ska-sa/roach1_hardware/roach/zdok-connections.txt

("P5"
	( 1    "$1I4\$1I170"
		(B1    "GND")
		(B10    "GND")
		(B11    "GND")
		(B12    "GND")
		(B13    "GND")
		(B14    "GND")
		(B15    "GND")
		(B16    "GND")
		(B17    "GND")
		(B18    "GND")
		(B19    "GND")
		(B2    "GND")
		(B20    "GND")
		(B3    "GND")
		(B4    "GND")
		(B5    "GND")
		(B6    "GND")
		(B7    "GND")
		(B8    "GND")
		(B9    "GND")
		(E1    "GND")
		(E10    "GND")
		(E11    "GND")
		(E12    "GND")
		(E13    "GND")
		(E14    "GND")
		(E15    "GND")
		(E16    "GND")
		(E17    "GND")
		(E18    "GND")
		(E19    "GND")
		(E2    "GND")
		(E20    "GND")
		(E3    "GND")
		(E4    "GND")
		(E5    "GND")
		(E6    "GND")
		(E7    "GND")
		(E8    "GND")
		(E9    "GND")
		(W1    "GND")
		(W2    "5V")
		(W3    "3V3")
		(W4    "2V5")
		(W5    "1V8")
		(W6    "GND")
		(X1    "GND")
		(X2    "5V")
		(X3    "3V3")
		(X4    "2V5")
		(X5    "1V8")
		(X6    "GND")
		(Y1    "GND")
		(Y2    "5V")
		(Y3    "3V3")
		(Y4    "2V5")
		(Y5    "1V8")
		(Y6    "GND")
		(Z1    "GND")
		(Z2    "5V")
		(Z3    "3V3")
		(Z4    "2V5")
		(Z5    "1V8")
		(Z6    "GND")
	)
	( 2    "$1I4\$1I801"
		(A1    "$1I4\ZDOK0_DP_P0")
		(A10    "$1I4\ZDOK0_DP_N4")
		(A11    "$1I4\ZDOK0_DP_P5")
		(A12    "$1I4\ZDOK0_DP_N5")
		(A13    "$1I4\ZDOK0_DP_P6")
		(A14    "$1I4\ZDOK0_DP_N6")
		(A15    "$1I4\ZDOK0_DP_P7")
		(A16    "$1I4\ZDOK0_DP_N7")
		(A17    "$1I4\ZDOK0_DP_P8")
		(A18    "$1I4\ZDOK0_DP_N8")
		(A19    "$1I4\ZDOK0_DP_P9")
		(A2    "$1I4\ZDOK0_DP_N0")
		(A20    "$1I4\ZDOK0_DP_N9")
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
		(F2    "$1I5\ZDOK1_DP_N29")
		(F20    "$1I5\ZDOK1_CLK1_N")
		(F3    "$1I5\ZDOK1_DP_P30")
		(F4    "$1I5\ZDOK1_DP_N30")
		(F5    "$1I5\ZDOK1_DP_P31")
		(F6    "$1I5\ZDOK1_DP_N31")
		(F7    "$1I5\ZDOK1_DP_P32")
		(F8    "$1I5\ZDOK1_DP_N32")
		(F9    "$1I5\ZDOK1_DP_P33")
	)
)
