ska-sa/roach1_hardware/roach/layout/ROACH103_ManFile.rtf

Roach Manufacturing File for roach103.pcb on 19/10/2009 15:47:30

Name P/D_NUM Position X Position Y Layer Name Orientation Geometry.Height Value
C1 TPSD227K010R0050 11.845 3.636 Top 270 3.1MM 220UF
C2 1210YD226KAT2A 11.840 3.204 Top 90 2.79MM 22UF
C3 C0402X7R160-104KN 1.967 4.861 Top 0 0.55MM 0.1UF
C4 C0402X7R160-104KN 12.074 9.835 Bottom 0 0.55MM 0.1UF
C5 GRM155R71A104KAO1B 9.682 1.538 Top 90 0.55MM 100NF
C6 GRM155R71E103KAO1B 9.547 1.691 Top 270 0.55MM 10NF
C7 GRM21BR60J106KE19L 5.447 4.184 Top 90 1.35MM 10UF
C8 GRM21BR60J106KE19L 6.333 7.254 Top 90 1.35MM 10UF
C9 GRM21BR60J106KE19L 4.975 4.184 Top 90 1.35MM 10UF
C10 ECJ-0EB0J224K 5.900 5.561 Bottom 0 0.55MM 220NF
C11 ECJ-0EB0J224K 5.821 5.798 Bottom 0 0.55MM 220NF
C12 ECJ-0EB0J224K 5.742 5.719 Bottom 0 0.55MM 220NF
C13 GRM155R71A104KAO1B 8.752 3.832 Bottom 90 0.55MM 100NF
C14 GRM155R71E103KAO1B 9.880 1.801 Top 270 0.55MM 10NF
C15 GRM155R71A104KAO1B 10.152 1.538 Top 90 0.55MM 100NF
C16 GRM155R71E103KAO1B 10.006 1.690 Top 270 0.55MM 10NF
C17 GRM155R71E103KAO1B 10.352 1.804 Top 270 0.55MM 10NF
C18 ECJ-0EB0J224K 9.550 1.817 Top 270 0.55MM 220NF
C19 ECJ-0EB0J224K 10.006 1.801 Top 270 0.55MM 220NF
C20 GRM155R71A104KAO1B 10.352 1.538 Top 270 0.55MM 100NF
C21 GRM1555C1H220JZ01B 12.022 5.876 Top 0 0.55MM 22PF
C22 GRM1555C1H220JZ01B 2.211 5.121 Top 0 0.55MM 22PF
C23 GRM21BR60J106KE19L 3.754 5.424 Top 0 1.35MM 10UF
C24 GRM21BR60J106KE19L 3.754 4.656 Top 0 1.35MM 10UF
C25 GRM21BR60J106KE19L 4.876 7.254 Top 90 1.35MM 10UF
C26 GRM21BR60J106KE19L 7.199 7.254 Top 90 1.35MM 10UF
C27 GRM21BR60J106KE19L 6.097 7.254 Top 90 1.35MM 10UF
C28 GRM21BR60J106KE19L 3.754 4.144 Top 0 1.35MM 10UF
C29 GRM21BR60J106KE19L 6.549 4.184 Top 90 1.35MM 10UF
C30 GRM21BR60J106KE19L 5.683 4.184 Top 270 1.35MM 10UF
C31 GRM21BR60J106KE19L 5.920 4.184 Top 270 1.35MM 10UF
C32 GRM155R71A104KAO1B 9.882 1.538 Top 270 0.55MM 100NF
C33 GRM155R60J103KA01J 1.601 9.050 Top 270 0.55MM 10NF
C34 ECJ-0EB0J224K 4.522 9.050 Top 0 0.55MM 220NF
C35 ECJ-0EB0J224K 3.754 9.323 Top 90 0.55MM 220NF
C36 ECJ-0EB0J224K 3.435 9.468 Top 0 0.55MM 220NF
C37 ECJ-0EB0J224K 4.185 9.204 Top 270 0.55MM 220NF
C38 ECJ-0EB0J224K 4.188 9.322 Top 90 0.55MM 220NF
C39 ECJ-0EB0J224K 1.971 9.485 Top 0 0.55MM 220NF
C40 ECJ-0EB0J224K 2.347 9.108 Top 270 0.55MM 220NF
C41 ECJ-0EB0J224K 2.758 9.206 Top 270 0.55MM 220NF
C42 ECJ-0EB0J224K 2.383 9.381 Top 0 0.55MM 220NF
C43 ECJ-0EB0J224K 2.742 9.302 Top 0 0.55MM 220NF
C44 ECJ-0EB0J224K 2.348 9.201 Top 270 0.55MM 220NF
C45 ECJ-0EB0J224K 3.764 9.179 Top 270 0.55MM 220NF
C46 GRM155R71E103KAO1B 6.727 5.266 Bottom 180 0.55MM 10NF
C47 08053C225KAT2A 9.993 2.308 Top 0 1.4MM 2.2UF
C48 04023A180KAT2A 9.898 3.402 Top 270 0.55MM 18PF
C49 04023A180KAT2A 10.264 3.406 Top 270 0.55MM 18PF
C50 GRM155R71E103KAO1B 6.864 5.640 Bottom 180 0.55MM 10NF
C51 04023A180KAT2A 10.327 2.941 Top 270 0.55MM 18PF
C52 04023A180KAT2A 10.677 2.955 Top 270 0.55MM 18PF
C53 C0402X7R160-104KN 8.810 7.040 Bottom 180 0.55MM 0.1UF
C54 C0402X7R160-104KN 9.220 7.005 Bottom 270 0.55MM 0.1UF
C55 GRM155R71E103KAO1B 7.356 4.833 Bottom 0 0.55MM 10NF
C56 GRM155R71E103KAO1B 7.908 4.833 Bottom 180 0.55MM 10NF
C57 GRM155R71A104KAO1B 8.282 4.518 Top 270 0.55MM 100NF
C58 GRM21BR61E475KA12K 8.479 4.558 Top 90 1.35MM 4U7F
C59 GRM32DR61C106KA01K 8.006 4.065 Top 270 2.2MM 10UF
C60 GRM32DR61C106KA01K 8.321 5.128 Top 0 2.2MM 10UF
C61 GRM155R60J103KA01J 1.341 9.369 Top 0 0.55MM 10NF
C62 GRM155R71A104KAO1B 8.400 8.416 Top 90 0.55MM 100NF
C63 GRM155R71E103KAO1B 10.372 5.048 Top 180 0.55MM 10NF
C64 ECJ-0EB0J224K 4.463 6.310 Top 0 0.55MM 220NF
C65 ECJ-0EB0J224K 4.463 6.664 Top 0 0.55MM 220NF
C66 GRM155R60J103KA01J 4.463 6.266 Top 0 0.55MM 10NF
C67 GRM155R60J103KA01J 4.463 6.703 Top 0 0.55MM 10NF
C68 GRM155R71A104KAO1B 3.555 7.803 Top 0 0.55MM 100NF
C69 GRM155R71A104KAO1B 3.142 7.819 Top 0 0.55MM 100NF
C70 GRM155R60J104KA01J 4.738 6.624 Top 0 0.55MM 100NF
C71 GRM155R60J104KA01J 4.738 6.585 Top 0 0.55MM 100NF
C74 GRM155R60J104KA01J 4.738 6.467 Top 0 0.55MM 100NF
C75 GRM155R60J104KA01J 4.738 6.428 Top 0 0.55MM 100NF
C76 GRM155R60J103KA01J 4.463 7.254 Top 0 0.55MM 10NF
C77 GRM155R60J103KA01J 4.463 6.821 Top 0 0.55MM 10NF
C78 ECJ-0EB0J224K 4.463 7.215 Top 0 0.55MM 220NF
C79 ECJ-0EB0J224K 4.463 6.861 Top 0 0.55MM 220NF
C82 GRM155R60J104KA01J 4.738 7.018 Top 0 0.55MM 100NF
C83 GRM155R60J104KA01J 4.738 7.058 Top 0 0.55MM 100NF
C84 GRM32DR61C106KA01K 8.321 4.991 Top 0 2.2MM 10UF
C85 ECJ-0EB0J224K 6.864 5.010 Bottom 180 0.55MM 220NF
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
RP36 4D02WGJ0510T 7.612 6.250 Bottom 270 0.55MM 51R
RP37 4D02WGJ0510T 7.735 6.250 Bottom 270 0.55MM 51R
RP38 4D02WGJ0510T 7.376 6.250 Bottom 270 0.55MM 51R
RS1 4D02WGJ0330T 10.231 3.691 Top 90 0.4MM 33
RS2 4D02WGJ0330T 10.168 3.798 Top 90 0.4MM 33
RS3 4D02WGJ0330T 10.120 3.794 Top 90 0.4MM 33
RS7 4D02WGJ0330T 10.569 3.384 Top 90 0.4MM 33
RS9 4D02WGJ0330T 10.628 3.380 Top 90 0.4MM 33
RS10 4D02WGJ0330T 10.248 3.099 Top 90 0.4MM 33
SNP1 N/A 6.059 1.729 Top 0 0.00000"
SP2 PGB102ST23WR 10.098 9.874 Top 270 0.76MM PGB102ST
SW1 7914G 9.926 1.985 Top 90 4.19MM SPST
SW2 A6S-4101-H 9.203 2.735 Top 180 3.1MM 4POLE
SW3 A6S-4101-H 8.746 2.735 Top 180 3.1MM 4POLE
TP1 N/A 8.620 5.837 Top 0 0.00000" TEST POI
TP2 N/A 10.514 3.400 Top 0 0.00000"
TP3 N/A 8.522 4.191 Top 0 0.00000"
TP4 N/A 11.047 5.015 Top 0 0.00000"
TP5 N/A 11.064 4.350 Top 0 0.00000"
TP6 N/A 10.687 3.376 Top 0 0.00000"
TP7 N/A 10.238 3.817 Top 0 0.00000"
TP8 N/A 10.294 3.711 Top 0 0.00000"
TP9 N/A 8.805 4.353 Top 0 0.00000"
U1 PPC440EPX-NTA533T 9.561 5.739 Top 90 2.65MM 440EPX
U2 SN74AHC1G125DCKT 8.349 3.965 Top 270 1.1MM
U3 TL7700CPSR 1.353 9.168 Top 180 0.00200"
U4 ADCMP605BCPZ 9.702 1.708 Top 0 1.0MM
U5 ADCMP605BCPZ 10.172 1.708 Top 0 1.0MM
U6 CDCU877ARHAT 10.577 5.090 Top 0
U7 SN74LVC1G07DBVT 2.654 7.165 Top 90
U8 SY89832UMI 4.463 6.467 Top 180 0.9MM
U9 CY22381FXI_0211P2 10.093 3.593 Top 90 1.73MM CY22381F
U10 74AVCH4T245DGVRE4 2.214 9.274 Top 270 1.2MM
U11 74AVCH4T245DGVRE4 2.614 9.274 Top 270 1.2MM
U12 74AVCH4T245DGVRE4 4.390 9.056 Top 90 1.2MM
U13 74AVCH4T245DGVRE4 3.634 9.274 Top 270 1.2MM
U14 74AVCH4T245DGVRE4 4.054 9.274 Top 270 1.2MM
U15 XC5VSX95T 5.959 5.680 Top 270 3.4MM
U16 TPS51100DGQ 8.321 4.754 Top 270 1.1MM TPS51100
U17 K7S3218T4C-FC40 7.652 4.872 Top 0 1.4MM
U18 TPS2031D 5.391 9.584 Top 0 1.75MM
U19 TPS2031D 5.391 9.349 Top 0 1.75MM
U20 MAX9032AKA 4.851 9.349 Top 270 1.4MM
U21 MAX9032AKA 4.861 9.594 Top 270 1.4MM
U22 SN74AHC1G08DCKR 5.102 9.643 Top 0 1.45MM
U23 SN74AHC1G08DCKR 5.102 9.398 Top 0 1.45MM
U24 CY2292F 10.500 3.186 Top 90 1.73MM CY2292FZ
U25 ADR03ARZ 4.140 5.384 Top 0 1.75MM
U26 SY89832UMI 4.463 7.018 Top 180 0.9MM
U27 PTH08T220WAD 0.451 4.719 Top 90 8.5MM
U28 TPS2031D 5.391 9.834 Top 0 1.75MM
U29 TPS2031D 5.391 10.082 Top 0 1.75MM
U30 MAX9032AKA 4.866 10.084 Top 270 1.4MM
U31 MIC2774N-29YMS 9.841 2.337 Top 270 1.45MM MIC2774N
U32 TPS51100DGQ 11.899 5.951 Top 90 1.1MM TPS51100
U33 TPS51100DGQ 1.986 5.039 Top 180 1.1MM TPS51100
U34 MAX9032AKA 4.866 9.839 Top 270 1.4MM
U35 SN74LVC1G08DCKR 9.699 2.443 Top 270 1.1MM 74LVC1G0
U36 SN74AHC1G08DCKR 5.102 9.888 Top 0 1.45MM
U37 SN74AHC1G08DCKR 5.102 10.134 Top 0 1.45MM
U38 AT24HC04BN-SH 3.023 8.562 Top 0 1.75MM AT24HC04
U39 SN74LVC1G07DBVT 2.181 7.165 Top 90
U40 AT24HC04BN-SH 4.042 8.563 Top 0 1.75MM AT24HC04
U41 AD7414ARTZ-0 2.652 8.562 Top 0 1.45MM AD7414-0
U42 S29GL512P11FFI010 7.770 5.719 Top 0 1.4MM 32MX16 M
U43 ICL3225EIAZ 11.790 9.420 Top 270 2MM ICL3225E
U44 ICL3225EIAZ 11.431 9.420 Top 270 2MM ICL3225E
U45 PI5A3157ZAEX 11.785 9.097 Top 270 1.1MM PI5A3157
U46 PI5A3157ZAEX 11.654 9.097 Top 270 1.1MM PI5A3157
U47 SN74LVC1G07DBVT 1.709 7.165 Top 90
U48 PI5A3157ZAEX 11.519 9.097 Top 270 1.1MM PI5A3157
U49 SN74LVC1G07DBVT 1.709 7.047 Top 90
U50 PTH05T210WAD 0.431 1.999 Top 0 8.5MM PTH05T21
U51 PTH08T240WAD 1.111 2.779 Top 90 8.5MM PTH08T24
U52 SN74LVC1G07DBVT 2.181 7.047 Top 89
U53 PTH08T230WAD 0.431 2.779 Top 90 8.5MM
U54 XC2C256_7VQ144C 9.042 3.816 Top 270 1.6MM
U55 TPS74401RGWT 4.876 8.750 Top 180 1.0MM TPS74401
U56 TPS74401RGWT 5.900 8.750 Top 180 1.0MM TPS74401
U57 TPS74401RGWT 5.388 8.750 Top 180 1.0MM TPS74401
U58 DP83865DVH 9.549 8.825 Top 0 1.0MM
U59 TPS74401RGWT 0.631 6.119 Top 270 1.0MM TPS74401
U60 AFS600-FG256 1.845 8.042 Top 270 1.7MM
U61 ADM3101EACPZ-REEL 1.403 9.781 Top 90 1.0MM
U62 TPS51100DGQ 8.416 7.483 Top 90 1.1MM TPS51100
U63 K7S3218T4C-FC40 7.652 6.664 Top 0 1.4MM
U64 SN74LVC1G07DBVT 2.654 7.047 Top 90
U65 74AVCH4T245DGVRE4 3.150 7.697 Top 0 1.2MM
U66 74AVCH4T245DGVRE4 3.571 7.697 Top 0 1.2MM
U67 SN74LVC1G07DBVT 2.890 7.728 Top 90
U68 SN74LVC1G07DBVT 2.890 7.638 Top 90
V1 N/A 6.372 6.715 Top 180 0.00000"
V2 N/A 5.156 6.644 Top 0 0.00000"
V3 N/A 6.750 9.731 Top 0 0.00000"
V4 N/A 5.427 6.715 Top 180 0.00000"
V5 N/A 6.807 9.635 Top 180 0.00000"
V6 N/A 6.585 9.731 Top 0 0.00000"
V7 N/A 4.920 6.644 Top 0 0.00000"
V8 N/A 6.636 9.632 Top 180 0.00000"
V9 N/A 5.018 6.715 Top 180 0.00000"
V18 N/A 7.168 9.632 Top 180 0.00000"
V19 N/A 5.664 6.715 Top 180 0.00000"
V20 N/A 7.114 9.729 Top 0 0.00000"
V21 N/A 5.565 6.644 Top 0 0.00000"
V22 N/A 7.334 9.631 Top 180 0.00000"
V23 N/A 5.900 6.715 Top 180 0.00000"
V24 N/A 7.282 9.727 Top 0 0.00000"
V25 N/A 5.801 6.644 Top 0 0.00000"
V34 N/A 7.925 9.631 Top 180 0.00000"
V35 N/A 6.274 6.644 Top 0 0.00000"
V36 N/A 7.872 9.727 Top 0 0.00000"
V37 N/A 6.038 6.644 Top 0 0.00000"
V38 N/A 7.704 9.729 Top 0 0.00000"
V39 N/A 6.136 6.715 Top 180 0.00000"
V40 N/A 7.758 9.632 Top 180 0.00000"
V49 N/A 6.711 6.719 Top 180 0.00000"
V50 N/A 8.290 9.632 Top 180 0.00000"
V51 N/A 8.240 9.729 Top 0 0.00000"
V52 N/A 6.510 6.644 Top 0 0.00000"
V53 N/A 8.456 9.631 Top 180 0.00000"
V54 N/A 6.998 6.723 Top 180 0.00000"
V55 N/A 8.404 9.727 Top 0 0.00000"
V56 N/A 6.884 6.648 Top 0 0.00000"
VR4 V5.5MLA0603XXX 9.898 9.945 Top 270 0.9MM 5.5V 20A
X1 CCLD-023-25-156.250 4.148 6.506 Top 0 1.8MM 156.25MH
X2 CCLD-023-25-100.000 4.148 6.132 Top 0 1.8MM 100.00MH
X3 CCLD-024-25-200.000 4.148 5.719 Top 0 1.8MM 200.00MH
X4 CCLD-023-25-156.250 4.148 7.058 Top 0 1.8MM 156.25MH
X5 ECX-306 1.853 8.988 Top 180 2.5MM 32.768KH
Y1 CS10-22.1184MAGJ-UT 10.081 3.345 Top 0 1.0MM 22.1184M
Y2 CS10-12.000MAGJ-UT 10.502 2.916 Top 0 1.0MM 12.00 MH
