ska-sa/roach1_hardware/roach/layout/ROACH102_ManFile.rtf

Roach Manufacturing File for roach102.pcb on 26/11/2008 15:26:01

Name P/D_NUM Position X Position Y Layer Name Orientation Geometry.Height Value
C1 TPSD227K010R0050 275.456 -161.639 Top 270 3.1MM 220UF
C2 1210YD226KAT2A 275.349 -172.614 Top 90 2.79MM 22UF
C3 C0402X7R160-104KN 24.556 -130.522 Top 0 0.55MM 0.1UF
C4 C0402X7R160-104KN 281.290 -4.180 Bottom 0 0.55MM 0.1UF
C5 GRM155R71A104KAO1B 220.514 -214.929 Top 90 0.55MM 100NF
C6 GRM155R71E103KAO1B 217.085 -211.042 Top 270 0.55MM 10NF
C7 GRM21BR60J106KE19L 112.956 -147.739 Top 90 1.35MM 10UF
C8 GRM21BR60J106KE19L 135.456 -69.739 Top 90 1.35MM 10UF
C9 GRM21BR60J106KE19L 100.956 -147.739 Top 90 1.35MM 10UF
C10 ECJ-0EB0J224K 124.456 -112.739 Bottom 0 0.55MM 220NF
C11 ECJ-0EB0J224K 122.456 -106.739 Bottom 0 0.55MM 220NF
C12 ECJ-0EB0J224K 120.456 -108.739 Bottom 0 0.55MM 220NF
C13 GRM155R71A104KAO1B 196.896 -156.668 Bottom 90 0.55MM 100NF
C14 GRM155R71E103KAO1B 225.544 -208.248 Top 270 0.55MM 10NF
C15 GRM155R71A104KAO1B 232.452 -214.929 Top 90 0.55MM 100NF
C16 GRM155R71E103KAO1B 228.744 -211.068 Top 270 0.55MM 10NF
C17 GRM155R71E103KAO1B 237.532 -208.172 Top 270 0.55MM 10NF
C18 ECJ-0EB0J224K 217.162 -207.842 Top 270 0.55MM 220NF
C19 ECJ-0EB0J224K 228.744 -208.248 Top 270 0.55MM 220NF
C20 GRM155R71A104KAO1B 237.532 -214.929 Top 270 0.55MM 100NF
C21 GRM1555C1H220JZ01B 279.956 -104.739 Top 0 0.55MM 22PF
C22 GRM1555C1H220JZ01B 30.756 -123.922 Top 0 0.55MM 22PF
C23 GRM21BR60J106KE19L 69.956 -116.239 Top 0 1.35MM 10UF
C24 GRM21BR60J106KE19L 69.956 -135.739 Top 0 1.35MM 10UF
C25 GRM21BR60J106KE19L 98.456 -69.739 Top 90 1.35MM 10UF
C26 GRM21BR60J106KE19L 157.456 -69.739 Top 90 1.35MM 10UF
C27 GRM21BR60J106KE19L 129.456 -69.739 Top 90 1.35MM 10UF
C28 GRM21BR60J106KE19L 69.956 -148.739 Top 0 1.35MM 10UF
C29 GRM21BR60J106KE19L 140.956 -147.739 Top 90 1.35MM 10UF
C30 GRM21BR60J106KE19L 118.956 -147.739 Top 270 1.35MM 10UF
C31 GRM21BR60J106KE19L 124.956 -147.739 Top 270 1.35MM 10UF
C32 GRM155R71A104KAO1B 225.594 -214.929 Top 270 0.55MM 100NF
C33 GRM155R60J103KA01J 15.256 -24.139 Top 270 0.55MM 10NF
C34 ECJ-0EB0J224K 89.470 -24.133 Top 0 0.55MM 220NF
C35 ECJ-0EB0J224K 69.952 -17.198 Top 90 0.55MM 220NF
C36 ECJ-0EB0J224K 61.850 -13.515 Top 0 0.55MM 220NF
C37 ECJ-0EB0J224K 80.900 -20.221 Top 270 0.55MM 220NF
C38 ECJ-0EB0J224K 80.976 -17.224 Top 90 0.55MM 220NF
C39 ECJ-0EB0J224K 24.664 -13.084 Top 0 0.55MM 220NF
C40 ECJ-0EB0J224K 34.214 -22.659 Top 270 0.55MM 220NF
C41 ECJ-0EB0J224K 44.654 -20.170 Top 270 0.55MM 220NF
C42 ECJ-0EB0J224K 35.129 -15.725 Top 0 0.55MM 220NF
C43 ECJ-0EB0J224K 44.247 -17.732 Top 0 0.55MM 220NF
C44 ECJ-0EB0J224K 34.240 -20.297 Top 270 0.55MM 220NF
C45 ECJ-0EB0J224K 70.206 -20.856 Top 270 0.55MM 220NF
C46 GRM155R71E103KAO1B 145.456 -120.239 Bottom 180 0.55MM 10NF
C47 08053C225KAT2A 228.430 -195.365 Top 0 1.4MM 2.2UF
C48 04023A180KAT2A 226.000 -167.600 Top 270 0.55MM 18PF
C49 04023A180KAT2A 235.300 -167.500 Top 270 0.55MM 18PF
C50 GRM155R71E103KAO1B 148.956 -110.739 Bottom 180 0.55MM 10NF
C51 04023A180KAT2A 236.900 -179.300 Top 270 0.55MM 18PF
C52 04023A180KAT2A 245.456 -178.939 Top 270 0.55MM 18PF
C53 C0402X7R160-104KN 198.416 -76.499 Bottom 180 0.55MM 0.1UF
C54 C0402X7R160-104KN 208.780 -76.067 Bottom 270 0.55MM 0.1UF
C55 GRM155R71E103KAO1B 161.444 -131.239 Bottom 0 0.55MM 10NF
C56 GRM155R71E103KAO1B 175.456 -131.239 Bottom 180 0.55MM 10NF
C57 GRM155R71A104KAO1B 184.956 -139.239 Top 270 0.55MM 100NF
C58 GRM21BR61E475KA12K 189.956 -138.239 Top 90 1.35MM 4U7F
C59 GRM32DR61C106KA01K 177.956 -150.739 Top 270 2.2MM 10UF
C60 GRM32DR61C106KA01K 185.956 -123.739 Top 0 2.2MM 10UF
C61 GRM155R60J103KA01J 8.656 -16.039 Top 0 0.55MM 10NF
C62 GRM155R71A104KAO1B 187.956 -40.239 Top 90 0.55MM 100NF
C63 GRM155R71E103KAO1B 238.041 -125.784 Top 180 0.55MM 10NF
C64 ECJ-0EB0J224K 87.956 -93.739 Top 0 0.55MM 220NF
C65 ECJ-0EB0J224K 87.956 -84.739 Top 0 0.55MM 220NF
C66 GRM155R60J103KA01J 87.956 -94.839 Top 0 0.55MM 10NF
C67 GRM155R60J103KA01J 87.956 -83.739 Top 0 0.55MM 10NF
C68 GRM155R71A104KAO1B 64.900 -55.800 Top 0 0.55MM 100NF
C69 GRM155R71A104KAO1B 54.400 -55.400 Top 0 0.55MM 100NF
C70 GRM155R60J104KA01J 94.956 -85.739 Top 0 0.55MM 100NF
C71 GRM155R60J104KA01J 94.956 -86.739 Top 0 0.55MM 100NF
C74 GRM155R60J104KA01J 94.956 -89.739 Top 0 0.55MM 100NF
C75 GRM155R60J104KA01J 94.956 -90.739 Top 0 0.55MM 100NF
C76 GRM155R60J103KA01J 87.956 -69.739 Top 0 0.55MM 10NF
C77 GRM155R60J103KA01J 87.956 -80.739 Top 0 0.55MM 10NF
C78 ECJ-0EB0J224K 87.956 -70.739 Top 0 0.55MM 220NF
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
C514 GRM155R71A104KAO1B 222.213 -37.086 Bottom 270 0.55MM 100NF
C515 GRM155R71E103KAO1B 222.213 -32.086 Bottom 270 0.55MM 10NF
C516 GRM155R71A104KAO1B 222.213 -29.586 Bottom 270 0.55MM 100NF
C517 GRM155R71E103KAO1B 222.213 -27.086 Bottom 270 0.55MM 10NF
C518 GRM155R71A104KAO1B 222.213 -22.086 Bottom 270 0.55MM 100NF
C519 GRM155R71E103KAO1B 212.213 -22.086 Bottom 270 0.55MM 10NF
C520 GRM155R71A104KAO1B 212.213 -27.086 Bottom 270 0.55MM 100NF
C521 GRM155R71E103KAO1B 212.213 -29.586 Bottom 270 0.55MM 10NF
C522 GRM155R71A104KAO1B 212.213 -32.086 Bottom 270 0.55MM 100NF
C523 GRM155R71E103KAO1B 212.213 -37.086 Bottom 90 0.55MM 10NF
C524 GRM155R71A104KAO1B 217.213 -38.086 Bottom 180 0.55MM 100NF
C525 GRM155R71E103KAO1B 214.192 -22.741 Bottom 0 0.55MM 10NF
C526 GRM155R71E103KAO1B 220.467 -22.766 Bottom 0 0.55MM 10NF
C527 GRM155R71A104KAO1B 212.213 -24.586 Bottom 90 0.55MM 100NF
C528 GRM155R71A104KAO1B 212.213 -34.586 Bottom 90 0.55MM 100NF
C529 GRM155R71A104KAO1B 222.213 -24.586 Bottom 90 0.55MM 100NF
C530 GRM155R71E103KAO1B 222.213 -34.586 Bottom 90 0.55MM 10NF
C531 GRM155R71E103KAO1B 220.213 -38.086 Bottom 0 0.55MM 10NF
C532 GRM155R71A104KAO1B 214.213 -38.086 Bottom 0 0.55MM 100NF
C533 GRM155R71E103KAO1B 220.227 -24.532 Bottom 90 0.55MM 10NF
C534 GRM155R71E103KAO1B 214.131 -24.532 Bottom 90 0.55MM 10NF
C535 GRM32ER61C226KE20 235.407 -18.258 Top 0 2.7MM 22UF
C536 GRM32ER61C226KE20 235.407 -21.814 Top 0 2.7MM 22UF
C537 GRM32ER61C226KE20 228.371 -13.280 Top 0 2.7MM 22UF
C538 T530X337M010ATE006 -10.082 -89.801 Top 180 3.1MM 330UF
C539 04023C101KAT2A 10.456 -55.239 Bottom 0 0.55MM 100PF
C540 GRM155R71A104KAO1B 5.940 -6.532 Top 90 0.55MM 100NF
C541 GRM155R71A104KAO1B 6.000 -3.732 Top 90 0.55MM 100NF
C542 GRM155R71A104KAO1B 14.456 -6.412 Top 270 0.55MM 100NF
C543 GRM155R71A104KAO1B 14.516 -3.912 Top 90 0.55MM 100NF
C544 GRM155R71A104KAO1B 13.976 -1.828 Top 0 0.55MM 100NF
C545 T530X337M010ATE006 1.473 -91.544 Top 180 3.1MM 330UF
C546 GRM155R71A104KAO1B 128.356 -27.039 Top 0 0.55MM 100NF
C547 GRM21BR71E225KA73B 8.616 -32.568 Top 180 1.4MM 2U2
C548 GRM21BR71E225KA73B 5.456 -44.239 Top 180 1.4MM 2U2
C549 GRM32DR61C106KA01K 5.456 -60.639 Top 180 2.2MM 10UF
C550 C0805C153J5RAC -5.899 -103.738 Top 270 1.4MM 15NF
C551 GRM32DR61C106KA01K -12.236 -84.904 Top 180 2.2MM 10UF
C552 GRM32DR61C106KA01K -11.252 -104.016 Top 0 2.2MM 10UF
C553 GRM188R61E105KA12J -9.052 -93.340 Top 180 0.9MM 1UF
C554 GRM1555C1H220JZ01B 17.956 -27.939 Top 90 0.55MM 22PF
C555 GRM1555C1H220JZ01B 25.456 -28.039 Top 90 0.55MM 22PF
C556 GRM155R60J103KA01J 4.956 -41.739 Top 0 0.55MM 10NF
C557 GRM155R60J103KA01J 22.456 -60.739 Bottom 270 0.55MM 10NF
C558 GRM155R60J103KA01J 38.456 -45.739 Top 180 0.55MM 10NF
C559 GRM155R60J103KA01J 38.456 -56.739 Top 180 0.55MM 10NF
C560 GRM155R60J103KA01J 16.456 -60.739 Bottom 270 0.55MM 10NF
C561 GRM155R60J103KA01J 28.456 -60.739 Bottom 270 0.55MM 10NF
C562 GRM155R60J103KA01J 15.456 -32.739 Top 270 0.55MM 10NF
C563 GRM155R60J103KA01J 24.456 -32.739 Top 270 0.55MM 10NF
C564 GRM155R60J103KA01J 29.956 -32.739 Top 270 0.55MM 10NF
C565 GRM32DR61C106KA01K -0.668 -83.140 Top 180 2.2MM 10UF
C566 GRM32DR61C106KA01K -0.668 -86.696 Top 180 2.2MM 10UF
C567 GRM32DR61C106KA01K -0.668 -79.584 Top 180 2.2MM 10UF
C568 GRM155R60J103KA01J 38.456 -42.739 Top 0 0.55MM 10NF
C569 GRM32DR61C106KA01K 244.000 -25.000 Top 180 2.2MM 10UF
C570 GRM155R60J103KA01J 4.956 -38.739 Top 0 0.55MM 10NF
C571 GRM155R60J103KA01J 4.956 -48.739 Top 0 0.55MM 10NF
C572 GRM155R60J103KA01J 4.956 -51.739 Top 0 0.55MM 10NF
C573 GRM155R60J103KA01J 4.956 -54.739 Top 0 0.55MM 10NF
C574 GRM155R60J103KA01J 4.844 -57.739 Top 0 0.55MM 10NF
C575 GRM155R60J103KA01J 12.956 -32.739 Top 90 0.55MM 10NF
C576 GRM155R60J103KA01J 18.456 -32.739 Top 90 0.55MM 10NF
C577 GRM155R60J103KA01J 21.456 -32.739 Top 90 0.55MM 10NF
C578 GRM32DR61C106KA01K -12.236 -74.236 Top 180 2.2MM 10UF
C579 GRM32DR61C106KA01K -12.236 -77.817 Top 180 2.2MM 10UF
C580 GRM32DR61C106KA01K -12.236 -81.348 Top 180 2.2MM 10UF
C581 GRM155R60J103KA01J 27.456 -32.739 Top 90 0.55MM 10NF
C582 GRM155R60J103KA01J 38.456 -48.739 Top 0 0.55MM 10NF
C583 GRM155R60J103KA01J 38.456 -51.239 Top 0 0.55MM 10NF
C584 GRM155R60J103KA01J 38.456 -53.739 Top 0 0.55MM 10NF
C585 GRM155R60J103KA01J 38.456 -59.739 Top 0 0.55MM 10NF
C586 GRM155R60J103KA01J 13.456 -60.739 Bottom 90 0.55MM 10NF
C587 GRM155R60J103KA01J 19.456 -60.739 Bottom 90 0.55MM 10NF
C588 GRM155R60J103KA01J 25.456 -60.739 Bottom 90 0.55MM 10NF
C589 GRM155R60J103KA01J 31.456 -60.739 Bottom 90 0.55MM 10NF
C590 GRM155R71E103KAO1B 175.456 -85.739 Bottom 180 0.55MM 10NF
C591 GRM155R71E103KAO1B 144.456 -103.239 Bottom 180 0.55MM 10NF
C592 GRM155R71E103KAO1B 144.456 -102.239 Bottom 180 0.55MM 10NF
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
LOGO2 N/A 60.156 -189.239 Top 0 0.00000mm
LOGO3 N/A 59.854 -175.650 Top 0 0.00000mm
LOGO4 N/A 133.814 -174.758 Top 0 0.00000mm
P1 TSM-108-01-TM-DV-P 202.226 -80.509 Top 270 8.38MM .1IN M S
P2 182-009-112-171 285.190 0.620 Top 0 0.31750mm 9P DSUB
P3 FCN-268F036-G/3DB 136.754 2.134 Top 180 37.9MM
P4 TSM-105-01-TM-SV 264.156 -30.239 Top 90 8.38MM 0.1IN M
P5 6367550-5 143.891 -230.581 Top 0 9.5MM ZDOK40
P6 89485-8001 231.318 6.910 Top 180 14.45MM NONE
P7 6367550-5 54.356 -230.581 Top 0 9.5MM ZDOK40
P8 TSM-108-01-TM-DV-P 195.456 -47.239 Top 0 8.38MM .1IN M S
P9 QSH-040-01-L-D-DP-A-K 126.873 -199.568 Top 0 3.05MM
P11 TSM-105-01-TM-SV 64.516 -29.868 Top 180 8.38MM 0.1IN M
PTC1 1206L050 227.200 -5.400 Top 90 0.75MM 500MA
PTC2 MF-NSMF050-2 15.367 -76.200 Bottom 0 500MA/13
PTC3 MF-NSMF050-2 27.051 -76.200 Bottom 0 500MA/13
PTC4 MF-NSMF050-2 39.116 -76.835 Bottom 0 500MA/13
PTC5 MF-NSMF050-2 254.889 -31.496 Top 0 500MA/13
PTC6 MF-NSMF050-2 65.659 -37.846 Top 90 500MA/13
PTC7 MF-NSMF050-2 203.581 -42.799 Bottom 180 500MA/13
PTC8 MF-NSMF050-2 269.875 6.096 Bottom 90 500MA/13
PTC9 MF-NSMF050-2 286.385 -11.049 Bottom 270 500MA/13
Q4 BSS138 14.504 -199.164 Top 90 1.11MM BSS138
Q5 BSS138 14.504 -191.036 Top 90 1.11MM BSS138
Q6 BSS138 -13.944 -110.772 Top 270 1.11MM BSS138
Q7 BSS138 14.504 -195.100 Top 90 1.11MM BSS138
Q8 BSS138 276.790 -211.880 Top 0 1.11MM BSS138
Q9 NDS331N 277.190 -216.680 Top 0 1.11MM NDS331N
Q10 NDS331N 278.890 -196.180 Top 0 1.11MM NDS331N
Q11 FJD3076TM -1.684 -73.180 Top 0 2.4MM
Q12 FDS6675BZ 284.690 -141.980 Top 270 1.75MM
Q13 FDS6675BZ 284.890 -118.080 Top 270 1.75MM
Q14 FDS6675BZ 25.840 -187.322 Top 90 1.75MM
R1 0402WGF0103T1E 63.577 -16.970 Top 180 0.4MM 10K
R2 0402WGF0103T1E 27.255 -17.097 Top 0 0.4MM 10K
R3 0402WGF0102T1E 218.756 -85.139 Top 0 0.4MM 1K
R4 0402WG00T1E 191.456 -120.239 Top 180 0.4MM 0R
R5 0402WGF0332T1E 181.956 -102.739 Top 270 0.4MM 3K3
R6 0402WGJ0120T1E 279.956 -106.239 Top 180 0.4MM 120R
R7 0402WGF0103T1E 27.229 -19.764 Top 180 0.4MM 10K
R8 0402WGF0103T1E 37.262 -19.738 Top 180 0.4MM 10K
R9 0402WGF0103T1E 82.612 -22.025 Top 180 0.4MM 10K
R10 0402WGF0220T1E 127.856 -147.339 Top 270 0.4MM 22R
R11 0402WGF0220T1E 165.356 -150.439 Top 270 0.4MM 22R
R12 0402WGF0220T1E 163.956 -150.439 Top 270 0.4MM 22R
R13 0402WGF0220T1E 129.956 -147.239 Top 270 0.4MM 22R
R14 0402WGF0220T1E 20.611 -204.853 Top 180 0.4MM 22R
R15 0402WGF0220T1E 20.573 -207.164 Top 180 0.4MM 22R
R16 0402WGF0220T1E 18.856 -155.039 Top 0 0.4MM 22R
R17 0402WGF0220T1E 13.156 -160.639 Top 180 0.4MM 22R
R18 0402WGF0220T1E 6.756 -103.139 Top 90 0.4MM 22R
R19 0402WGF0220T1E 2.290 -100.280 Top 90 0.4MM 22R
R20 0402WGF0220T1E -15.096 -165.101 Top 0 0.4MM 22R
R21 0402WGF0220T1E -5.800 -158.300 Top 0 0.4MM 22R
R22 0402WGF499JT1E 155.956 -103.239 Top 0 0.4MM 49.9R
R23 0402WGF0332T1E 214.056 -85.239 Top 180 0.4MM 3K3
R24 0402WGF0102T1E 191.456 -118.239 Top 0 0.4MM 1K
R25 0402WGF0102T1E 191.456 -105.739 Top 180 0.4MM 1K
R26 4D02WGJ0330T 198.416 -73.959 Bottom 180 0.4MM 33
R27 0402WGF0332T1E 206.036 -66.339 Bottom 180 0.4MM 3K3
R28 0402WGF0332T1E 225.890 -197.651 Top 180 0.4MM 3K3
R29 0402WGF0332T1E 193.256 -102.839 Top 270 0.4MM 3K3
R30 0402WGF0332T1E 227.456 -160.139 Top 270 0.4MM 3K3
R31 0402WGF0332T1E 197.556 -83.339 Top 270 0.4MM 3K3
R32 0402WGF0332T1E 187.600 -83.300 Top 270 0.4MM 3K3
R33 0402WGF0332T1E 189.156 -93.539 Top 270 0.4MM 3K3
R34 0402WGF0332T1E 237.290 -168.480 Top 180 0.4MM 3K3
R35 0402WGF0332T1E 186.000 -83.200 Top 270 0.4MM 3K3
R36 0402WGF0103T1E 210.354 -69.641 Top 90 0.4MM 10K
R37 0402WGF0103T1E 206.036 -76.499 Bottom 180 0.4MM 10K
R38 0402WGF0103T1E 208.356 -73.139 Top 90 0.4MM 10K
R39 0402WGF0103T1E 208.356 -69.639 Top 270 0.4MM 10K
R40 0402WGF499JT1E 155.956 -101.239 Top 0 0.4MM 49.9R
R41 0402WGF0153T1E 225.890 -199.175 Top 0 0.4MM 15K
R42 0402WGF0181T1E 229.192 -199.175 Top 180 0.4MM 180R
R43 0402WGJ0101T1E 85.355 -13.313 Top 90 0.4MM 100R
R44 0402WGJ0101T1E 83.069 -13.313 Top 90 0.4MM 100R
R45 0402WGJ0101T1E 87.641 -13.313 Top 90 0.4MM 100R
R46 0402WGJ0101T1E 89.927 -13.313 Top 90 0.4MM 100R
R47 0402WGF0103T1E 63.551 -20.094 Top 180 0.4MM 10K
R48 0402WGF0103T1E 74.016 -19.942 Top 180 0.4MM 10K
R49 0402WGF499JT1E 44.578 -13.846 Top 0 0.4MM 49R9
R50 0402WGF499JT1E 44.527 -11.991 Bottom 180 0.4MM 49R9
R51 0402WGF499JT1E 148.956 -114.739 Bottom 180 0.4MM 49.9R
R52 0402WGF499JT1E 148.956 -112.739 Bottom 180 0.4MM 49.9R
R53 0402WGF0103T1E 186.456 -139.239 Top 90 0.4MM 10K
R54 0402WGF0103T1E 187.956 -139.239 Top 270 0.4MM 10K
R55 0402WGF249JTIE 175.456 -130.239 Bottom 0 0.4MM 249R
R56 0402WGF499JT1E 125.456 -91.239 Bottom 90 0.4MM 49.9R
R57 0402WGF0392T1E 95.403 -10.696 Top 180 0.4MM 3K9
R58 0402WGF0392T1E 95.403 -12.220 Top 180 0.4MM 3K9
R59 0402WGF0682T1E 95.403 -9.299 Top 0 0.4MM 6K8
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
R256 0402WGF499JT1E 214.440 -2.500 Bottom 90 0.4MM 49.9R
R257 0402WGF499JT1E 218.250 -5.091 Bottom 90 0.4MM 49.9R
R258 0402WGF499JT1E 216.980 -2.500 Bottom 90 0.4MM 49.9R
R259 0402WGF499JT1E 215.710 -5.091 Bottom 90 0.4MM 49.9R
R260 0402WGF499JT1E 213.169 -5.088 Bottom 90 0.4MM 49.9R
R261 0402WGF499JT1E 211.900 -2.500 Bottom 90 0.4MM 49.9R
R262 0402WGF0100T1E 230.327 -19.782 Top 0 0.4MM 10
R263 0402WGF0180T1E 230.319 -22.574 Top 0 0.4MM 18
R264 0402WGF0222T1E 230.319 -27.959 Top 180 0.4MM NO POP
R265 0402WGF0222T1E 230.319 -26.588 Top 180 0.4MM NO POP
R266 0402WGF0222T1E 230.319 -24.581 Top 180 0.4MM NO POP
R267 0402WGF0102T1E 244.956 -98.739 Top 180 0.4MM 1K
R268 0402WGF0222T1E 202.904 -34.252 Top 0 0.4MM 2K2
R269 0402WGF0222T1E 202.853 -36.080 Top 0 0.4MM 2K2
R270 0402WGF0222T1E 202.853 -37.858 Top 0 0.4MM 2K2
R271 0402WGF0222T1E 202.853 -39.382 Top 0 0.4MM 2K2
R272 0402WGF0220T1E 218.856 -45.139 Top 90 0.4MM 22R
R273 0402WGF0220T1E 217.656 -45.139 Top 90 0.4MM 22R
R274 0402WGF0220T1E 216.456 -45.139 Top 90 0.4MM 22R
R275 0402WGF0220T1E 212.883 -45.139 Top 90 0.4MM 22R
R276 0402WGF0220T1E 214.383 -45.139 Top 90 0.4MM 22R
R277 0402WGF0220T1E 230.293 -29.077 Top 180 0.4MM 22R
R278 0402WGF0103T1E 280.490 -164.080 Top 90 0.4MM 100K
R279 0402WGF0103T1E 283.490 -164.080 Top 270 0.4MM 100K
R280 0402WGF0103T1E 29.384 -190.506 Top 90 0.4MM 100K
R281 0402WGF1151T1E -3.932 -98.637 Top 180 0.4MM 1K15
R282 0402WGF3571T1E -3.932 -99.882 Top 0 0.4MM 3K57
R283 0402WGF0103T1E -14.173 -100.409 Top 270 0.4MM 100K
R284 0402WGF0181T1E -1.744 4.361 Top 0 0.4MM 180R
R285 0402WGF0103T1E -1.744 5.561 Top 0 0.4MM 100K
R286 0402WGF0181T1E -2.344 -7.339 Top 0 0.4MM 180R
R287 WSL2512R0100FEA 284.890 -132.280 Top 270 0.89MM 0R01
R288 0402WGF0103T1E 281.690 -169.680 Top 270 0.4MM 10K
R289 0402WGF0103T1E 281.890 -164.080 Top 90 0.4MM 10K
R290 0402WGF0103T1E 278.490 -169.680 Top 270 0.4MM 10K
R291 0402WGF0103T1E 280.090 -169.680 Top 90 0.4MM 10K
R292 WSL25124L000FEA 285.190 -104.680 Top 270 0.89MM 0R004
R293 WSL2512R0100FEA 26.200 -196.400 Top 90 0.89MM 0R01
R294 WSL2512R0100FEA -10.700 -158.300 Top 180 0.89MM 0R01
R295 WSL25122L000FEA 4.573 -106.835 Top 0 0.89MM 0R0022
R296 WSL25124L000FEA 16.000 -157.800 Top 90 0.89MM 0R004
R298 WSL25121L000FEA 26.036 -207.648 Top 90 0.89MM 0R001
R299 0402WGF0103T1E -2.344 -5.939 Top 180 0.4MM 10K
R300 0402WGF499JT1E 128.456 -91.239 Bottom 90 0.4MM 49.9R
R301 0402WGF499JT1E 129.456 -91.239 Bottom 90 0.4MM 49.9R
R302 0402WGF0103T1E 186.956 -58.239 Top 90 0.4MM 10K
R303 0402WGF0103T1E 188.456 -58.239 Top 270 0.4MM 10K
R304 0402WGF249JTIE 175.456 -84.739 Bottom 0 0.4MM 249R
R305 0402WGF3300T1E 188.108 -151.975 Bottom 270 0.4MM 330R
R306 0402WGF2400T1E 189.193 -151.975 Bottom 90 0.4MM 240R
RO1 0402WGF0102T1E 190.056 -83.339 Top 90 0.4MM NO POP
RO2 0402WGF0102T1E 191.556 -83.339 Top 90 0.4MM NO POP
RO3 0402WGF0102T1E 193.056 -83.339 Top 90 0.4MM NO POP
RO4 0402WGF0102T1E 194.556 -83.339 Top 90 0.4MM NO POP
RO5 0402WGF0102T1E 196.056 -83.339 Top 90 0.4MM NO POP
RO10 0402WGJ0104T1E 223.820 -155.144 Top 180 0.4MM NO POP
RO11 0402WGJ0104T1E 223.820 -156.668 Top 0 0.4MM NO POP
RO14 0402WGJ0104T1E 223.820 -158.446 Top 180 0.4MM NO POP
RP1 4D02WGJ0510T 166.656 -120.439 Bottom 90 0.55MM 51R
RP2 4D02WGJ0510T 170.056 -120.439 Bottom 90 0.55MM 51R
RP3 4D02WGJ0510T 173.556 -120.439 Bottom 90 0.55MM 51R
RP4 4D02WGJ0510T 177.956 -126.739 Bottom 180 0.55MM 51R
RP5 4D02WGJ0510T 177.956 -129.239 Bottom 180 0.55MM 51R
RP6 4D02WGJ0510T 177.956 -131.739 Bottom 180 0.55MM 51R
RP7 4D02WGJ0510T 177.956 -134.239 Bottom 180 0.55MM 51R
RP8 4D02WGJ0510T 163.656 -140.239 Bottom 270 0.55MM 51R
RP9 4D02WGJ0510T 171.956 -140.239 Bottom 270 0.55MM 51R
RP10 4D02WGJ0510T 169.156 -140.239 Bottom 270 0.55MM 51R
RP11 4D02WGJ0510T 166.356 -140.239 Bottom 270 0.55MM 51R
RP12 4D02WGJ0510T 177.956 -136.539 Bottom 180 0.55MM 51R
RP13 4D02WGJ0510B1E 40.656 -142.922 Top 180 0.55MM 49.9R
RP14 4D02WGJ0510B1E 40.656 -139.722 Top 180 0.55MM 49.9R
RP15 4D02WGJ0510B1E 40.656 -136.422 Top 180 0.55MM 49.9R
RP16 4D02WGJ0510B1E 40.656 -128.122 Top 180 0.55MM 49.9R
RP17 4D02WGJ0510B1E 40.656 -123.222 Top 180 0.55MM 49.9R
RP18 4D02WGJ0510B1E 40.656 -118.322 Top 180 0.55MM 49.9R
RP19 4D02WGJ0510B1E 273.806 -147.963 Top 0 0.55MM 49.9R
RP20 4D02WGJ0510B1E 40.656 -145.622 Top 180 0.55MM 49.9R
RP21 4D02WGJ0510B1E 273.806 -133.842 Top 0 0.55MM 49.9R
RP22 4D02WGJ0510B1E 273.806 -130.903 Top 0 0.55MM 49.9R
RP23 4D02WGJ0510B1E 273.806 -128.108 Top 0 0.55MM 49.9R
RP24 4D02WGJ0510B1E 273.806 -123.735 Top 0 0.55MM 49.9R
RP25 4D02WGJ0510B1E 273.806 -142.766 Top 0 0.55MM 49.9R
RP26 4D02WGJ0510B1E 273.806 -145.432 Top 0 0.55MM 49.9R
RP27 4D02WGJ0510T 166.856 -74.839 Bottom 90 0.55MM 51R
RP28 4D02WGJ0510T 170.156 -74.839 Bottom 90 0.55MM 51R
RP29 4D02WGJ0510T 174.056 -74.839 Bottom 90 0.55MM 51R
RP30 4D02WGJ0510T 178.156 -80.939 Bottom 180 0.55MM 51R
RP31 4D02WGJ0510T 178.156 -83.839 Bottom 180 0.55MM 51R
RP32 4D02WGJ0510T 178.156 -86.339 Bottom 180 0.55MM 51R
RP33 4D02WGJ0510T 178.156 -88.639 Bottom 180 0.55MM 51R
RP34 4D02WGJ0510T 178.156 -91.039 Bottom 180 0.55MM 51R
RP35 4D02WGJ0510T 164.856 -95.239 Bottom 270 0.55MM 51R
RP36 4D02WGJ0510T 167.956 -95.239 Bottom 270 0.55MM 51R
RP37 4D02WGJ0510T 171.056 -95.239 Bottom 270 0.55MM 51R
RP38 4D02WGJ0510T 161.956 -95.239 Bottom 270 0.55MM 51R
RS1 4D02WGJ0330T 234.456 -160.239 Top 90 0.4MM 33
RS2 4D02WGJ0330T 232.856 -157.539 Top 90 0.4MM 33
RS3 4D02WGJ0330T 231.656 -157.639 Top 90 0.4MM 33
RS7 4D02WGJ0330T 243.056 -168.039 Top 90 0.4MM 33
RS9 4D02WGJ0330T 244.556 -168.139 Top 90 0.4MM 33
RS10 4D02WGJ0330T 234.890 -175.280 Top 90 0.4MM 33
SNP1 N/A 128.490 -210.080 Top 0 0.00000mm
SP2 PGB102ST23WR 231.100 -3.200 Top 270 0.76MM PGB102ST
SW1 7914G 226.729 -203.569 Top 90 4.19MM SPST
SW2 A6S-4101-H 208.356 -184.539 Top 180 3.1MM 4POLE
SW3 A6S-4101-H 196.756 -184.539 Top 180 3.1MM 4POLE
TP1 N/A 193.556 -105.739 Top 0 0.00000mm TEST POI
TP2 N/A 241.656 -167.639 Top 0 0.00000mm
TP3 N/A 191.056 -147.539 Top 0 0.00000mm
TP4 N/A 255.181 -126.624 Top 0 0.00000mm
TP5 N/A 255.627 -143.516 Top 0 0.00000mm
TP6 N/A 246.056 -168.239 Top 0 0.00000mm
TP7 N/A 234.656 -157.039 Top 0 0.00000mm
TP8 N/A 236.056 -159.739 Top 0 0.00000mm
TP9 N/A 198.256 -143.439 Top 0 0.00000mm
U1 PPC440EPX-NTA533T 217.456 -108.239 Top 90 2.65MM 440EPX
U2 SN74AHC1G125DCKT 186.676 -153.289 Top 270 1.1MM
U3 TL7700CPSR 8.956 -21.139 Top 180 0.05080mm
U4 ADCMP605BCPZ 221.022 -210.611 Top 0 1.0MM
U5 ADCMP605BCPZ 232.960 -210.611 Top 0 1.0MM
U6 CDCU877ARHAT 243.252 -124.710 Top 0
U7 SN74LVC1G07DBVT 42.000 -72.000 Top 90
U8 SY89832UMI 87.956 -89.739 Top 180 0.9MM
U9 CY22381FXI_0211P2 230.956 -162.739 Top 90 1.73MM CY22381F
U10 74AVCH4T245DGVRE4 30.836 -18.443 Top 270 1.2MM
U11 74AVCH4T245DGVRE4 40.996 -18.443 Top 270 1.2MM
U12 74AVCH4T245DGVRE4 86.117 -23.981 Top 90 1.2MM
U13 74AVCH4T245DGVRE4 66.904 -18.443 Top 270 1.2MM
U14 74AVCH4T245DGVRE4 77.572 -18.443 Top 270 1.2MM
U15 XC5VSX95T 125.956 -109.739 Top 270 3.4MM
U16 TPS51100DGQ 185.956 -133.239 Top 270 1.1MM TPS51100
U17 K7S3218T4C-FC40 168.956 -130.239 Top 0 1.4MM
U18 TPS2031D 111.532 -10.569 Top 0 1.75MM
U19 TPS2031D 111.532 -16.538 Top 0 1.75MM
U20 MAX9032AKA 97.816 -16.538 Top 270 1.4MM
U21 MAX9032AKA 98.070 -10.315 Top 270 1.4MM
U22 SN74AHC1G08DCKR 104.200 -9.060 Top 0 1.45MM
U23 SN74AHC1G08DCKR 104.200 -15.283 Top 0 1.45MM
U24 CY2292F 241.290 -173.080 Top 90 1.73MM CY2292FZ
U25 ADR03ARZ 79.756 -117.239 Top 0 1.75MM
U26 SY89832UMI 87.956 -75.739 Top 180 0.9MM
U27 PTH08T220WAD -13.944 -134.140 Top 90 8.5MM
U28 TPS2031D 111.532 -4.219 Top 0 1.75MM
U29 TPS2031D 111.532 2.080 Top 0 1.75MM
U30 MAX9032AKA 98.197 2.131 Top 270 1.4MM
U31 MIC2774N-29YMS 224.567 -194.646 Top 270 1.45MM MIC2774N
U32 TPS51100DGQ 276.844 -102.837 Top 90 1.1MM TPS51100
U33 TPS51100DGQ 25.056 -126.022 Top 180 1.1MM TPS51100
U34 MAX9032AKA 98.197 -4.092 Top 270 1.4MM
U35 SN74LVC1G08DCKR 220.956 -191.939 Top 270 1.1MM 74LVC1G0
U36 SN74AHC1G08DCKR 104.200 -2.837 Top 0 1.45MM
U37 SN74AHC1G08DCKR 104.200 3.400 Top 0 1.45MM
U38 AT24HC04BN-SH 51.389 -36.533 Top 0 1.75MM AT24HC04
U39 SN74LVC1G07DBVT 30.000 -72.000 Top 90
U40 AT24HC04BN-SH 77.259 -36.507 Top 0 1.75MM AT24HC04
U41 AD7414ARTZ-0 41.967 -36.532 Top 0 1.45MM AD7414-0
U42 S29GL512P11FFI010 171.956 -108.739 Top 0 1.4MM 32MX16 M
U43 ICL3225EIAZ 274.066 -14.739 Top 270 2MM ICL3225E
U44 ICL3225EIAZ 264.956 -14.739 Top 270 2MM ICL3225E
U45 PI5A3157ZAEX 273.932 -22.937 Top 270 1.1MM PI5A3157
U46 PI5A3157ZAEX 270.620 -22.937 Top 270 1.1MM PI5A3157
U47 SN74LVC1G07DBVT 18.000 -72.000 Top 90
U48 PI5A3157ZAEX 267.171 -22.937 Top 270 1.1MM PI5A3157
U49 SN74LVC1G07DBVT 18.000 -75.000 Top 90
U50 PTH05T210WAD -14.452 -203.228 Top 0 8.5MM PTH05T21
U51 PTH08T240WAD 2.820 -183.416 Top 90 8.5MM PTH08T24
U52 SN74LVC1G07DBVT 30.000 -75.000 Top 89
U53 PTH08T230WAD -14.452 -183.416 Top 90 8.5MM
U54 XC2C256_7VQ144C 204.256 -157.085 Top 270 1.6MM
U55 TPS74401RGWT 98.456 -31.739 Top 180 1.0MM TPS74401
U56 TPS74401RGWT 124.456 -31.739 Top 180 1.0MM TPS74401
U57 TPS74401RGWT 111.456 -31.739 Top 180 1.0MM TPS74401
U58 DP83865DVH 217.133 -29.836 Top 0 1.0MM
U59 TPS74401RGWT -9.372 -98.580 Top 270 1.0MM TPS74401
U60 AFS600-FG256 21.456 -49.739 Top 270 1.7MM
U61 ADM3101EACPZ-REEL 10.224 -5.568 Top 90 1.0MM
U62 TPS51100DGQ 188.356 -63.939 Top 90 1.1MM TPS51100
U63 K7S3218T4C-FC40 168.956 -84.739 Top 0 1.4MM
U64 SN74LVC1G07DBVT 42.000 -75.000 Top 90
U65 74AVCH4T245DGVRE4 54.600 -58.500 Top 0 1.2MM
U66 74AVCH4T245DGVRE4 65.300 -58.500 Top 0 1.2MM
U67 SN74LVC1G07DBVT 48.000 -57.700 Top 90
U68 SN74LVC1G07DBVT 48.000 -60.000 Top 90
V1 N/A 136.456 -83.439 Top 180 0.00000mm
V2 N/A 105.556 -85.239 Top 0 0.00000mm
V3 N/A 146.056 -6.839 Top 0 0.00000mm
V4 N/A 112.456 -83.439 Top 180 0.00000mm
V5 N/A 147.490 -9.280 Top 180 0.00000mm
V6 N/A 141.856 -6.839 Top 0 0.00000mm
V7 N/A 99.556 -85.239 Top 0 0.00000mm
V8 N/A 143.156 -9.339 Top 180 0.00000mm
V9 N/A 102.056 -83.439 Top 180 0.00000mm
V18 N/A 156.656 -9.339 Top 180 0.00000mm
V19 N/A 118.456 -83.439 Top 180 0.00000mm
V20 N/A 155.290 -6.880 Top 0 0.00000mm
V21 N/A 115.956 -85.239 Top 0 0.00000mm
V22 N/A 160.890 -9.380 Top 180 0.00000mm
V23 N/A 124.456 -83.439 Top 180 0.00000mm
V24 N/A 159.556 -6.939 Top 0 0.00000mm
V25 N/A 121.956 -85.239 Top 0 0.00000mm
V34 N/A 175.890 -9.380 Top 180 0.00000mm
V35 N/A 133.956 -85.239 Top 0 0.00000mm
V36 N/A 174.556 -6.939 Top 0 0.00000mm
V37 N/A 127.956 -85.239 Top 0 0.00000mm
V38 N/A 170.290 -6.880 Top 0 0.00000mm
V39 N/A 130.456 -83.439 Top 180 0.00000mm
V40 N/A 171.656 -9.339 Top 180 0.00000mm
V49 N/A 145.056 -83.339 Top 180 0.00000mm
V50 N/A 185.156 -9.339 Top 180 0.00000mm
V51 N/A 183.890 -6.880 Top 0 0.00000mm
V52 N/A 139.956 -85.239 Top 0 0.00000mm
V53 N/A 189.390 -9.380 Top 180 0.00000mm
V54 N/A 152.356 -83.239 Top 180 0.00000mm
V55 N/A 188.056 -6.939 Top 0 0.00000mm
V56 N/A 149.456 -85.139 Top 0 0.00000mm
VR4 V5.5MLA0603XXX 226.000 -1.400 Top 270 0.9MM 5.5V 20A
X1 CCLD-023-25-156.250 79.956 -88.739 Top 0 1.8MM 156.25MH
X2 CCLD-023-25-100.000 79.956 -98.239 Top 0 1.8MM 100.00MH
X3 CCLD-024-25-200.000 79.956 -108.739 Top 0 1.8MM 200.00MH
X4 CCLD-023-25-156.250 79.956 -74.739 Top 0 1.8MM 156.25MH
X5 ECX-306 21.662 -25.702 Top 180 2.5MM 32.768KH
Y1 CS10-22.1184MAGJ-UT 230.656 -169.039 Top 0 1.0MM 22.1184M
Y2 CS10-12.000MAGJ-UT 241.356 -179.939 Top 0 1.0MM 12.00 MH
