ska-sa/roach1_hardware/SimLib/Virtex5/virtex5_spice/rnr_spice/INPUTS_ONLY/DIFF_HSTL_I_18_DCI/readme

Date: 9/22/2006   Virtex5 Receiver model --  Xilinx Confidential
Encrypted Netlist/Model for DIFF_HSTL_I_DCI_18 1.8v Receiver
rev1.0

Models   - directory for process models
subcircuits_rec  - directory contains all subcircuit calls
diffhstl.sp is the stimulus file
netlist.main  is the main netlist shell.

Ports of interest : 

1). in1 & in2 - Input pins 
2). in1_int & in2_int - inputs after the pkg model
3). lvds_out : Output of the lvds input buffer ( goes into the Virtex5 core)
4). in_to_ff : Input to the flipflop in the Virtex5 core.

Note : In order for simulations to run correctly, the user will
have to modify the following lines in the ".sp"  appropriately :

.options search='../subcircuits_rec'
.lib '../models/rx0.20_enc.lib' TT
.lib '../models/rx0.20_enc.lib' T_res 

TT corner : vdd=1v, vcco=1.8v, vccaux=2.5v, temp=25c
SS corner : vdd=0.95v, vcco=1.7v, vccaux=2.375v, temp=85c
FF corner : vdd=1.05v, vcco=1.9v, vccaux=2.625v, temp=0c

revhistory

9/22/06 : 1.0 - Original models.
