ska-sa/roach1_hardware/SimLib/Virtex5/virtex5_spice/rnr_spice/OUTPUTS_ONLY/DIFFERENTIAL/DIFF_HSTL_II_DCI/readme

Date: 9/27/2006   --  Xilinx Confidential
Virtex5 : Encrypted Netlist/Model for DCI DIFFHSTL ClassII 1.5v
rev1.0

Models  directory for process models
subcircuits_diff directory has all subcircuit calls
diffhstl2.sp is the stimulus file
netlist.main  is the main netlist shell.

Note : In order for simulations to run correctly, the user will
have to modify the following lines in the ".sp"  appropriately :

.options search='../subcircuits_diff'
.lib  'models/rx0.20_enc.lib' TT

TT corner : vdd=1v, vcco=1.5v, vccaux=2.5v, temp=25c
SS corner : vdd=0.95v, vcco=1.4v, vccaux=2.375v, temp=85c
FF corner : vdd=1.05v, vcco=1.6v, vccaux=2.625v, temp=0c

revhistory

9/27/06 : 1.0 - Original models.
