ska-sa/roach1_hardware/SimLib/Virtex5/virtex5_spice/rnr_spice/OUTPUTS_ONLY/SINGLE-ENDED/GTL_DCI/readme

Date: 8/20/2006   --  Xilinx Confidential
Virtex5 : Encrypted Netlist/Model for GTL_DCI
rev1.0

Models  directory for process models
subcircuits_drv directory has all subcircuit calls
gtl.sp is the stimulus file
netlist.main  is the main netlist shell.

Note : In order for simulations to run correctly, the user will
have to modify the following lines in the ".sp"  appropriately :

.options search='../subcircuits_drv'
.lib  'models/rx0.20_enc.lib' TT

Simulation conditions :

TT corner : vdd=1v, vcco=1.2v, vccaux=2.5v, temp=25c
SS corner : vdd=0.95v, vcco=1.14v, vccaux=2.375v, temp=85c
FF corner : vdd=1.05v, vcco=1.26v, vccaux=2.625v, temp=0c

revhistory

8/10/06 : 1.0 - Original models.
