ska-sa/roach1_hardware/IO/bank_arrangement.gif

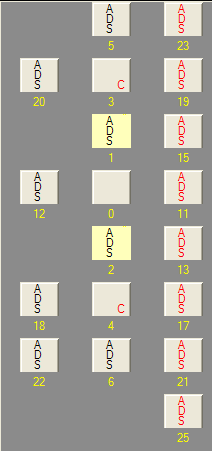
IO/bank_arrangement.gif
