ska-sa/roach1_hardware/IO/sx95t_banks_over_pins.bmp

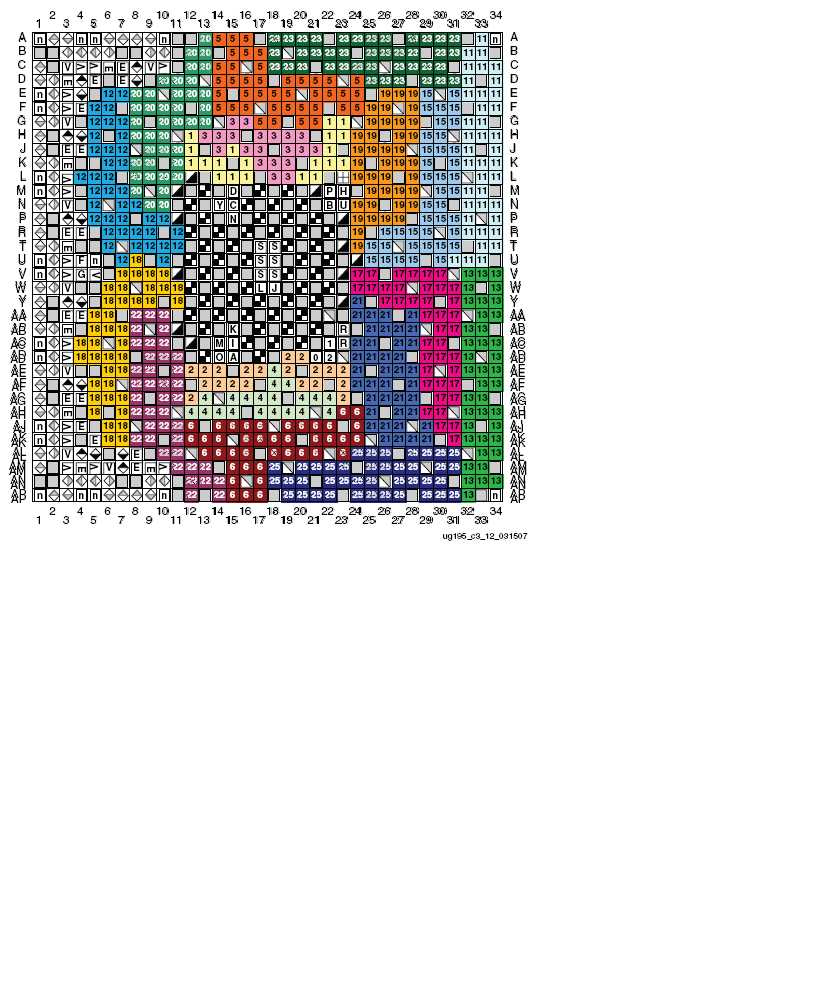
IO/sx95t_banks_over_pins.bmp
