ska-sa/roach1_hardware/SISim/PCS_0 - PPC Driving.TIF

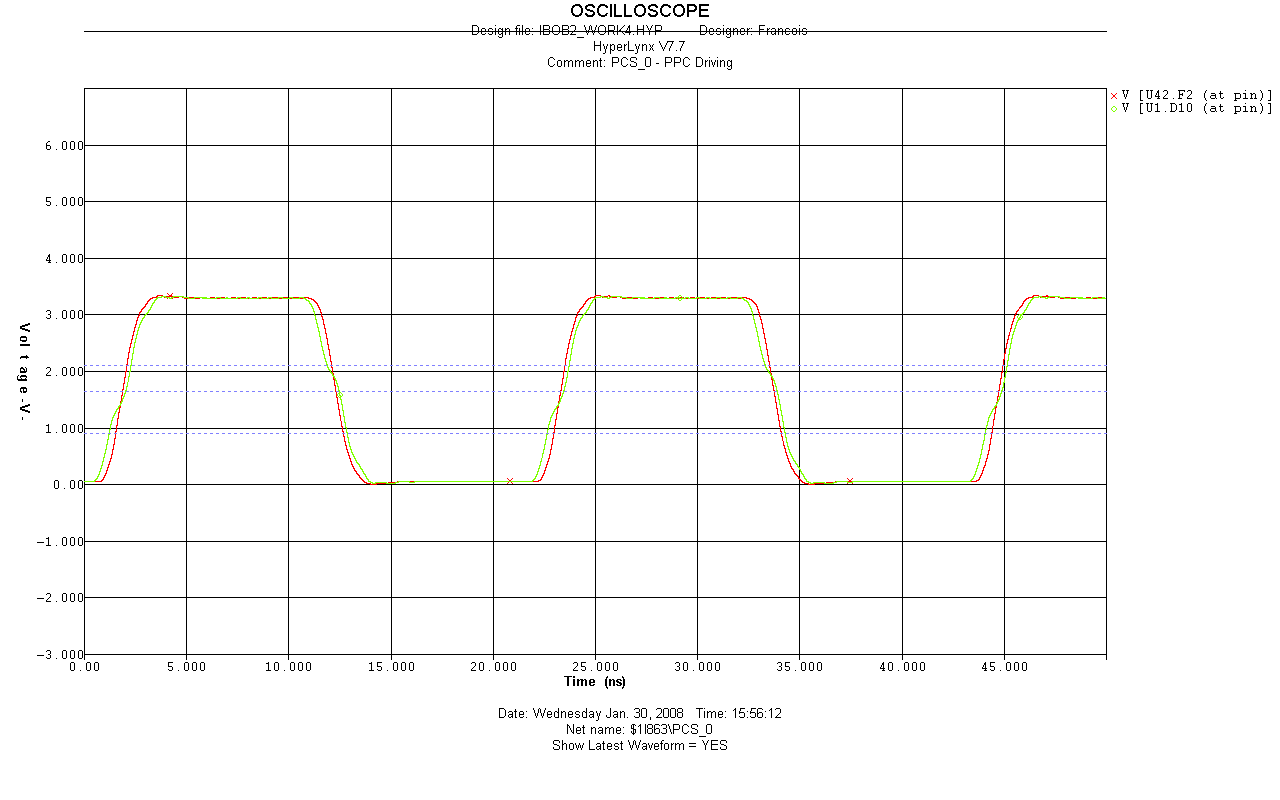
SISim/PCS_0 - PPC Driving.TIF
