ska-sa/roach1_hardware/SISim/PER_CLK_PAR_TERM.TIF

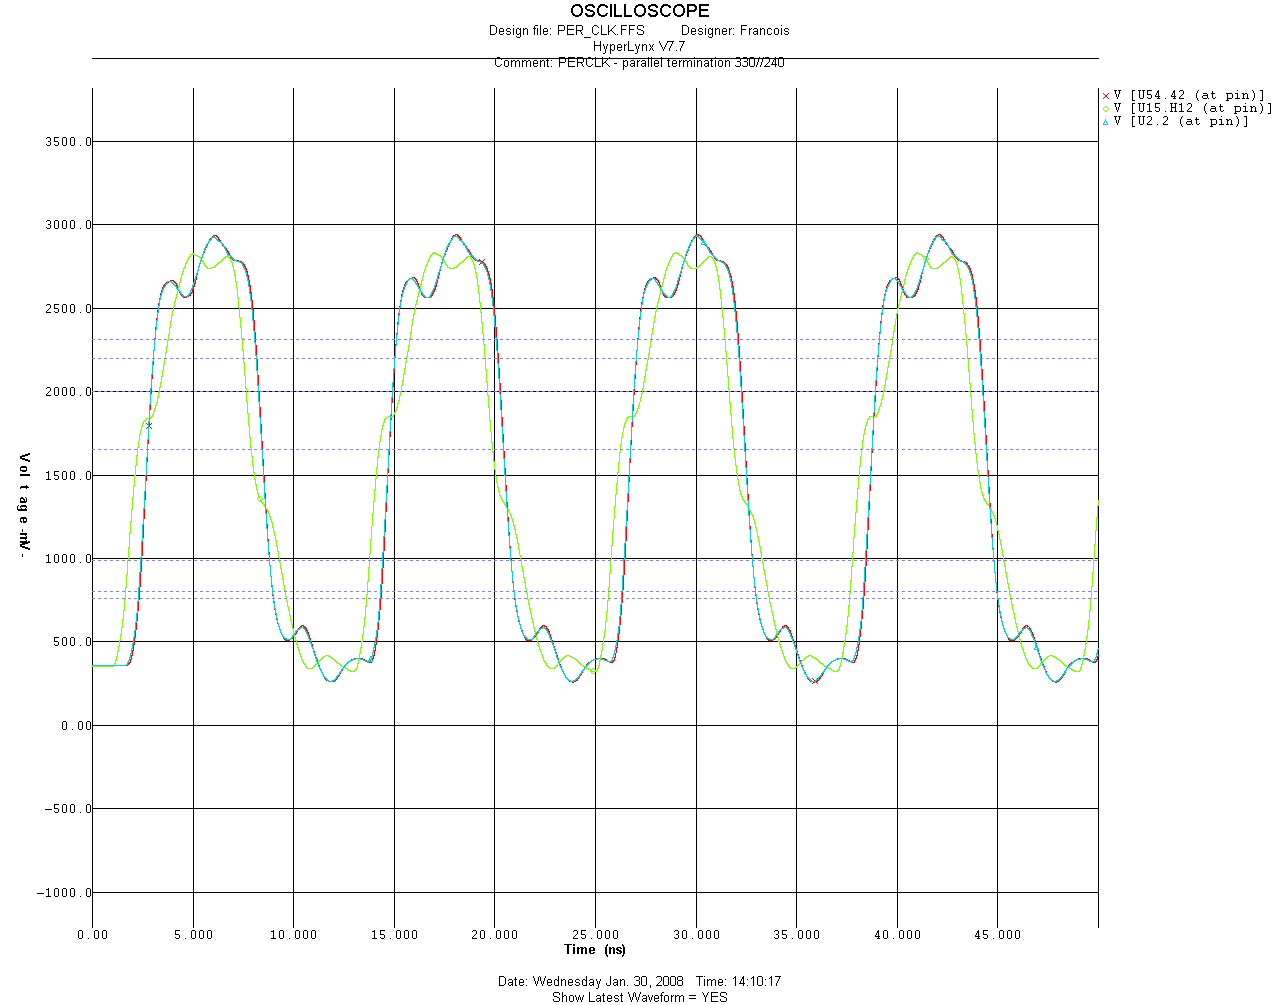
SISim/PER_CLK_PAR_TERM.TIF
