ska-sa/roach1_hardware/SISim/PER_CLK_SER_TERM.TIF

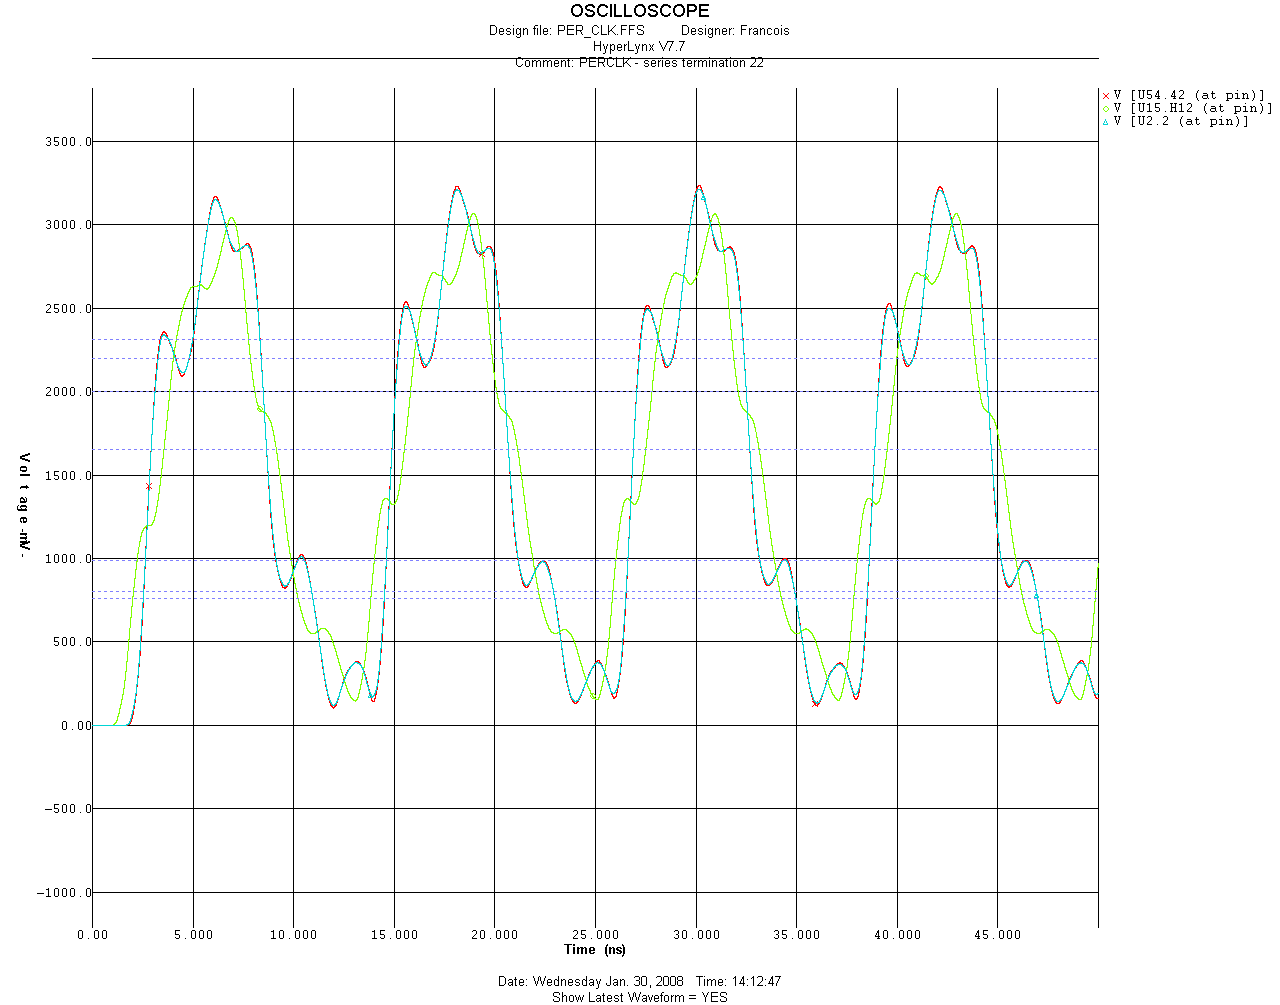
SISim/PER_CLK_SER_TERM.TIF
