ska-sa/roach1_hardware/SISim/PERDATA10 - Flash Driving.TIF

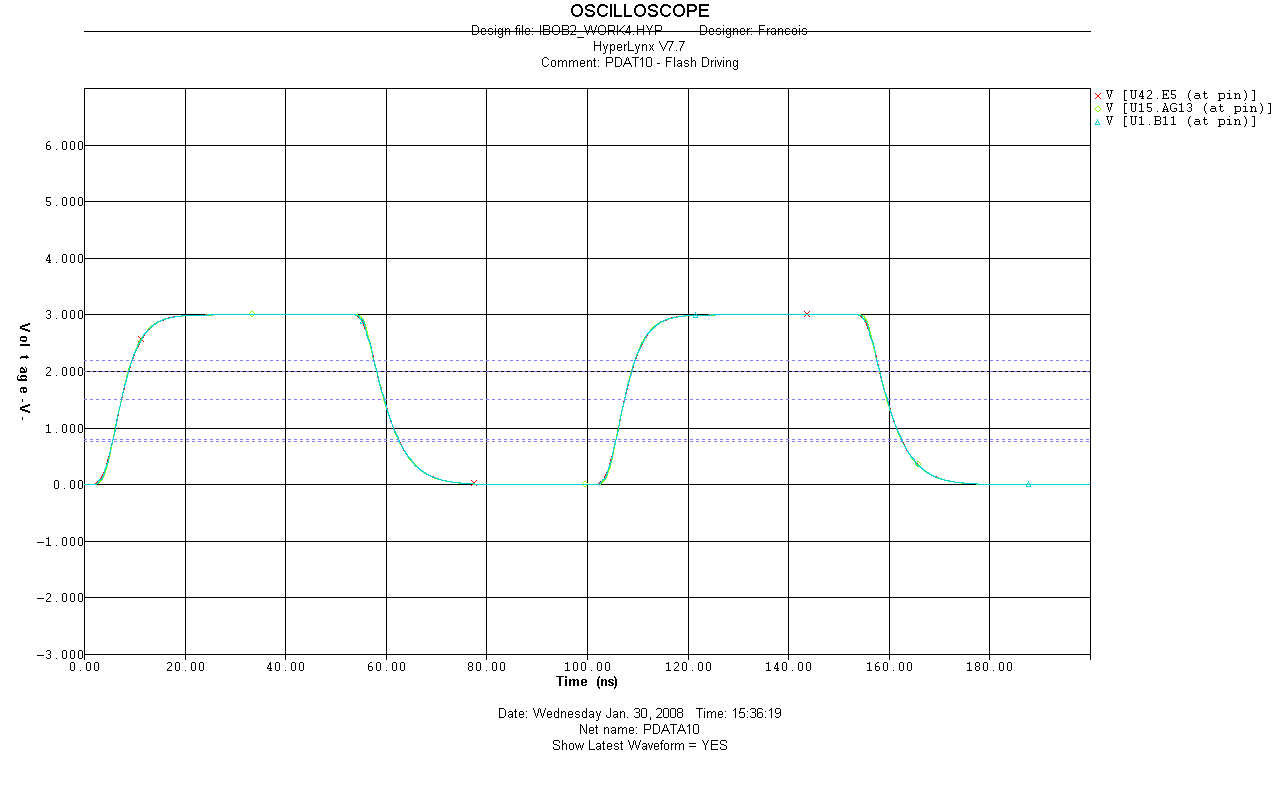
SISim/PERDATA10 - Flash Driving.TIF
