ska-sa/roach1_hardware/SISim/PERDATA10 - PPC Driving.TIF

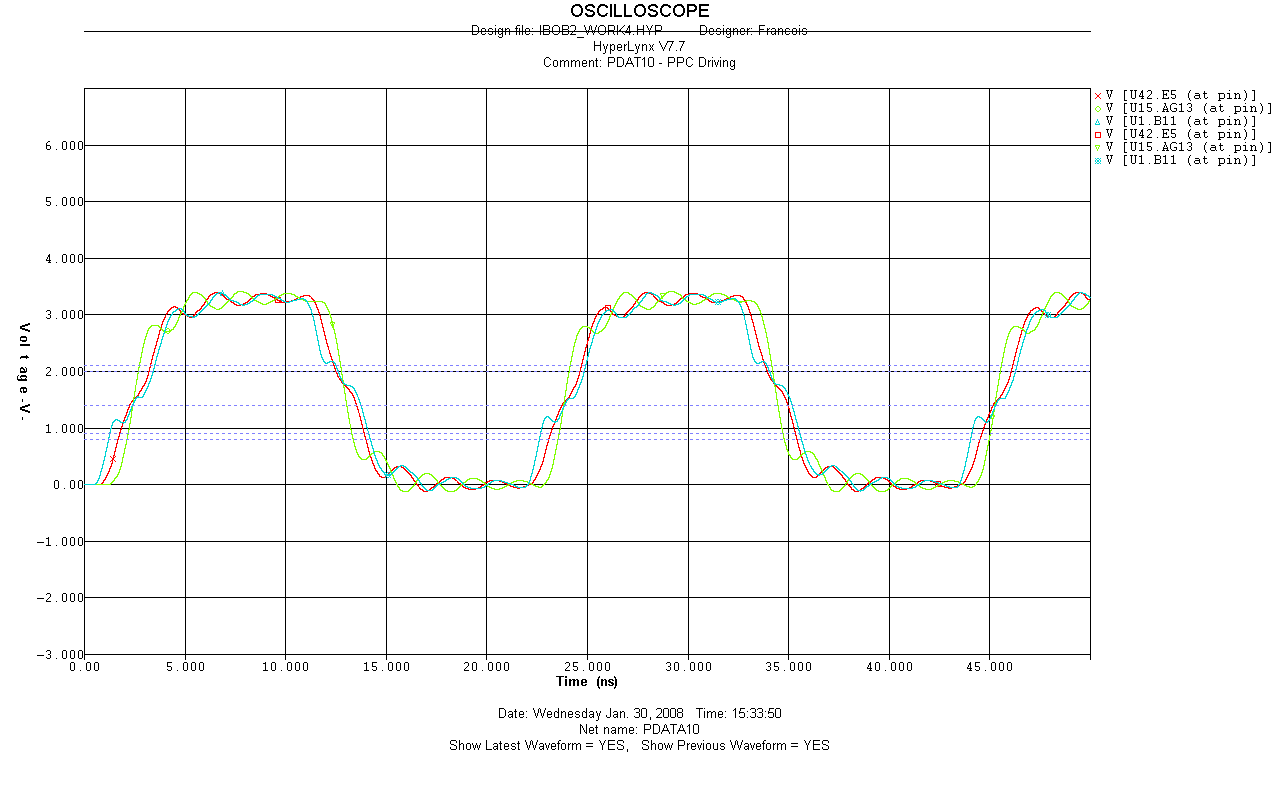
SISim/PERDATA10 - PPC Driving.TIF
