ska-sa/roach1_hardware/SISim/PPC_DDR2/PPC-DDR2 (DDR_PCAS#).GIF

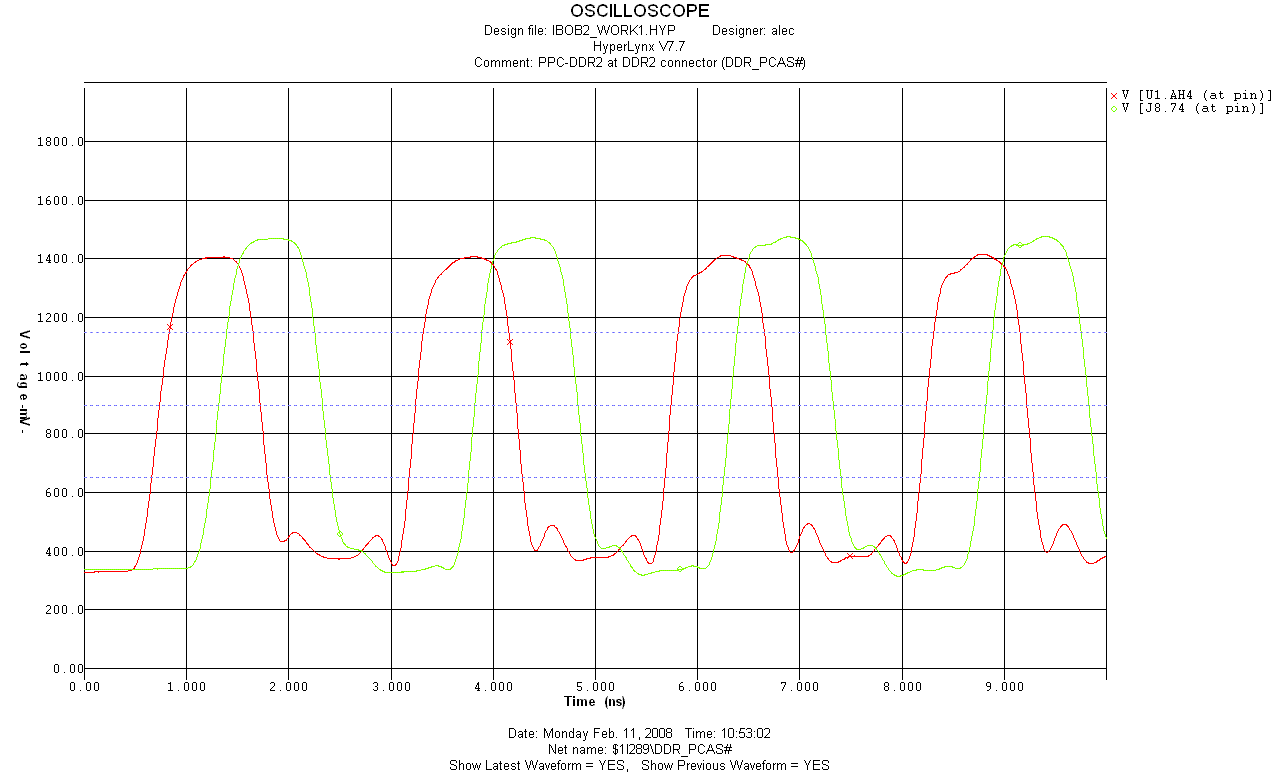
SISim/PPC_DDR2/PPC-DDR2 (DDR_PCAS#).GIF
