ska-sa/roach1_hardware/SISim/PPC_DDR2/PPC-DDR2 at DDR2 connector (DDR_CLKOUT & DDR_CLKOUT#).GIF

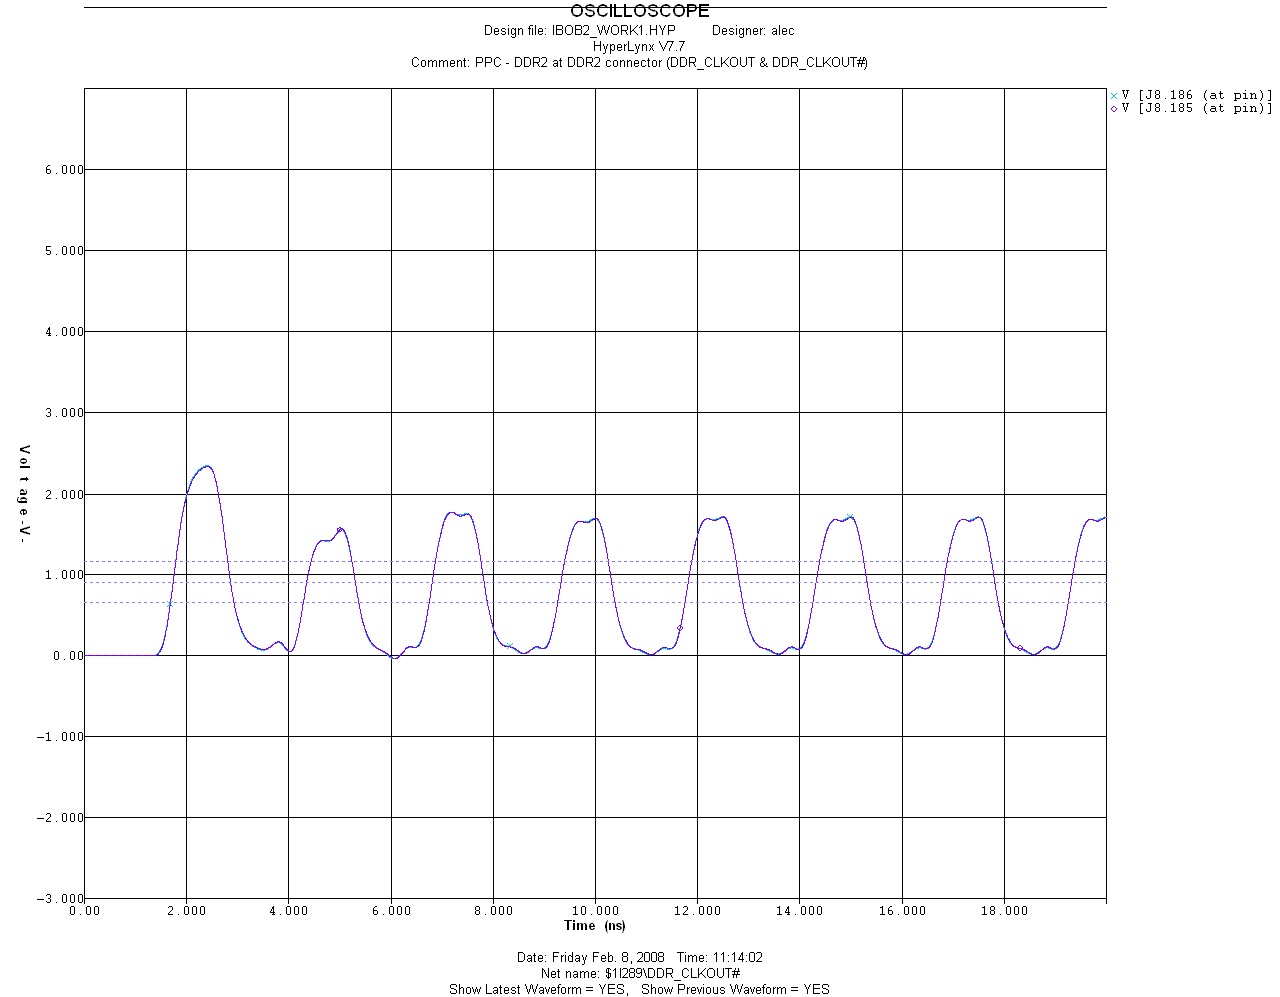
SISim/PPC_DDR2/PPC-DDR2 at DDR2 connector (DDR_CLKOUT & DDR_CLKOUT#).GIF
