ska-sa/roach1_hardware/SISim/QDRII/U17_QDR2_CQ_nCQ_400MHz.GIF

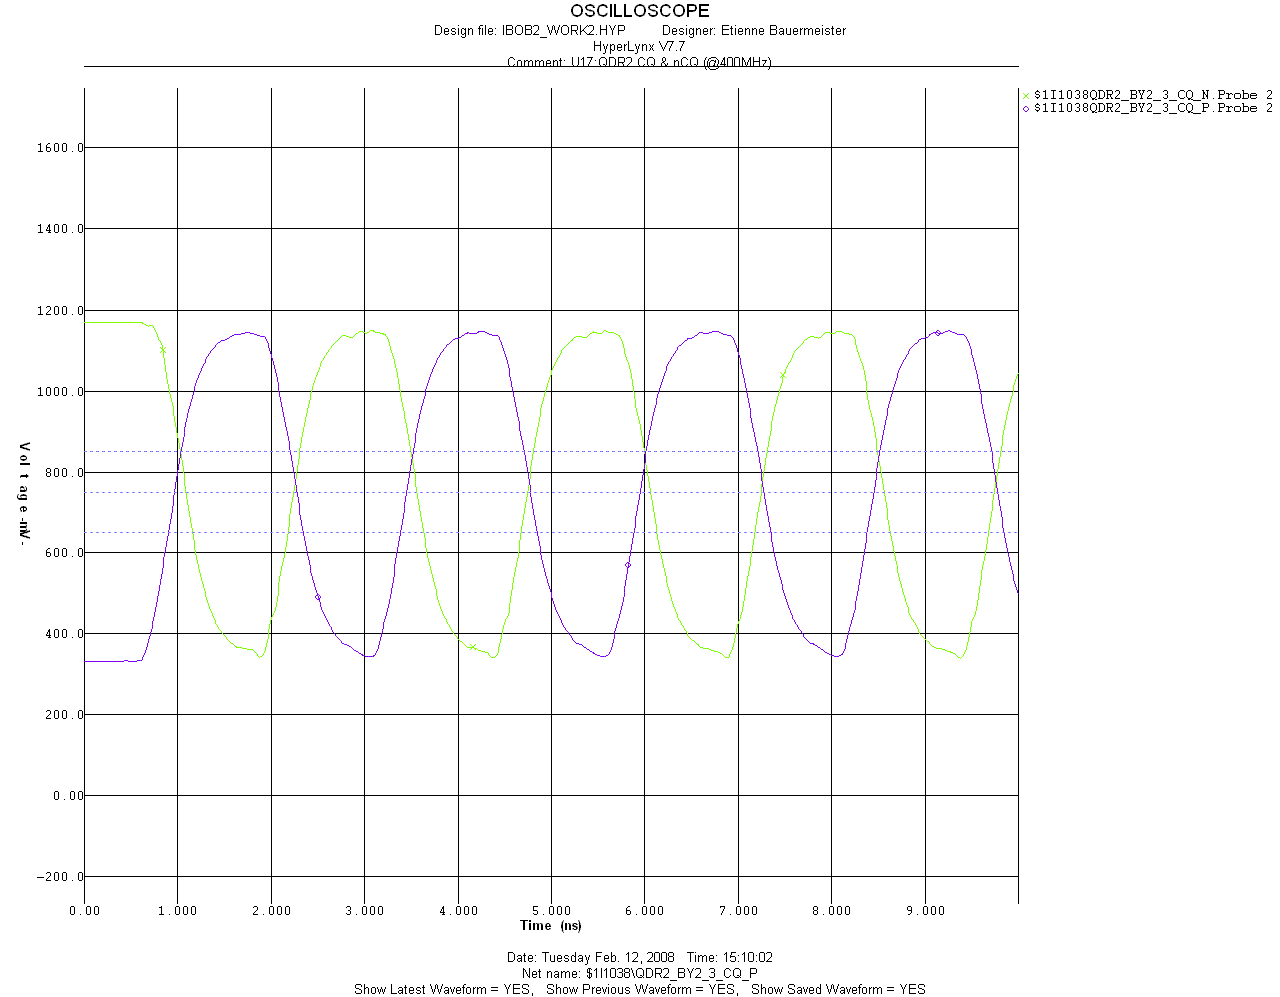
SISim/QDRII/U17_QDR2_CQ_nCQ_400MHz.GIF
