ska-sa/roach1_hardware/SISim/QDRII/U17_QDR2_D0_D17_400MHz.GIF

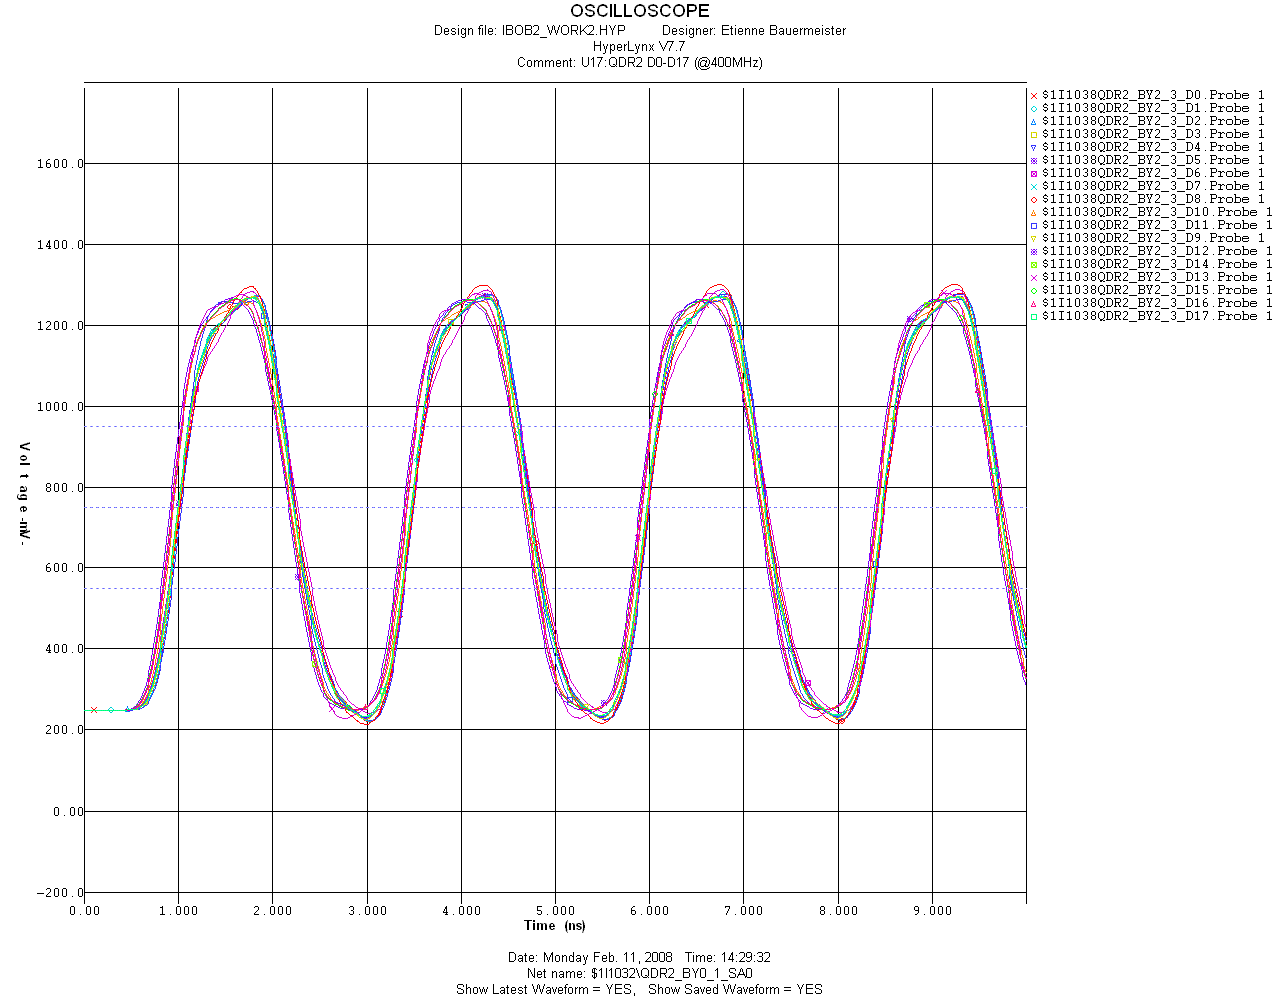
SISim/QDRII/U17_QDR2_D0_D17_400MHz.GIF
