ska-sa/roach1_hardware/SISim/QDRII/U17_QDR2_Q0_Q17_400MHz.GIF

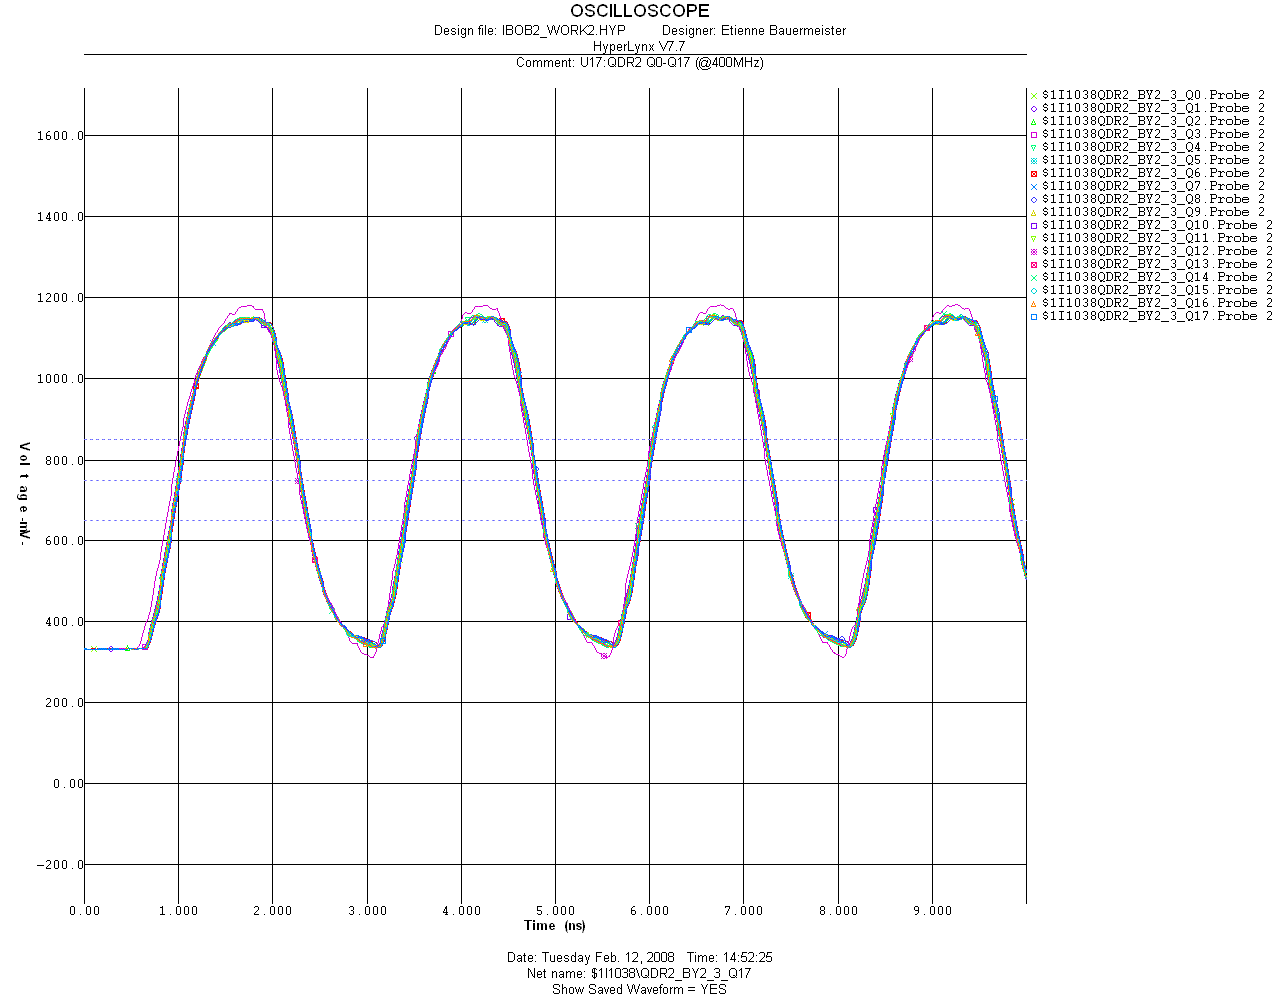
SISim/QDRII/U17_QDR2_Q0_Q17_400MHz.GIF
