ska-sa/roach1_hardware/SISim/QDRII/U17_QDR2_SA0_SA21_400MHz.GIF

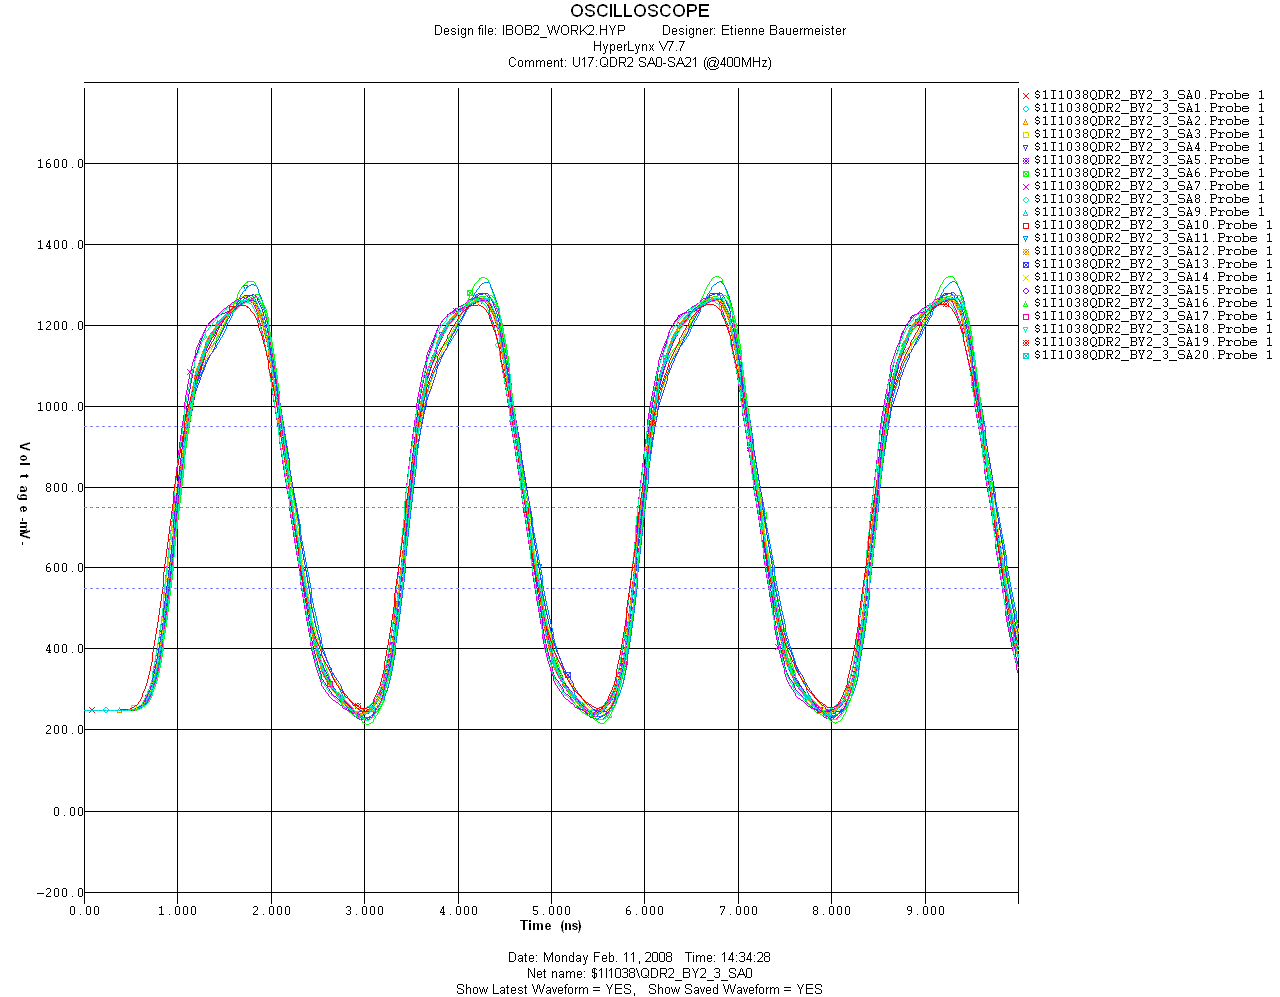
SISim/QDRII/U17_QDR2_SA0_SA21_400MHz.GIF
