ska-sa/roach1_hardware/SISim/SMA/U11_GPIO_FPGA_1B1_SMA1_50MHz.GIF

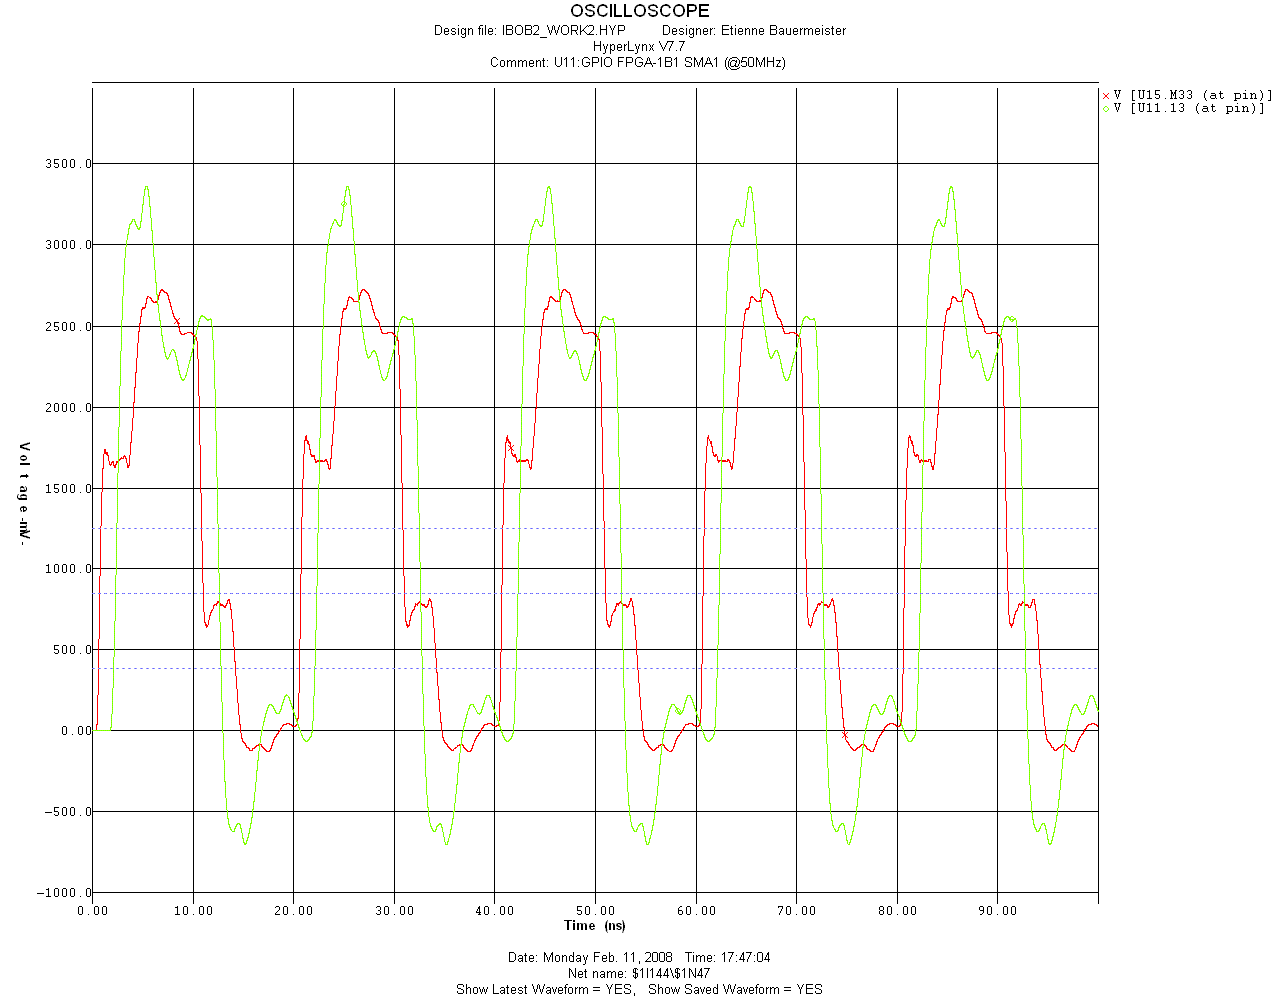
SISim/SMA/U11_GPIO_FPGA_1B1_SMA1_50MHz.GIF
