ska-sa/roach1_hardware/SISim/SMA/U11_GPIO_FPGA_1B2_SMA2_50MHz.GIF

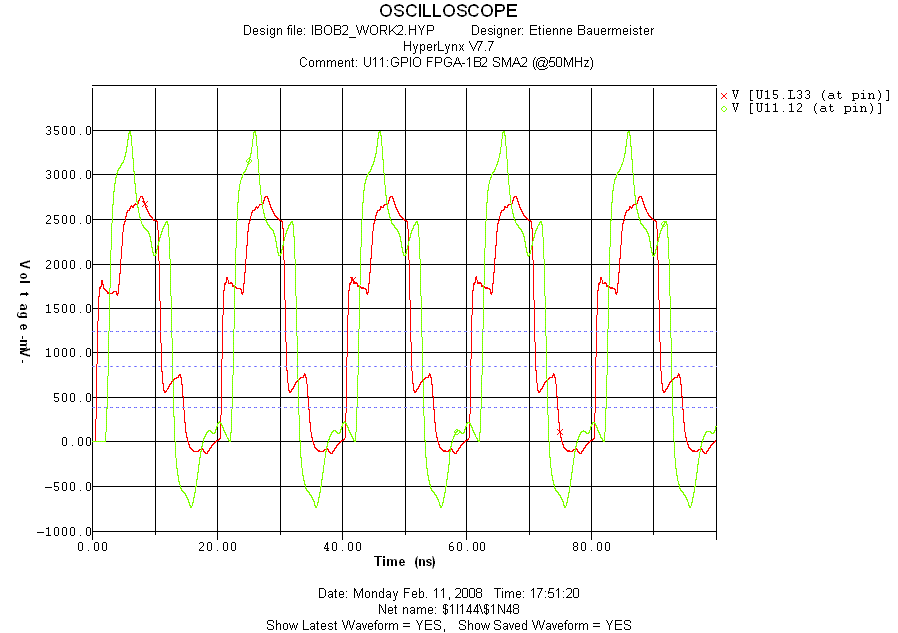
SISim/SMA/U11_GPIO_FPGA_1B2_SMA2_50MHz.GIF
