ska-sa/roach1_hardware/SISim/SMA/U11_GPIO_SMA2_100MHz.GIF

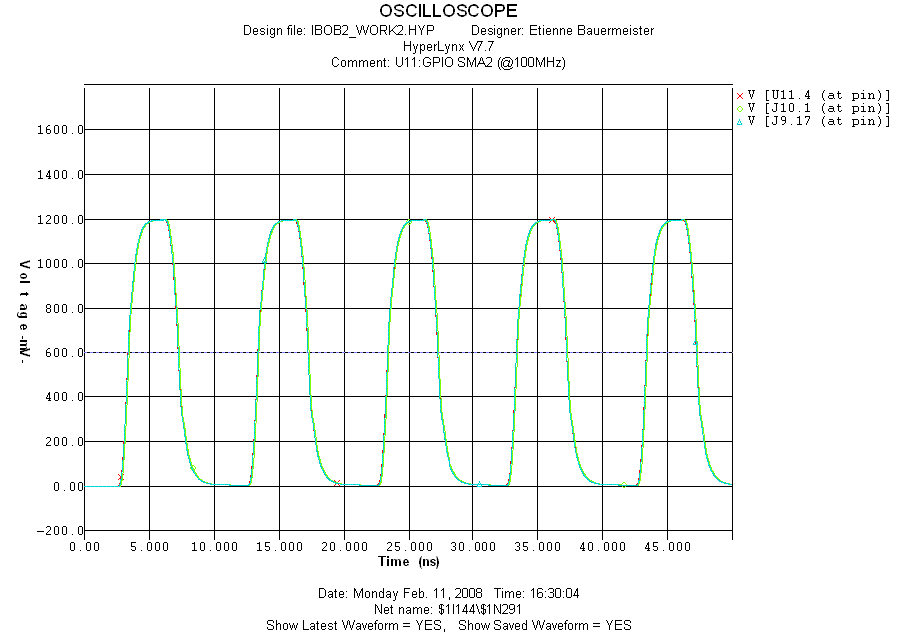
SISim/SMA/U11_GPIO_SMA2_100MHz.GIF
