ska-sa/roach1_hardware/SISim/Stackup/route2_W100_G100_S100_80R_D.TIF

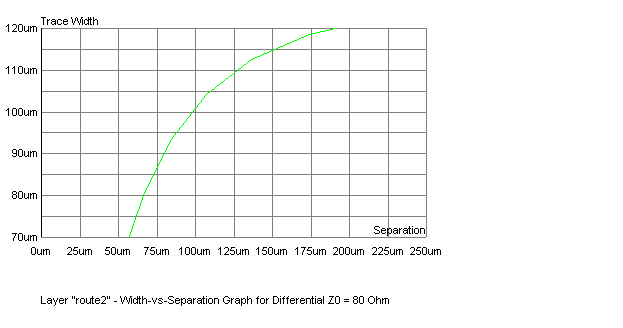
SISim/Stackup/route2_W100_G100_S100_80R_D.TIF
