ska-sa/roach1_hardware/SISim/Stackup/stackup93mil.TIF

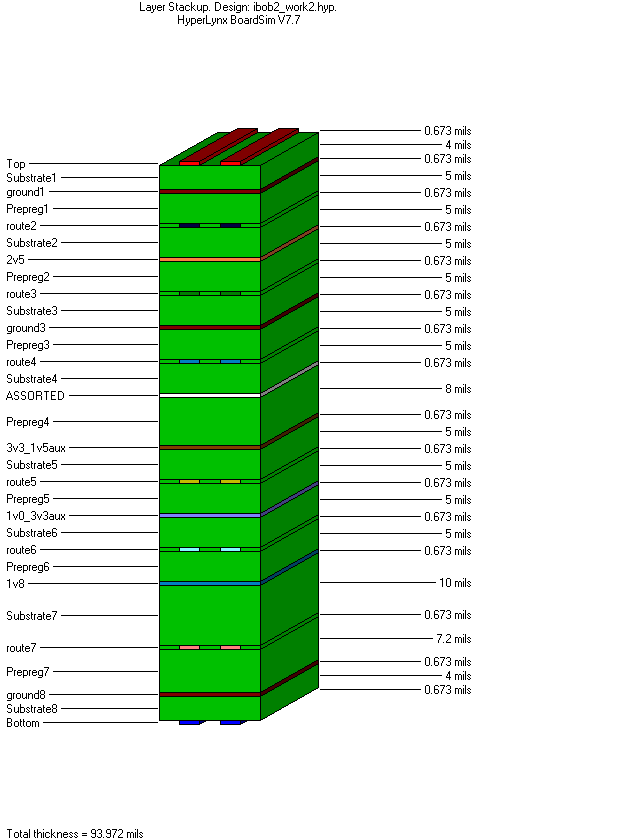
SISim/Stackup/stackup93mil.TIF
