ska-sa/roach1_hardware/SISim/Stackup/top_W100_G100_S100_100R_D.TIF

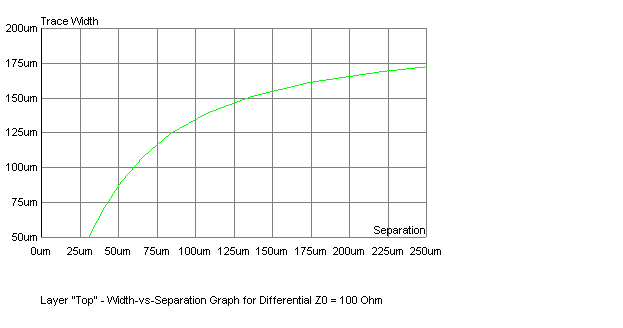
SISim/Stackup/top_W100_G100_S100_100R_D.TIF
