ska-sa/roach1_hardware/SISim/Z-DOK/P5_ZDOK_CLK0_500MHz.GIF

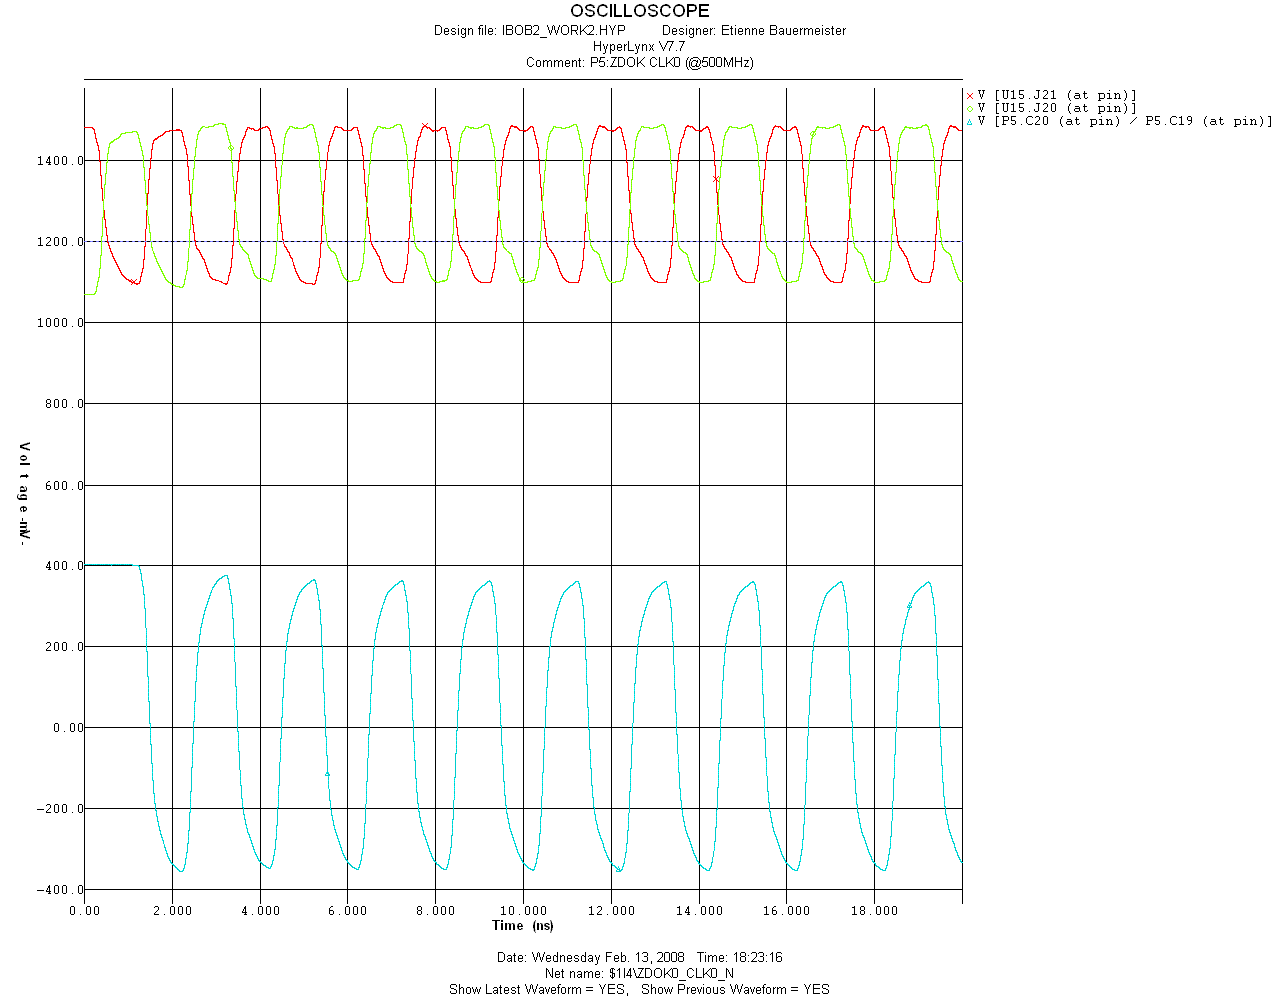
SISim/Z-DOK/P5_ZDOK_CLK0_500MHz.GIF
