ska-sa/roach1_hardware/SISim/Z-DOK/P5_ZDOK_DOUT0-DOUT15_500MHz.GIF

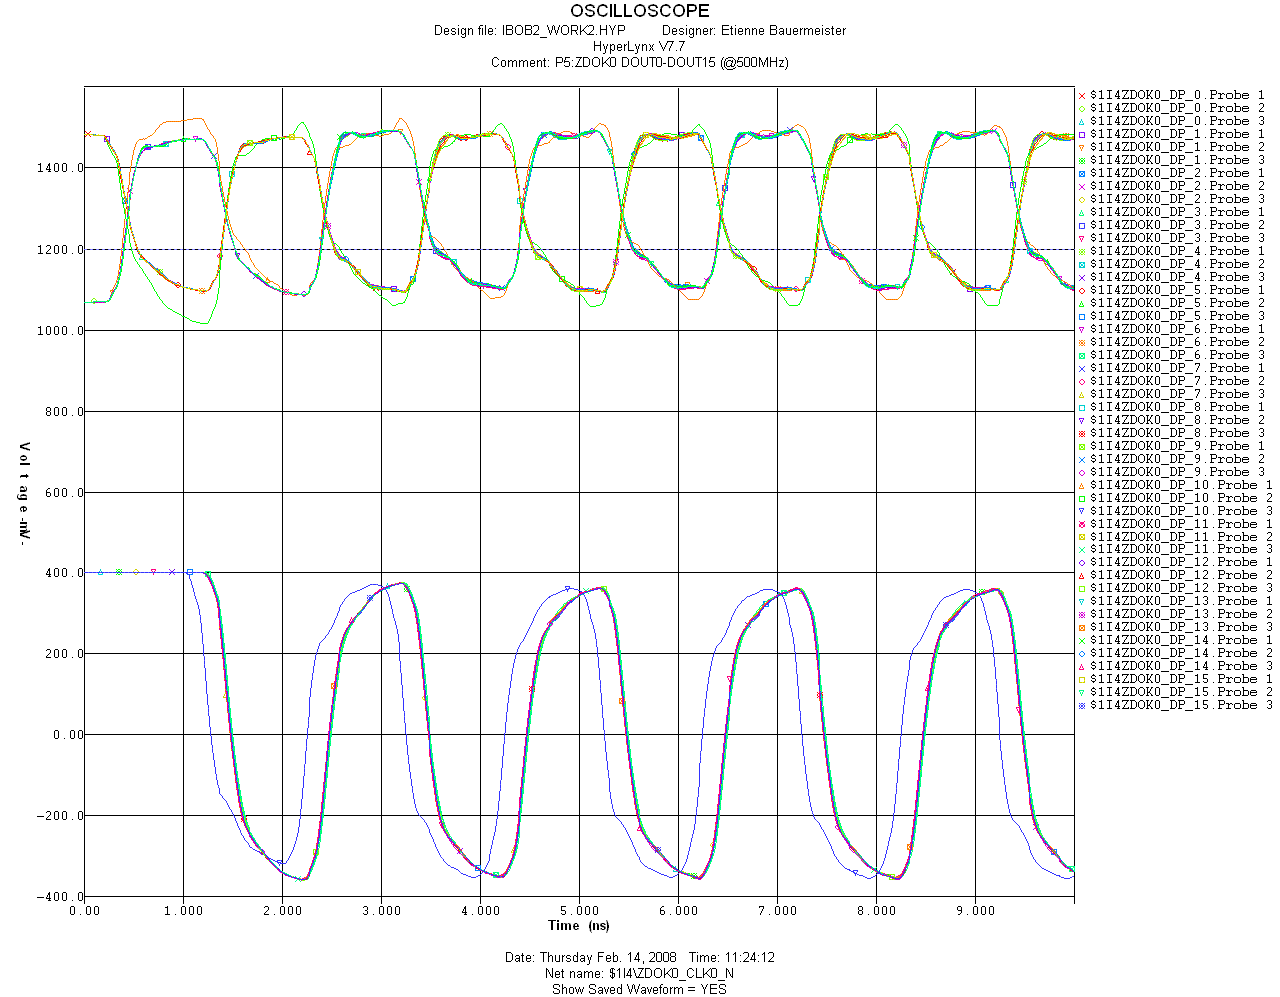
SISim/Z-DOK/P5_ZDOK_DOUT0-DOUT15_500MHz.GIF
