ska-sa/roach1_hardware/SISim/Z-DOK/P5_ZDOK_DOUT16-DOUT31_500MHz.GIF

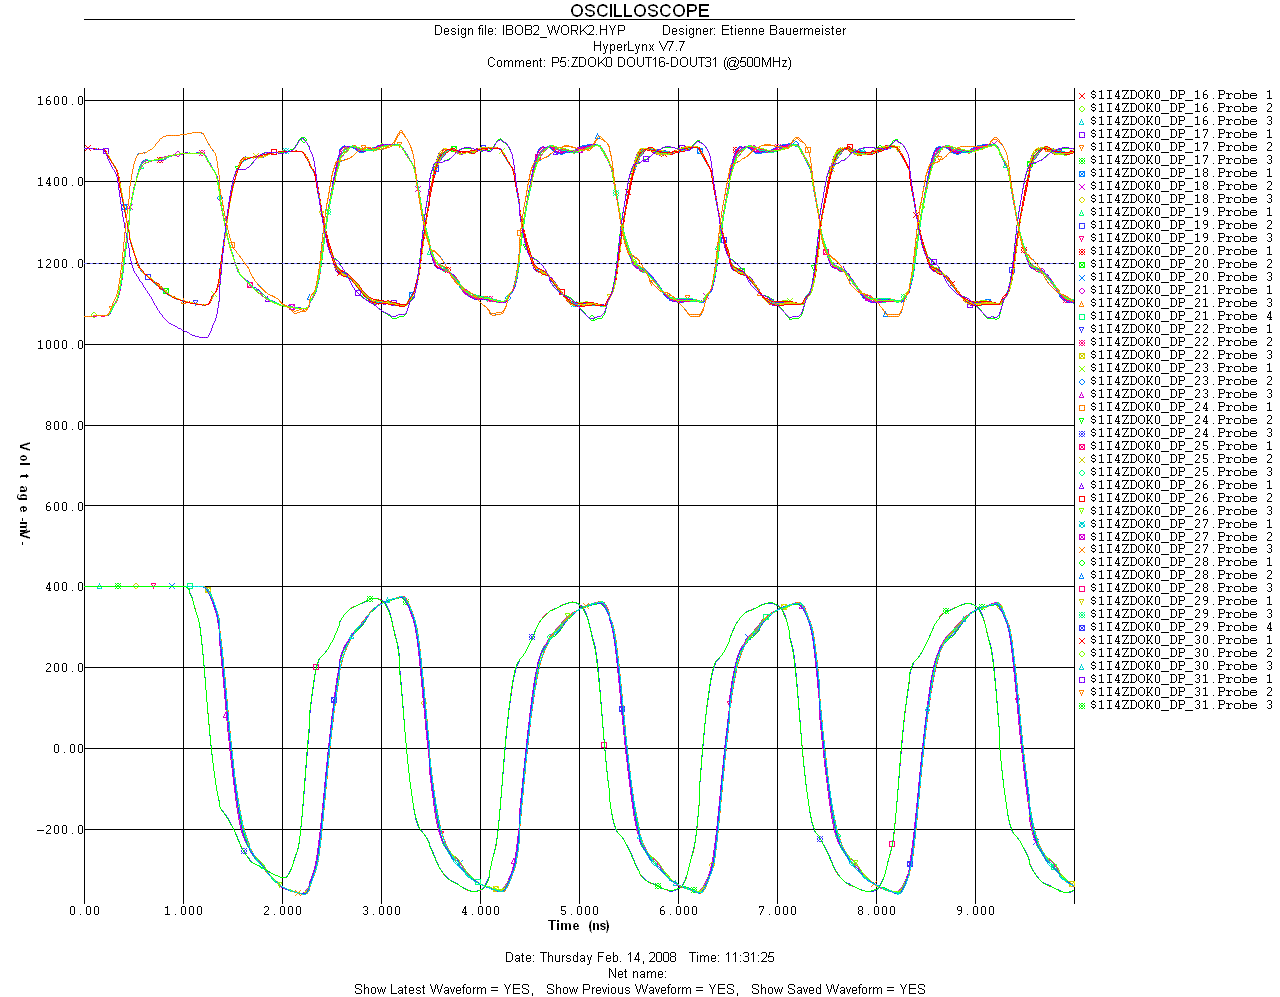
SISim/Z-DOK/P5_ZDOK_DOUT16-DOUT31_500MHz.GIF
