ska-sa/roach1_hardware/SISim/Z-DOK/P5_ZDOK_DOUT32-DOUT37_500MHz.GIF

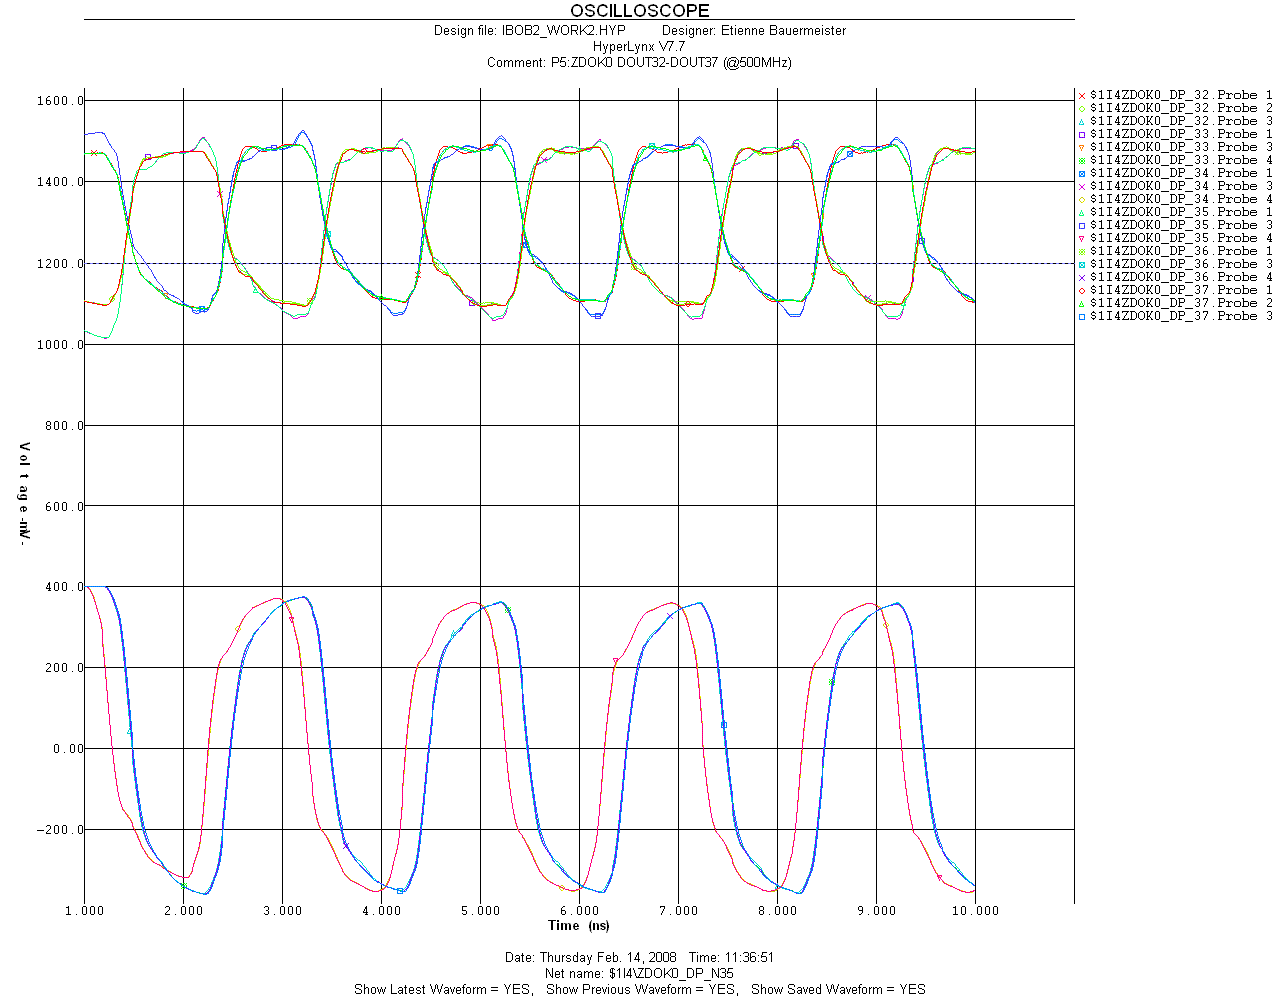
SISim/Z-DOK/P5_ZDOK_DOUT32-DOUT37_500MHz.GIF
