ska-sa/roach1_hardware/PartsForLibrary.ods

 | Primary Source |  |  |  |  |  | Second Source |  | Type
No | Manufacturer | Part # | Height | Footprint | Symbol | Datasheet | Manufacturer | Part #
1 | Pletronics | LV7745DW-156.25M | 1.7 | OSCSC254P500X700X170-6N |  | pletronics/lv77d 2.5v.pdf | Epson | EG-2121CA 156.2500M-PHPAL3
2 | Epson | EG-2121CA 156.2500M-PHPAL3 | 1.4 | OSCSC254P500X700X140-6N |  | epson/EG2121_2102.pdf | Pletronics | LV7745DW-156.25M
3 | Tyco | 6367550-5 | 9.5 |  |  | Tyco/C_6367550_A2.pdf | N/A |  | Connector
4 | Tyco | 6367555-1 | 9.5 |  |  | Tyco/C_6367555_A.pdf | N/A |  | Connector
5 | Tyco | 1888669-1 | 21 |  |  | Tyco/C_1888669_A.pdf |  |  | Connector
6 | Tyco | 1775802-1 | 23 |  |  | Tyco/ENG_CD_1775802_F.tif |  |  | Connector
7 | Samtec | QSH-040-01-F-D-DP-A-K |  |  |  |  |  |  | Connector
8 | Samsung | K7S3218T4C | 1.4 |  |  | Samsung/ds_k7s32xxt4c_rev11.pdf | ISSI |  | Digital
9 | Sun Power | SPX-6200A1 |  |  |  | ../equipment/Sun Power/2 1u-2u-ac-spx-6200a1&p1.pdf
10
11
12
13
14
15
16
17
18
19
20
21
22
23
24
25
26
27
28
29
30
31
