ska-sa/roach1_hardware/roach/roach_top-preliminary partslist-2007-09-25.xls

# | QTY | REFDES | DESCRIPTION | MANUFACTURER | PARTNO | VALUE
1 | 9 | C1-3,C24-27,C187-188 |  | KEMET | KEM: C0402C103K3RAC | .01UF
2 | 13 | C4-9,C30-32,C189-192 |  | AVX | AVX: 1210YD226KAT2A | 22UF
3 | 160 | C10-23,C34-146,C195-197,C308,C341-346,C378-381,C387-405 |  | VENKEL | VEN: C0402X7R160-104KN | 0.1UF
4 | 2 | C28-29 |  | AVX | AVX: 04023C101KAT2A | 100PF
5 | 3 | C33,C193-194 |  | AVX | AVX: TPSD227K010R0050 | 220UF
6 | 20 | C147-158,C198-205 |  | AVX | AVX: TPSB107K006R | 100UF
7 | 8 | C159-164,C207-208 |  | AVX | AVX: TPSD337K004R0035 | 330UF
8 | 5 | C165-169 |  | AVX | AVX: 08056D106KAT2A | 10UF
9 | 4 | C170-173 |  | AVX | AVX: 04023C471KAT2A | 470PF
10 | 5 | C174-178 |  | AVX | AVX: 04023C221KAT2A | 220PF
11 | 5 | C179-180,C209-210,C351 |  | AVX | AVX: 08053C225KAT2A | 2.2UF
12 | 2 | C181-182 |  | KEMET | KEM: C0805C105K4RAC | 1UF
13 | 4 | C183-186 |  | AVX | AVX: 0805ZD475KAT2A | 4.7UF
14 | 1 | C206 |  | AVX | AVX: TPSC106M025R0500 | 10UF
15 | 128 | C211-212,C220-222,C231-242,C253-265,C276,C486-489,C502-505,C518-526,C528-545,C568,C570-573,C581-583,C591-638,C648-653 | CERAMIC CHIP CAPACITOR - 0402 | PANASONIC | ECJ-0EB0J224K | 220NF
16 | 2 | C213,C309 |  | KEMET | C0805C153J5RAC | 2U2
17 | 65 | C214-217,C310-316,C318,C320,C322,C324,C326,C328-329,C333-334,C336-337,C356-357,C366-375,C455,C457-458,C461-463,C465,C467-468,C471-476,C480-482,C527,C552-559,C574-577 | CERAMIC CHIP CAPACITOR - 0402 | MURATA | GRM155R71E103KAO1B | 10NF
18 | 55 | C218,C297-307,C317,C319,C321,C323,C325,C327,C330-332,C335,C353-355,C358-365,C376-377,C456,C459-460,C464,C466,C469-470,C477-479,C492,C494,C497-498,C506,C508,C511-512,C560,C578 | CERAMIC CHIP CAPACITOR - 0402 | MURATA | GRM155R71A104KAO1B | 100NF
19 | 26 | C219,C223-224,C490-491,C500-501,C514-517,C546-551,C569,C579-580,C584,C589-590,C654-656 |  | KEMET | T520B476M006ATE070 | 47UF
20 | 4 | C225,C383,C564,C585 |  | MURATA | GRM21BR61E475KA12K | 4U7F
21 | 12 | C226-228,C384-386,C565-567,C586-588 |  | MURATA | GRM32DR61C106KA01K | 10UF
22 | 4 | C229-230,C406-407 |  | MURATA | GRM32ER61C226KE20 | 22UF
23 | 10 | C243-252 | CERAMIC CHIP CAPACITOR - 0402 | MURATA | GRM155R71E103KAO1B | 10NF
24 | 8 | C266,C268-274 |  | MURATA | GRM155R60J103KA01J | 10NF
25 | 2 | C267,C275 |  | MURATA | GRM155R60J104KA01J | 100NF
26 | 2 | C277-278 |  | MURATA | GRM21BR61C475KA88 | 4.7UF
27 | 3 | C279-281 |  | MURATA | GRM188R61E105KA12J | 1UF
28 | 6 | C282-287 |  | MURATA | GRM32DR61C106KA01K | 10UF
29 | 3 | C288-290 |  | KEMET | C0805C153J5RAC | 15NF
30 | 3 | C291-293 |  | KEMET | T530X337M010ATE006 | 330UF
31 | 3 | C294-296 |  | KEMET | T530X108M2R5ASE005 | 1000UF
32 | 6 | C338-340,C483-485 |  | MURATA | GRM32ER61C226KE20 | 22UF
33 | 4 | C347-350 |  | AVX | AVX: 04023A180KAT2A | 18PF
34 | 1 | C352 |  |  | KEM: C0402C103K3RAC | .01UF
35 | 4 | C382,C561-563 | CERAMIC CHIP CAPACITOR - 0402 | MURATA | GRM1555C1H5R0CZ01B | 5PF
36 | 2 | C408-409 |  | MURATA | GRM21BR61C475KA88 | 4.7UF
37 | 25 | C410-421,C432-443,C454 | CERAMIC CHIP CAPACITOR - 0402 | PANASONIC | ECJ-0EB0J224K | 220NF
38 | 10 | C422-431 | CERAMIC CHIP CAPACITOR - 0402 | MURATA | GRM155R71E103KAO1B | 10NF
39 | 2 | C444,C453 |  | MURATA | GRM155R60J104KA01J | 100NF
40 | 8 | C445-452 |  | MURATA | GRM155R60J103KA01J | 10NF
41 | 3 | C493,C495-496 | CERAMIC CHIP CAPACITOR - 0402 | MURATA | GRM31BR71C105KA01B | 1UF
42 | 1 | C499 | CERAMIC CHIP CAPACITOR - 0402 |  | GRM31BR71C105KA01B | 1UF
43 | 3 | C507,C509-510 | CERAMIC CHIP CAPACITOR - 0402 | MURATA | GRM31BR71C105KA01B | 1UF
44 | 1 | C513 | CERAMIC CHIP CAPACITOR - 0402 |  | GRM31BR71C105KA01B | 1UF
45 | 6 | C639-644 |  | KEMET | T520V337M2R5ATE025 | 330UF
46 | 3 | C645-647 |  | KEMET | T520B336M006ATE040 | 33UF
47 | 52 | CP1-52 | CAPACITOR,CHIP ARRAY,0.5MM PITCH,8 PIN,1.25MM L X 2.00MM W X 1.00MM H | MURATA | GNM214B11C104MA01B | 100NF
48 | 4 | CR1-4 |  | FAIRCHILD | FAI: QTLP630C-4 | GRN
49 | 2 | CR5-6 |  | FAIRCHILD | FAI: QTLP630C-2 | RED
50 | 4 | D1-2,D7-8 |  | AGILENT TECHNOLOGIES | HSMS-C150 | OPTICAL MODULE FAULT - RED LED
51 | 2 | D3,D10 |  | AGILENT TECHNOLOGIES | HSMS-C150 | DUPLEX LED
52 | 2 | D4,D11 |  | AGILENT TECHNOLOGIES | HSMS-C150 | L10 LED
53 | 2 | D5,D9 |  | AGILENT TECHNOLOGIES | HSMS-C150 | L100 LED
54 | 1 | D6 |  | VISHAY | VIS: BAV70-V | BAV70
55 | 1 | F1 |  | TYCO ELECTRONICS | RAY: MICROSMD010F | 100MA
56 | 51 | FB1-51 |  | TDK | MPZ1608S221A | 220@100M
57 | 1 | FH1 |  |  | NA | 8A HOLDER
58 | 2 | FH2,FH5 |  | LITTELFUSE | 154005 | 5A HOLDER
59 | 9 | H1-9 |  |  | NA
60 | 2 | J1-2 |  | MOLEX | 87832-1420
61 | 1 | J3 |  | AMPHENOL | GMMC001LEU
62 | 2 | J4,J8 | RJ45, INTEGRATED MAGNETICS, 2 LEDS | HALO | HFJ11-1G02E-L12
63 | 1 | J5 |  | TYCO ELECTRONICS | AMP: 5767054-1 | .25IN F SMT
64 | 2 | J6,J9 |  | MOLEX | 879160001
65 | 1 | J7 |  | SAMTEC | HLE-105-02-G-DV
66 | 30 | JP1,JP5-18,JP24-37,JP40 | 3 WAY JUMPER | N/A | JP3
67 | 8 | JP2-4,JP21-23,JP38-39 | STANDARD JUMPER | N/A | JP2
68 | 2 | JP19-20 | STANDARD JUMPER
69 | 6 | L1-6 |  | MURATA | MUR: BLM18PG181SN1X | 180OHM 1.5A
70 | 2 | L7-8 |  | VISHAY | IHLP-2525CZ-01-1R5-M-01 | 1.5UH
71 | 4 | L9-12 |  | MURATA | MUR: BLM21B601SPT | 600OHM 200MA
72 | 1 | P1 |  | TYCO ELECTRONICS | 5145154-4 | 32-BIT
73 | 5 | P2-4,P9-10 |  | SAMTEC | SAM: TSM-102-01-TM-SV | 0.1IN M SMT
74 | 1 | P5 |  | SAMTEC | SAM: TSM-102-01-TM-DV | .1IN M SMT
75 | 1 | P6 | FUJITSU 2X2 CX4 CONNECTOR MODULE | FUJITSU | FCN-268F036-G/3DB
76 | 1 | P7 |  | SAMTEC | SAM: TSM-108-01-TM-DV-P | .1IN M SMT
77 | 1 | P8 |  | NORCOMP | NOR: 182-009-112-171 | 9P DSUB MALE
78 | 2 | P11-12 |  | SAMTEC | SAM: TSM-105-01-TM-SV | 0.1IN M SMT
79 | 2 | P13,P15 |  | TYCO ELECTRONICS | 6367550-5 | ZDOK40
80 | 1 | P14 |  | TYCO ELECTRONICS | AMP: 292304-1 | F TH
81 | 1 | P16 |  | SAMTEC | QSH-040-01-L-D-DP-A-K
82 | 1 | PTC1 |  | LITTELFUSE | 1206L050-C | 500MA
83 | 2 | Q1-2 |  | VISHAY | VIS: SI7540DP-E3 | SI7540DP
84 | 30 | R1-27,R193-195 |  | YAGEO-PHYCOMP | YAE: 9C04021A4991FKPF3 | 4.99K, 1%
85 | 1 | R28 |  | YAGEO-PHYCOMP | YAE: 9C04021A75R0JEPF3 | 75
86 | 7 | R29-30,R141,R191-192,R285-286 |  | YAGEO-PHYCOMP | YAE: 9C04021A1502JEPF3 | 15K
87 | 1 | R31 |  | YAGEO-PHYCOMP | YAE: 9C08052A10R0JEPF3 | 10
88 | 3 | R32-33,R41 |  | YAGEO-PHYCOMP | YAE: 9C04021A3322FKPF3 | 33.2K, 1%
89 | 5 | R34-36,R44-45 |  | YAGEO-PHYCOMP | YAE: 9C04021A2212FKPF3 | 22.1K, 1%
90 | 1 | R37 |  | YAGEO-PHYCOMP | YAE: 9C04021A4422FKPF3 | 44.2K, 1%
91 | 1 | R38 |  | YAGEO-PHYCOMP | YAE: 9C04021A1200JEPF3 | 120, 1%
92 | 1 | R39 |  | YAGEO-PHYCOMP | YAE: RC0402FR-071K96L | 1.96K, 1%
93 | 1 | R40 |  | YAGEO-PHYCOMP | YAE: RC0402FR-073K16L | 3.16K, 1%
94 | 1 | R42 |  | YAGEO-PHYCOMP | YAE: RC0402FR-071K33L | 1.33K, 1%
95 | 1 | R43 |  | YAGEO-PHYCOMP | YAE: 9C04021A1103FKPF3 | 110K, 1%
96 | 4 | R46-47,R82-83 |  | PHILIPS | 2322 705 70102 | 1K
97 | 14 | R48-51,R99,R185-188,R259,R294-297 |  | ROYAL OHM | 0402WGF0472T1E | 4K7
98 | 22 | R52-53,R117-124,R248-255,R292-293,R304-305 |  | ROYAL OHM | 0402WGF499JT1E | 49.9R
99 | 8 | R54-55,R189-190,R298-299,R306-307 |  | ROYAL OHM | 0402WGJ0104T1E | 10K
100 | 2 | R56,R308 |  | ROYAL OHM | 0402WGF0271TIE | 270R
101 | 1 | R57 |  | ROYAL OHM | 0402WGF499JT1E | 49.9R
102 | 4 | R58-59,R65,R67 |  | BOURNS | CR0402-FX-3901GLF | 3K9
103 | 2 | R60,R66 |  | BOURNS | CR0402-FX-3901GLF | 6K8
104 | 2 | R61,R64 |  | ROYAL OHM | 0402WGF0151T1E | 150R
105 | 3 | R62-63,R68 |  | ROYAL OHM | 0402WGF0103T1E | 10K
106 | 2 | R69-70 |  | BOURNS | CR0402-FX-5101GLF | 5K1
107 | 2 | R71-72 |  | BOURNS | CR0402-FX-1002GLF | 10K
108 | 3 | R73,R78-79 |  | BOURNS | CR0402-FX-1003GLF | 100K
109 | 3 | R74,R77,R80 |  | BOURNS | CR0402-FX-3601GLF | 3K6
110 | 3 | R75-76,R81 |  | BOURNS | CR0402-FX-1801GLF | 1K8
111 | 14 | R84-90,R167-171,R196-197 |  | YAGEO-PHYCOMP | YAE: 9C04021A1002JEPF3 | 10K
112 | 7 | R91-96,R184 |  | YAGEO-PHYCOMP | YAE: 9C04021A180RJEPF3 | 180
113 | 25 | R97-98,R100,R102-105,R135-140,R239-240,R270-279 |  | ROYAL OHM | 0402WGF0220T1E | 22R
114 | 2 | R101,R280 |  | ROYAL OHM | 0402WGF0472T1E | 4.7K
115 | 24 | R106,R108,R110,R112,R115,R127-129,R131-134,R242,R246,R258,R260-266,R268-269 |  | ROYAL OHM | 0402WGF0222T1E | 2K2
116 | 10 | R107,R109,R111,R113-114,R241,R243-245,R267 |  | ROYAL OHM | 0402WGF0331T1E | 330R
117 | 2 | R116,R247 |  | ROYAL OHM | 0402WGF9761T1E | 9K76
118 | 2 | R125,R257 |  | ROYAL OHM | 0402WGF0100T1E | 10
119 | 2 | R126,R256 |  | ROYAL OHM | 0402WGF0180T1E | 18
120 | 1 | R130 |  | ROYAL OHM | 0402WGF0102T1E | 1K
121 | 13 | R142-154 |  | YAGEO-PHYCOMP | YAE: 9C04021A0R00JEPF3 | 0
122 | 12 | R155-166 |  | YAGEO-PHYCOMP | YAE: 9C04021A33R0JEPF3 | 33
123 | 6 | R172-174,R198-200 |  | YAGEO-PHYCOMP | YAE: 9C04021A1001JEPF3 | 1K
124 | 32 | R175-183,R201-223 |  | YAGEO-PHYCOMP | YAE: 9C04021A3301JEPF3 | 3.3K
125 | 2 | R224,R237 |  | BOURNS | CR0402-FX-1002GLF | 10K
126 | 4 | R225,R227,R234,R236 |  | BOURNS | CR0402-FX-3901GLF | 3K9
127 | 2 | R226,R235 |  | BOURNS | CR0402-FX-3901GLF | 6K8
128 | 2 | R228,R233 |  | BOURNS | CR0402-FX-5101GLF | 5K1
129 | 2 | R229,R232 |  | ROYAL OHM | 0402WGF0151T1E | 150R
130 | 3 | R230-231,R238 |  | ROYAL OHM | 0402WGF0103T1E | 10K
131 | 12 | R281-284,R288-291,R300-303 |  | ROYAL OHM | 0402WGF0101T1E | 100R
132 | 1 | R287 |  | PANASONIC | PAN: ERJ-2RKF3401X | 3.40K, 1%
133 | 3 | RO1-3 |  | YAGEO-PHYCOMP | YAE: 9C06031A0R00JEPF3 | 0
134 | 4 | RO4,RO15-17 |  | YAGEO-PHYCOMP | YAE: 9C04021A0R00JEPF3 | 0
135 | 2 | RO5-6 |  | YAGEO-PHYCOMP | YAE: RC1206JR-070RL | 0
136 | 3 | RO7-9 |  | YAGEO-PHYCOMP | YAE: 9C04021A1002JEPF3 | 10K
137 | 5 | RO10-14 |  | YAGEO-PHYCOMP | YAE: 9C04021A1001JEPF3 | 1K
138 | 1 | RO18 |  | YAGEO-PHYCOMP | YAE: 9C04021A0R00JEPF3 | 0
139 | 24 | RP1-12,RP27-38 |  | ROYAL OHM | 4D02WGJ0510T | 51R
140 | 14 | RP13-26 |  | ROYAL OHM | 4D02WGJ0510B1E | 49.9R
141 | 1 | SP1 |  | LITTELFUSE | LIT: PGB102ST23WR | PGB102ST23WR
142 | 1 | SW1 |  | OMRON | OMR: A6S-4101 | SW4P
143 | 2 | SW2-3 |  | OMRON | A6S-4101-H | 4POLE
144 | 1 | SW4 |  | ITT CANNON | KT11B2SAM3-LFS | SPST
145 | 1 | TP1 |  |  | NA | TEST POINT
146 | 3 | TP2-4 | TEST POINT |  | N/A
147 | 1 | U1 |  | AMCC | PPC440EPX-NTA533T | 440EPX
148 | 1 | U2 |  | LINEAR TECHNOLOGY | LIN: LTC3736EUF#PBF | LTC3736EUF
149 | 1 | U3 |  | TEXAS INSTRUMENTS | TI: TPS51100DGQG4 | TPS51100
150 | 1 | U4 |  | TEXAS INSTRUMENTS | TI: PTN04050AAZ | PTN04050AAZ
151 | 2 | U5-6 |  | MICROCHIP | MIP: MCP1726-ADJ2E/MF | MCP1726
152 | 1 | U7 |  | TEXAS INSTRUMENTS | TI: PTN04050CAZ | PTN04050CAZ
153 | 1 | U8 |  | TYCO ELECTRONICS | TYC: AXH016A0X3 | AXH016A0X3
154 | 1 | U9 |  | XILINX | XC5VSX95T
155 | 4 | U10,U27,U48-49 |  | TEXAS INSTRUMENTS | TPS51100DGQ | TPS51100DGQ
156 | 2 | U11,U50 | QDRII+ X18 CONFIGURATION | SAMSUNG | K7S3218T4C-FC40
157 | 4 | U12-13,U41-42 |  | TEXAS INSTRUMENTS | TPS2031D
158 | 2 | U14,U43 |  | MAXIM | MAX9032AKA
159 | 2 | U15,U44 |  | MAXIM | MAX9032AKA
160 | 4 | U16-17,U45-46 |  | TEXAS INSTRUMENTS | SN74AHC1G08DCKR
161 | 3 | U18-20 |  | TEXAS INSTRUMENTS | TPS74401RGWT | TPS74401RGWT
162 | 1 | U21 |  | TEXAS INSTRUMENTS | TI: SN74LVC1G08DCKR | 74LVC1G08
163 | 1 | U22 |  | XILINX | XC2C256_7VQ100C
164 | 2 | U23,U47 |  | NATIONAL | DP83865DVH
165 | 1 | U24 |  | CYPRESS | CYP: CY22381FXI_0211P2 | CY22381FX_0211
166 | 1 | U25 |  |  | MIC2774N-29YMS | MIC2774N-29
167 | 1 | U26 |  |  | NA | CY2292FZX_0211
168 | 3 | U28-30 |  | ATMEL | ATM: AT24C04U3-10UU-1.8 | AT24C04
169 | 1 | U31 |  |  | ANA: AD7414ARTZ-0 | AD7414-0
170 | 1 | U32 |  | SPANSION | SPA: S29GL512N11FFI010 | 32MX16 MIRROR BIT
171 | 2 | U33-34 |  | INTERSIL | INS: ICL3225EIAZ | ICL3225ECA
172 | 6 | U35-40 |  | PERICOM | PER: PI5A3157ZAEX | PI5A3157
173 | 2 | VR1-2 |  | LITTELFUSE | LIF: V5.5MLA0603XXX | 5.5V 20A
174 | 2 | X1-2 |  | CRYSTEK | CCLD-023-25-156.250 | 156.25MHZ
175 | 1 | Y1 |  | CITIZEN | CIT: CS10-12.000MAGJ-UT | 12.00 MHZ
176 | 1 | Y2 |  | CITIZEN | CIT: CS10-22.1184MAGJ-UT | 22.1184MHZ
