ska-sa/roach1_hardware/roach/roach1.01review/ROACH+V1.0.ods

Id | Project | Reporter | Assigned To | Priority | Severity | Reproducibility | Product Version | Projection | Category | Date Submitted | ETA | OS | OS Version | Platform | View Status | Updated | Summary | Status | Resolution | Fixed in Version | Duplicate ID
106 | ROACH V1.0 | francois | francois | normal | feature | always |  | none |  | 08/05/28 | none |  |  |  | public | 08/06/03 | Request for POR on Actel | resolved | fixed |  | 0
15 | ROACH V1.0 | alec | francois | normal | major | have not tried |  | none |  | 08/05/07 | none |  |  |  | public | 08/06/03 | Add extra chip select from PPC to FPGA | resolved | fixed |  | 0
107 | ROACH V1.0 | francois | francois | normal | tweak | always |  | none |  | 08/05/30 | none |  |  |  | public | 08/06/03 | Request for PERCLK to move to global clock net pin | resolved | fixed |  | 0
109 | ROACH V1.0 | francois | francois | high | minor | always |  | none |  | 08/06/03 | none |  |  |  | public | 08/06/03 | DDR DIMM SDA and SCLK not connected to I2C bus | resolved | fixed |  | 0
105 | ROACH V1.0 | francois | francois | normal | minor | always |  | none |  | 08/05/28 | none |  |  |  | public | 08/05/30 | Connectors populated with revere polarity SMA's | resolved | fixed |  | 0
14 | ROACH V1.0 | alec | francois | normal | minor | have not tried |  | none |  | 08/05/07 | none |  |  |  | public | 08/05/30 | Add fiducials at all BGA packages (including U17, U63) and for PCB | resolved | fixed |  | 0
25 | ROACH V1.0 | francois | francois | high | minor | sometimes |  | none |  | 08/05/20 | none |  |  |  | public | 08/05/30 | U6 and U7 misbehaving | resolved | fixed |  | 0
108 | ROACH V1.0 | francois | francois | normal | tweak | always |  | none |  | 08/05/30 | none |  |  |  | public | 08/05/30 | Config Mode pins have possibility to cause clash on CPLD output pins | resolved | fixed |  | 0
13 | ROACH V1.0 | alec | francois | normal | major | have not tried |  | none |  | 08/05/07 | none |  |  |  | public | 08/05/28 | Tracks too close to mounting holes | resolved | fixed |  | 0
1 | ROACH V1.0 | alec | francois | normal | minor | have not tried |  | none |  | 08/05/06 | none |  |  |  | public | 08/05/28 | LED's CR1 - CR10: Incorrect package fitted to board | resolved | fixed |  | 0
2 | ROACH V1.0 | alec | francois | normal | minor | have not tried |  | none |  | 08/05/06 | none |  |  |  | public | 08/05/28 | LED's CR1-10 are fitted the wrong way round. | resolved | fixed |  | 0
23 | ROACH V1.0 | alec | francois | normal | minor | have not tried |  | none |  | 08/05/08 | none |  |  |  | public | 08/05/28 | DDR2 socket clips (J15) fouls on ZDOK connector (P7), J15 must be moved. | resolved | fixed |  | 0
24 | ROACH V1.0 | francois | francois | immediate | block | have not tried |  | none |  | 08/05/12 | none |  |  |  | public | 08/05/28 | 10GbE Rx lines shorted | resolved | fixed |  | 0
16 | ROACH V1.0 | alec | francois | normal | major | have not tried |  | none |  | 08/05/07 | none |  |  |  | public | 08/05/09 | Clean up IIC - can remove U38, U39, U47 | resolved | fixed |  | 0
12 | ROACH V1.0 | alec | francois | normal | major | have not tried |  | none |  | 08/05/07 | none |  |  |  | public | 08/05/09 | J24 and J22 mirrored | resolved | fixed |  | 0
11 | ROACH V1.0 | alec | francois | normal | minor | have not tried |  | none |  | 08/05/07 | none |  |  |  | public | 08/05/08 | BGA vias are not covered | acknowledged | open |  | 0
10 | ROACH V1.0 | alec | francois | normal | minor | have not tried |  | none |  | 08/05/07 | none |  |  |  | public | 08/05/08 | Pullup resistor needed on Virtex-5 done pin | resolved | fixed |  | 0
7 | ROACH V1.0 | alec | francois | normal | major | have not tried |  | none |  | 08/05/07 | none |  |  |  | public | 08/05/08 | Following 0402 caps are fitted to 0805 pads | resolved | fixed |  | 0
6 | ROACH V1.0 | alec | francois | normal | major | have not tried |  | none |  | 08/05/07 | none |  |  |  | public | 08/05/08 | R292 & R296 footprint is too small | resolved | no change required |  | 0
9 | ROACH V1.0 | alec | francois | normal | minor | have not tried |  | none |  | 08/05/07 | none |  |  |  | public | 08/05/08 | R88 & R89 missing | resolved | no change required |  | 0
5 | ROACH V1.0 | alec | francois | normal | minor | have not tried |  | none |  | 08/05/07 | none |  |  |  | public | 08/05/08 | R41 missing | resolved | no change required |  | 0
4 | ROACH V1.0 | alec | francois | normal | major | have not tried |  | none |  | 08/05/06 | none |  |  |  | public | 08/05/08 | U45-48 incorrect footprints | resolved | fixed |  | 0
3 | ROACH V1.0 | alec | francois | normal | major | have not tried |  | none |  | 08/05/06 | none |  |  |  | public | 08/05/08 | U31 - Incorrect footprint | resolved | fixed |  | 0
17 | ROACH V1.0 | alec | francois | normal | minor | have not tried |  | none |  | 08/05/07 | none |  |  |  | public | 08/05/08 | Add orientation marks for U55-U59 - enable top-outlines in gerber generation | resolved | fixed |  | 0
18 | ROACH V1.0 | alec | francois | normal | major | have not tried |  | none |  | 08/05/07 | none |  |  |  | public | 08/05/08 | Correct ZDOK footprint | resolved | fixed |  | 0
19 | ROACH V1.0 | alec | francois | normal | major | have not tried |  | none |  | 08/05/07 | none |  |  |  | public | 08/05/08 | Correct U50 footprint (hole size) | resolved | fixed |  | 0
20 | ROACH V1.0 | alec | francois | normal | minor | have not tried |  | none |  | 08/05/07 | none |  |  |  | public | 08/05/08 | Correct J32 pin 1 indicator off board | resolved | fixed |  | 0
21 | ROACH V1.0 | alec | francois | normal | minor | have not tried |  | none |  | 08/05/07 | none |  |  |  | public | 08/05/08 | Correct U25 part number - should be ADR03ARZ | resolved | fixed |  | 0
22 | ROACH V1.0 | alec | francois | normal | minor | have not tried |  | none |  | 08/05/07 | none |  |  |  | public | 08/05/08 | Check SMAs - J10 and J11 for mounting - 90 degree possible depending on mated connector height | resolved | no change required |  | 0
