ska-sa/roach1_hardware/BaseProjects/Sequoia/Des0211_11_BOM_R_14.pdf

Embedded Planet, LLC.

# 4760 Richmond Road, Suite 400 Warrensville Heights, OH 44128

216-245-4180

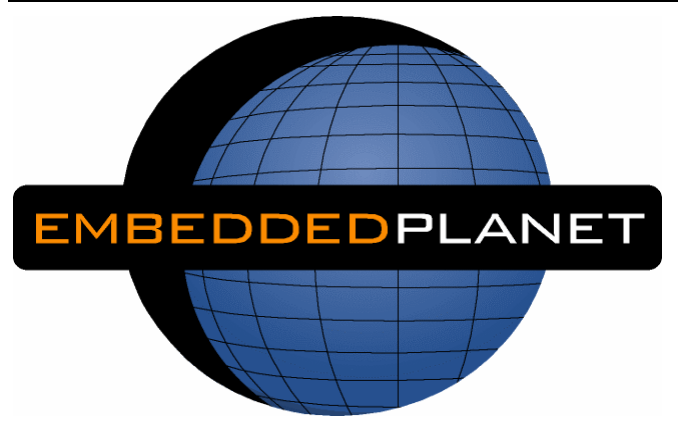
[picture p27: figure]

# Document Revision History

Date | Description | Author | Version
21-Nov-2006 | Initial Release to Production | D. Thorndike | 10
10-Jan-2007 | Added an additional jumper for J2 | D. Thorndike | 11
22-Mar-2007 | Added BOM Option items for 667MHz processors | D. Thorndike | 12
25-Apr-2007 | Chgd prog. clock U9, providing 33.333MHz rather than 33.0MHz | D. Thorndike | 13
18-May-2007 | Chgd p/n for CPLD, U25, to Pre-Prog'd part | D. Thorndike | 14

# Sign-Off

Signature | Date
Marketing | o
Operations | ˝
Purchasing | ˝
Engineering | ˝
Customer | o

# Distribution

CEO | o
Admin | o
Engineering | o
Marketing | o
Operations | o
Purchasing | o

# Form 700D0105R01

Embedded Planet | DES0211_11 | Bill of Materials (BOM)
18-May-2007 Date: | Document Version: 14 | D. Thorndike Prepared by:

# BASE BOARD - RoHS

Embedded Planet Confidential – Do not copy or reproduce without expressed written consent of Embedded Planet, LLC.

Option | Designator | Function
Option 1 (Processor) | 440EPx533 | PPC440EPx @ 533MHz Core w/ Security Feature
| 440EPx667 | PPC440EPx @ 667MHz Core w/ Security Feature
| 440GRx533 | PPC440EPx @ 533MHz Core w/ Security Feature
| 440GRx667 | PPC440GRx @ 667MHz Core w/ Security Feature
D | 256MBytes
Option 3 (FLASH) | 32 | 32MBytes
| 64 | 64MBytes
A | 32MBytes
Option 5 (EBC Connector) | N | No Pop EBC Bus Expansion Connector
| E | Populate EBC Bus Expansion Connector
P | Populate +12V & -12V Power Modules and related parts for PCI Option 6 (+/-12V Power)

# Option 4 (NAND FLASH)

# Option List

# Option 2 (DDR2 SDRAM)

Item | EP# | EPI# | GRN | Qty | Reference Designators | MAS90 Reference Designators | Part Value | Description | PCB Footprint | MFG #1 | MFG #2 | MFGI #1 | MFGI #2 | Notes
1 | P10100000000015 | P10100000000015 | LHR | 4 | C48,C49,C51,C52 | C48:49,51:52; | 18pF | CAP_18PF_0402_25V_10%_COG | C_0402_IPC | AVX: 04023A180KAT2A | KEM: C0402C180K3GAC | AVX: 04023A180KAT2A | KEM: C0402C180K3GAC
2 | P10100000000028 | P10100000000028 | LHR | 23 | CC1,CC2,CC3,CC4,CC5,CC6, | CC1:23; | 24pF | CAP_24PF_0402_25V_10%_COG | C_0402_IPC | AVX: 04023A240KAT2A | KEM: C0402C240K3GAC | AVX: 04023A240KAT2A | KEM: C0402C240K3GAC
| | | | | CC7,CC8,CC9,CC10,CC11,
| | | | | CC12,CC13,CC14,CC15,CC16,
| | | | | CC17,CC18,CC19,CC20,CC21,
| | | | | CC22,CC23
3 | P10100000000004 | P10100000000004 | LHR | 3 | CE-1,CE-2,CE-5 | CE-1:2,5; | 100pF | CAP_100PF_0402_25V_10%_X7R | C_0402_IPC | AVX: 04023C101KAT2A | KEM: C0402C101K3RAC | AVX: 04023C101KAT2A | KEM: C0402C101K3RAC
4 | P10100000000025 | P10100000000025 | LHR | 5 | C14,C18,C19,C20,C31 | C14,18:20,31; | 220pF | CAP_220PF_0402_25V_10%_X7R | C_0402_IPC | AVX: 04023C221KAT2A | KEM: C0402C221K3RAC | AVX: 04023C221KAT2A | KEM: C0402C221K3RAC
5 | P10100000000034 | P10100000000034 | LHR | 4 | C1P-3,C1P-6,C1P-10,C1P-14 | C1P-3,6,10,14; | 470pF | CAP_470PF_0402_25V_10%_X7R | C_0402_IPC | AVX: 04023C471KAT2A | KEM: C0402C471K3RAC | AVX: 04023C471KAT2A | KEM: C0402C471K3RAC
6 | P10100000000017 | P10100000000017 | LHR | 7 | C33-1,C33-9,C34-1,C34-9, | C33-1,9,17;C34-1,9,17;C58; | 1000pF | CAP_1NF_0402_25V_10%_X7R | C_0402_IPC | AVX: 04023C102KAT2A | KEM: C0402C102K3RAC | AVX: 04023C102KAT2A | KEM: C0402C102K3RAC
| | | | | C33-17,C34-17,C58
7 | P10100000000020 | P10100000000020 | LHR | 2 | C178,C183 | C178,183; | 1000pF,2KV | CAP_1NF_1808_2KV_10%_X7R | C_1808_AVX | AVX: 1808GC102KAT2A | NOV: 1808B102K202NT | AVX: 1808GC102KAT2A | NOV: 1808B102K202NT
8 | P10100000000030 | P10100000000030 | LHR | 1 | C32-9 | C32-9; | 2200pF | CAP_2r2NF_0402_25V_10%_X7R | C_0402_IPC | AVX: 04023C222KAT2A | KEM: C0402C222K3RAC | AVX: 04023C222KAT2A | KEM: C0402C222K3RAC
9 | P10100000000008 | P10100000000008 | LHR | 35 | C1P-2,C1P-5,C1P-9,C61,C62,C63, | C1P-2,5,9,13;C61:63,84:86,170:173,184:187;C1-87;C11-11;C12-11;C13-11;C14-11;C33-2:3,10:11,18:19;C34-2:3,10:11,18:19; .01uF | | CAP_10NF_0402_25V_10%_X7R | C_0402_IPC | KEM: C0402C103K3RAC | VIS: VJ0402Y103KXX | KEM: C0402C103K3RAC | VIS: VJ0402Y103KXX
| | | | | C84,C85,C86,C1P-13,C173,C1-87,
| | | | | C11-11,C12-11,C13-11,C14-11,
| | | | | C33-10,C170,C171,C172,C184,
| | | | | C185,C186,C187,C33-2,C33-3,
| | | | | C34-2,C34-3,C33-11,C33-18,
| | | | | C33-19,C34-10,C34-11,C34-18,
| | | | | C34-19
10 | P10100000000001 | P10100000000001 | LHR | 280 | CVT-3,C3,CVT-4,C4,CVT-5, | CVT-3:14;C3:5,8:9,11,13,16,21:22,29:30,53:54,66:75,78:81,90:93,98:105,108:109,174:177,179:182,192:199,204:205;C1P-1,4,7:8,11:12;C1-1:86;C9-1;C10-1:2;C11-1:9;C12-1:9;C13-1:9;C14-1:9;C15-1:3;C16-1;C19-1;C20-1;C21-1;C22-1:2;C23-1;C24-1,3:9; 0.1uF | | CAP_100NF_0402_16V_10%_X7R | C_0402_IPC | VEN: C0402X7R160-104KN | NA | VEN: C0402X7R160-104KN | NA
| | | | | C5,CVT-6,CVT-7,CVT-8,C8, | C25-1:10;C26-1;C27-1;C28-1;C31-1;C32-1:7;C33-4:8,12:16,20:22;C34-4:8,12:16,20:22;C11-10;C12-10;C13-10;C14-10;C24-10:11;C35-1;C36-1;C37-1;C57,210,238;
| | | | | CVT-9,C9,CVT-10,CVT-11,
| | | | | C1P-1,C11,C1-1,CVT-12,
| | | | | C1-2,CVT-13,C13,C1-3,
| | | | | CVT-14,C1P-4,C1-4,C1-5,
| | | | | C16,C1-6,C1P-7,C1-7,
| | | | | C1P-8,C1-8,C1-9,C21,C22,
| | | | | C29,C30,C53,C54,C66,C67,
| | | | | C68,C69,C70,C71,C72,C73,
| | | | | C74,C75,C78,C79,C80,C81,
| | | | | C90,C91,C9-1,C92,C93,C98,
| | | | | C99,C100,C101,C10-1,C102,
| | | | | C10-2,C103,C104,C105,
| | | | | C108,C109,C1-10,C1P-11,
| | | | | C11-1,C1-11,C1P-12,C11-2,
| | | | | C1-12,C11-3,C1-13,C11-4,
| | | | | C1-14,C11-5,C1-15,C11-6,
| | | | | C1-16,C11-7,C1-17,C11-8,
| | | | | C1-18,C11-9,C1-19,C1-20,
| | | | | C12-1,C1-21,C12-2,C1-22,
| | | | | C12-3,C1-23,C12-4,C1-24,
| | | | | C12-5,C1-25,C12-6,C1-26,
| | | | | C12-7,C1-27,C12-8,C1-28,
| | | | | C12-9,C1-29,C1-30,C13-1,
| | | | | C1-31,C13-2,C1-32,C13-3,
| | | | | C1-33,C13-4,C1-34,C13-5,
| | | | | C1-35,C13-6,C1-36,C13-7,
| | | | | C1-37,C13-8,C1-38,C13-9,
| | | | | C1-39,C1-40,C14-1,C1-41,
| | | | | C14-2,C1-42,C14-3,C1-43,
| | | | | C14-4,C1-44,C14-5,C1-45,
| | | | | C14-6,C1-46,C14-7,C1-47,
| | | | | C14-8,C1-48,C14-9,C1-49,
| | | | | C1-50,C15-1,C1-51,C15-2,
| | | | | C1-52,C15-3,C1-53,C1-54,
| | | | | C1-55,C1-56,C1-57,C1-58,
| | | | | C1-59,C1-60,C16-1,C1-61,
| | | | | C1-62,C1-63,C1-64,C1-65,
| | | | | C1-66,C1-67,C1-68,C1-69,
| | | | | C1-70,C1-71,C1-72,C1-73,
| | | | | C174,C1-74,C175,C1-75,
| | | | | C176,C1-76,C177,C1-77,
| | | | | C1-78,C179,C1-79,C180,
| | | | | C1-80,C181,C1-81,C182,
| | | | | C1-82,C1-83,C1-84,C1-85,
| | | | | C1-86,C19-1,C192,C193,
| | | | | C194,C195,C196,C197,C198,
| | | | | C199,C20-1,C204,C205,
| | | | | C21-1,C22-1,C22-2,C23-1,
| | | | | C24-1,C24-3,C24-4,C24-5,
| | | | | C24-6,C24-7,C24-8,C24-9,
| | | | | C25-1,C25-2,C25-3,C25-4,
| | | | | C25-5,C25-6,C25-7,C25-8,
| | | | | C25-9,C26-1,C27-1,C28-1,
| | | | | C31-1,C32-1,C32-2,C32-3,
| | | | | C32-4,C32-5,C32-6,C32-7,
| | | | | C33-4,C33-5,C33-6,C33-7,
| | | | | C33-8,C34-4,C34-5,C34-6,
| | | | | C34-7,C34-8,C11-10,
| | | | | C12-10,C13-10,C14-10,
| | | | | C24-10,C24-11,C25-10,
| | | | | C33-12,C33-13,C33-14,
| | | | | C33-15,C33-16,C33-20,
| | | | | C33-21,C33-22,C34-12,
| | | | | C34-13,C34-14,C34-15,
| | | | | C34-16,C34-20,C34-21,
| | | | | C34-22,C35-1,C57,C210,C238,
| | | | | C36-1,C37-1
11 | P10100000000022 | P10100000000022 | LHR | 2 | C206,C211 | C206,211; | 1uF | CAP_1UF_0805_16V_10%_X7R | C_0805_IPC | KEM: C0805C105K4RAC | VEN: C0805X7R160-105KN | KEM: C0805C105K4RAC | VEN: C0805X7R160-105KN
12 | P10100000000031 | P10100000000031 | LHR | 5 | C7,C23,C47,C233,C236 | C7,23,47,233,236; | 2.2uF | CAP_2r2UF_0805_25V_10%_X7R | C_0805_IPC | AVX: 08053C225KAT2A | KEM: C0805C225K3RAC | AVX: 08053C225KAT2A | KEM: C0805C225K3RAC
13 | P10100000000039 | P10100000000039 | LHR | 4 | C228,C232,C235,C32-8 | C228,232,235;C32-8; | 4.7uF | CAP_4r7UF_0805_10V_10%_X5R | C_0805_IPC | AVX: 0805ZD475KAT2A | KEM: C0805C475K8PAC | AVX: 0805ZD475KAT2A | KEM: C0805C475K8PAC
14 | P10100000000011 | P10100000000011 | LHR | 5 | C24,C25,C26,C27,C28 | C24:28; | 10uF | CAP_10UF_0805_6r3V_10%_X5R | C_0805_IPC | AVX: 08056D106KAT2A | KEM: C0805C106K9PAC | AVX: 08056D106KAT2A | KEM: C0805C106K9PAC
15 | P10100000000045 | P10100000000045 | LHR | 1 | C207 | C207; | 10uF | CAPT_10UF_C6032_25V_20%_L0500 | CT_6032_IPC | AVX: TPSC106M025R0500 | KEM: T494C106M025AT | AVX: TPSC106M025R0500 | KEM: T494C106M025AT
16 | P10100000000027 | P10100000000027 | LHR | 20 | C2,C6,C32,C64,C65,C76,C77,C82, | C2,6,32,64:65,76:77,82:83,94:97,106:107,202:203,216;C24-2,12; 22uF | | CAP_22UF_1210_16V_10%_X5R | C_1210_IPC | AVX: 1210YD226KAT2A | KEM: C1210C226K4PAC | AVX: 1210YD226KAT2A | KEM: C1210C226K4PAC
| | | | | C83,C94,C95,C96,C97,C106,
| | | | | C107,C202,C203,C216,
| | | | | C24-2,C24-12
17 | P10100000000041 | P10100000000041 | LHR | 16 | CB-1,CB-2,CB-3,CB-4,CB-5, | CB-1:16; | 100uF | CAPT_100UF_3528_6r3V_10%_LXXXX | CT_3528_IPC | AVX: TPSB107K006R | KEM: T494B107K006ATH | AVX: TPSB107K006R | KEM: T494B107K006ATH
| | | | | CB-6,CB-7,CB-8,CB-9,
| | | | | CB-10,CB-11,CB-12,CB-13,
| | | | | CB-14,CB-15,CB-16
18 | P10100000000048 | P10100000000048 | LHR | 3 | C1,C200,C201 | C1,200:201; | 220uF | CAPT_220UF_D7343_10V_10%_L0050 | CT_7343_IPC | AVX: TPSD227K010R0050 | KEM: T494D227K010ATH | AVX: TPSD227K010R0050 | KEM: T494D227K010ATH
19 | P10100000000054 | P10100000000054 | LHR | 8 | CVT-1,CVT-2,C10,C12,C15, | CVT-1:2;C10,12,15,17,208:209; | 330uF | CAPT_330UF_D7343_4V_10%_L0035 | CT_7343_IPC | AVX: TPSD337K004R0035 | NEM: LSR330/4DK35 | AVX: TPSD337K004R0035 | NEM: LSR330/4DK35
| | | | | C17,C208,C209

Capacitors Base Board

20 | P11400000000000 | P11400000000000 | LHR | 13 | R10,R11,R12,R13,R14,R15, | R10:22; | 0 | RES_0_0402_5% | R_0402_IPC | YAE: 9C04021A0R00JEPF3 | BRN: CR0402J/000GLF | YAE: 9C04021A0R00JEPF3 | BRN: CR0402J/000GLF
| | | | | R16,R17,R18,R19,R20,R21,
| | | | | R22
20 | P11400000000000 | P11400000000000 | LHR | 3 | RO10,RO11,RO45 | RO10:11,45; | 0 | RES_0_0402_5%_OPT | R_0402_IPC | YAE: 9C04021A0R00JEPF3 | BRN: CR0402J/000GLF | YAE: 9C04021A0R00JEPF3 | BRN: CR0402J/000GLF
20 | P11400000000000 | P11400000000000 | LHR | 2 | RO39,RO40 | RO39:40 (1/2)+G200; | 0 | RES_0_0402_5%_OPT3P | R_0402_3P_IPC | YAE: 9C04021A0R00JEPF3 | BRN: CR0402J/0R1GLF | YAE: 9C04021A0R00JEPF3 | BRN: CR0402J/0R1GLF
21 | P11400000000176 | P11400000000176 | LHR | 23 | RDS1,RDS2,RDS3,RDS4,RDS5, | RDS1:23; | 3.3 | RES_3r3_0402_5% | R_0402_IPC | YAE: RC0402JR-073R3L | BRN: CR0402JW3R3GLF | YAE: RC0402JR-073R3L | BRN: CR0402JW3R3GLF
| | | | | RDS6,RDS7,RDS8,RDS9,
| | | | | RDS10,RDS11,RDS12,RDS13,
| | | | | RDS14,RDS15,RDS16,RDS17,
| | | | | RDS18,RDS19,RDS20,RDS21,
| | | | | RDS22,RDS23
22 | P11400000000009 | P11400000000009 | LHR | 1 | R1 | R1; | 10 | RES_10_0805_5% | R_0805_IPC | YAE: 9C08052A10R0JEPF3 | BRN: CR0805JE100GLF | YAE: 9C08052A10R0JEPF3 | BRN: CR0805JE100GLF
23 | P11400000000174 | P11400000000174 | LHR | 80 | RDS24,RDS25,RDS26,RDS27, | RDS24:103; | 22 | RES_22_0402_5% | R_0402_IPC | YAE: RC0402JR-0722RL | BRN: CR0402JW220GLF | YAE: RC0402JR-0722RL | BRN: CR0402JW220GLF
| | | | | RDS28,RDS29,RDS30,RDS31,
| | | | | RDS32,RDS33,RDS34,RDS35,
| | | | | RDS36,RDS37,RDS38,RDS39,
| | | | | RDS40,RDS41,RDS42,RDS43,
| | | | | RDS44,RDS45,RDS46,RDS47,
| | | | | RDS48,RDS49,RDS50,RDS51,
| | | | | RDS52,RDS53,RDS54,RDS55,
| | | | | RDS56,RDS57,RDS58,RDS59,
| | | | | RDS60,RDS61,RDS62,RDS63,
| | | | | RDS64,RDS65,RDS66,RDS67,
| | | | | RDS68,RDS69,RDS70,RDS71,
| | | | | RDS72,RDS73,RDS74,RDS75,
| | | | | RDS76,RDS77,RDS78,RDS79,
| | | | | RDS80,RDS81,RDS82,RDS83,
| | | | | RDS84,RDS85,RDS86,RDS87,
| | | | | RDS88,RDS89,RDS90,RDS91,
| | | | | RDS92,RDS93,RDS94,RDS95,
| | | | | RDS96,RDS97,RDS98,RDS99,
| | | | | RDS100,RDS101,RDS102,
| | | | | RDS103
24 | P11400000000076 | P11400000000076 | LHR | 25 | R90,R91,R92,R93,R94,R95, | R90:102,123:134; | 22.1, 1% | RES_22r1_0402_1% | R_0402_IPC | YAE: 9C04021A22R1FKPF3 | BRN: CR0402FK22R1GLF | YAE: 9C04021A22R1FKPF3 | BRN: CR0402FK22R1GLF
| | | | | R96,R97,R98,R99,R100,
| | | | | R101,R102,R123,R124,R125,
| | | | | R126,R127,R128,R129,R130,
| | | | | R131,R132,R133,R134
25 | P11400000000097 | P11400000000097 | LHR | 14 | RS-1,RS-2,RS-3,RS-4,RS-5, | RS-1:13;R26; | 33 | RES_33_0402_5% | R_0402_IPC | YAE: 9C04021A33R0JEPF3 | BRN: CR0402JE330GLF | YAE: 9C04021A33R0JEPF3 | BRN: CR0402JE330GLF
| | | | | RS-6,RS-7,RS-8,RS-9,R26
| | | | | RS-10,RS-11,RS-12,RS-13
26 | P11400000000111 | P11400000000111 | LHR | 23 | RDT1,RDT2,RDT3,RDT4,RDT5, | RDT1:23; | 47 | RES_47_0402_5% | R_0402_IPC | YAE: 9C04021A47R0JEPF3 | BRN: CR0402JE470GLF | YAE: 9C04021A47R0JEPF3 | BRN: CR0402JE470GLF
| | | | | RDT6,RDT7,RDT8,RDT9,
| | | | | RDT10,RDT11,RDT12,RDT13,
| | | | | RDT14,RDT15,RDT16,RDT17,
| | | | | RDT18,RDT19,RDT20,RDT21,
| | | | | RDT22,RDT23
27 | P11400000000119 | P11400000000119 | LHR | 16 | R103,R104,R105,R106,R107, | R103:110,135:142; | 49.9, 1% | RES_49r9_0402_1% | R_0402_IPC | YAE: 9C04021A49R9FKPF3 | BRN: CR0402FK49R9GLF | YAE: 9C04021A49R9FKPF3 | BRN: CR0402FK49R9GLF
| | | | | R108,R109,R110,R135,R136,
| | | | | R137,R138,R139,R140,R141,
| | | | | R142
28 | P11400000000151 | P11400000000151 | LHR | 10 | R111,R112,R113,R114,R143, | R111:114,143:146,178:179; | 75 | RES_75_0402_5% | R_0402_IPC | YAE: 9C04021A75R0JEPF3 | BRN: CR0402JE750GLF | YAE: 9C04021A75R0JEPF3 | BRN: CR0402JE750GLF
| | | | | R144,R145,R146,R178,R179
29 | P11400000000028 | P11400000000028 | LHR | 7 | R6,R43,R44,R45,R46,R47,R48 | R6,43:48; | 120, 1% | RES_120_0402_1% | R_0402_IPC | YAE: 9C04021A1200FxPF3 | BRN: CR0402FX1200GLF | YAE: 9C04021A1200FxPF3 | BRN: CR0402FX1200GLF
30 | P11400000000043 | P11400000000043 | LHR | 7 | R42,R197,R199,R200, | R42,197,199:203; | 180 | RES_180_0402_5% | R_0402_IPC | YAE: 9C04021A180RJEPF3 | BRN: CR0402JE181GLF | YAE: 9C04021A180RJEPF3 | BRN: CR0402JE181GLF
| | | | | R201,R202,R203
31 | P11400000000093 | P11400000000093 | LHR | 4 | R115,R116,R147,R148 | R115:116,147:148; | 300 | RES_300_0402_5% | R_0402_IPC | YAE: 9C04021A300RJEPF3 | BRN: CR0402JE301GLF | YAE: 9C04021A300RJEPF3 | BRN: CR0402JE301GLF
32 | P11400000000048 | P11400000000048 | LHR | 5 | R23,R24,R25,R83,R84 | R23:25,83:84; | 1K | RES_1K_0402_5% | R_0402_IPC | YAE: 9C04021A1001JEPF3 | BRN: CR0402JE102GLF | YAE: 9C04021A1001JEPF3 | BRN: CR0402JE102GLF
33 | P11400000000171 | P11400000000171 | LHR | 1 | RSET6 | RSET6; | 1.33K, 1% | RES_1r33K_0402_1% | R_0402_IPC | YAE: RC0402FR-071K33L | BRN: CR0402FX1331GLF | YAE: RC0402FR-071K33L | BRN: CR0402FX1331GLF
34 | P11400000000172 | P11400000000172 | LHR | 1 | RSET7 | RSET7; | 1.96K, 1% | RES_1r96K_0402_1% | R_0402_IPC | YAE: RC0402FR-071K96L | BRN: CR0402FX1961GLF | YAE: RC0402FR-071K96L | BRN: CR0402FX1961GLF
35 | P11400000000089 | P11400000000089 | LHR | 10 | R49,R50,R51,R52,R53,R54, | R49:58; | 2.7K | RES_2r7K_0402_5% | R_0402_IPC | YAE: 9C04021A2701JEPF3 | BRN: CR0402JE272GLF | YAE: 9C04021A2701JEPF3 | BRN: CR0402JE272GLF
| | | | | R55,R56,R57,R58
36 | P11400000000175 | P11400000000175 | LHR | 1 | RSET5 | RSET5; | 3.16K, 1% | RES_3r16K_0402_1% | R_0402_IPC | YAE: RC0402FR-073K16L | BRN: CR0402FX3161GLF | YAE: RC0402FR-073K16L | BRN: CR0402FX3161GLF
37 | P11400000000106 | P11400000000106 | LHR | 40 | R27,R28,R29,R30,R31,R32, | R7,27:35,60:82,117:118,180:181,204:206; 3.3K | | RES_3r3K_0402_5% | R_0402_IPC | YAE: 9C04021A3301JEPF3 | BRN: CR0402JE332GLF | YAE: 9C04021A3301JEPF3 | BRN: CR0402JE332GLF
| | | | | R33,R34,R35,R60,R61,R62,
| | | | | R63,R64,R65,R66,R67,R68,
| | | | | R69,R70,R71,R72,R73,R74,
| | | | | R75,R76,R77,R78,R79,R80,
| | | | | R81,R82,R117,R118,R180,
| | | | | R181,R204,R205,R206,R7
38 | P11400000000229 | P11400000000229 | LHR | 1 | R182 | R182; | 3.40K, 1% | RES_3r40K_0402_1% | R_0402_IPC | PAN: ERJ-2RKF3401X | YAE: RC0402FR-073K4L | PAN: ERJ-2RKF3401X | YAE: RC0402FR-073K4L
39 | P11400000000122 | P11400000000122 | LHR | 3 | R119,R120,R149 | R119:120,149; | 4.7K | RES_4r7K_0402_5% | R_0402_IPC | YAE: 9C04021A4701JEPF3 | BRN: CR0402JE472GLF | YAE: 9C04021A4701JEPF3 | BRN: CR0402JE472GLF
40 | P11400000000126 | P11400000000126 | LHR | 33 | RO6,RO7,RO8,R150,R151, | RO6:8;R121:122,150:177; | 4.99K, 1% | RES_4r99K_0402_1% | R_0402_IPC | YAE: 9C04021A4991FKPF3 | BRN: CR0402FK4991GLF | YAE: 9C04021A4991FKPF3 | BRN: CR0402FK4991GLF
| | | | | R152,R153,R154,R155,R156,
| | | | | R157,R158,R159,R160,R161,
| | | | | R162,R163,R164,R165,R166,
| | | | | R167,R168,R169,R170,R171,
| | | | | R172,R173,R174,R175,R176,
| | | | | R177,R121,R122
41 | P11400000000020 | P11400000000020 | LHR | 15 | R36,R37,R38,R39,R40,R59, | R36:40,59,86:87,190:196; | 10K | RES_10K_0402_5% | R_0402_IPC | YAE: 9C04021A1002JEPF3 | BRN: CR0402JE103GLF | YAE: 9C04021A1002JEPF3 | BRN: CR0402JE103GLF
| | | | | R86,R87,R190,R191,R192,
| | | | | R193,R194,R195,R196
41 | P11400000000020 | P11400000000020 | LHR | 3 | RO36,RO37,RO38 | RO36:38 (1/2); | 10K | RES_10K_0402_5%_OPT3P | R_0402_3P_IPC | YAE: 9C04021A1002JEPF3 | BRN: CR0402JE103GLF | YAE: 9C04021A1002JEPF3 | BRN: CR0402JE103GLF
42 | P11400000000030 | P11400000000030 | LHR | 1 | R187 | R187; | 12K, 1% | RES_12K_0402_1% | R_0402_IPC | YAE: 9C04021A1202FKPF3 | BRN: CR0402FK1202GLF | YAE: 9C04021A1202FKPF3 | BRN: CR0402FK1202GLF
43 | P11400000000038 | P11400000000038 | LHR | 9 | R3,R5,R88,R89,R41,R183,R184,R185,R186 R3,5,41,88:89,183:186; | | 15K | RES_15K_0402_5% | R_0402_IPC | YAE: 9C04021A1502JEPF3 | BRN: CR0402JE153GLF | YAE: 9C04021A1502JEPF3 | BRN: CR0402JE153GLF
44 | P11400000000077 | P11400000000077 | LHR | 5 | RSET2,R2,RSET4,RSET9, | RSET2,4,9,11;R2; | 22.1K, 1% | RES_22r1K_0402_1% | R_0402_IPC | YAE: 9C04021A2212FKPF3 | BRN: CR0402FK2212GLF | YAE: 9C04021A2212FKPF3 | BRN: CR0402FK2212GLF
| | | | | RSET11
45 | P11400000000103 | P11400000000103 | LHR | 3 | RSET3,R4,RSET8 | RSET3,8;R4; | 33.2K, 1% | RES_33r2K_0402_1% | R_0402_IPC | YAE: 9C04021A3322FKPF3 | BRN: CR0402FK3322GLF | YAE: 9C04021A3322FKPF3 | BRN: CR0402FK3322GLF
46 | P11400000000110 | P11400000000110 | LHR | 1 | RSET1 | RSET1; | 44.2K, 1% | RES_44r2K_0402_1% | R_0402_IPC | YAE: 9C04021A4422FKPF3 | BRN: CR0402FK4422GLF | YAE: 9C04021A4422FKPF3 | BRN: CR0402FK4422GLF
47 | P11400000000025 | P11400000000025 | LHR | 1 | RSET10 | RSET10; | 110K, 1% | RES_110K_0402_1% | R_0402_IPC | YAE: 9C04021A1103FKPF3 | BRN: CR0402FK1103GLF | YAE: 9C04021A1103FKPF3 | BRN: CR0402FK1103GLF
Item | EP# | EPI# | GRN | Qty | Reference Designators | MAS90 Reference Designators | Part Value | Description | PCB Footprint | MFG #1 | MFG #2 | MFGI #1 | MFGI #2 | Notes
48 | P10200000000027 | P10200000000027 | LHR | 1 | J1 | J1; | .25in F SMT | CON_MICTOR_2X19_F_VT_0r25_SMT | 767054-1 | AMP: 5767054-1 | NA | AMP: 5767054-1 | NA
49 | P10200000000017 | P10200000000017 | LHR | 1 | J3 | J3; | 0.1in M SMT | CON_HDR_2X2_M_VT_0r1_SMT | TSM_2X2_DV | SAM: TSM-102-01-TM-DV | NA | SAM: TSM-102-01-TM-DV | NA
50 | P10200000000010 | P10200000000010 | LHR | 7 | J2,J4,J5,J6,J7,J10,J11 | J2,4:7,10:11; | 0.1in M SMT | CON_HDR_1X2_M_VT_0r1_SMT | TSM_2X1_SV | SAM: TSM-102-01-TM-SV | MET: M650-H102-02-01G | SAM: TSM-102-01-TM-SV | MET: M650-H102-02-01G
51 | P12100000000002 | P12100000000002 | LHR | 6 | Jumpers for J2(pin 1 only),J3(x2),J4,J5 & J6 For J2(pin 1 only),3(x2),4:6 | | | HRDW_JUMPER_2r54MM_BLACK | | SAM: SNT-100-BK-G | NA | SAM: SNT-100-BK-G | NA
52 | P10200000000036 | P10200000000036 | LHR | 2 | J8,J9 | J8:9; | F TH | CON_RJ45_1X8_F_RA_TH_2BILEDYG | RJ45_8POS | AMP: 2-406549-8 | NA | AMP: 2-406549-8 (80C) | NA
53 | P10200000000033 | P10200000000034 | LHR | 1 | PWR-1 | PWR-1; | PJ-002AH-SMT | CON_PWR_4PIN_M_RA_SMT | PJ-002AH-SMT | CUI: PJ002AH-SMT | NA | KYC: KLDX-SMT2-0202-A (Rated for -25 to +85 C) NA
54 | P10200000000043 | NA | LHR | 1 | PWR-2 | PWR-2; | Term Block | CON_TERM_1X2_F_R_14AWG_15A_TH | 1935161_T | PHC: 1935161 (DIG: 277-1667-N) | WEI: 1696060000 (DIG: 281-1876-ND) NA | | NA
55 | P10200000000025 | P10200000000025 | LHR | 1 | P1 | P1; | .1in M SMT | CON_HDR_2X8_M_VT_0r1_SMT | TSM_8X2_DV | SAM: TSM-108-01-TM-DV-P | MET: M650-H208-02-01G | SAM: TSM-108-01-TM-DV-P | MET: M650-H208-02-01G
56 | P10200000000009 | P10200000000009 | LHR | 2 | P2,P3 | P2:3; | 9P DSUB MALE | CON_DSUB_9_M_RA_TH | 87203-6043 | NOR: 182-009-112-171 | MOL: 48202-6043 | NOR: 182-009-112-171 | MOL: 48202-6043
57 | P10200000000014 | P10200000000014 | LHR | 2 | P4,P11 | P4,11; | 0.1in M SMT | CON_HDR_1X5_M_VT_0r1_SMT | TSM_5X1_SV | SAM: TSM-105-01-TM-SV | MET: M650-H105-02-01G | SAM: TSM-105-01-TM-SV | MET: M650-H105-02-01G
58 | P10200000000028 | P10200000000028 | LHR | 2 | P8,P9 | P8:9; | 32-Bit | CON_PCI_F_VT_3r3V_KEY_32BIT | 145154-4 | AMP: 5145154-4 | MOL: 89177-6030 | AMP: 5145154-4 | MOL: 89177-6030
59 | P10200000000023 | P10200000000023 | LHR | 1 | P10 | P10; | 0.1in M SMT | CON_HDR_2X5_M_VT_0r1_SMT | TSM_5X2_DV | SAM: TSM-105-01-TM-DV-P | MET: M650-H205-02-01G | SAM: TSM-105-01-TM-DV-P | MET: M650-H205-02-01G

Resistors Base Board

Connectors Base Board

60 | P10300000000004 | P10300000000004 | LHR | 4 | CR1,CR2,CR3,CR4 | CR1:4; | GRN | DIODE_LED_0805_GRN | LED_0805 | FAI: QTLP630C-4 | AGI: HSMG-C150 | FAI: QTLP630C-4 | FAI: QTLP610C-4
61 | P10300000000005 | P10300000000005 | LHR | 2 | CR5,CR6 | CR5:6; | RED | DIODE_LED_0805_RED | LED_0805 | FAI: QTLP630C-2 | AGI: HSMH-C150 | FAI: QTLP630C-2 | FAI: QTLP610C-2
62 | P10300000000015 | P10300000000015 | LHR | 1 | D1 | D1; | BAV70 | DIODE_SIG_SOT23_150MA_BAV70 | SOT_23_3 | VIS: BAV70-V | FAI: BAV70NL | VIS: BAV70-V | FAI: BAV70NL
63 | P10400000000006 | P10400000000006 | LHR | 2 | FH1,FH2 | FH1:2; | 10A Holder | FUSE_10A_SMT_HOLDER | 154_SERIES | LIF: 154010 | NA | LIF: 154010 | NA
64 | P10400000000004 | NA | LHR | 3 | FH3,FH4,FH5 | FH3:5; | 5A Holder | FUSE_5A_SMT_HOLDER | 154_SERIES | LIF: 154005 | NA | NA | NA
65 | P10400000000005 | NA | LHR | 2 | FH6,FH7 | FH6:7; | 8A Holder | FUSE_8A_SMT_HOLDER | 154_SERIES | LIF: 154008 | NA | NA | NA
66 | P11000000000010 | P11000000000010 | LHR | 7 | L1,L2,L3,L4,L5,L6,L7 | L1:7; | 600Ohm 200mA | IND_BEAD_0805_600OHM_200MA | L_0805_IPC | MUR: BLM21B601SPT | TDK: MMZ2012Y601B | MUR: BLM21B601SPT | TDK: MMZ2012Y601B
67 | P11000000000009 | P11000000000009 | LHR | 12 | L8,L9,L10,L11,L12,L13, | L8:19; | 180Ohm 1.5A | IND_BEAD_0603_180OHM_1r5A_25% | L_0603 | MUR: BLM18PG181SN1x | NA | MUR: BLM18PG181SN1x | NA
| | | | | L14,L15,L16,L17,L18,L19
68 | P11000000000003 | P11000000000003 | LHR | 2 | L20,L21 | L20:21; | 1.5uH | IND_1r5UH_7MMX7MM_9A_SMT | FDV0630_IHLP | VIS: IHLP-2525CZ-RZ-1R5-M-01 | TOK: FDV0630-1R8M=P3 | VIS: IHLP-2525CZ-RZ-1R5-M-01 | TOK: FDV0630-1R8M=P3
69 | P11900000000009 | P11900000000009 | LHR | 2 | Q1,Q2 | Q1:2; | Si7540DP | XSTR_PWR_PNFET_PPKSO8_SI7540DP | PPAK_SO-8 | VIS: Si7540DP-E3 | NA | VIS: Si7540DP-E3 | NA
70 | P11600000000002 | P11600000000002 | LHR | 1 | SW1 | SW1; | SPST | SWITCH_PUSH_SPST_RA_SMT4 | ITT_KT11B2SAM_T | CAN: KT11B2SAM3-LFS | NA | CAN: KT11B2SAM3-LFS | NA
71 | P11600000000001 | P11600000000001 | LHR | 2 | SW2,SW3 | SW2:3; | 4POLE | SWITCH_DIP_4POLE_0r1_SMT8 | 90HB_SERIES | OMR: A6S-4101 | GRA: 90HBW04PT | OMR: A6S-4101 | GRA: 90HBW04PT
72 | P11800000000002 | P11800000000003 | LHR | 2 | T1,T2 | T1:2; | EPG4011 | XFMR_1:1_SOIC24_GENET_QUAD | T_EPG4011 | PCA: EPG4011J-LF | NA | PCA: EPG4011JE-LF | NA
73 | P12000000000015 | P12000000000016 | LHR | 1 | Y1 | Y1; | 22.1184MHz | XTAL_22r1184MHZ_SMT6x3_18PF_50P | FX532A | CIT: CS10-22.1184MABJ-UT (Digi-Key: 300-8102-1-ND) FOX: 419-22.1184-6 | | CIT: CS10-22.1184MAGJ-UT | FOX: 419-22.1184-7
74 | P12000000000013 | P12000000000014 | LHR | 1 | Y2 | Y2; | 12.00 MHz | XTAL_12r00MHZ_SMT6x3_18PF_50PPM | FX532A | CIT: CS10-12.000MABJ-UT (Digi-Key: 300-8089-1-ND) FOX: 419-12-56 (FX532 Series) | | CIT: CS10-12.000MAGJ-UT | FOX: 419-12-57
Item | EP# | EPI# | GRN | Qty | Reference Designators | MAS90 Reference Designators | Part Value | Description | PCB Footprint | MFG #1 | MFG #2 | MFGI #1 | MFGI #2 | Notes
75 | P11300000000006 | P11300000000006 | LHR | 1 | U2 | U2; | LTC3736EUF | REG_SW_QFN24_LTC3736 | QFN_24_UF | LIN: LTC3736EUF#PBF | NA | LIN: LTC3736EUF#PBF | NA
76 | P11300000000016 | P11300000000016 | LHRG | 1 | U3 | U3; | TPS51100 | REG_LIN_MSOP10_TPS51100_DDRTERM | SOPT50X490-10L | TI: TPS51100DGQG4 | NA | TI: TPS51100DGQG4 | NA
77 | P11300000000019 | P11300000000019 | LHR | 1 | U4 | U4; | AXH016A0X3 | REG_MOD_10PIN_SIP_0r75V+_16A | AXH016A0X3 | TYC: AXH016A0X3Z | ERC: PMB451845TWP | TYC: AXH016A0X3Z | ERC: PMB451845TWP
78 | P11300000000015 | P11300000000015 | LHR | 2 | U7,U8 | U7:8; | MCP1726 | REG_LIN_DFN8_MCP1726_ADJ | DFN_PACK_8 | MIP: MCP1726-ADJ2E/MF | NA | MIP: MCP1726-ADJ2E/MF | NA
79 | P10500000000180 | P10500000000181 | LHR | 1 | U9 | U9; | CY22381FX_0211 | IC_CLKGEN_SOIC8_0211P22 | SOIC127P600-8L | CYP: CY22381FXC_0211P22 | NA | CYP: CY22381FXI_0211P22 | NA
80 | P10500000000086 | NA | LHR | 1 | U10 | U10; | CY2292FZX_0211 | IC_CLKGEN_TSSOP16_0211P10 | SOP63X600-16 | CYP: CY2292FZX_0211P1 | NA | NA | NA
81 | P10500000000067 | P10500000000068 | LHR | 2 | U16,U20 | U16,20; | ICL3225ECA | IC_RS232_SSOP20_3225_E3-5V | SOP65X780-20 | INS: ICL3225ECAZ | MAX: MAX3225ECAI+ | INS: ICL3225EIAZ | MAX: MAX3225EEAI+
82 | P11100000000005 | P11100000000005 | HR | 3 | U17,U18,U29 | U17:18,29; | AT24C04 | MEMEE_512MbX8_DBGA8_100KHZ_I2C | BGA100-50P2X4-8A | ATM: AT24C04U3-10UU-1.8 | NA | ATM: AT24C04U3-10UU-1.8 | NA
83 | P10500000000081 | P10500000000081 | LHR | 1 | U19 | U19; | AD7414-0 | IC_TEMP_SOT23-6_I2C_AD7414-0 | SOT_23_6 | ANA: AD7414ARTZ-0 | NA | ANA: AD7414ARTZ-0 | NA
84 | P10500000000021 | P10500000000021 | LHR | 2 | U21,U23 | U21,23; | 74CBTLV16800 | IC_BUSSWPCHG_TVSOP48_7416800 | SOP40P600-48 | TI: SN74CBTLV16800VR | IDT: IDT74CBTLV16800PF | TI: SN74CBTLV16800VR | IDT: IDT74CBTLV16800PF
85 | P10600000000043 | P10600000000007 | LHR | 1 | U25 | U25; | EPM240T | IC_CPLD_TQFP100_EPM240-DES0211 | TQFP100_A | ALT: EPM240T100C5N_211P2 | NA | ALT: EPM240T100I5N | NA
86 | P10500000000008 | P10500000000008 | LHRG | 6 | U26,U27,U28,U30,U36,U37 | U26:28,30,36:37; | PI5A3157 | IC_ANSW_ZDFN6_SPDT_XXX3157 | TDFN_ZA-6 | PER: PI5A3157ZAEX | FAI: NC7SB3157L6X_NL | PER: PI5A3157ZAEX | FAI: NC7SB3157L6X_NL
87 | P10500000000075 | P10500000000075 | LHR | 1 | U31 | U31; | MIC2774N-29 | IC_RSTVM_SOT235_2774_THR2r93V | SOT_23_5 | MIC: MIC2774N-29YM5 | MAM: MAX6306UK29D3+T | MIC: MIC2774N-29YM5 | MAM: MAX6306UK29D3+T
88 | P10500000000023 | NA | HR | 1 | U32 | U32; | 9x877 | IC_CLKBUF_QFN40_DIFF_10OUT | QFN50P600X600-40W2N ICS: ICS97U877XKLF-T | | MOT: MPC96877EP | NA | NA
89 | P10800000000004 | P10800000000005 | HR | 2 | U33,U34 | U33:34; | 88E1111 | IC_ENETG_96BCC_88E1111 | BCC_PACK_96 | MAR: 88E1111-B2-CAA1C000 | NA | MAR: 88E1111-B2-CAA1I000 | NA
90 | P10500000000002 | P10500000000002 | LHRG | 1 | U35 | U35; | 74LVC1G08 | IC_AND_SC70_SINGLE_74LVC1G08 | SC70_5 | TI: SN74LVC1G08DCKR | FAI: NC7SZ08P5X | TI: SN74LVC1G08DCKR | FAI: NC7SZ08P5X
Item | EP# | EPI# | GRN | Qty | Reference Designators | MAS90 Reference Designators | Part Value | Description | PCB Footprint | MFG #1 | MFG #2 | MFGI #1 | MFGI #2 | Notes
91 | P10700000000016 | P10700000000016 | HR | 1 | U1 | U1; | 440EPx/GRx | IC_CPU_TE-PBGA680_440EPxS533 | BGA100P34X34-680T | AMC: PPC440EPx-SUA533T | NA | AMC: PPC440EPx-SUA533T | NA
20 | P11400000000000 | P11400000000000 | LHR | 1 | RO30 (1/2) | RO30 (1/2) | 0 | RES_0_0402_5%_OPT3P | R_0402_3P_IPC | YAE: 9C04021A0R00JEPF3 | BRN: CR0402J/0R1GLF | YAE: 9C04021A0R00JEPF3 | BRN: CR0402J/0R1GLF
18 | P10100000000048 | P10100000000048 | LHR | 1 | C56 | C56; | 220uF | CAPT_220UF_D7343_10V_10%_L0050 | CT_7343_IPC | AVX: TPSD227K010R0050 | KEM: T494D227K010ATH | AVX: TPSD227K010R0050 | KEM: T494D227K010ATH
92 | P10400000000003 | P10400000000003 | LHR* | 1 | F12 | F12; | 500mA | FUSE_500MA_1206_SMT_PTC | FU_1206L | LIF: 1206L050 | NA | LIF: 1206L050 | NA | Reflow: 245degC, 20 sec max
93 | P10500000000128 | P10500000000128 | LHR | 1 | U24 | U24; | GT3250-ABZJ | IC_USB2r0-PHY_TQFP56_GT3250-ABZ | QFN50P800X800-56W6N SMS: GT3250-ABZJ | | NA | SMS: GT3250-ABZJ | NA
94 | P10200000000047 | P10200000000047 | LHR | 2 | P5,P6 | P5:6; | F TH | CON_USBB_1X4_F_RA_TH | 787780_TH | AMP: 292304-1 | ADA: USB-B-S-RA-RC | AMP: 292304-1 | NA
95 | P10200000000045 | P10200000000045 | LHR | 1 | P7 | P7; | F TH | CON_USBA_1X4_F_RA_TH | 787616_TH | AMP: 292303-1 | ADA: USB-A-S-RA-RC | AMP: 292303-1 | NA
96 | P11500000000000 | P11500000000000 | LHR | 3 | SP1,SP2,SP3 | SP1:3; | PGB102ST23WR | SUP_ESD_SOT23_1KV | SOT23_3T | LIT: PGB102ST23WR | NA | LIT: PGB102ST23WR | NA
97 | P11700000000000 | P11700000000000 | LHR | 6 | VR1,VR2,VR3,VR4,VR5,VR6 | VR1:6; | 5.5V 20A | VAR_5r5V_0603_30A | VR_0603 | LIF: V5.5MLA0603xxx | NA | LIF: V5.5MLA0603xxx | NA
Option 1 - 440EPx667 for PPC440EPx w/ Security Feature and 667MHz Core Clock (USB Supported)
Item | EP# | EPI# | GRN | Qty | Reference Designators | MAS90 Reference Designators | Part Value | Description | PCB Footprint | MFG #1 | MFG #2 | MFGI #1 | MFGI #2 | Notes
91 | P10700000000189 | P10700000000189 | HR | 1 | U1 | U1; | 440EPx/GRx | IC_CPU_TE-PBGA680_440EPxS667 | BGA100P34X34-680T | AMC: PPC440EPx-SUA667T | NA | AMC: PPC440EPx-SUA667T | NA
20 | P11400000000000 | P11400000000000 | LHR | 1 | RO30 (1/2) | RO30 (1/2) | 0 | RES_0_0402_5%_OPT3P | R_0402_3P_IPC | YAE: 9C04021A0R00JEPF3 | BRN: CR0402J/0R1GLF | YAE: 9C04021A0R00JEPF3 | BRN: CR0402J/0R1GLF
18 | P10100000000048 | P10100000000048 | LHR | 1 | C56 | C56; | 220uF | CAPT_220UF_D7343_10V_10%_L0050 | CT_7343_IPC | AVX: TPSD227K010R0050 | KEM: T494D227K010ATH | AVX: TPSD227K010R0050 | KEM: T494D227K010ATH
92 | P10400000000003 | P10400000000003 | LHR* | 1 | F12 | F12; | 500mA | FUSE_500MA_1206_SMT_PTC | FU_1206L | LIF: 1206L050 | NA | LIF: 1206L050 | NA | Reflow: 245degC, 20 sec max
93 | P10500000000128 | P10500000000128 | LHR | 1 | U24 | U24; | GT3250-ABZJ | IC_USB2r0-PHY_TQFP56_GT3250-ABZ | QFN50P800X800-56W6N SMS: GT3250-ABZJ | | NA | SMS: GT3250-ABZJ | NA
94 | P10200000000047 | P10200000000047 | LHR | 2 | P5,P6 | P5:6; | F TH | CON_USBB_1X4_F_RA_TH | 787780_TH | AMP: 292304-1 | ADA: USB-B-S-RA-RC | AMP: 292304-1 | NA
95 | P10200000000045 | P10200000000045 | LHR | 1 | P7 | P7; | F TH | CON_USBA_1X4_F_RA_TH | 787616_TH | AMP: 292303-1 | ADA: USB-A-S-RA-RC | AMP: 292303-1 | NA
96 | P11500000000000 | P11500000000000 | LHR | 3 | SP1,SP2,SP3 | SP1:3; | PGB102ST23WR | SUP_ESD_SOT23_1KV | SOT23_3T | LIT: PGB102ST23WR | NA | LIT: PGB102ST23WR | NA
97 | P11700000000000 | P11700000000000 | LHR | 6 | VR1,VR2,VR3,VR4,VR5,VR6 | VR1:6; | 5.5V 20A | VAR_5r5V_0603_30A | VR_0603 | LIF: V5.5MLA0603xxx | NA | LIF: V5.5MLA0603xxx | NA
Option 1 - 440GRx533 for PPC440GRx w/ Security Feature and 533MHz Core Clock (USB Not Supported)
Item | EP# | EPI# | GRN | Qty | Reference Designators | MAS90 Reference Designators | Part Value | Description | PCB Footprint | MFG #1 | MFG #2 | MFGI #1 | MFGI #2 | Notes
91 | P10700000000017 | P10700000000017 | HR | 1 | U1 | U1; | 440EPx/GRx | IC_CPU_TE-PBGA680_440GRxS533 | BGA100P34X34-680T | AMC: PPC440GRx-SUA533T | NA | AMC: PPC440GRx-SUA533T | NA
20 | P11400000000000 | P11400000000000 | LHR | 1 | RO30 (2/3) | RO30 (2/3) | 0 | RES_0_0402_5%_OPT3P | R_0402_3P_IPC | YAE: 9C04021A0R00JEPF3 | BRN: CR0402J/0R1GLF | YAE: 9C04021A0R00JEPF3 | BRN: CR0402J/0R1GLF
20 | P11400000000000 | P11400000000000 | LHR | 1 | RO13 | RO13; | 0 | RES_0_0402_5%_OPT | R_0402_IPC | YAE: 9C04021A0R00JEPF3 | BRN: CR0402J/000GLF | YAE: 9C04021A0R00JEPF3 | BRN: CR0402J/000GLF
32 | P11400000000048 | P11400000000048 | LHR | 2 | RO31,RO32 | RO31:32; | 1K | RES_1K_0402_5%_OPT | R_0402_IPC | YAE: 9C04021A1001JEPF3 | BRN: CR0402JE102GLF | YAE: 9C04021A1001JEPF3 | BRN: CR0402JE102GLF
38 | P11400000000106 | P11400000000106 | LHR | 2 | RO33,RO35 | RO33,35; | 3.3K | RES_3r3K_0402_5% | R_0402_IPC | YAE: 9C04021A3301JEPF3 | BRN: CR0402JE332GLF | YAE: 9C04021A3301JEPF3 | BRN: CR0402JE332GLF
Option 1 - 440GRx667 for PPC440GRx w/ Security Feature and 667MHz Core Clock (USB Not Supported)
Item | EP# | EPI# | GRN | Qty | Reference Designators | MAS90 Reference Designators | Part Value | Description | PCB Footprint | MFG #1 | MFG #2 | MFGI #1 | MFGI #2 | Notes
91 | P10700000000190 | P10700000000190 | HR | 1 | U1 | U1; | 440EPx/GRx | IC_CPU_TE-PBGA680_440GRxS667 | BGA100P34X34-680T | AMC: PPC440GRx-SUA667T | NA | AMC: PPC440GRx-SUA667T | NA
20 | P11400000000000 | P11400000000000 | LHR | 1 | RO30 (2/3) | RO30 (2/3) | 0 | RES_0_0402_5%_OPT3P | R_0402_3P_IPC | YAE: 9C04021A0R00JEPF3 | BRN: CR0402J/0R1GLF | YAE: 9C04021A0R00JEPF3 | BRN: CR0402J/0R1GLF
20 | P11400000000000 | P11400000000000 | LHR | 1 | RO13 | RO13; | 0 | RES_0_0402_5%_OPT | R_0402_IPC | YAE: 9C04021A0R00JEPF3 | BRN: CR0402J/000GLF | YAE: 9C04021A0R00JEPF3 | BRN: CR0402J/000GLF
32 | P11400000000048 | P11400000000048 | LHR | 2 | RO31,RO32 | RO31:32; | 1K | RES_1K_0402_5%_OPT | R_0402_IPC | YAE: 9C04021A1001JEPF3 | BRN: CR0402JE102GLF | YAE: 9C04021A1001JEPF3 | BRN: CR0402JE102GLF
38 | P11400000000106 | P11400000000106 | LHR | 2 | RO33,RO35 | RO33,35; | 3.3K | RES_3r3K_0402_5% | R_0402_IPC | YAE: 9C04021A3301JEPF3 | BRN: CR0402JE332GLF | YAE: 9C04021A3301JEPF3 | BRN: CR0402JE332GLF
Item | EP# | EPI# | GRN | Qty | Reference Designators | MAS90 Reference Designators | Part Value | Description | PCB Footprint | MFG #1 | MFG #2 | MFGI #1 | MFGI #2 | Notes
98 | P11100000000038 | NA | HR | 4 | U11,U12,U13,U14 | U11:14; | 32Mbx16 DDR2 | MEMDDR2_512MbX16_FBGA92_333MHZ | FBGA80P6X17-92_12MM MIR: MT47H32M16CC-3 | | NA | Will require a slower speed | NA
Item | EP# | EPI# | GRN | Qty | Reference Designators | MAS90 Reference Designators | Part Value | Description | PCB Footprint | MFG #1 | MFG #2 | MFGI #1 | MFGI #2 | Notes
99 | P11100000000031 | P11100000000031 | HR | 1 | U15 | U15; | 16Mbx16 Mirror Bit | MEMF_256MbX16_BGA64_MBIT_110NS | BGA100P8X8-64C | SPA: S29GL256N11FFIR20 | NA | SPA: S29GL256N11FFIR20 | NA
Option 3 - 064 for NOR FLASH 64MBytes
Item | EP# | EPI# | GRN | Qty | Reference Designators | MAS90 Reference Designators | Part Value | Description | PCB Footprint | MFG #1 | MFG #2 | MFGI #1 | MFGI #2 | Notes
99 | P11100000000010 | P11100000000010 | HR | 1 | U15 | U15; | 32Mbx16 Mirror Bit | MEMF_512MbX16_BGA64_M-BIT_110N | BGA100P8X8-64C | SPA: S29GL512N11FFIR20 | NA | SPA: S29GL512N11FFIR20 | NA
Item | EP# | EPI# | GRN | Qty | Reference Designators | MAS90 Reference Designators | Part Value | Description | PCB Footprint | MFG #1 | MFG #2 | MFGI #1 | MFGI #2 | Notes
100 | P11100000000068 | P11100000000069 | LHR | 1 | U22 | U22; | 32Mbx8 | MEMF_256MbX8_TSOP48_50NS_NAND | SOPT50X2000-48L | SAG: K9F5608U0B-PCB0000 | NA | SAG: K9F5608U0B-PIB0000 | NA
Item | EP# | EPI# | GRN | Qty | Reference Designators | MAS90 Reference Designators | Part Value | Description | PCB Footprint | MFG #1 | MFG #2 | MFGI #1 | MFGI #2 | Notes

Option 5 - E for EBC Bus Expansion Connector
Item | EP# | EPI# | GRN | Qty | Reference Designators | MAS90 Reference Designators | Part Value | Description | PCB Footprint | MFG #1 | MFG #2 | MFGI #1 | MFGI #2 | Notes
101 | P10200000000041 | P10200000000041 | LHR | 1 | P12 | P12; | .5mm F SMT | CON_SKT_60x2_F_VT_r5MM_SMT | QSH_60X2 | SAM: QSH-060-01-F-D-A-K | NA | SAM: QSH-060-01-F-D-A-K | NA
Item | EP# | EPI# | GRN | Qty | Reference Designators | MAS90 Reference Designators | Part Value | Description | PCB Footprint | MFG #1 | MFG #2 | MFGI #1 | MFGI #2 | Notes
17 | P10100000000041 | P10100000000041 | LHR | 2 | C217,C229 | C217,229; | 100uF | CAPT_100UF_3528_6r3V_10%_LXXXX | CT_3528_IPC | AVX: TPSB107K006R | KEM: T494B107K006ATH | AVX: TPSB107K006R | KEM: T494B107K006ATH
102 | P10400000000000 | P10400000000001 | LHR | 2 | F8,F9 | F8:9; | 100ma | FUSE_100MA_1210_SMT | FU_1210 | RAY: microSMD010F | BRN: MF-USMF010 | RAY: microSMD010F | BRN: MF-USMF010
103 | P10400000000003 | P10400000000003 | LHR* | 2 | F10,F11 | F10:11; | 500mA | FUSE_500MA_1206_SMT_PTC | FU_1206L | LIF: 1206L050 | NA | LIF: 1206L050 | NA | Reflow: 245degC, 20 sec max
104 | P11300000000017 | P11300000000017 | LHR | 1 | U5 | U5; | PTN04050CAZ | REG_MOD_4PIN_POLA_5V+_12W | PTN04050C | TI: PTN04050CAZ | NA | TI: PTN04050CAZ | NA
105 | P11300000000018 | P11300000000018 | LHR | 1 | U6 | U6; | PTN04050AAZ | REG_MOD_5PIN_POLA_-3r3V+_6W | PTN04050A | TI: PTN04050AAZ | NA | TI: PTN04050AAZ | NA
106 | P10100000000091 | P10100000000091 | LHR | 4 | C218,C219,C230,C231 | C218:219,230:231; | 47uF, 16V | CAPT_47UF_C6032_16V_10% | CT_6032_IPC | NEM: PCT47/16CK | AVX: TAJC476K016R | NEM: PCT47/16CK | AVX: TAJC476K016R

Option 6 - P for +/- 12V Power to PCI Slots

Option 4 - A for NAND FLASH 32MBytes

Option 3 - 032 for NOR FLASH 32MBytes

Option 5 - N No Pop EBC Bus Expansion Connector

Option 2 - D for DDR2 SDRAM 256MBytes / 333MHz

ICs Base Board

Option 1 - 440EPx533 for PPC440EPx w/ Security Feature and 533MHz Core Clock (USB Supported)

Misc Base Board
