ska-sa/roach1_hardware/roach/Assembly/ROACH101_ManFile.rtf

Roach Manufacturing File for roach101.pcb on 17/07/2008 17:11:56

Name P/D_NUM Position X Position Y Layer Name Orientation Geometry.Height Value
C1 TPSD227K010R0050 292.000 72.100 Top 270 3.1MM 220UF
C2 1210YD226KAT2A 291.892 61.125 Top 90 2.79MM 22UF
C3 C0402X7R160-104KN 41.100 103.217 Top 0 0.55MM 0.1UF
C4 C0402X7R160-104KN 297.834 229.559 Bottom 0 0.55MM 0.1UF
C5 GRM155R71A104KAO1B 237.058 18.810 Top 90 0.55MM 100NF
C6 GRM155R71E103KAO1B 233.629 22.696 Top 270 0.55MM 10NF
C7 GRM21BR60J106KE19L 129.500 86.000 Top 90 1.35MM 10UF
C8 GRM21BR60J106KE19L 152.000 164.000 Top 90 1.35MM 10UF
C9 GRM21BR60J106KE19L 117.500 86.000 Top 90 1.35MM 10UF
C10 ECJ-0EB0J224K 141.000 121.000 Bottom 0 0.55MM 220NF
C11 ECJ-0EB0J224K 139.000 127.000 Bottom 0 0.55MM 220NF
C12 ECJ-0EB0J224K 137.000 125.000 Bottom 0 0.55MM 220NF
C13 GRM155R71A104KAO1B 213.440 77.071 Bottom 90 0.55MM 100NF
C14 GRM155R71E103KAO1B 242.087 25.490 Top 270 0.55MM 10NF
C15 GRM155R71A104KAO1B 248.996 18.810 Top 90 0.55MM 100NF
C16 GRM155R71E103KAO1B 245.288 22.671 Top 270 0.55MM 10NF
C17 GRM155R71E103KAO1B 254.076 25.566 Top 270 0.55MM 10NF
C18 ECJ-0EB0J224K 233.705 25.897 Top 270 0.55MM 220NF
C19 ECJ-0EB0J224K 245.288 25.490 Top 270 0.55MM 220NF
C20 GRM155R71A104KAO1B 254.076 18.810 Top 270 0.55MM 100NF
C21 GRM1555C1H220JZ01B 296.500 129.000 Top 0 0.55MM 22PF
C22 GRM1555C1H220JZ01B 47.300 109.817 Top 0 0.55MM 22PF
C23 GRM21BR60J106KE19L 86.500 117.500 Top 0 1.35MM 10UF
C24 GRM21BR60J106KE19L 86.500 98.000 Top 0 1.35MM 10UF
C25 GRM21BR60J106KE19L 115.000 164.000 Top 90 1.35MM 10UF
C26 GRM21BR60J106KE19L 174.000 164.000 Top 90 1.35MM 10UF
C27 GRM21BR60J106KE19L 146.000 164.000 Top 90 1.35MM 10UF
C28 GRM21BR60J106KE19L 86.500 85.000 Top 0 1.35MM 10UF
C29 GRM21BR60J106KE19L 157.500 86.000 Top 90 1.35MM 10UF
C30 GRM21BR60J106KE19L 135.500 86.000 Top 270 1.35MM 10UF
C31 GRM21BR60J106KE19L 141.500 86.000 Top 270 1.35MM 10UF
C32 GRM155R71A104KAO1B 242.138 18.810 Top 270 0.55MM 100NF
C33 GRM155R60J103KA01J 31.800 209.600 Top 270 0.55MM 10NF
C34 ECJ-0EB0J224K 106.013 209.605 Top 0 0.55MM 220NF
C35 ECJ-0EB0J224K 86.496 216.540 Top 90 0.55MM 220NF
C36 ECJ-0EB0J224K 78.393 220.223 Top 0 0.55MM 220NF
C37 ECJ-0EB0J224K 97.443 213.518 Top 270 0.55MM 220NF
C38 ECJ-0EB0J224K 97.519 216.515 Top 90 0.55MM 220NF
C39 ECJ-0EB0J224K 41.208 220.655 Top 0 0.55MM 220NF
C40 ECJ-0EB0J224K 50.758 211.079 Top 270 0.55MM 220NF
C41 ECJ-0EB0J224K 61.197 213.568 Top 270 0.55MM 220NF
C42 ECJ-0EB0J224K 51.672 218.013 Top 0 0.55MM 220NF
C43 ECJ-0EB0J224K 60.791 216.007 Top 0 0.55MM 220NF
C44 ECJ-0EB0J224K 50.783 213.441 Top 270 0.55MM 220NF
C45 ECJ-0EB0J224K 86.750 212.883 Top 270 0.55MM 220NF
C46 GRM155R71E103KAO1B 162.000 113.500 Bottom 180 0.55MM 10NF
C47 08053C225KAT2A 244.974 38.374 Top 0 1.4MM 2.2UF
C48 04023A180KAT2A 243.200 66.200 Top 270 0.55MM 18PF
C49 04023A180KAT2A 251.100 66.200 Top 270 0.55MM 18PF
C50 GRM155R71E103KAO1B 165.500 123.000 Bottom 180 0.55MM 10NF
C51 04023A180KAT2A 254.000 54.800 Top 270 0.55MM 18PF
C52 04023A180KAT2A 262.000 54.800 Top 270 0.55MM 18PF
C53 C0402X7R160-104KN 214.960 157.240 Bottom 180 0.55MM 0.1UF
C54 C0402X7R160-104KN 225.323 157.672 Bottom 270 0.55MM 0.1UF
C55 GRM155R71E103KAO1B 177.988 102.500 Bottom 0 0.55MM 10NF
C56 GRM155R71E103KAO1B 192.000 102.500 Bottom 180 0.55MM 10NF
C57 GRM155R71A104KAO1B 201.500 94.500 Top 270 0.55MM 100NF
C58 GRM21BR61E475KA12K 206.500 95.500 Top 90 1.35MM 4U7F
C59 GRM32DR61C106KA01K 194.500 83.000 Top 270 2.2MM 10UF
C60 GRM32DR61C106KA01K 202.500 110.000 Top 0 2.2MM 10UF
C61 GRM155R60J103KA01J 25.200 217.700 Top 0 0.55MM 10NF
C62 GRM155R71A104KAO1B 204.500 193.500 Top 90 0.55MM 100NF
C63 GRM155R71E103KAO1B 254.585 107.955 Top 180 0.55MM 10NF
C64 ECJ-0EB0J224K 104.500 140.000 Top 0 0.55MM 220NF
C65 ECJ-0EB0J224K 104.500 149.000 Top 0 0.55MM 220NF
C66 GRM155R60J103KA01J 104.500 138.900 Top 0 0.55MM 10NF
C67 GRM155R60J103KA01J 104.500 150.000 Top 0 0.55MM 10NF
C68 GRM155R60J104KA01J 111.500 141.000 Top 0 0.55MM 100NF
C69 GRM155R60J104KA01J 111.500 142.000 Top 0 0.55MM 100NF
C70 GRM155R60J104KA01J 111.500 148.000 Top 0 0.55MM 100NF
C71 GRM155R60J104KA01J 111.500 147.000 Top 0 0.55MM 100NF
C72 GRM155R60J104KA01J 111.500 146.000 Top 0 0.55MM 100NF
C73 GRM155R60J104KA01J 111.500 145.000 Top 0 0.55MM 100NF
C74 GRM155R60J104KA01J 111.500 144.000 Top 0 0.55MM 100NF
C75 GRM155R60J104KA01J 111.500 143.000 Top 0 0.55MM 100NF
C76 GRM155R60J103KA01J 104.500 164.000 Top 0 0.55MM 10NF
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
RP22 4D02WGJ0510B1E 290.350 102.836 Top 0 0.55MM 49.9R
RP23 4D02WGJ0510B1E 290.350 105.631 Top 0 0.55MM 49.9R
RP24 4D02WGJ0510B1E 290.350 110.003 Top 0 0.55MM 49.9R
RP25 4D02WGJ0510B1E 290.350 90.973 Top 0 0.55MM 49.9R
RP26 4D02WGJ0510B1E 290.350 88.307 Top 0 0.55MM 49.9R
RP27 4D02WGJ0510T 183.400 158.900 Bottom 90 0.55MM 51R
RP28 4D02WGJ0510T 186.700 158.900 Bottom 90 0.55MM 51R
RP29 4D02WGJ0510T 190.600 158.900 Bottom 90 0.55MM 51R
RP30 4D02WGJ0510T 194.700 152.800 Bottom 180 0.55MM 51R
RP31 4D02WGJ0510T 194.700 149.900 Bottom 180 0.55MM 51R
RP32 4D02WGJ0510T 194.700 147.400 Bottom 180 0.55MM 51R
RP33 4D02WGJ0510T 194.700 145.100 Bottom 180 0.55MM 51R
RP34 4D02WGJ0510T 194.600 142.700 Bottom 180 0.55MM 51R
RP35 4D02WGJ0510T 181.400 138.500 Bottom 270 0.55MM 51R
RP36 4D02WGJ0510T 184.500 138.500 Bottom 270 0.55MM 51R
RP37 4D02WGJ0510T 187.600 138.500 Bottom 270 0.55MM 51R
RP38 4D02WGJ0510T 178.500 138.600 Bottom 270 0.55MM 51R
RS1 4D02WGJ0330T 251.000 73.500 Top 90 0.4MM 33
RS2 4D02WGJ0330T 249.400 76.200 Top 90 0.4MM 33
RS3 4D02WGJ0330T 248.200 76.100 Top 90 0.4MM 33
RS7 4D02WGJ0330T 259.600 65.700 Top 90 0.4MM 33
RS9 4D02WGJ0330T 261.100 65.600 Top 90 0.4MM 33
RS10 4D02WGJ0330T 251.434 58.459 Top 90 0.4MM 33
SNP1 N/A 145.034 23.659 Top 0 0.00000mm
SP2 PGB102ST23WR 248.034 227.559 Top 270 0.76MM PGB102ST
SW1 7914G 243.272 30.170 Top 90 4.19MM SPST
SW2 A6S-4101-H 224.900 49.200 Top 180 3.1MM 4POLE
SW3 A6S-4101-H 213.300 49.200 Top 180 3.1MM 4POLE
TP1 N/A 210.100 128.000 Top 0 0.00000mm TEST POI
TP2 N/A 258.200 66.100 Top 0 0.00000mm
TP3 N/A 207.600 86.200 Top 0 0.00000mm
TP4 N/A 271.725 107.115 Top 0 0.00000mm
TP5 N/A 272.171 90.223 Top 0 0.00000mm
TP6 N/A 262.600 65.500 Top 0 0.00000mm
TP7 N/A 251.200 76.700 Top 0 0.00000mm
TP8 N/A 252.600 74.000 Top 0 0.00000mm
TP9 N/A 214.800 90.300 Top 0 0.00000mm
U1 PPC440EPX-NTA533T 234.000 125.500 Top 90 2.65MM 440EPX
U2 SN74AHC1G125DCKT 203.220 80.450 Top 270 1.1MM
U3 TL7700CPSR 25.500 212.600 Top 180 0.05080mm
U4 ADCMP605BCPZ 237.566 23.128 Top 0 1.0MM
U5 ADCMP605BCPZ 249.504 23.128 Top 0 1.0MM
U6 CDCU877ARHAT 259.796 109.029 Top 0
U8 SY89832UMI 104.500 144.000 Top 180 0.9MM
U9 CY22381FXI_0211P2 247.500 71.000 Top 90 1.73MM CY22381F
U10 74AVCH4T245DGVRE4 47.380 215.296 Top 270 1.2MM
U11 74AVCH4T245DGVRE4 57.540 215.296 Top 270 1.2MM
U12 74AVCH4T245DGVRE4 102.660 209.758 Top 90 1.2MM
U13 74AVCH4T245DGVRE4 83.448 215.296 Top 270 1.2MM
U14 74AVCH4T245DGVRE4 94.116 215.296 Top 270 1.2MM
U15 XC5VSX95T 142.500 124.000 Top 270 3.4MM
U16 TPS51100DGQ 202.500 100.500 Top 270 1.1MM TPS51100
U17 K7S3218T4C-FC40 185.500 103.500 Top 0 1.4MM
U18 TPS2031D 128.076 223.170 Top 0 1.75MM
U19 TPS2031D 127.695 217.201 Top 0 1.75MM
U20 MAX9032AKA 114.360 217.201 Top 270 1.4MM
U21 MAX9032AKA 114.614 223.424 Top 270 1.4MM
U22 SN74AHC1G08DCKR 119.313 225.329 Top 270 1.45MM
U23 SN74AHC1G08DCKR 119.059 219.106 Top 270 1.45MM
U24 CY2292F 257.834 60.659 Top 90 1.73MM CY2292FZ
U25 ADR03ARZ 96.300 116.500 Top 0 1.75MM
U26 SY89832UMI 104.500 158.000 Top 180 0.9MM
U27 PTH08T220WAD 2.600 99.599 Top 90 8.5MM
U28 TPS2031D 128.076 229.520 Top 0 1.75MM
U29 TPS2031D 128.126 235.819 Top 0 1.75MM
U30 MAX9032AKA 114.741 235.870 Top 270 1.4MM
U31 MIC2774N-29YMS 241.111 39.092 Top 270 1.45MM MIC2774N
U32 TPS51100DGQ 293.387 130.902 Top 90 1.1MM TPS51100
U33 TPS51100DGQ 41.600 107.717 Top 180 1.1MM TPS51100
U34 MAX9032AKA 114.741 229.647 Top 270 1.4MM
U35 SN74LVC1G08DCKR 237.500 41.800 Top 270 1.1MM 74LVC1G0
U36 SN74AHC1G08DCKR 119.440 231.552 Top 270 1.45MM
U37 SN74AHC1G08DCKR 119.440 237.775 Top 270 1.45MM
U38 AT24C04N-10SU-1.8 67.933 197.206 Top 0 1.75MM AT24C04
U40 AT24C04N-10SU-1.8 93.803 197.231 Top 0 1.75MM AT24C04
U41 AD7414ARTZ-0 58.511 197.207 Top 0 1.45MM AD7414-0
U42 S29GL512N11FFI010 188.500 125.000 Top 0 1.4MM 32MX16 M
U43 ICL3225EIAZ 290.610 219.000 Top 270 2MM ICL3225E
U44 ICL3225EIAZ 281.500 219.000 Top 270 2MM ICL3225E
U45 PI5A3157ZAEX 290.475 210.802 Top 270 1.1MM PI5A3157
U46 PI5A3157ZAEX 287.164 210.802 Top 270 1.1MM PI5A3157
U48 PI5A3157ZAEX 283.715 210.802 Top 270 1.1MM PI5A3157
U50 PTH05T210WAD 2.092 30.511 Top 0 8.5MM PTH05T21
U51 PTH08T240WAD 19.364 50.323 Top 90 8.5MM PTH08T24
U53 PTH08T230WAD 2.092 50.323 Top 90 8.5MM
U54 XC2C256_7VQ144C 220.799 76.653 Top 270 1.6MM
U55 TPS74401RGWT 115.000 202.000 Top 180 1.0MM TPS74401
U56 TPS74401RGWT 141.000 202.000 Top 180 1.0MM TPS74401
U57 TPS74401RGWT 128.000 202.000 Top 180 1.0MM TPS74401
U58 DP83865DVH 225.027 215.552 Top 270 1.0MM
U59 TPS74401RGWT 7.172 135.159 Top 270 1.0MM TPS74401
U60 AFS600-FG256 38.000 184.000 Top 270 1.7MM
U61 ADM3101EACPZ-REEL 26.768 228.171 Top 90 1.0MM
U62 TPS51100DGQ 204.900 169.800 Top 90 1.1MM TPS51100
U63 K7S3218T4C-FC40 185.500 149.000 Top 0 1.4MM
V1 N/A 153.000 150.300 Top 180 0.00000mm
V2 N/A 122.100 148.500 Top 0 0.00000mm
V3 N/A 162.600 226.900 Top 0 0.00000mm
V4 N/A 129.000 150.300 Top 180 0.00000mm
V5 N/A 164.034 224.459 Top 180 0.00000mm
V6 N/A 158.400 226.900 Top 0 0.00000mm
V7 N/A 116.100 148.500 Top 0 0.00000mm
V8 N/A 159.700 224.400 Top 180 0.00000mm
V9 N/A 118.600 150.300 Top 180 0.00000mm
V18 N/A 173.200 224.400 Top 180 0.00000mm
V19 N/A 135.000 150.300 Top 180 0.00000mm
V20 N/A 171.834 226.859 Top 0 0.00000mm
V21 N/A 132.500 148.500 Top 0 0.00000mm
V22 N/A 177.434 224.359 Top 180 0.00000mm
V23 N/A 141.000 150.300 Top 180 0.00000mm
V24 N/A 176.100 226.800 Top 0 0.00000mm
V25 N/A 138.500 148.500 Top 0 0.00000mm
V34 N/A 192.434 224.359 Top 180 0.00000mm
V35 N/A 150.500 148.500 Top 0 0.00000mm
V36 N/A 191.100 226.800 Top 0 0.00000mm
V37 N/A 144.500 148.500 Top 0 0.00000mm
V38 N/A 186.834 226.859 Top 0 0.00000mm
V39 N/A 147.000 150.300 Top 180 0.00000mm
V40 N/A 188.200 224.400 Top 180 0.00000mm
V49 N/A 161.600 150.400 Top 180 0.00000mm
V50 N/A 201.700 224.400 Top 180 0.00000mm
V51 N/A 200.434 226.859 Top 0 0.00000mm
V52 N/A 156.500 148.500 Top 0 0.00000mm
V53 N/A 205.934 224.359 Top 180 0.00000mm
V54 N/A 168.900 150.500 Top 180 0.00000mm
V55 N/A 204.600 226.800 Top 0 0.00000mm
V56 N/A 166.000 148.600 Top 0 0.00000mm
VR4 V5.5MLA0603XXX 251.434 228.559 Top 0 0.9MM 5.5V 20A
X1 CCLD-023-25-156.250 96.500 145.000 Top 0 1.8MM 156.25MH
X2 CCLD-023-25-100.000 96.500 135.500 Top 0 1.8MM 100.00MH
X3 CCLD-024-25-200.000 96.500 125.000 Top 0 1.8MM 200.00MH
X4 CCLD-023-25-156.250 96.500 159.000 Top 0 1.8MM 156.25MH
X5 ECX-306 38.206 208.037 Top 180 2.5MM 32.768KH
Y1 CS10-22.1184MAGJ-UT 247.200 64.700 Top 0 1.0MM 22.1184M
Y2 CS10-12.000MAGJ-UT 257.900 53.800 Top 0 1.0MM 12.00 MH
