ska-sa/roach1_hardware/roach/pdfschem/roach_top102.pdf

POWER SUPPLY AND MONITORING | ZDOK/ADC INTERFACE

# VIRTEX5 CLOCKS

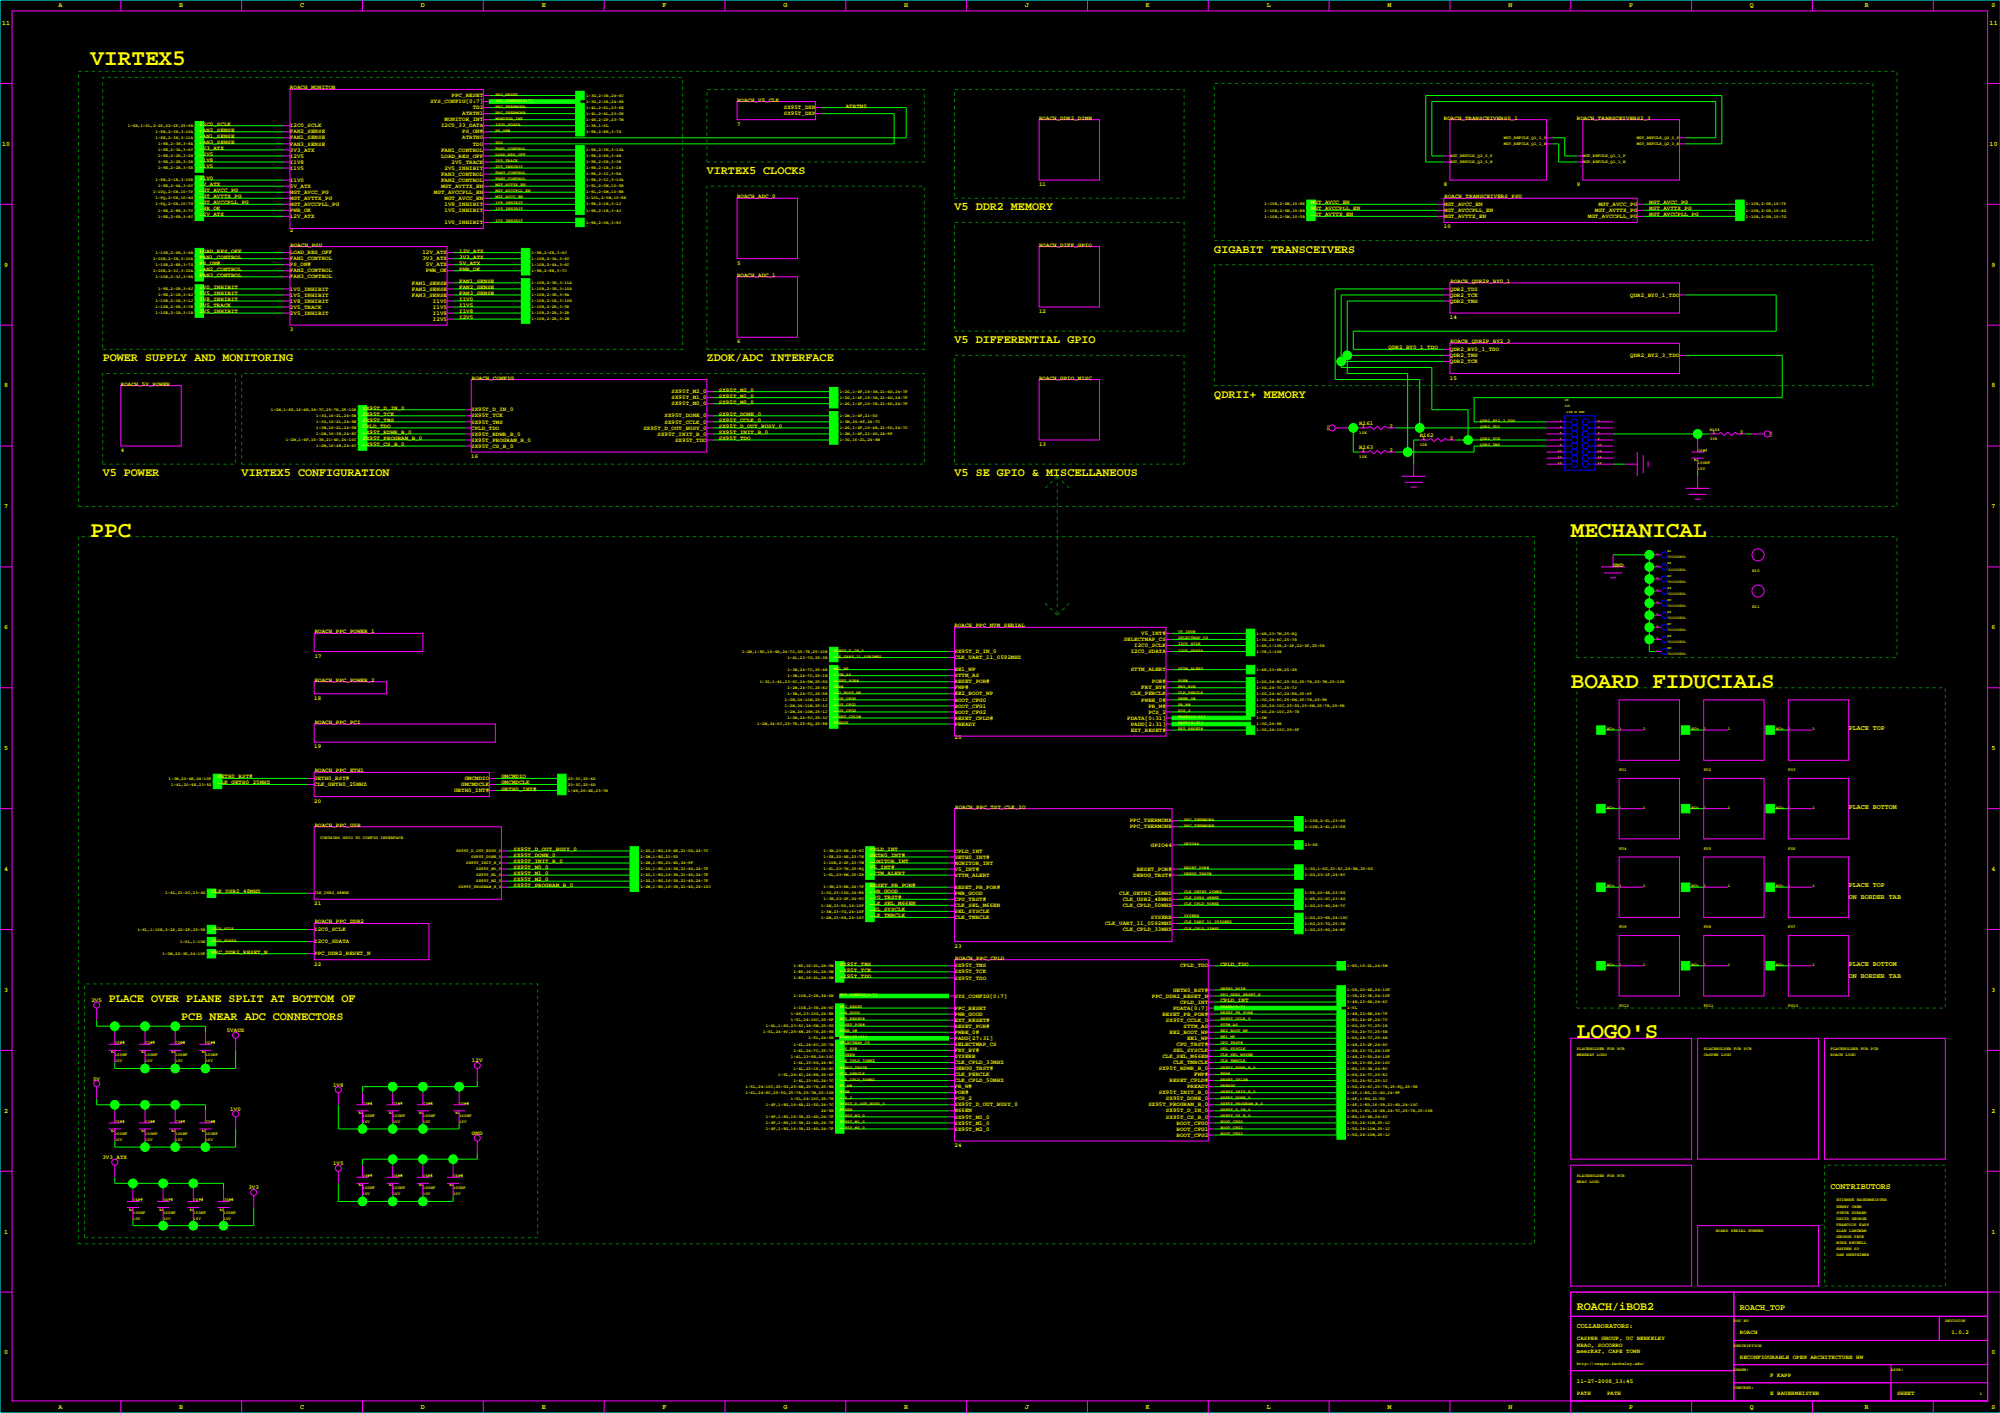
[picture p53: page 1]

CONTAINS GPIO TO CONFIG INTERFACE

PLACE OVER PLANE SPLIT AT BOTTOM OF

PCB NEAR ADC CONNECTORS

CASPER GROUP, UC BERKELEY
NRAO, SOCORRO
meerKAT, CAPE TOWN

DESCRIPTION
RECONFIGURABLE OPEN ARCHITECTURE HW

http://casper.berkeley.edu/

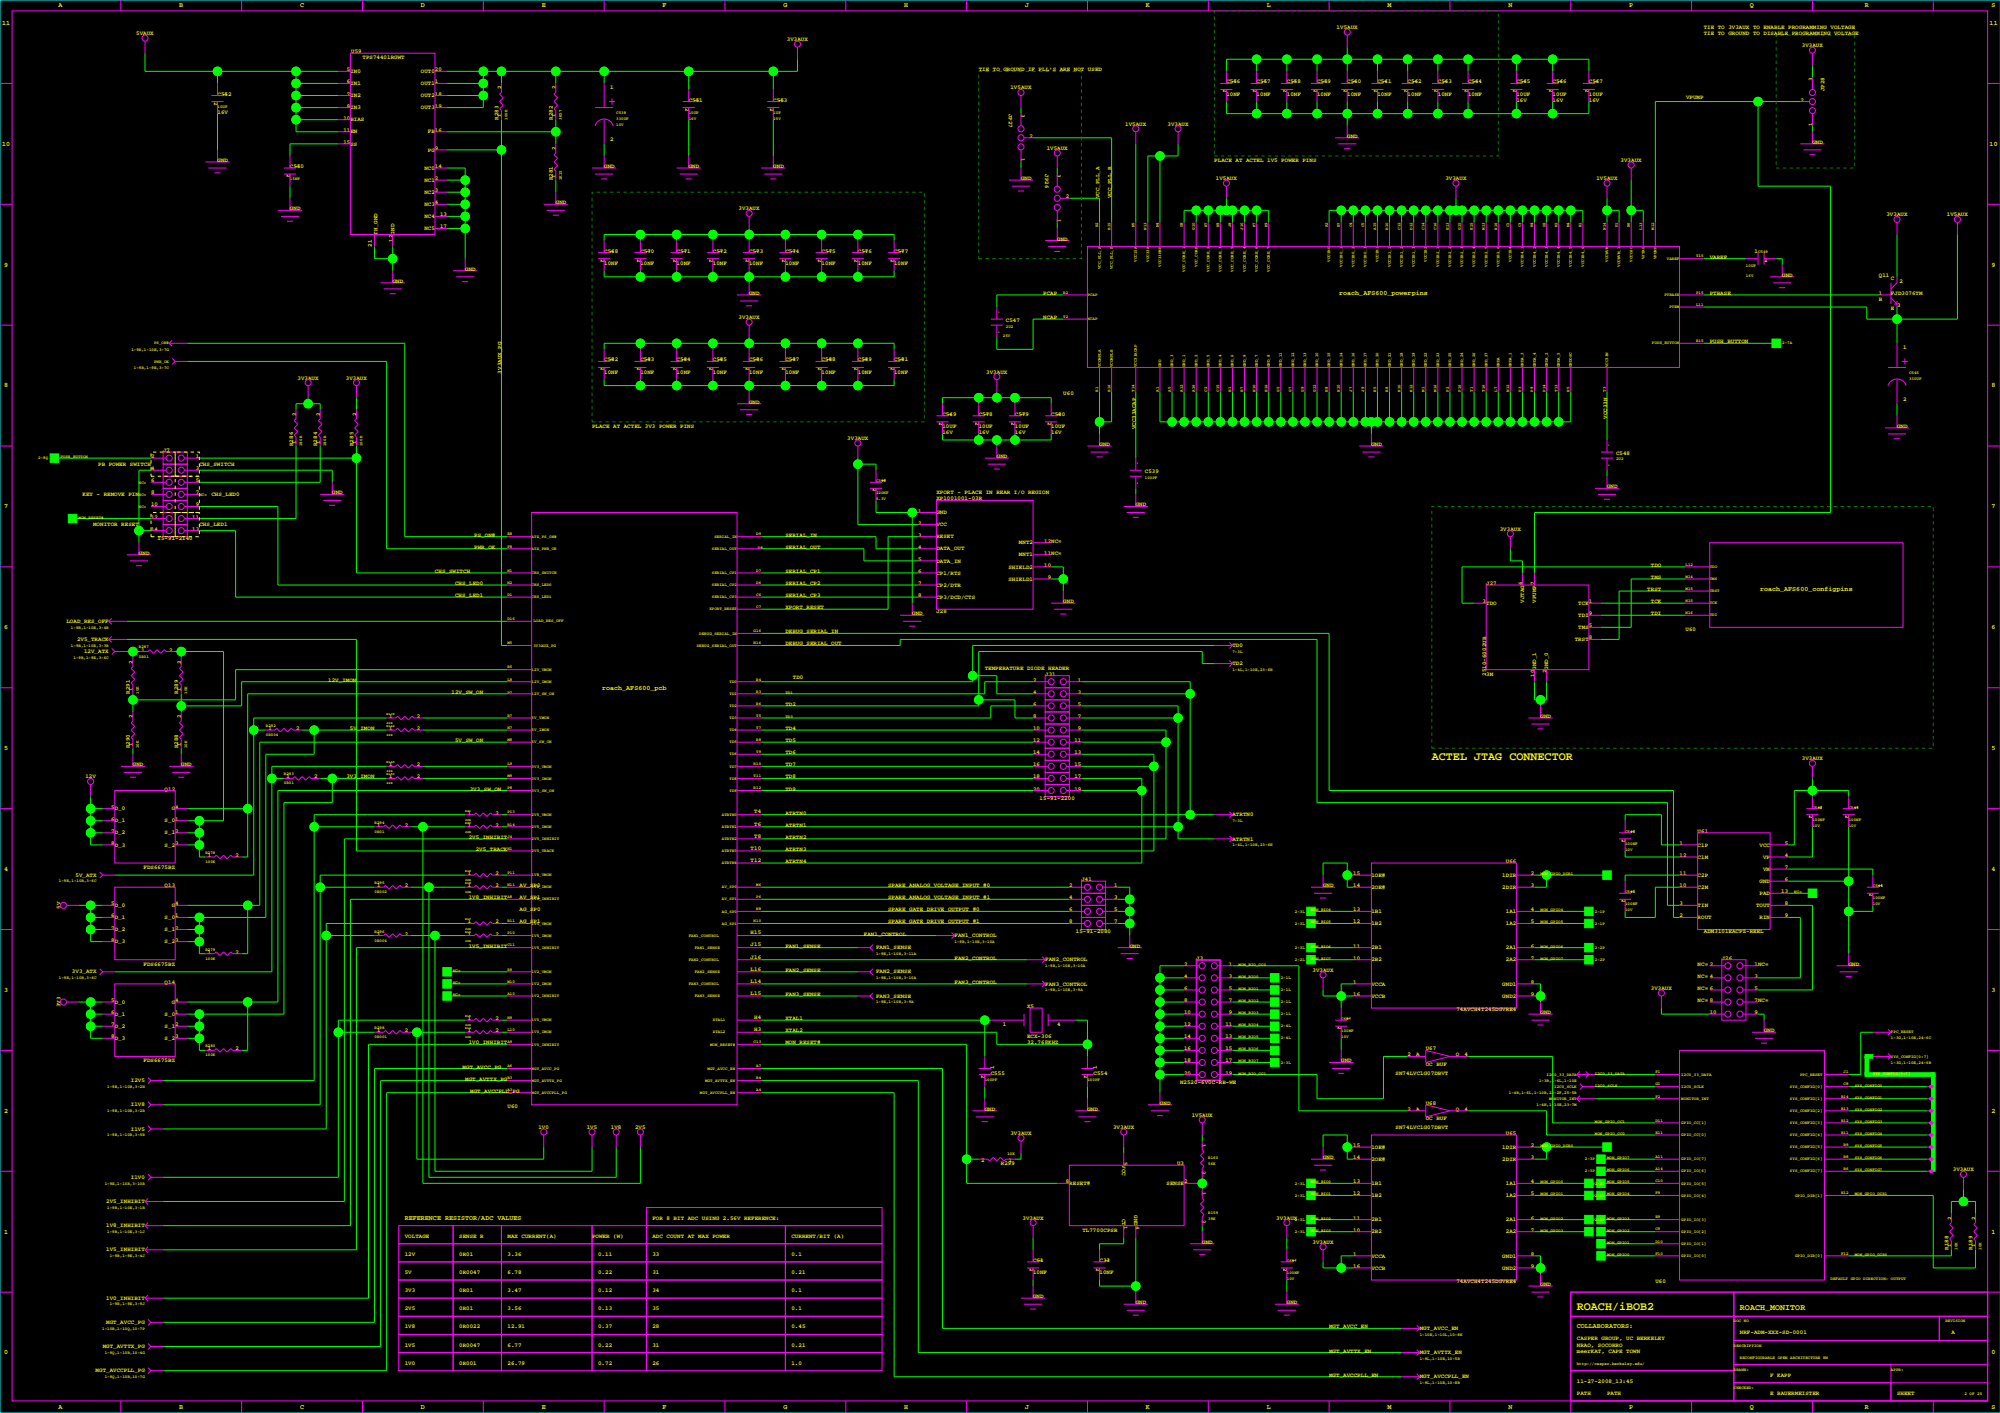
[picture p54: page 2]

TIE TO 3V3AUX TO ENABLE PROGRAMMING VOLTAGE
TIE TO GROUND TO DISABLE PROGRAMMING VOLTAGE

TIE TO GROUND IF PLL'S ARE NOT USED

PLACE AT ACTEL 1V5 POWER PINS

PLACE AT ACTEL 3V3 POWER PINS

XPORT - PLACE IN REAR I/O REGION

SPARE ANALOG VOLTAGE INPUT #0

SPARE ANALOG VOLTAGE INPUT #1

SPARE GATE DRIVE OUTPUT #0

SPARE GATE DRIVE OUTPUT #1

ADC COUNT AT MAX POWER

DEFAULT GPIO DIRECTION: OUTPUT

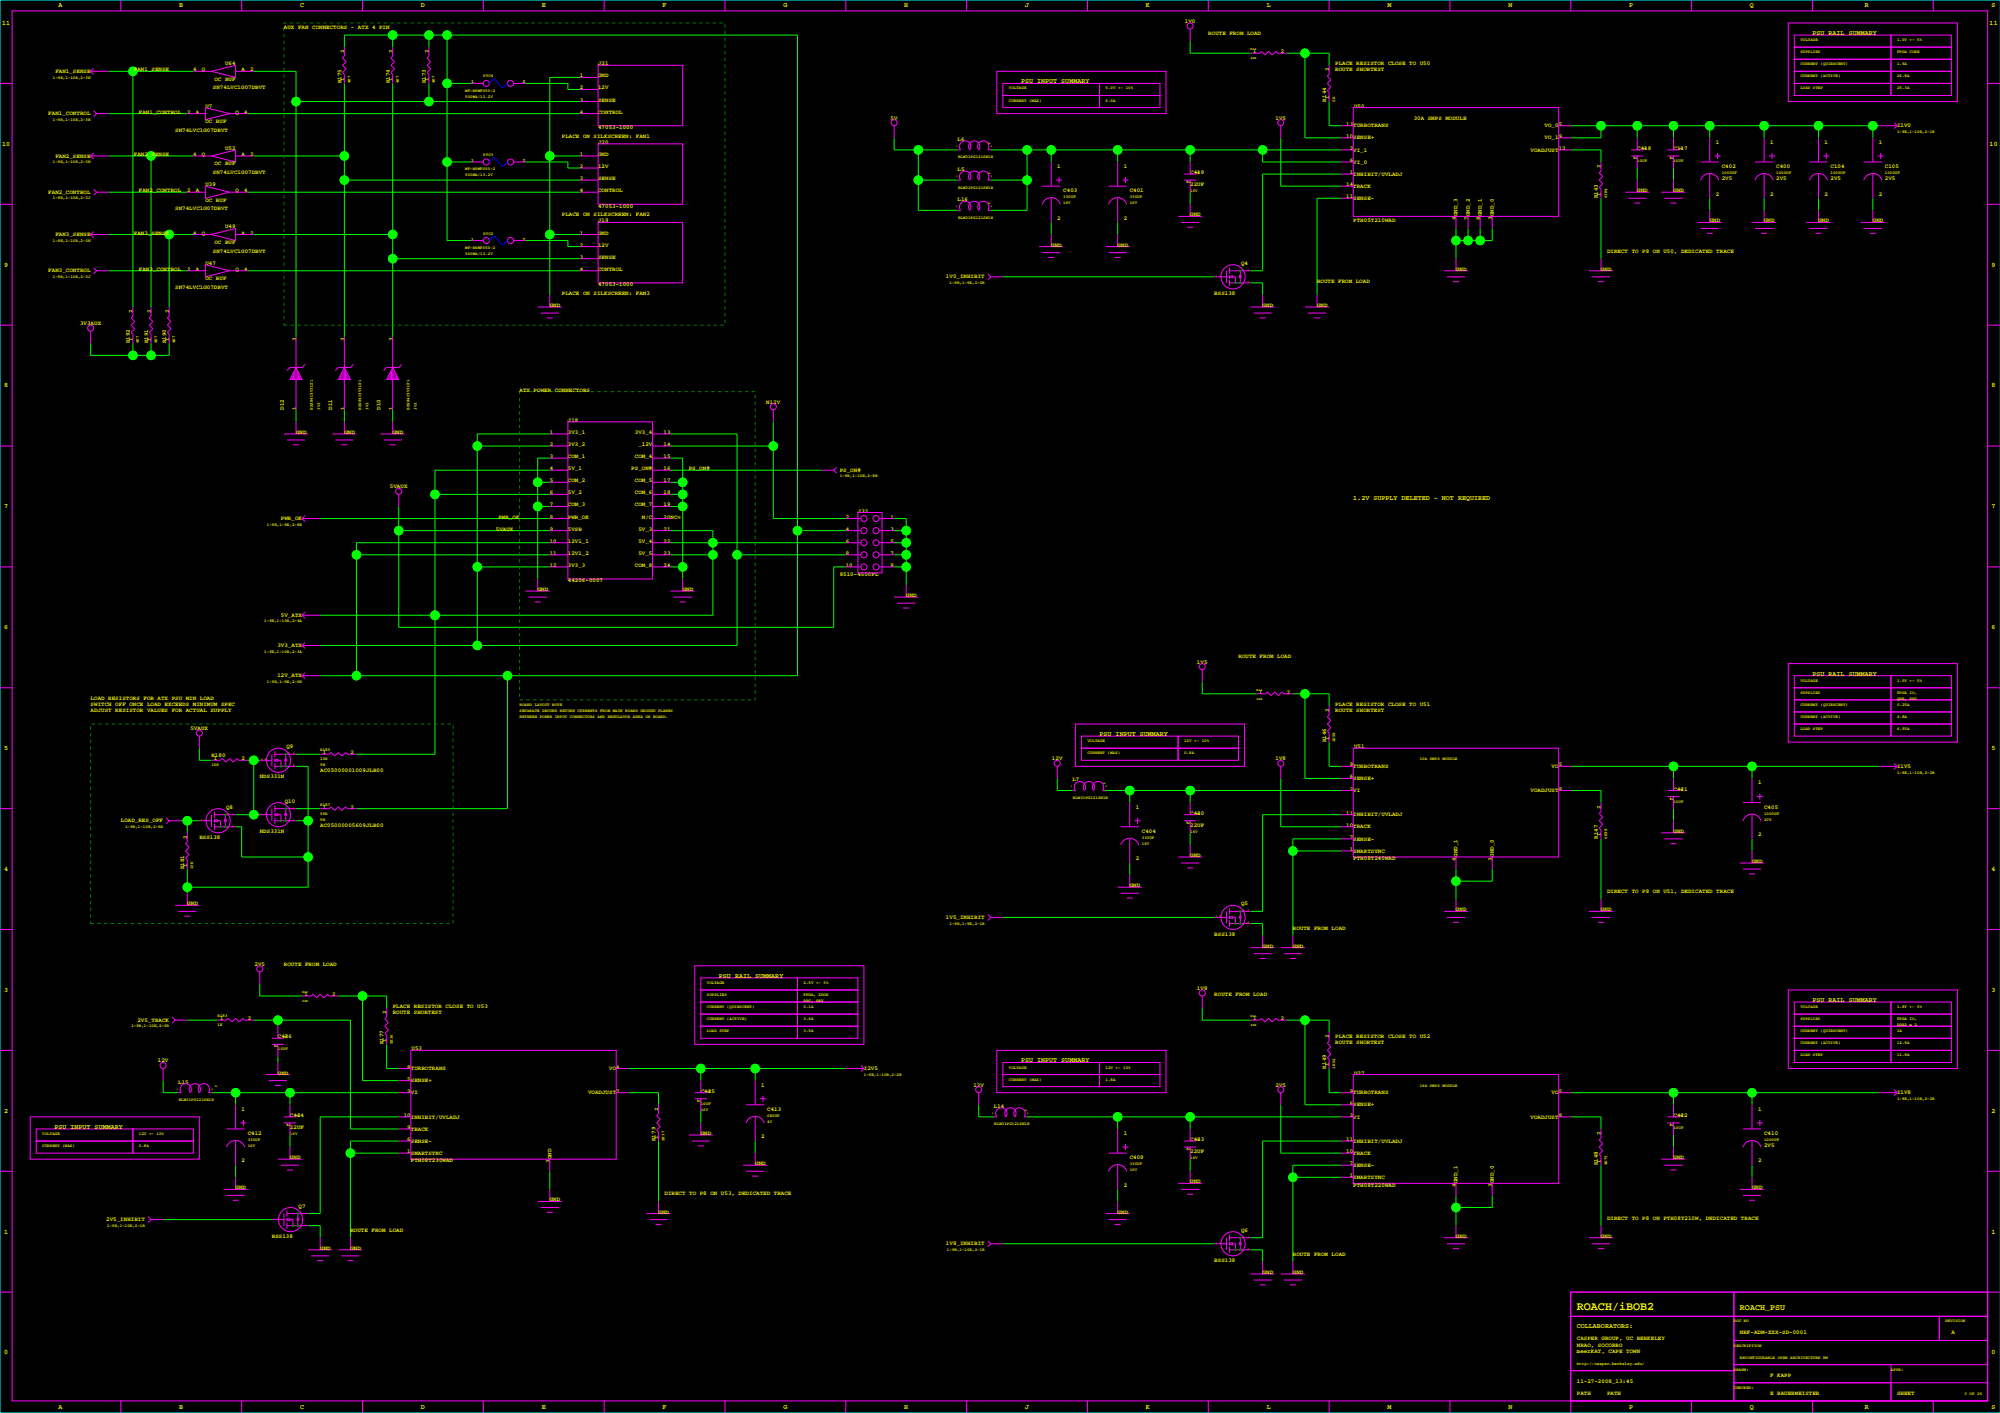
[picture p55: page 3]

AUX FAN CONNECTORS - ATX 4 PIN

PLACE RESISTOR CLOSE TO U50
ROUTE SHORTEST

SN74LVC1G07DBVT | SN74LVC1G07DBVT U7

SN74LVC1G07DBVT | SN74LVC1G07DBVT U39

DIRECT TO P8 ON U50, DEDICATED TRACE

1.2V SUPPLY DELETED - NOT REQUIRED

LOAD RESISTORS FOR ATX PSU MIN LOAD
SWITCH OFF ONCE LOAD EXCEEDS MINIMUM SPEC
ADJUST RESISTOR VALUES FOR ACTUAL SUPPLY

PLACE RESISTOR CLOSE TO U51

BOARD LAYOUT NOTE
SEPARATE GROUND RETURN CURRENTS FROM MAIN BOARD GROUND PLANES
BETWEEN POWER INPUT CONNECTORS AND REGULATOR AREA ON BOARD.

DIRECT TO P8 ON U51, DEDICATED TRACE

PLACE RESISTOR CLOSE TO U53

PLACE RESISTOR CLOSE TO U52

DIRECT TO P8 ON U53, DEDICATED TRACE

DIRECT TO P8 ON PTH08T210W, DEDICATED TRACE

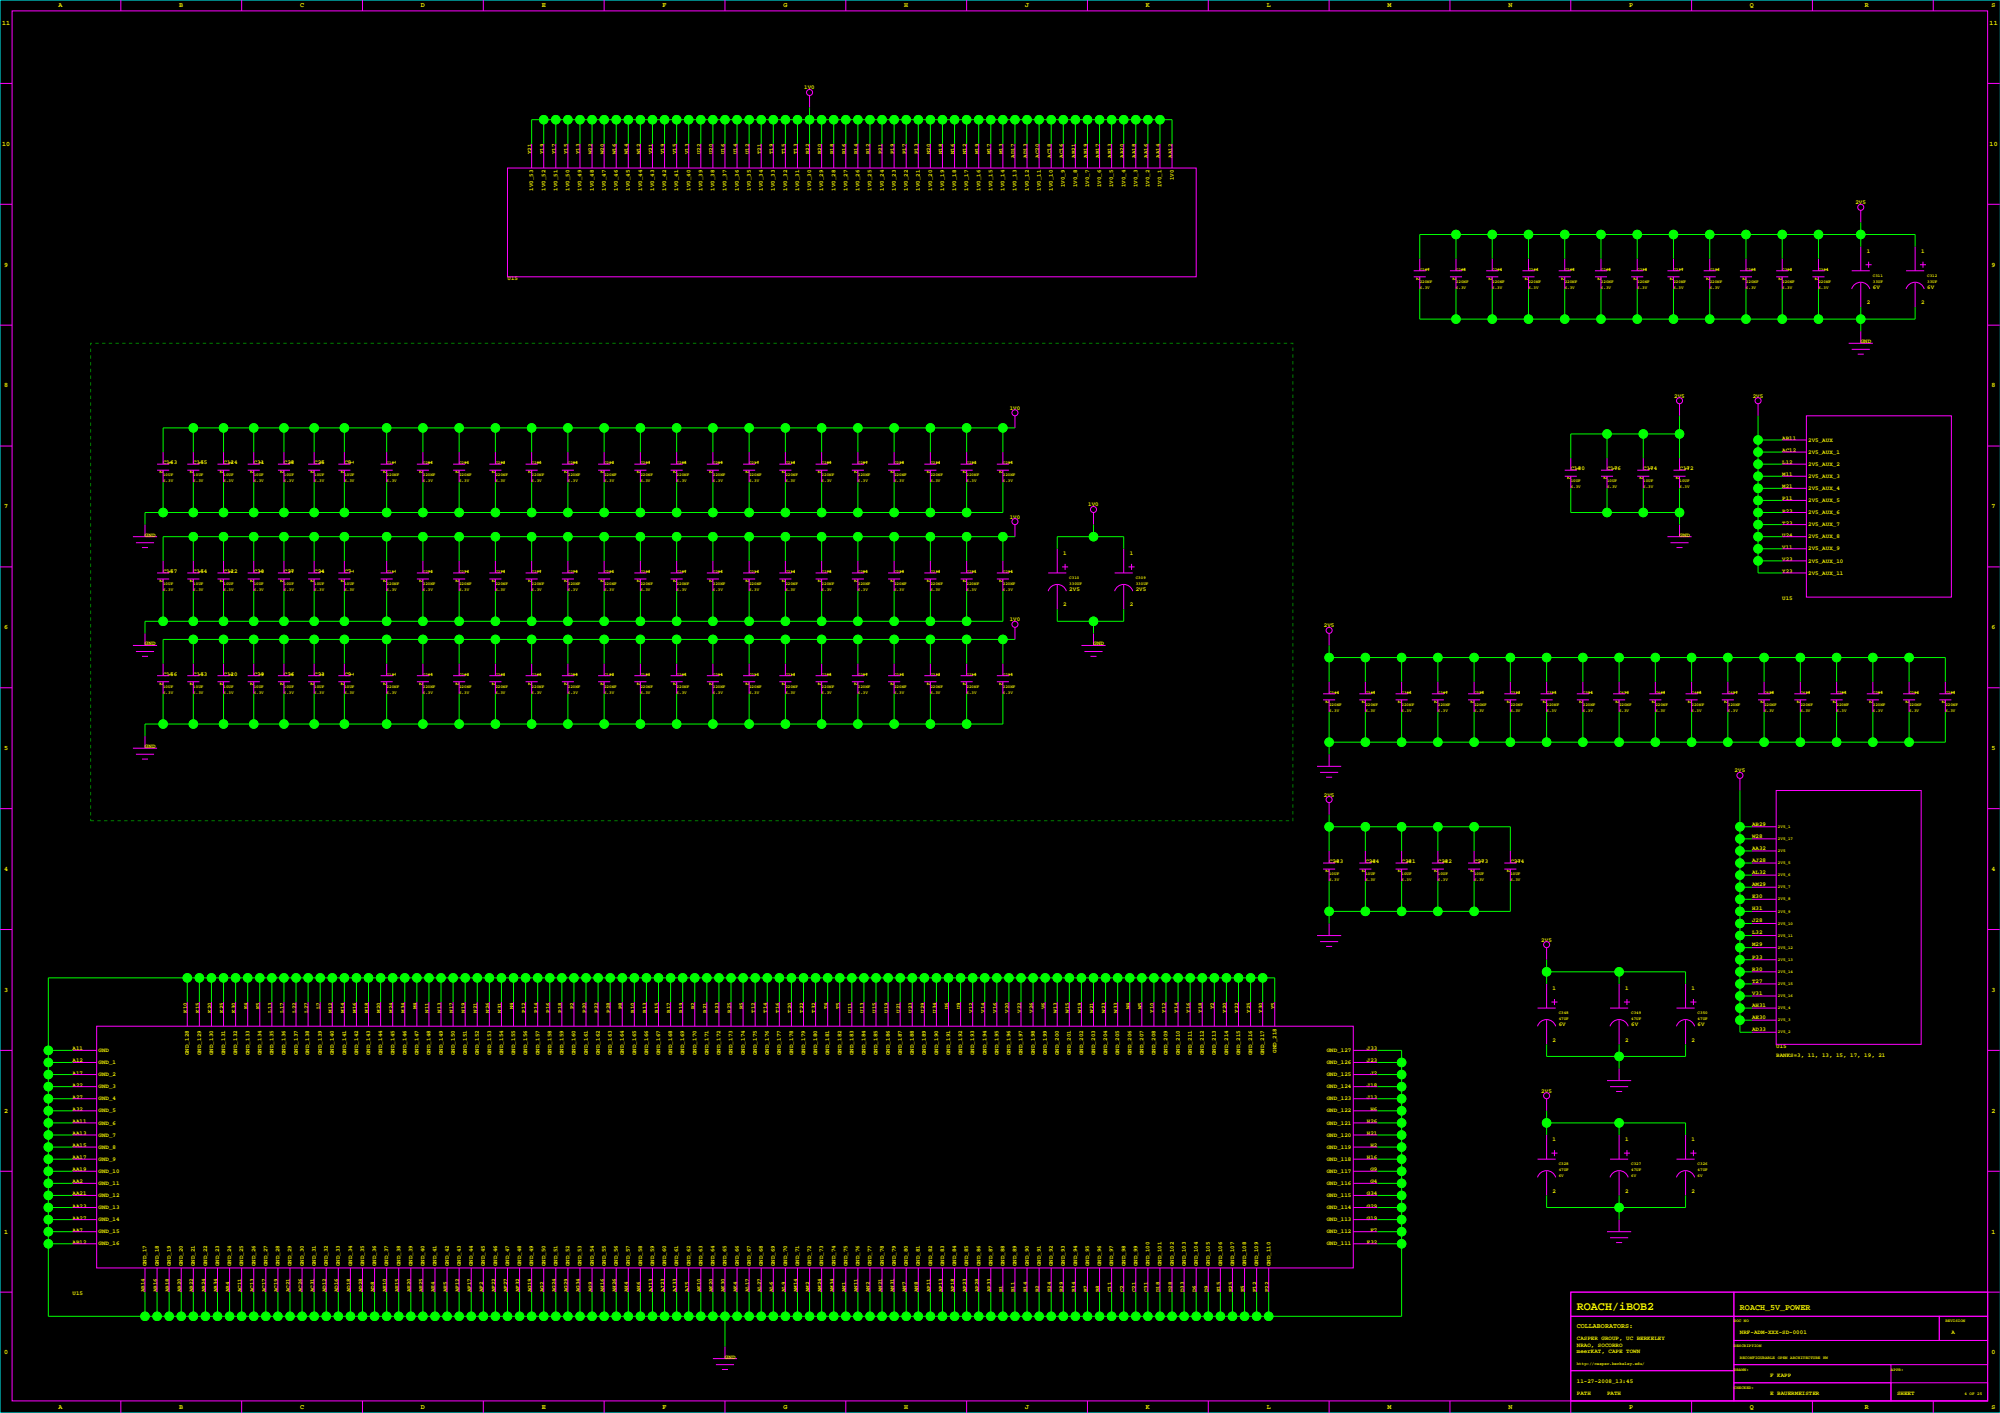
[picture p56: page 4]

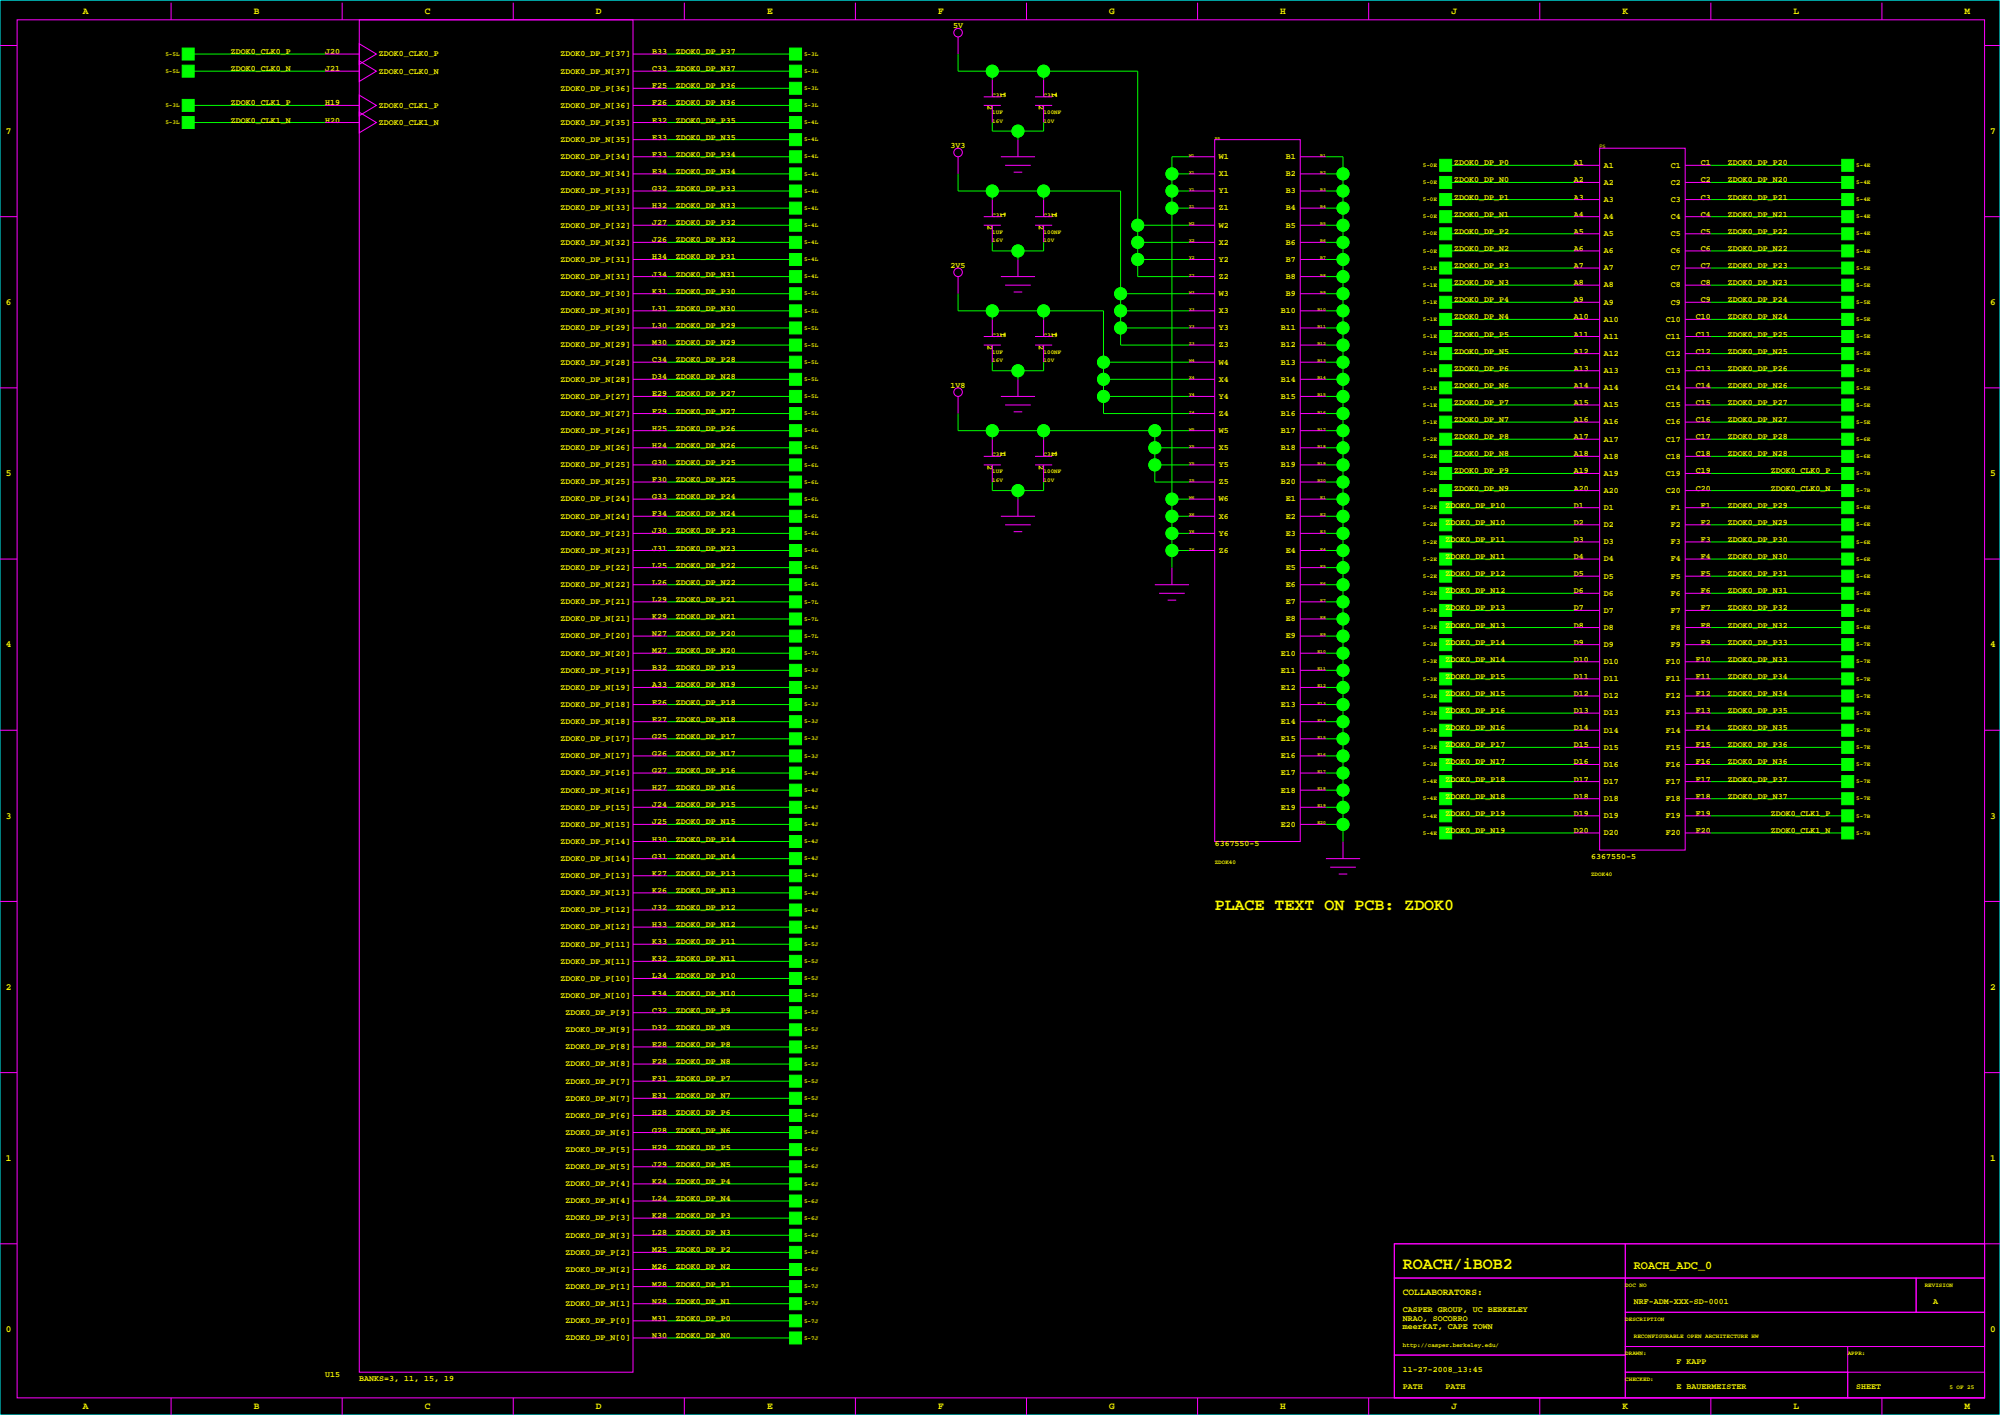
[picture p57: page 5]

PLACE TEXT ON PCB: ZDOK0

DOC NO
NRF-ADM-XXX-SD-0001

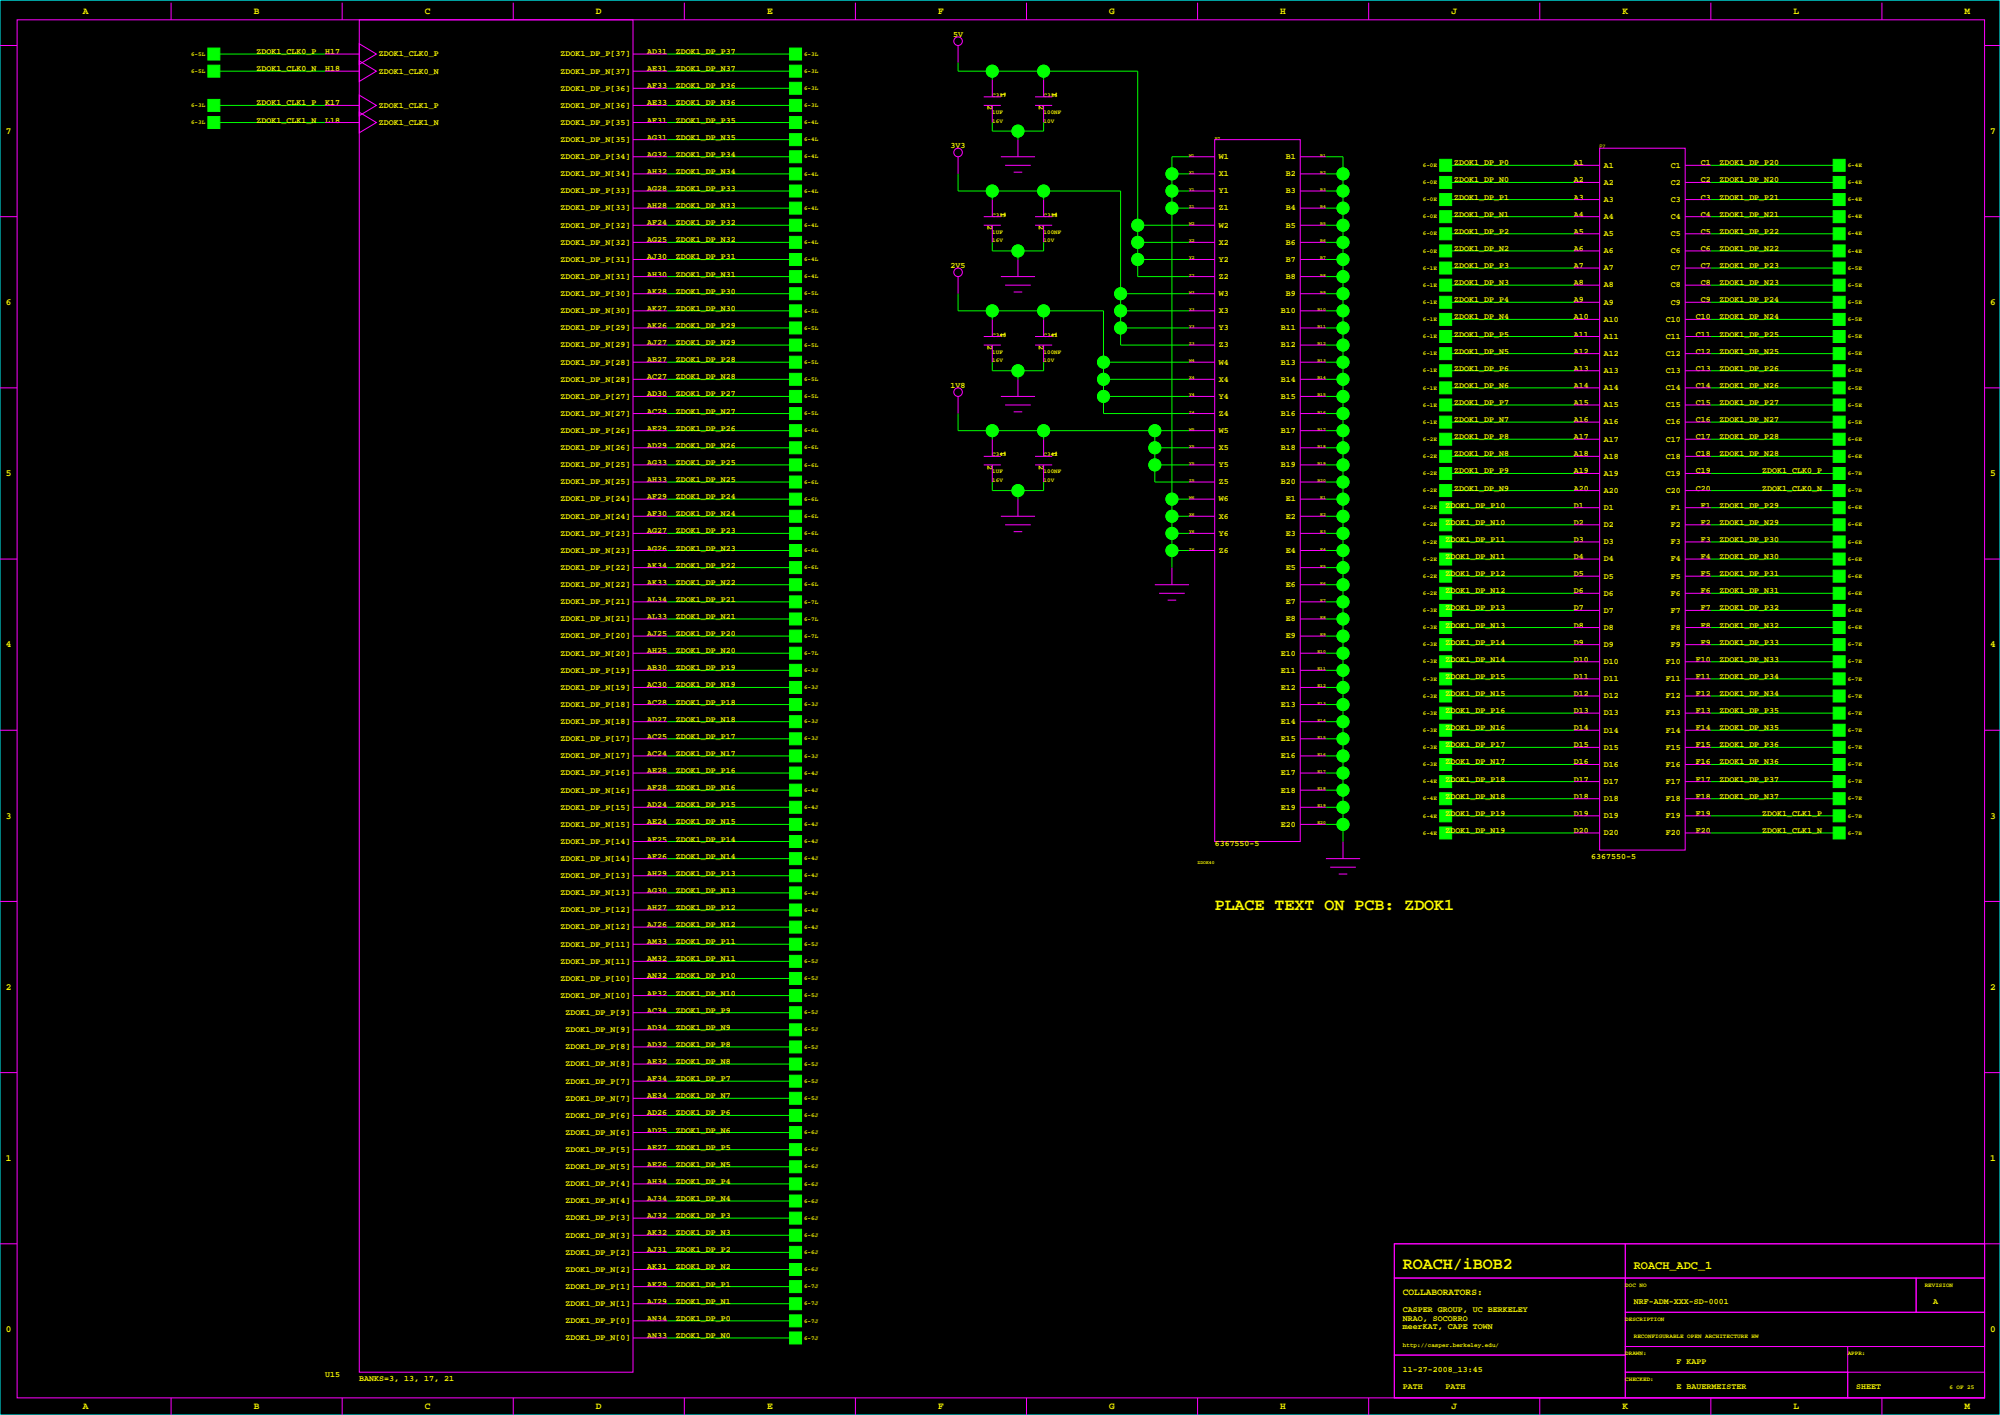
[picture p58: page 6]

PLACE TEXT ON PCB: ZDOK1

DOC NO
NRF-ADM-XXX-SD-0001

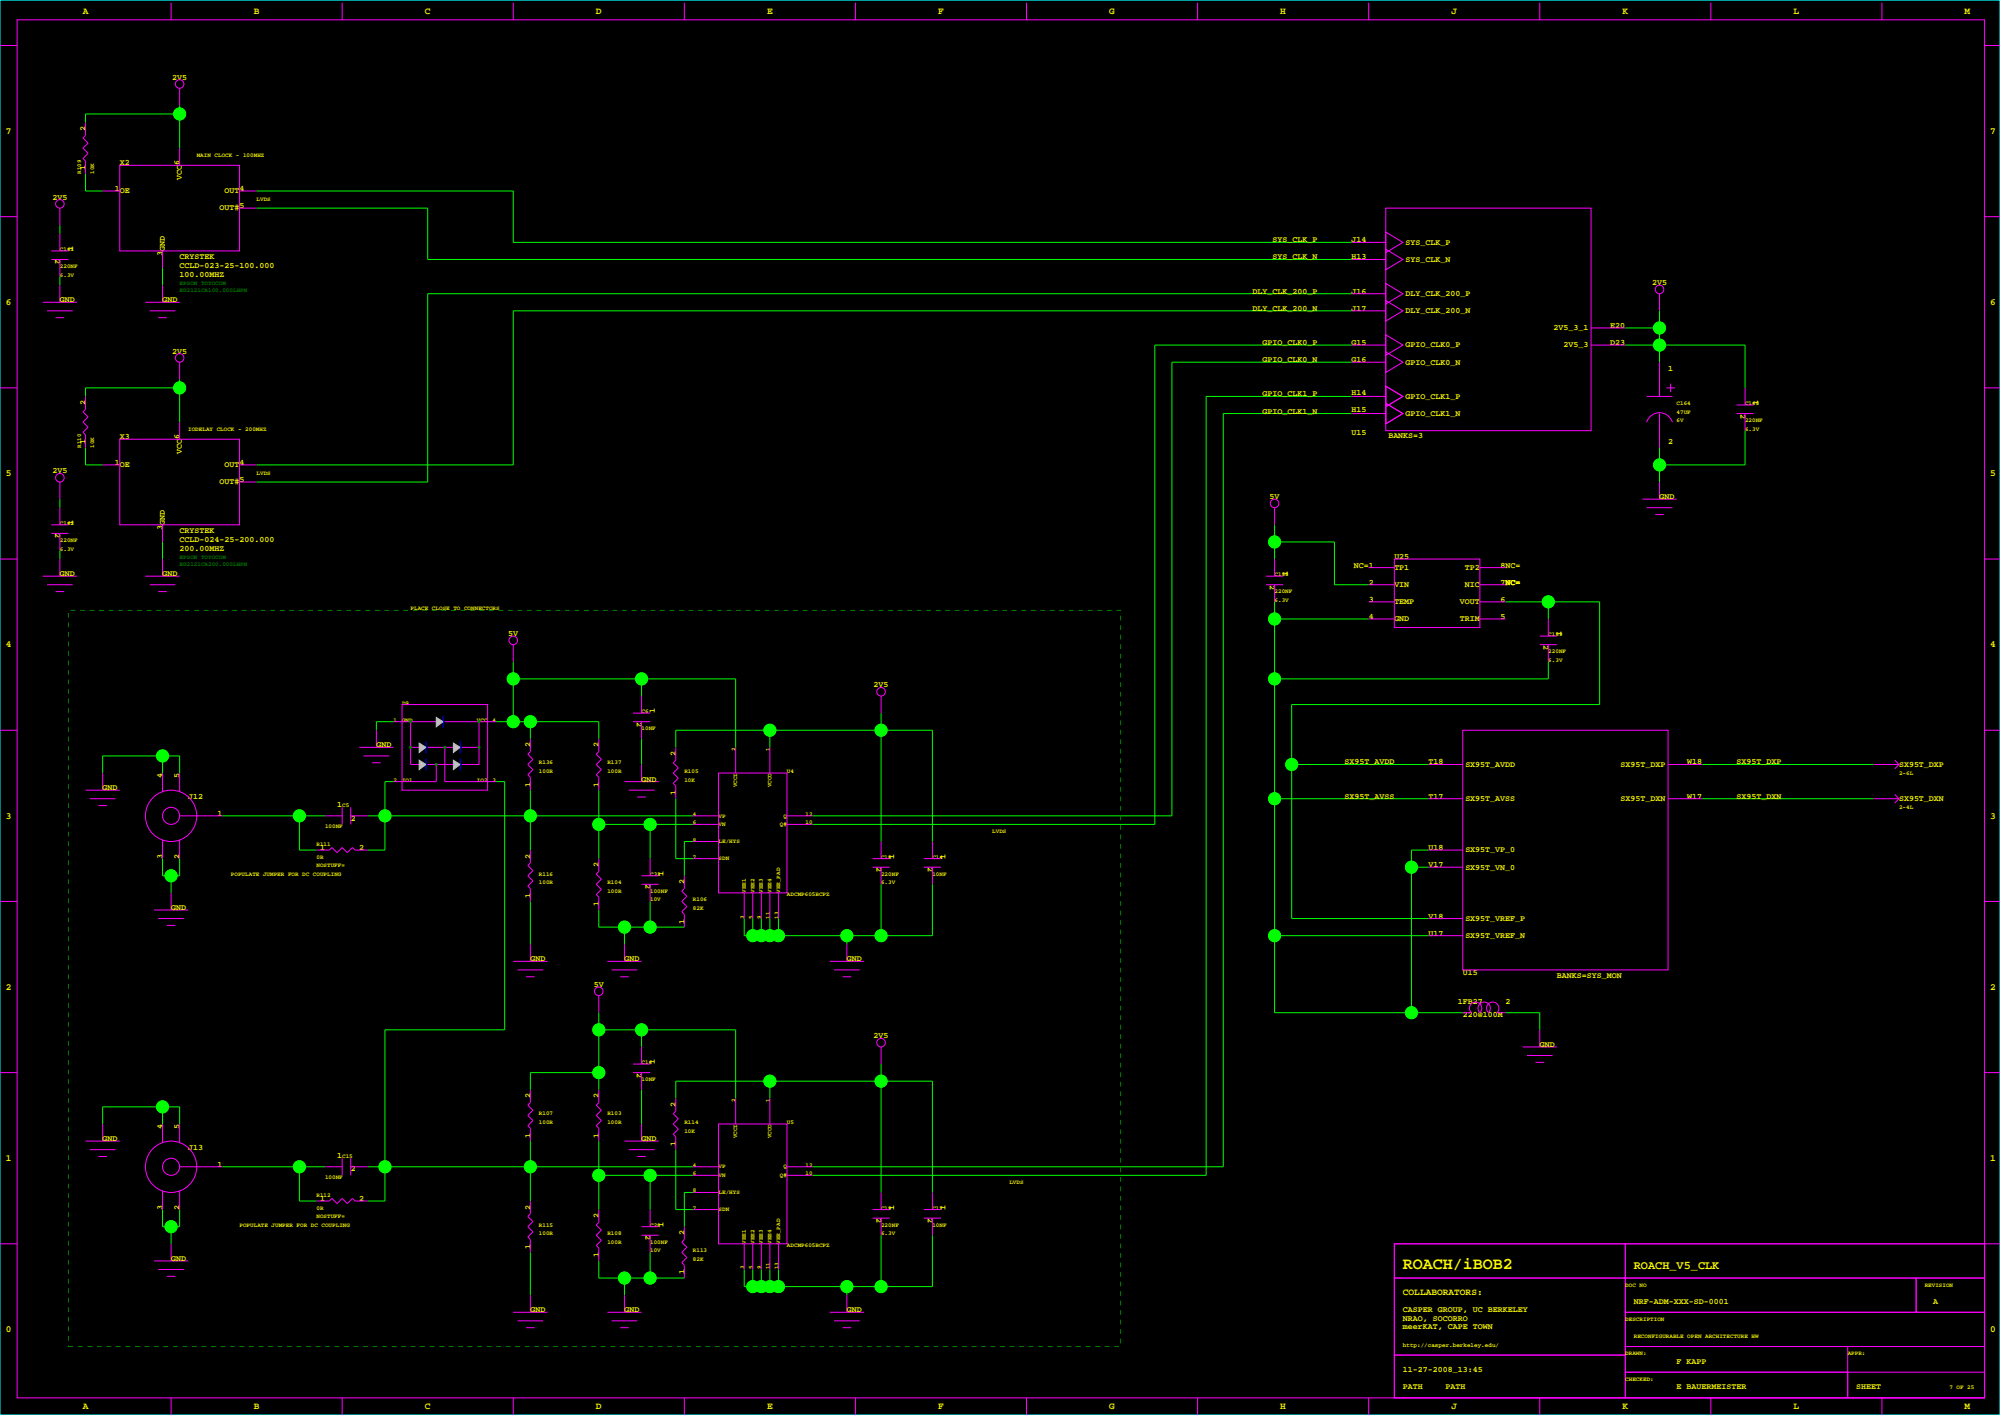
[picture p59: page 7]

PLACE CLOSE TO CONNECTORS

POPULATE JUMPER FOR DC COUPLING

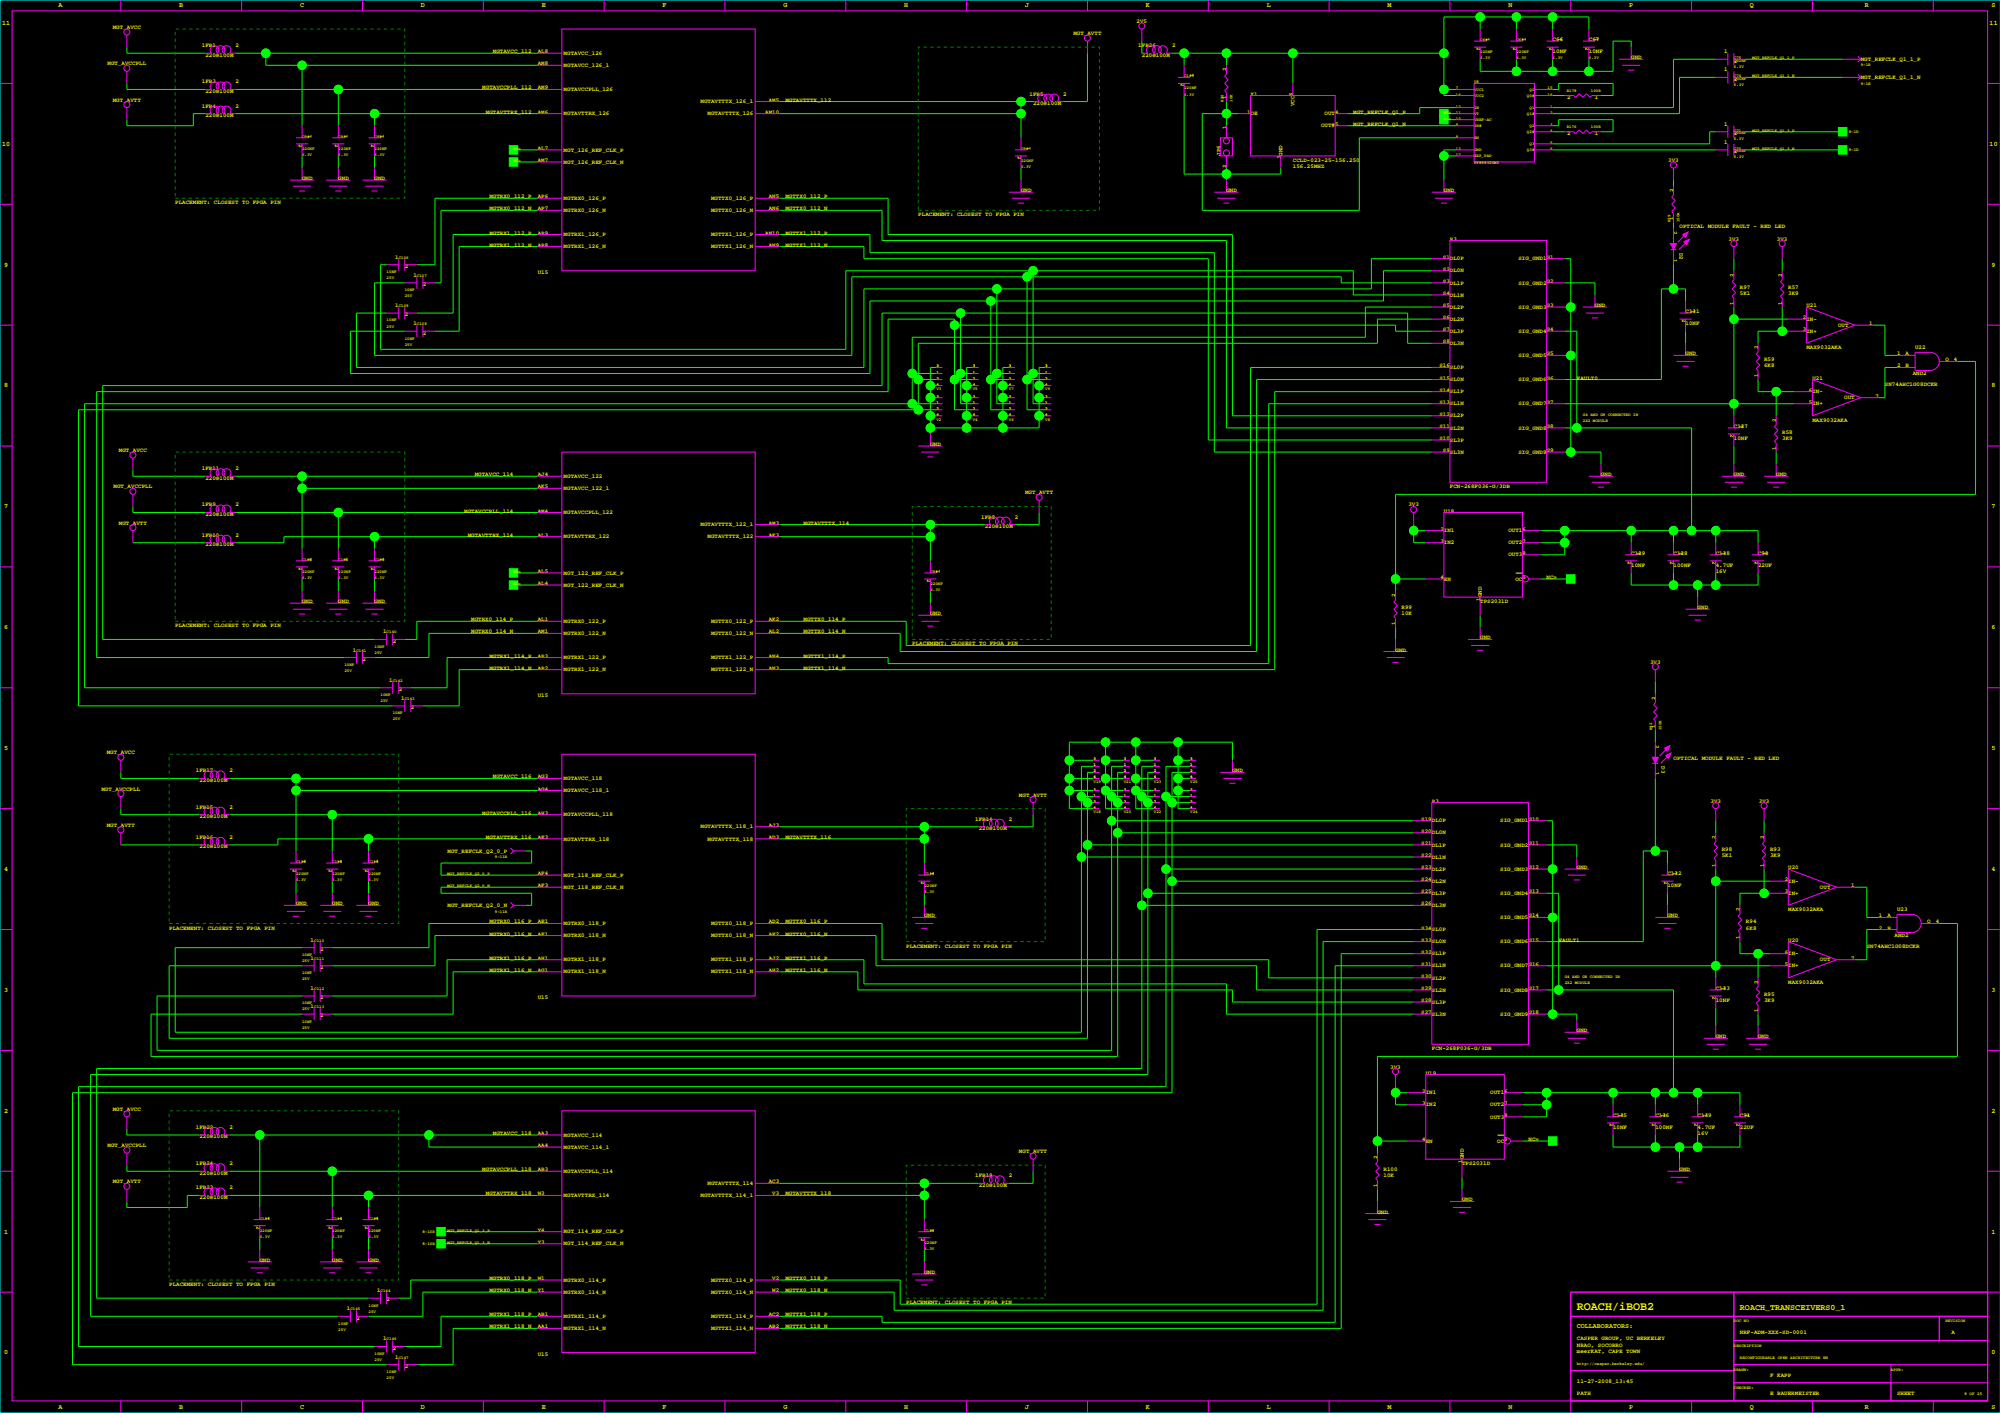
[picture p60: page 8]

PLACEMENT: CLOSEST TO FPGA PIN

OPTICAL MODULE FAULT - RED LED D2

2 1 OPTICAL MODULE FAULT - RED LED

S12 G8 | G4 AND G8 CONNECTED IN 2X2 MODULE

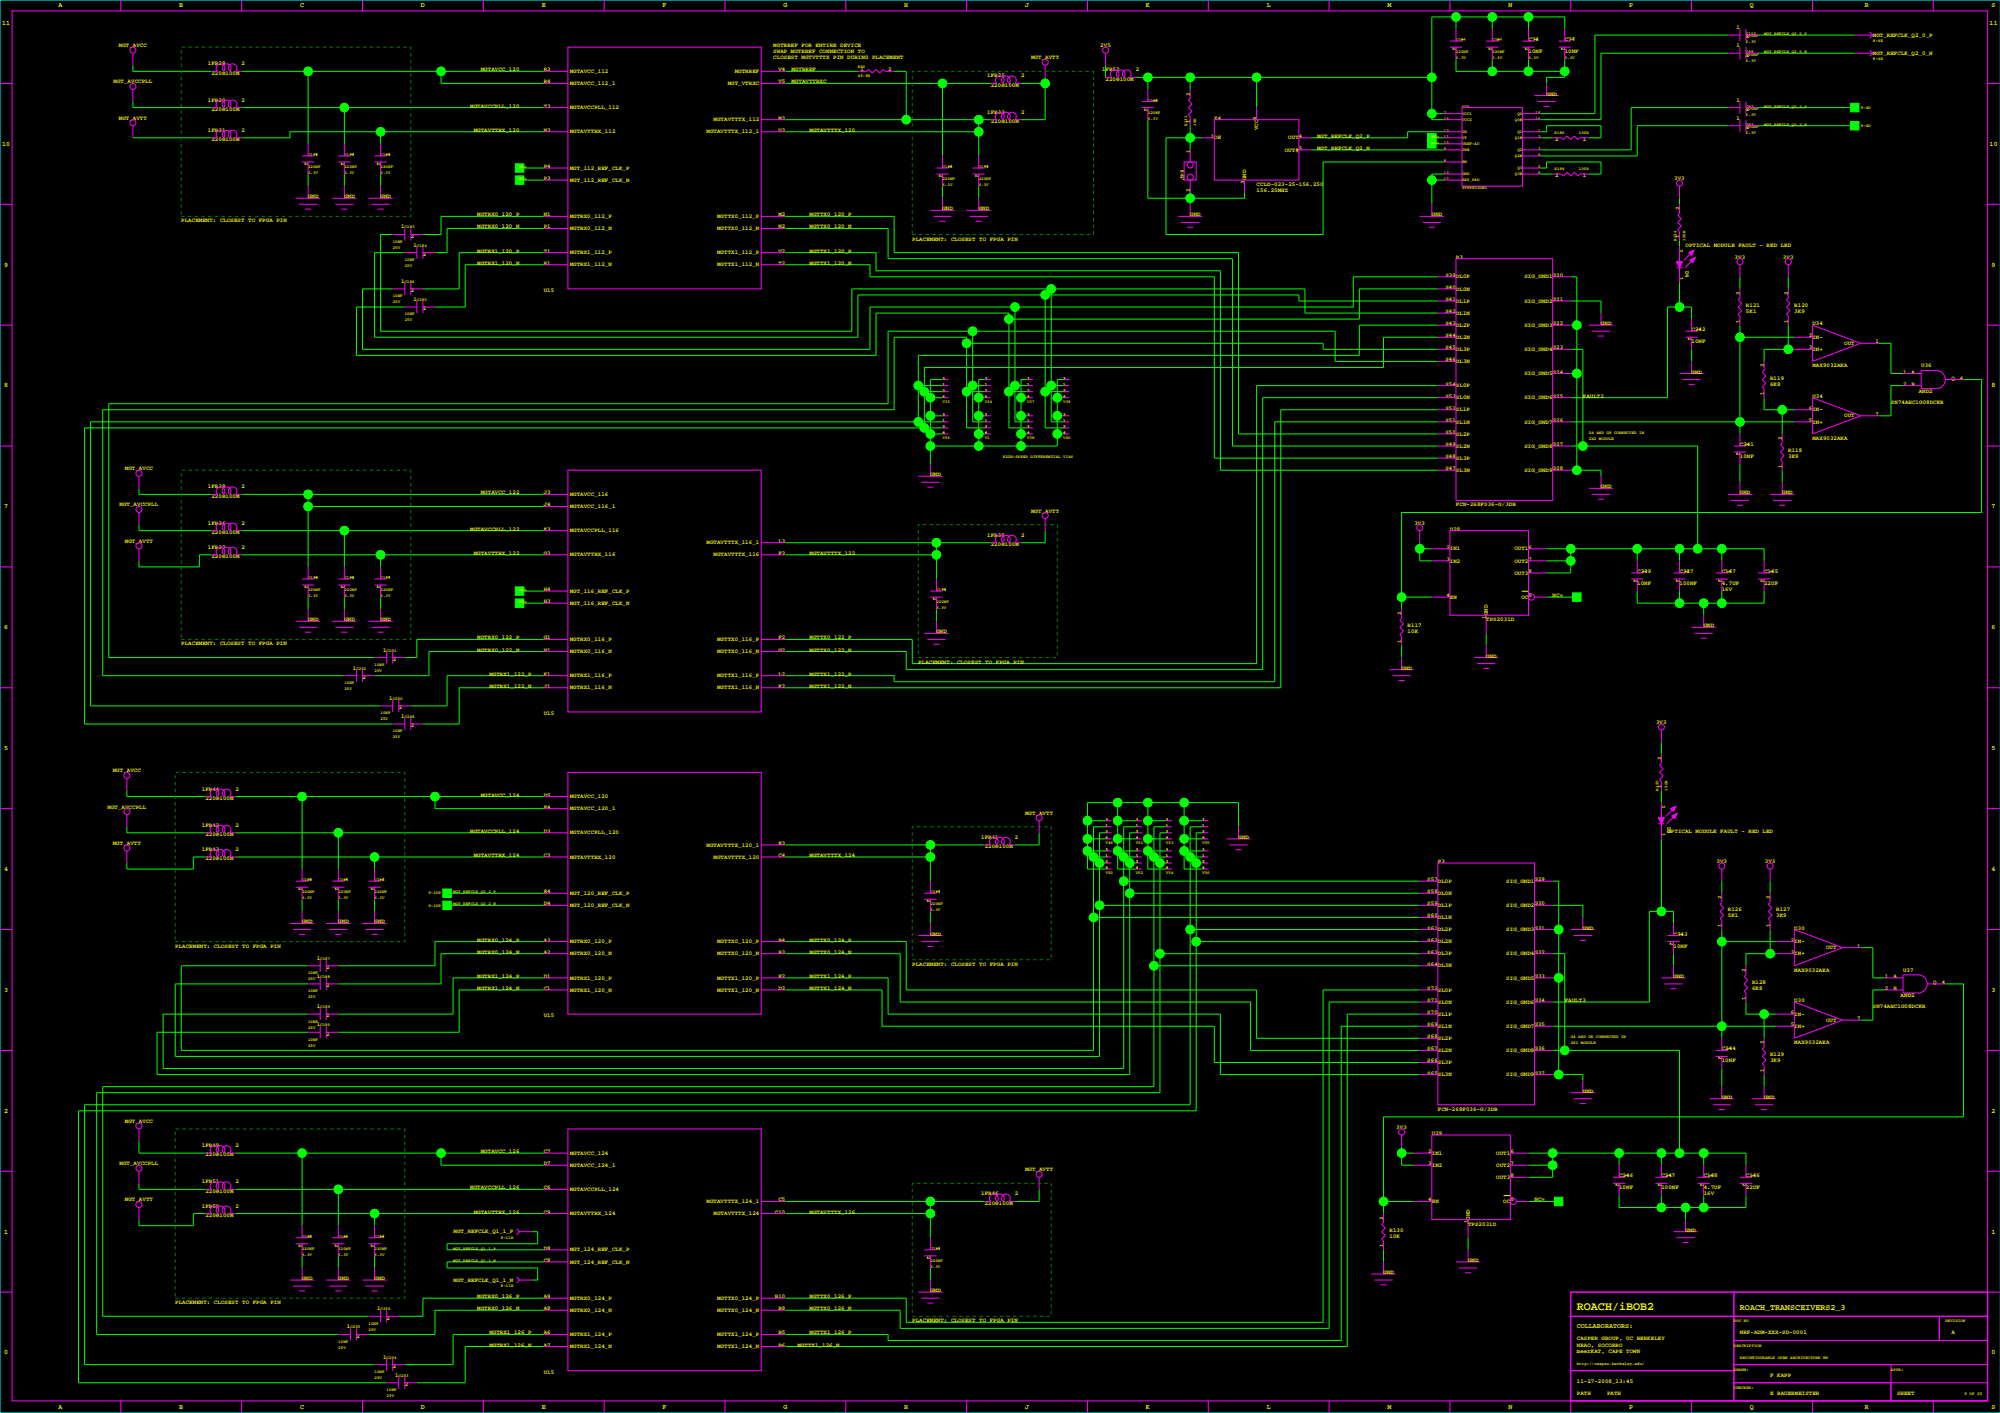
[picture p61: page 9]

MGTRREF FOR ENTIRE DEVICE
SWAP MGTRREF CONNECTION TO
CLOSEST MGTVTTTX PIN DURING PLACEMENT

PLACEMENT: CLOSEST TO FPGA PIN

D4 OPTICAL MODULE FAULT - RED LED 2 1

S50 G27 | G4 AND G8 CONNECTED IN 2X2 MODULE

HIGH-SPEED DIFFERENTIAL VIAS

OPTICAL MODULE FAULT - RED LED D5

U55 | TPS74401RGWT 21 | 12
U57 | TPS74401RGWT 21 | 12

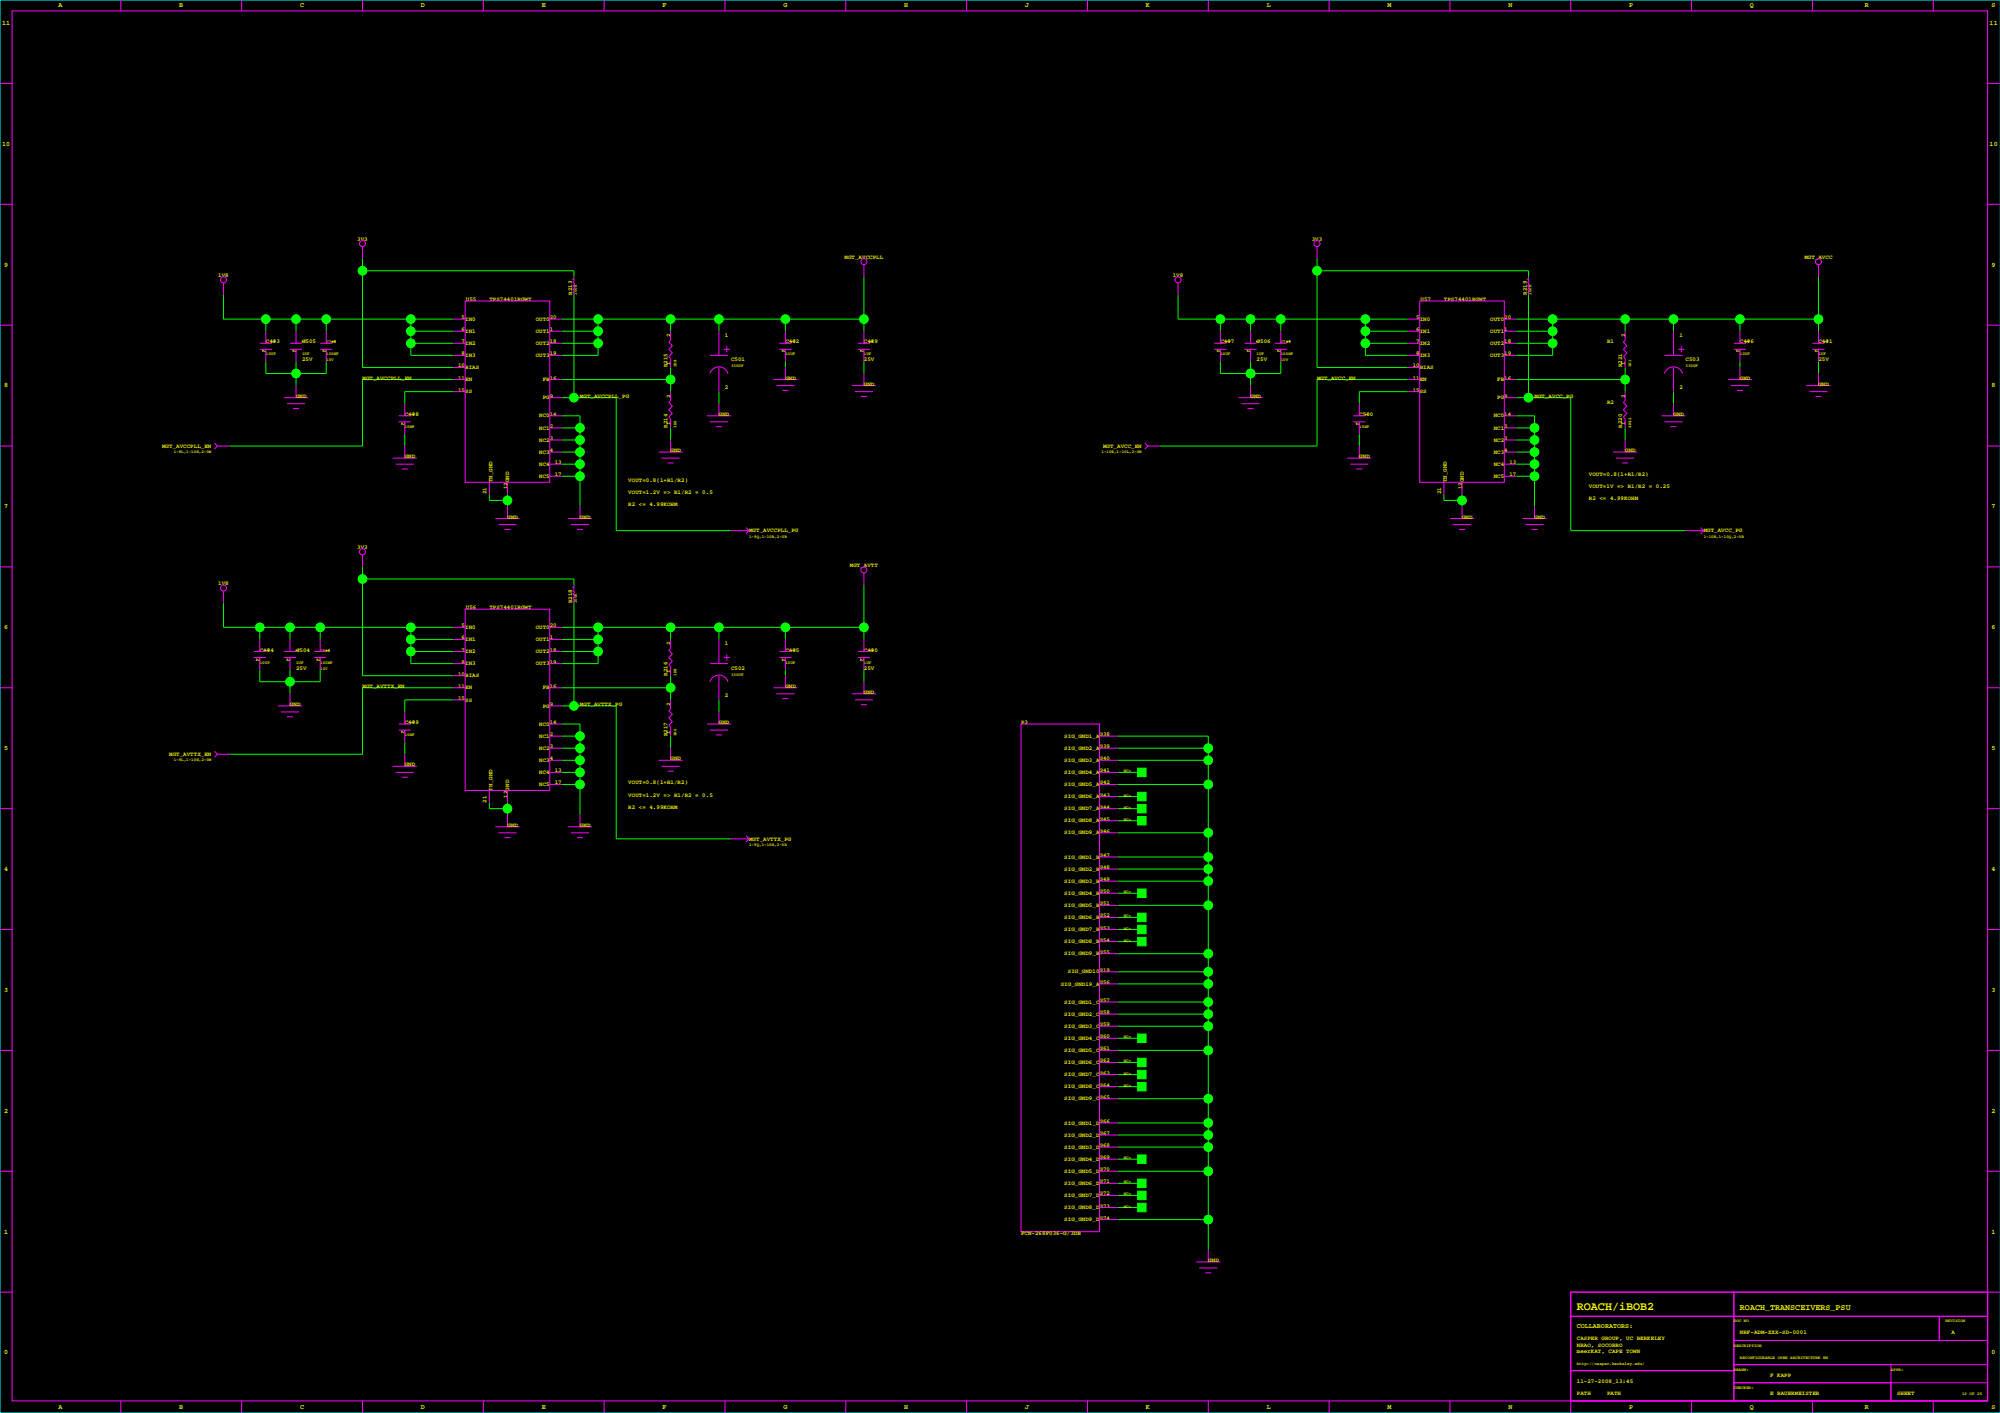
[picture p62: page 10]

C388

C389

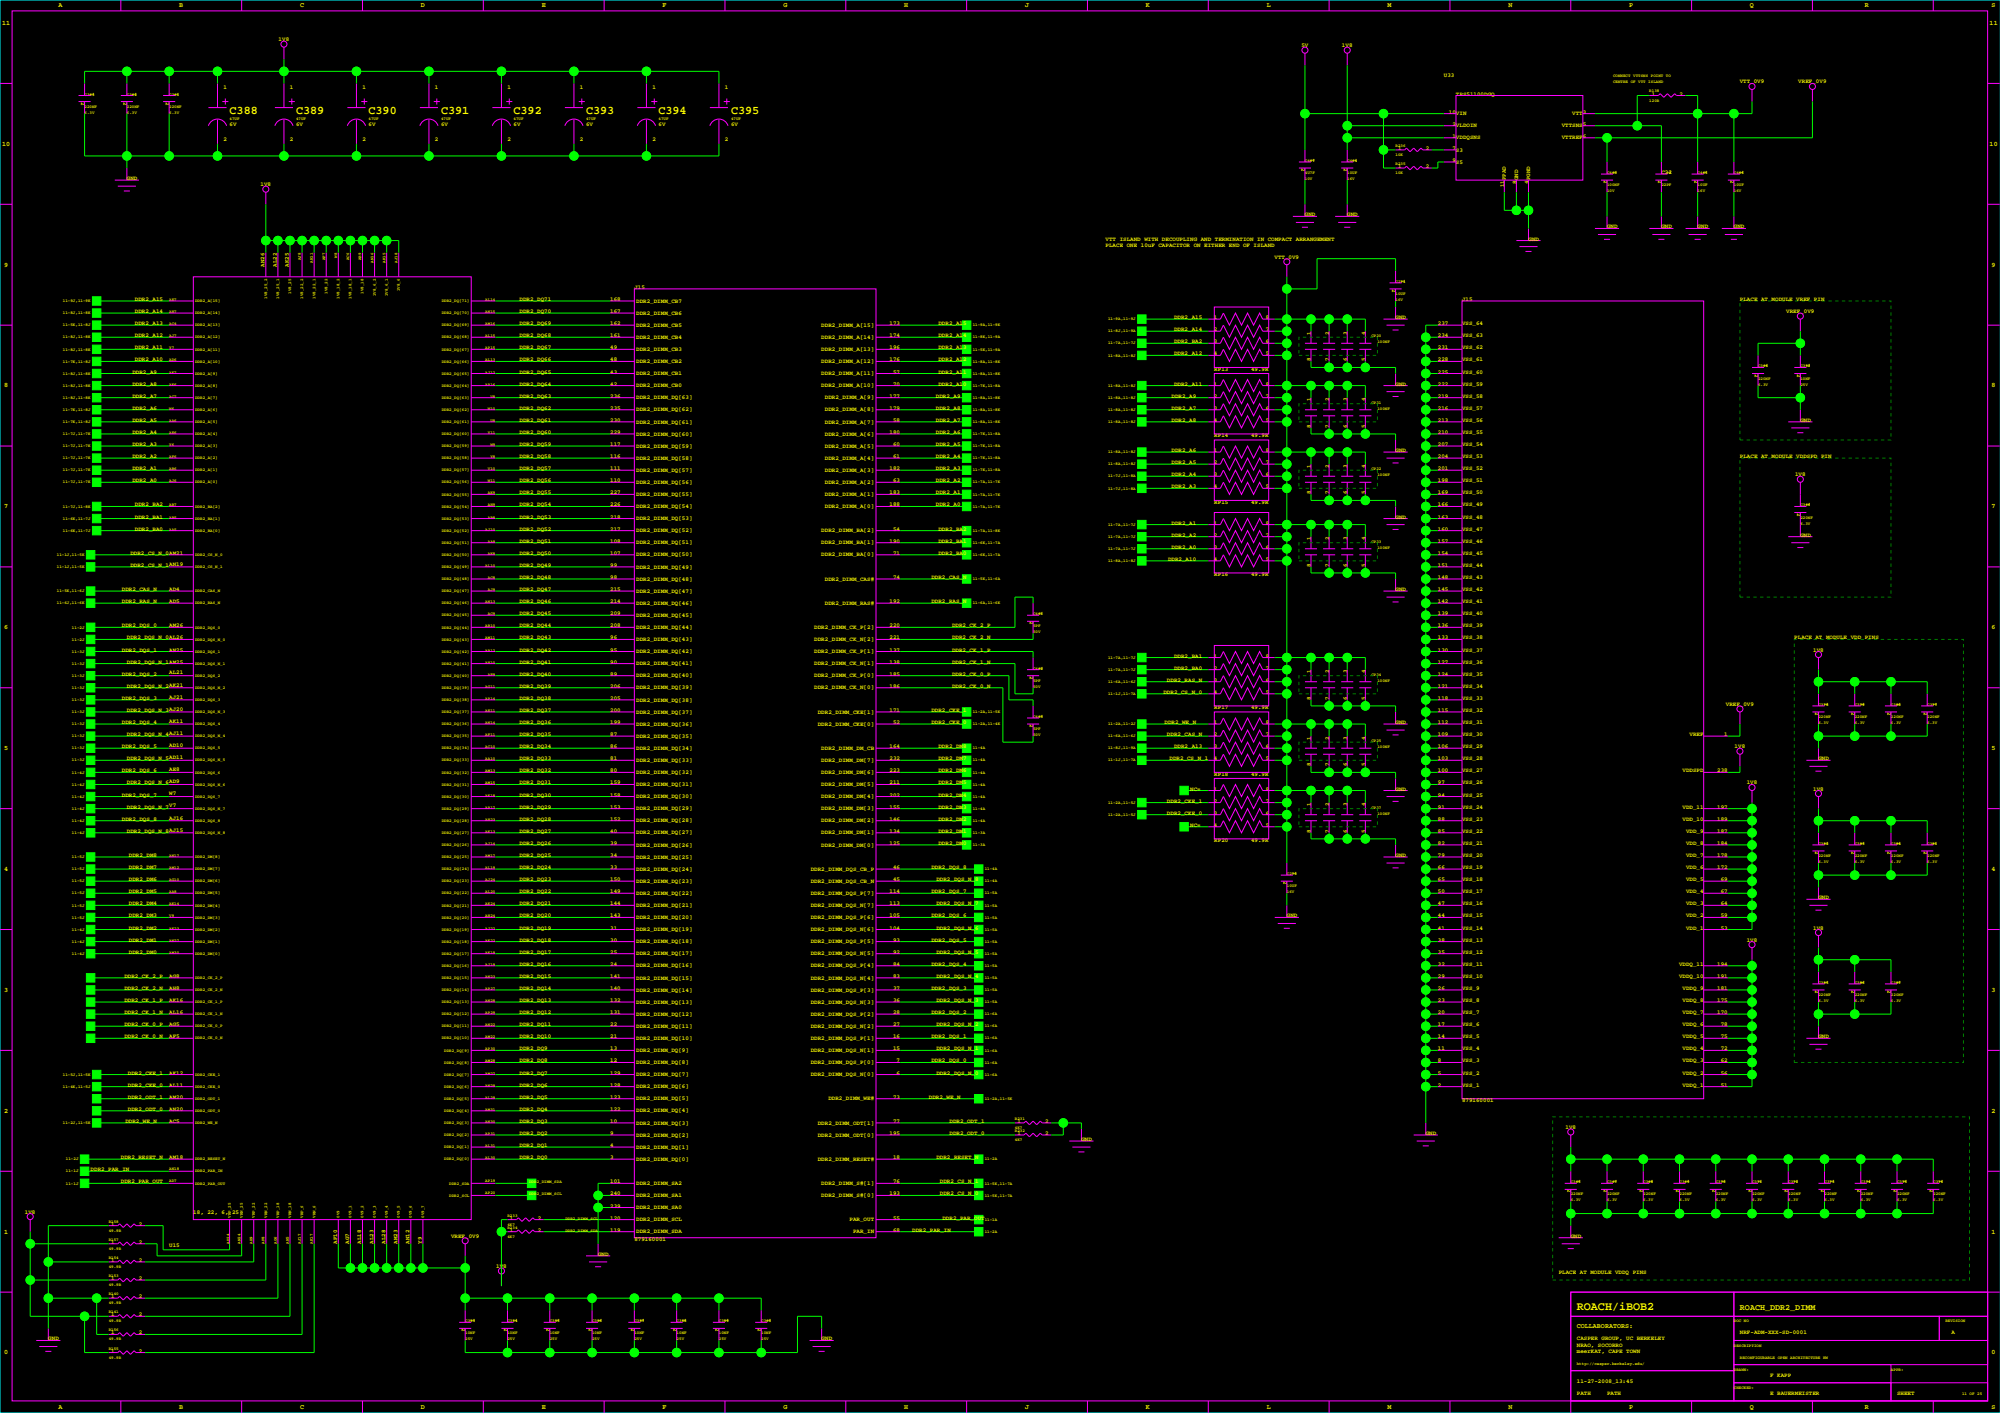
[picture p63: page 11]

CONNECT VTTSNS POINT TO
CENTRE OF VTT ISLAND

VTT ISLAND WITH DECOUPLING AND TERMINATION IN COMPACT ARRANGEMENT
PLACE ONE 10uF CAPACITOR ON EITHER END OF ISLAND

PLACE AT MODULE VREF PIN

PLACE AT MODULE VDDSPD PIN

PLACE AT MODULE VDD PINS

PLACE AT MODULE VDDQ PINS

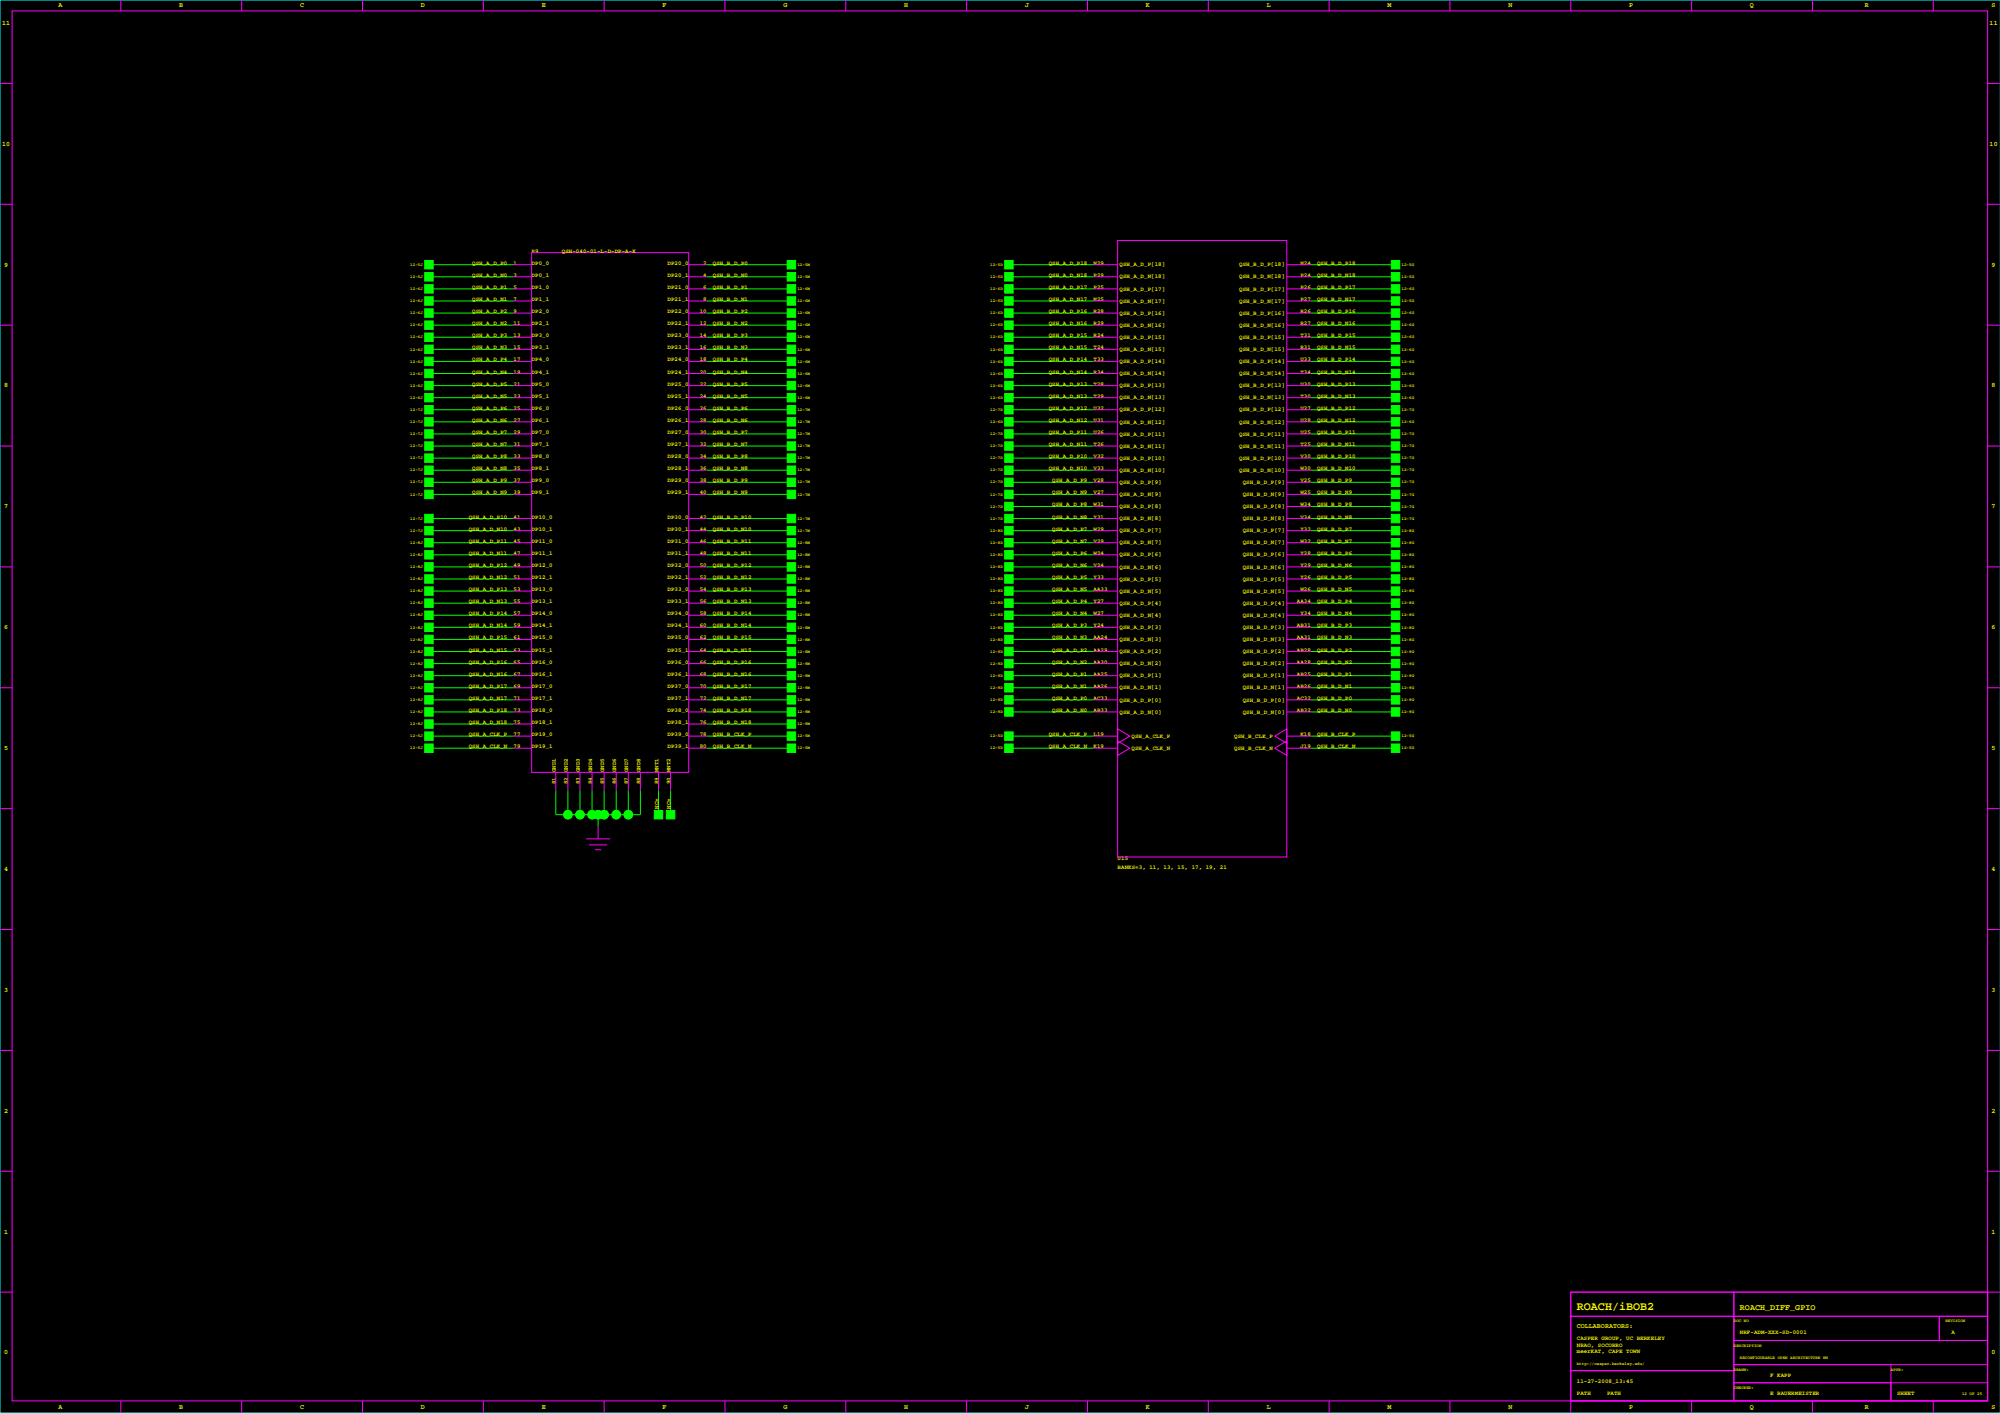
[picture p64: page 12]

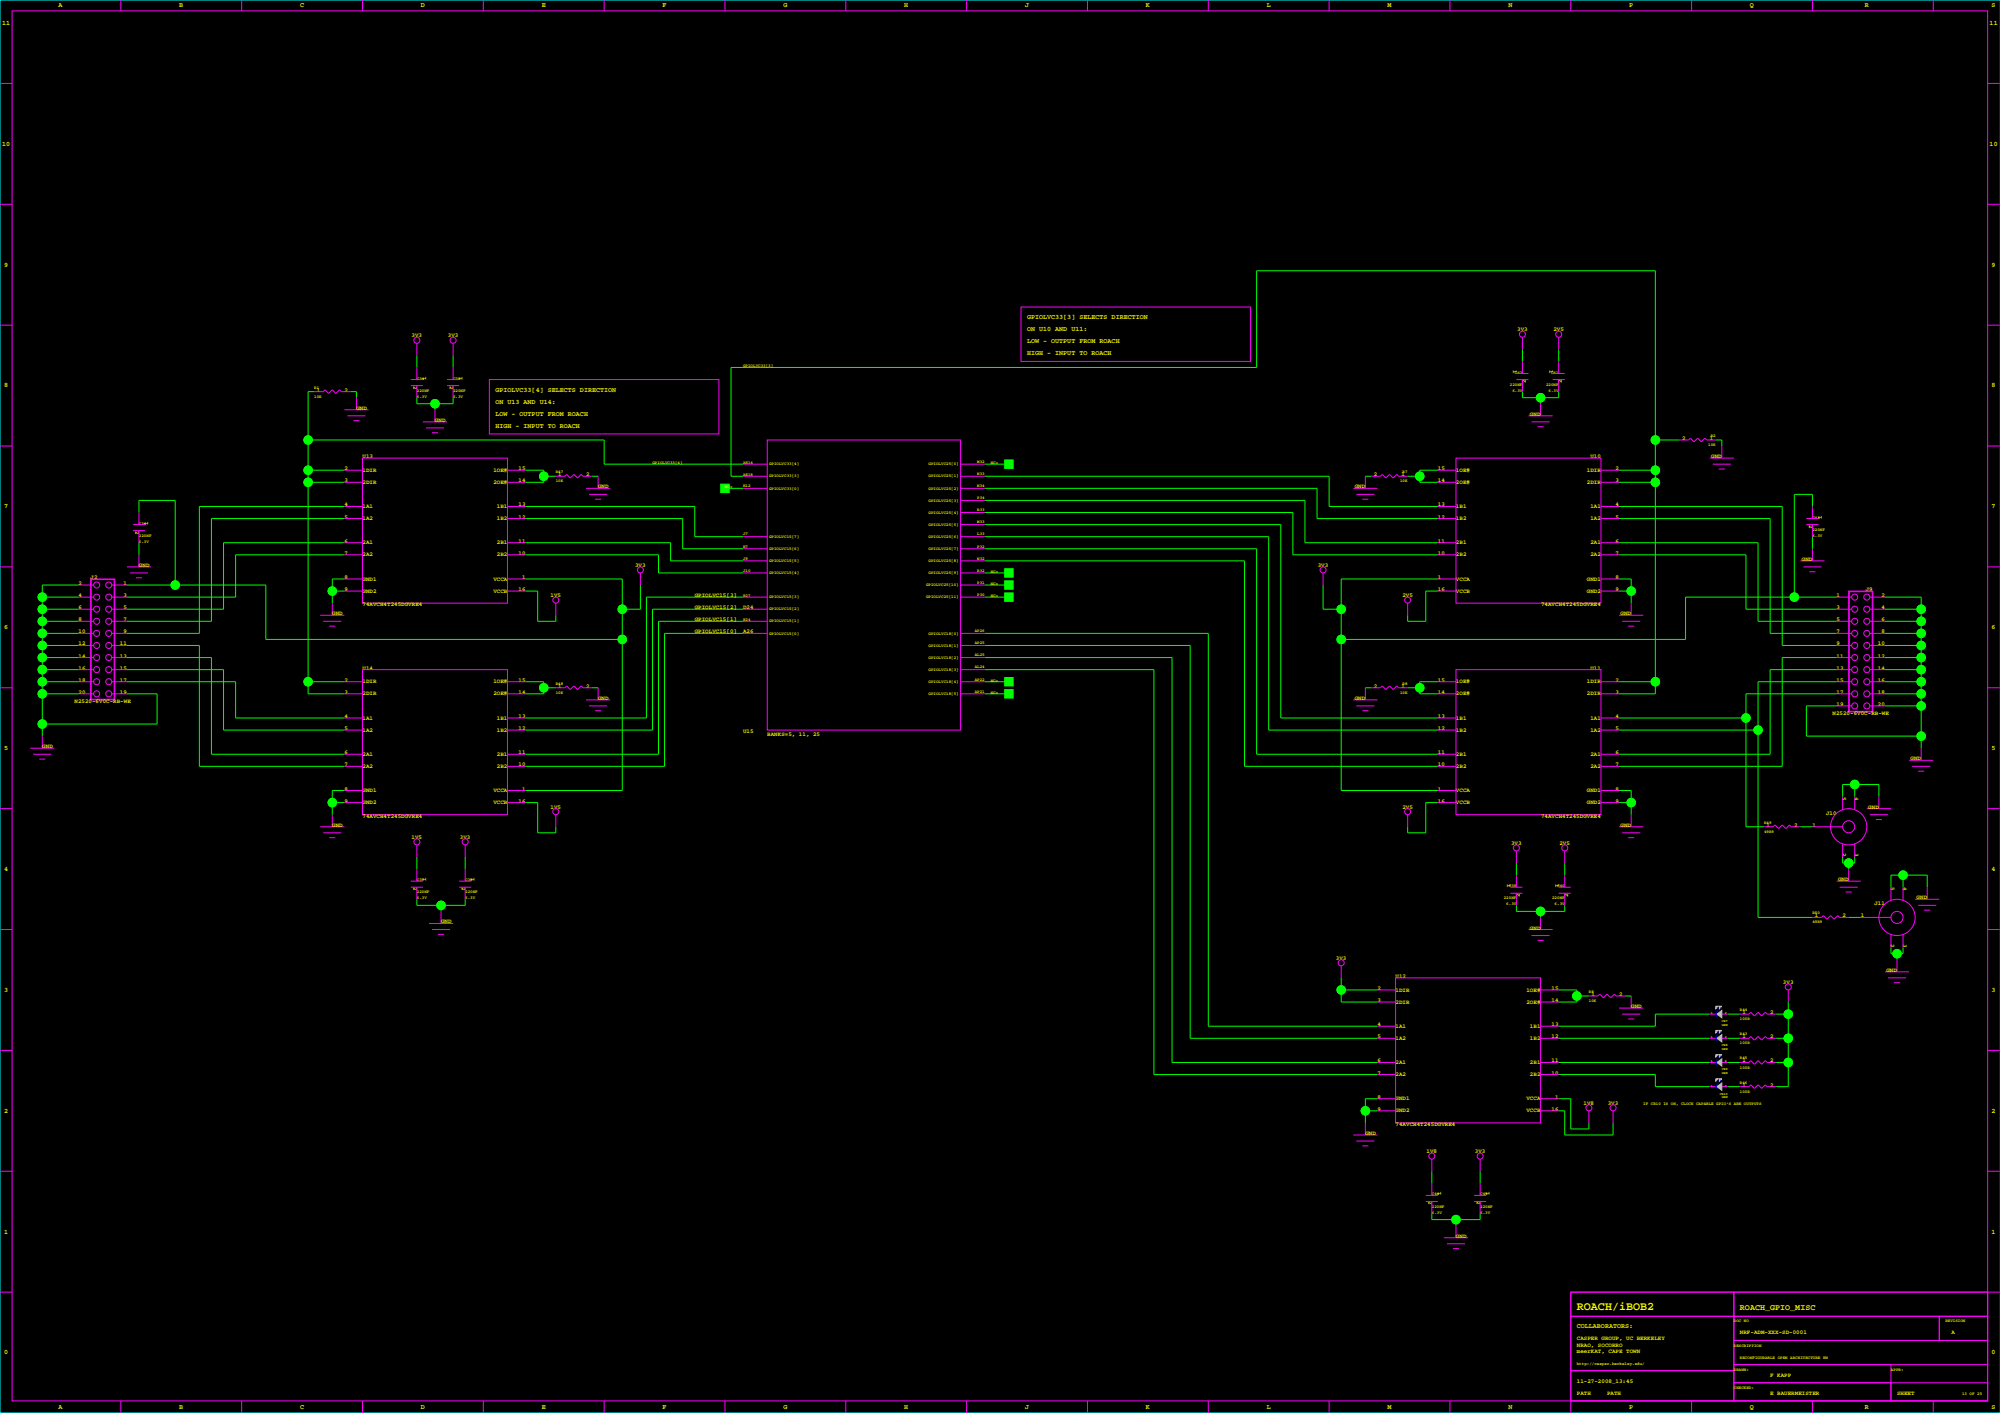
[picture p65: page 13]

GPIOLVC33[3] SELECTS DIRECTION
ON U10 AND U11:
LOW - OUTPUT FROM ROACH
HIGH - INPUT TO ROACH

GPIOLVC33[4] SELECTS DIRECTION
ON U13 AND U14:

IF CR10 IS ON, CLOCK CAPABLE GPIO'S ARE OUTPUTS

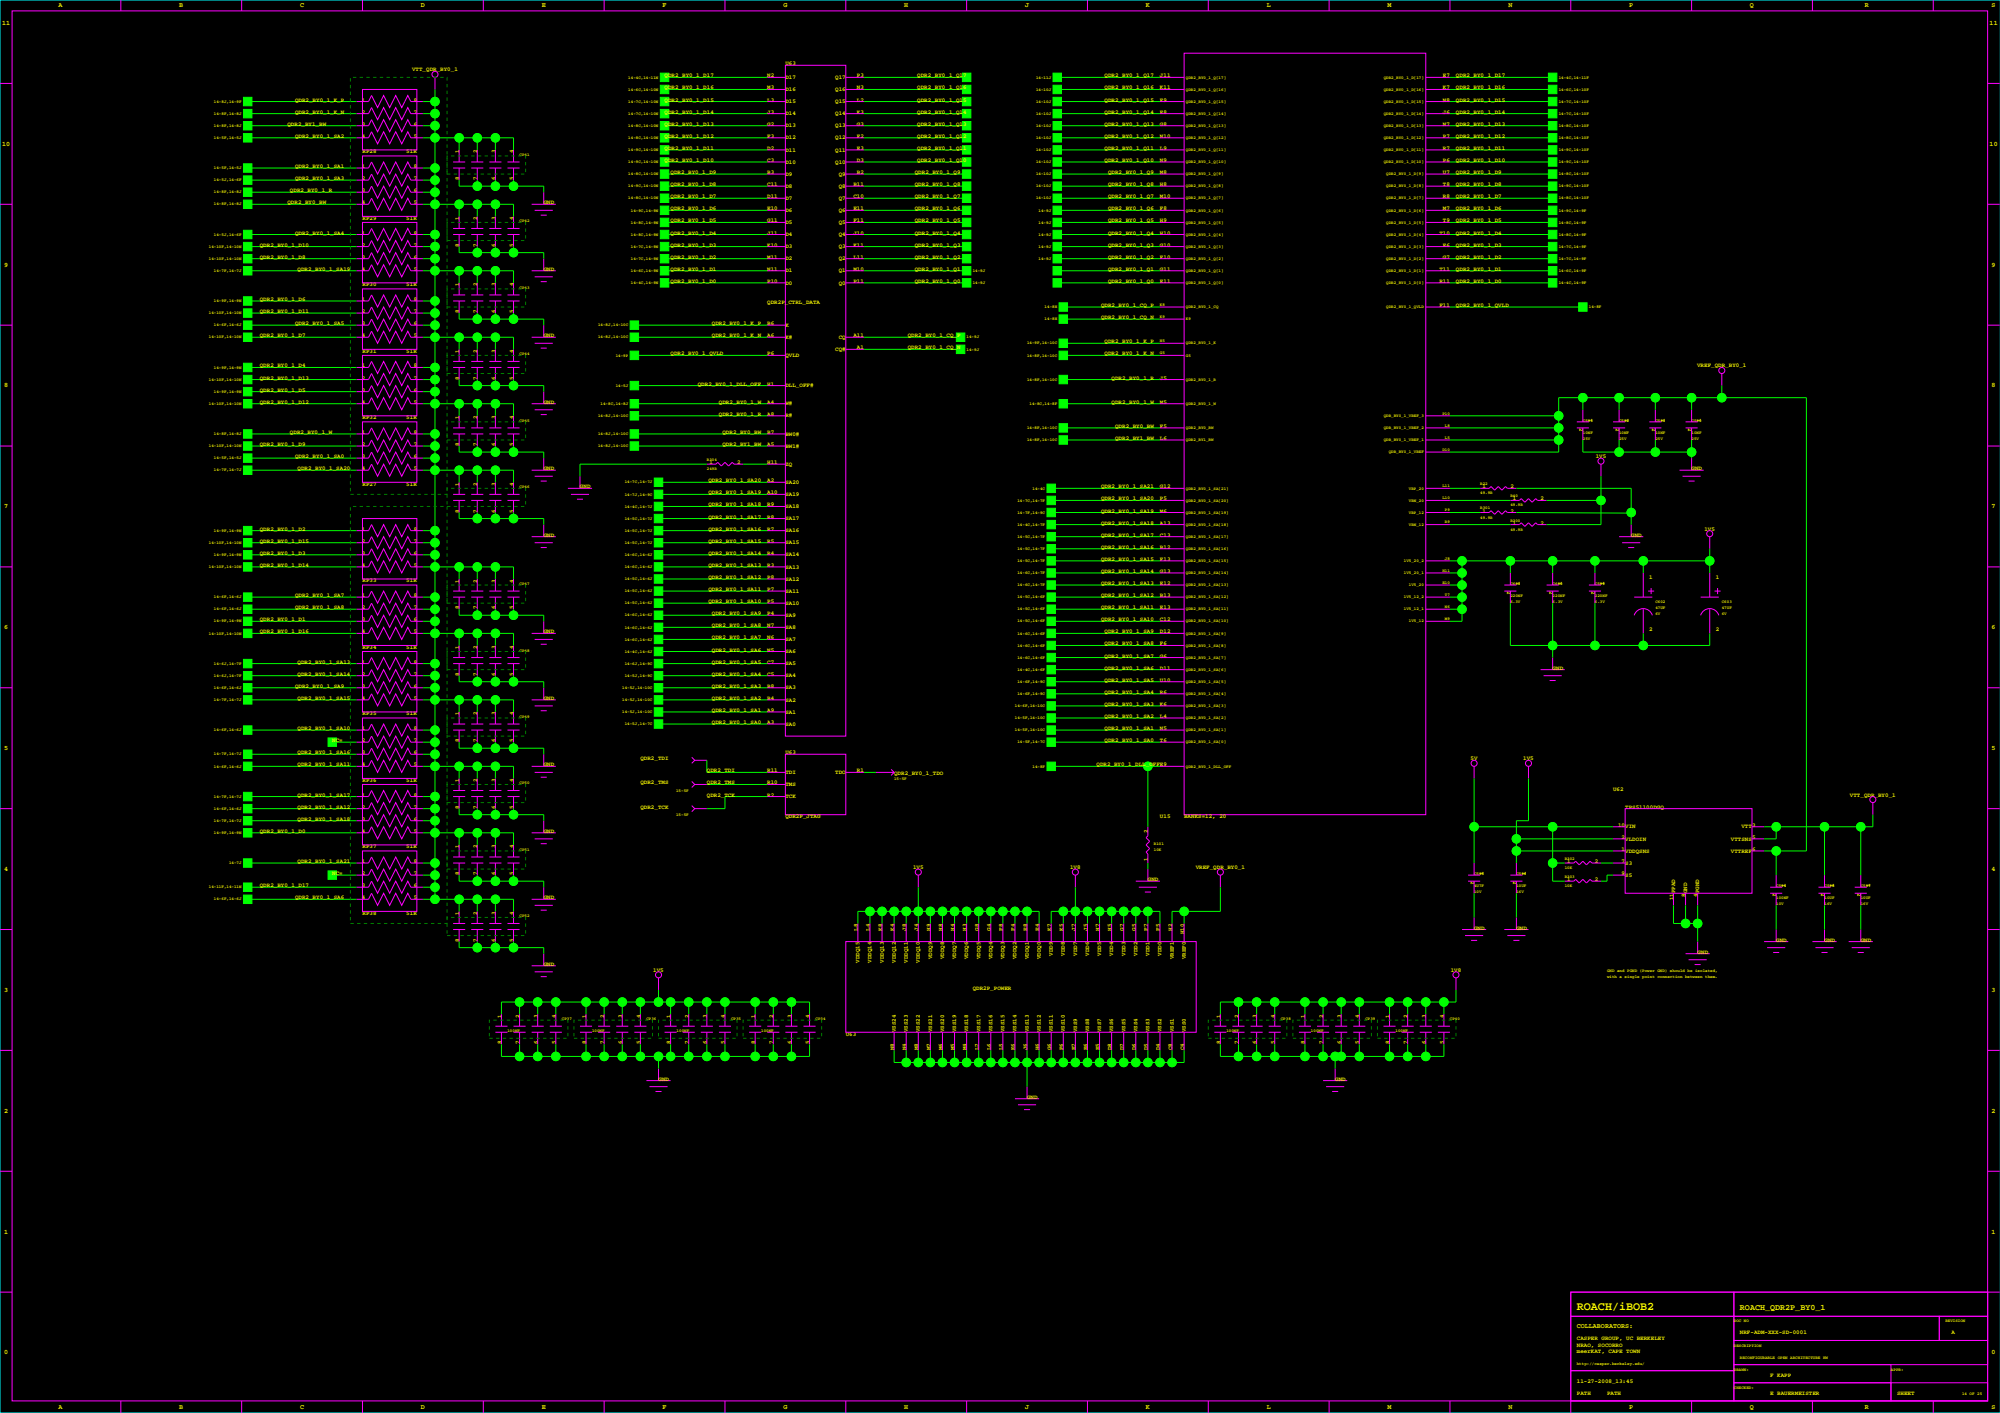
[picture p66: page 14]

GND and PGND (Power GND) should be isolated,
with a single point connection between them.

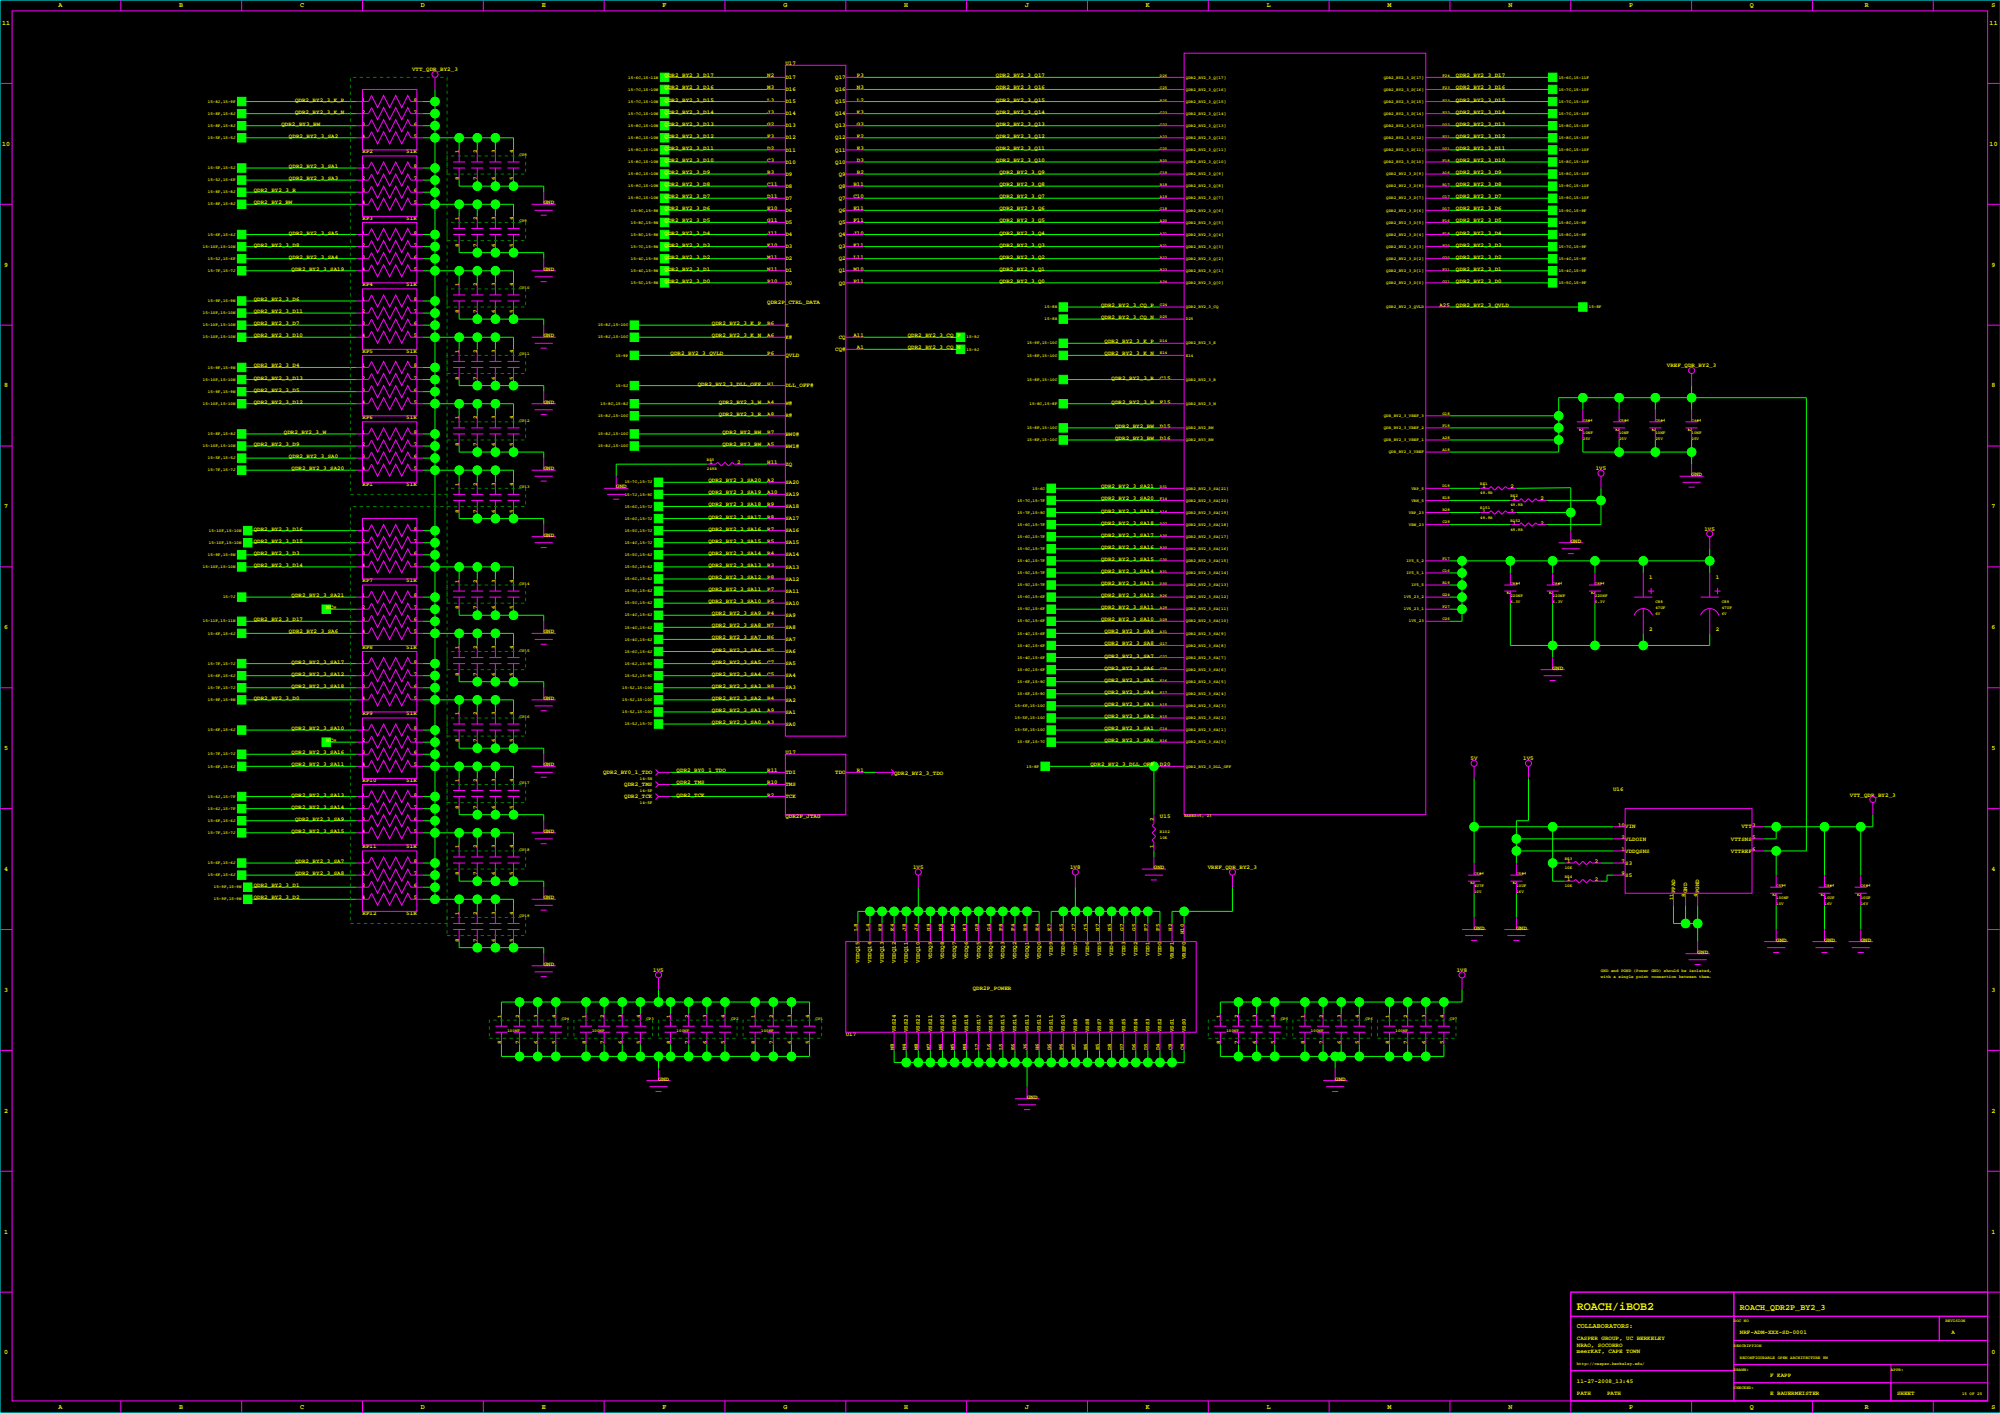
[picture p67: page 15]

GND and PGND (Power GND) should be isolated,
with a single point connection between them.

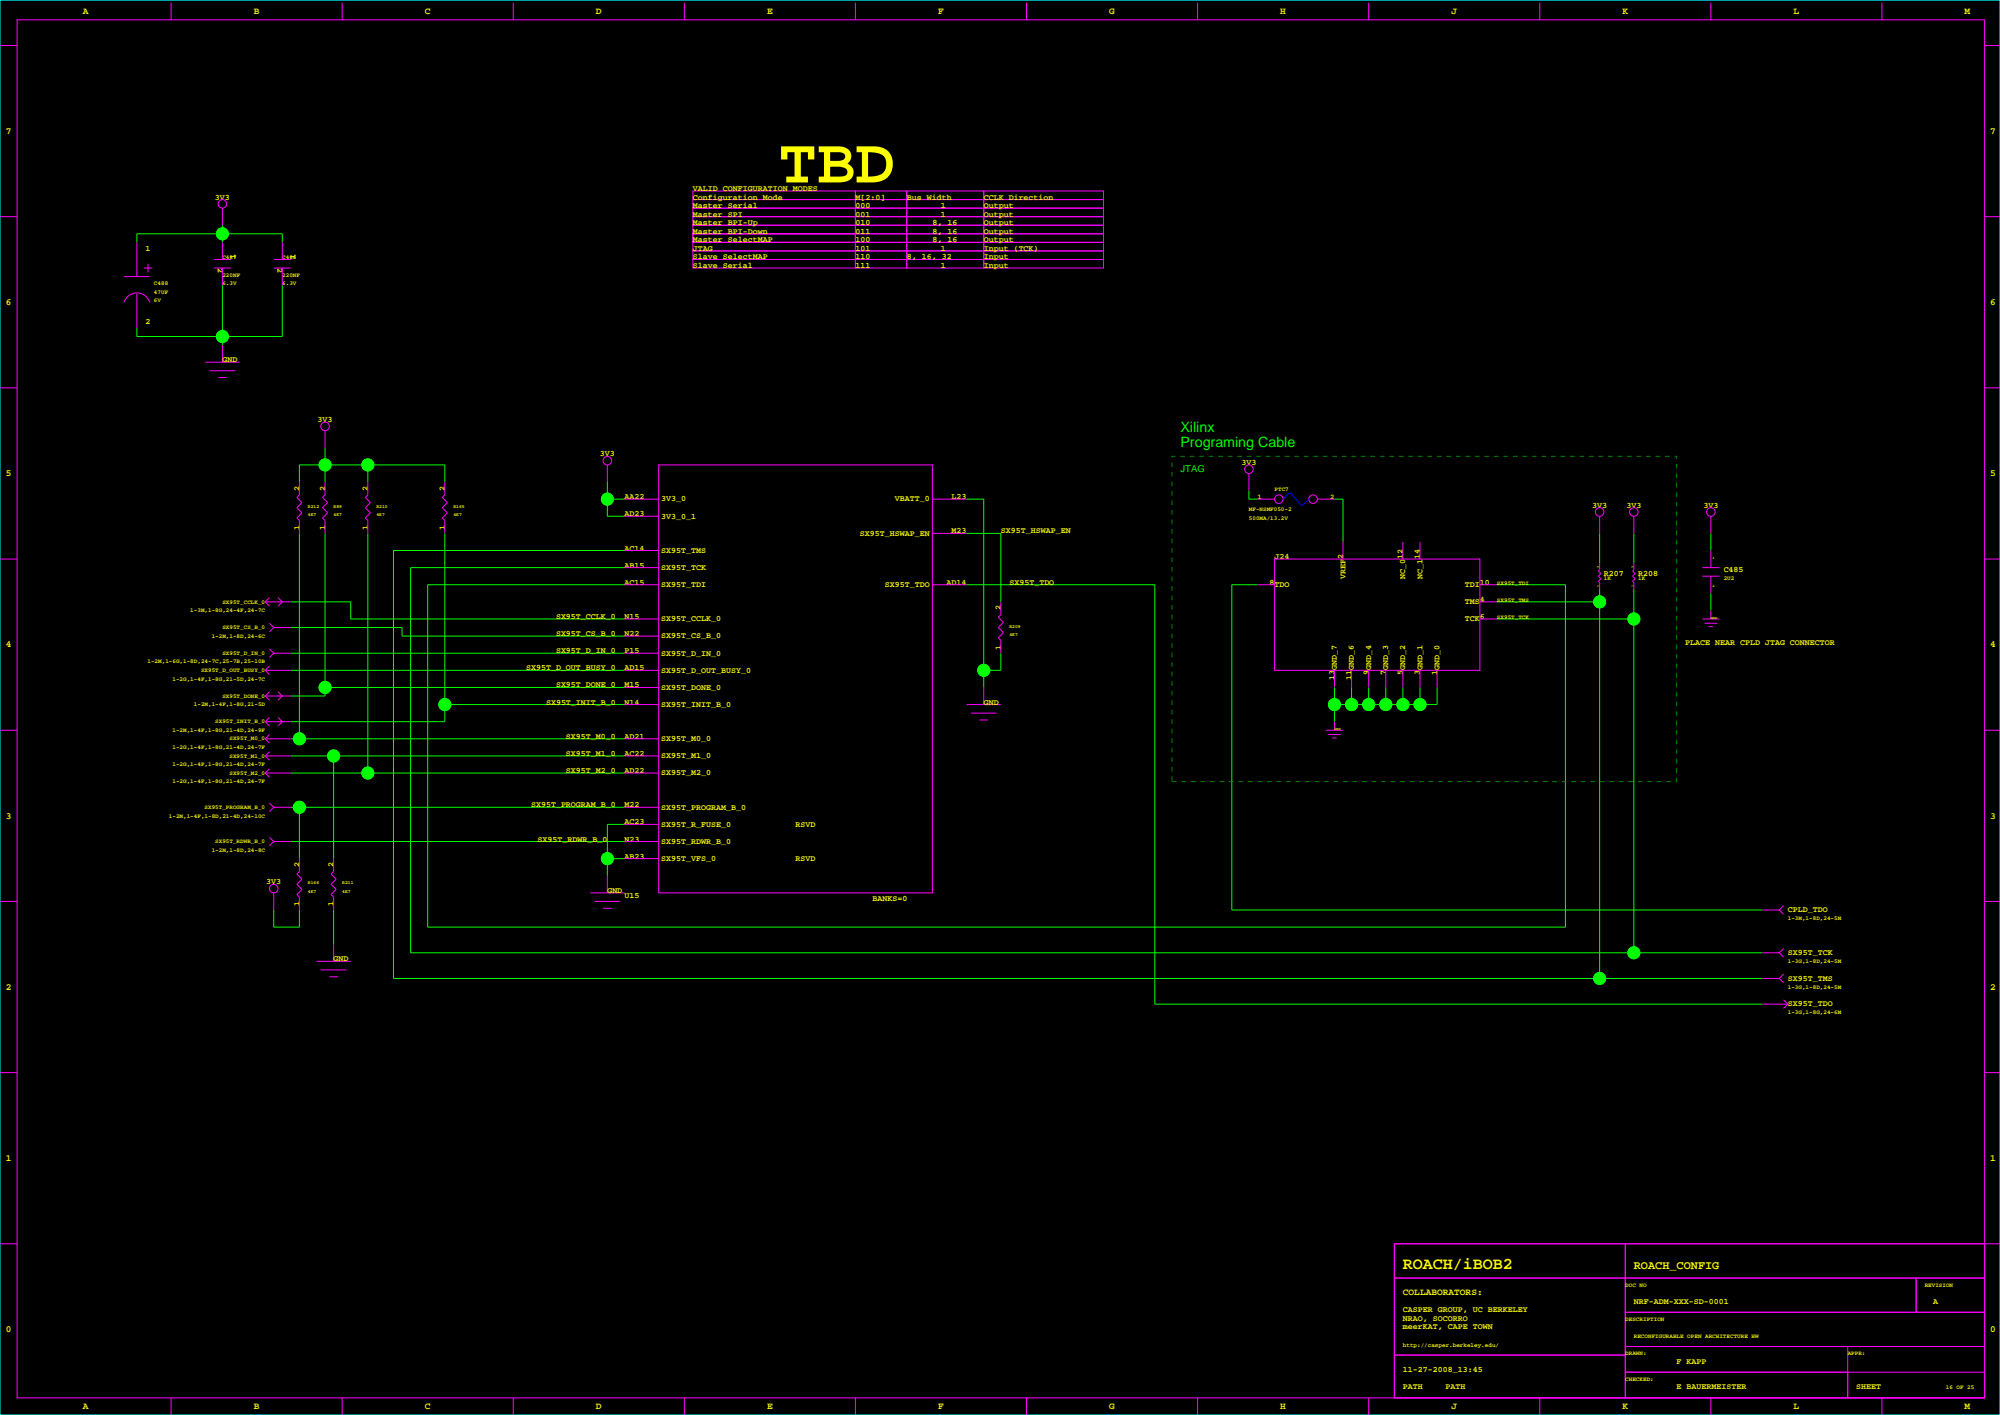
[picture p68: page 16]

VALID CONFIGURATION MODES TBD

PLACE NEAR CPLD JTAG CONNECTOR

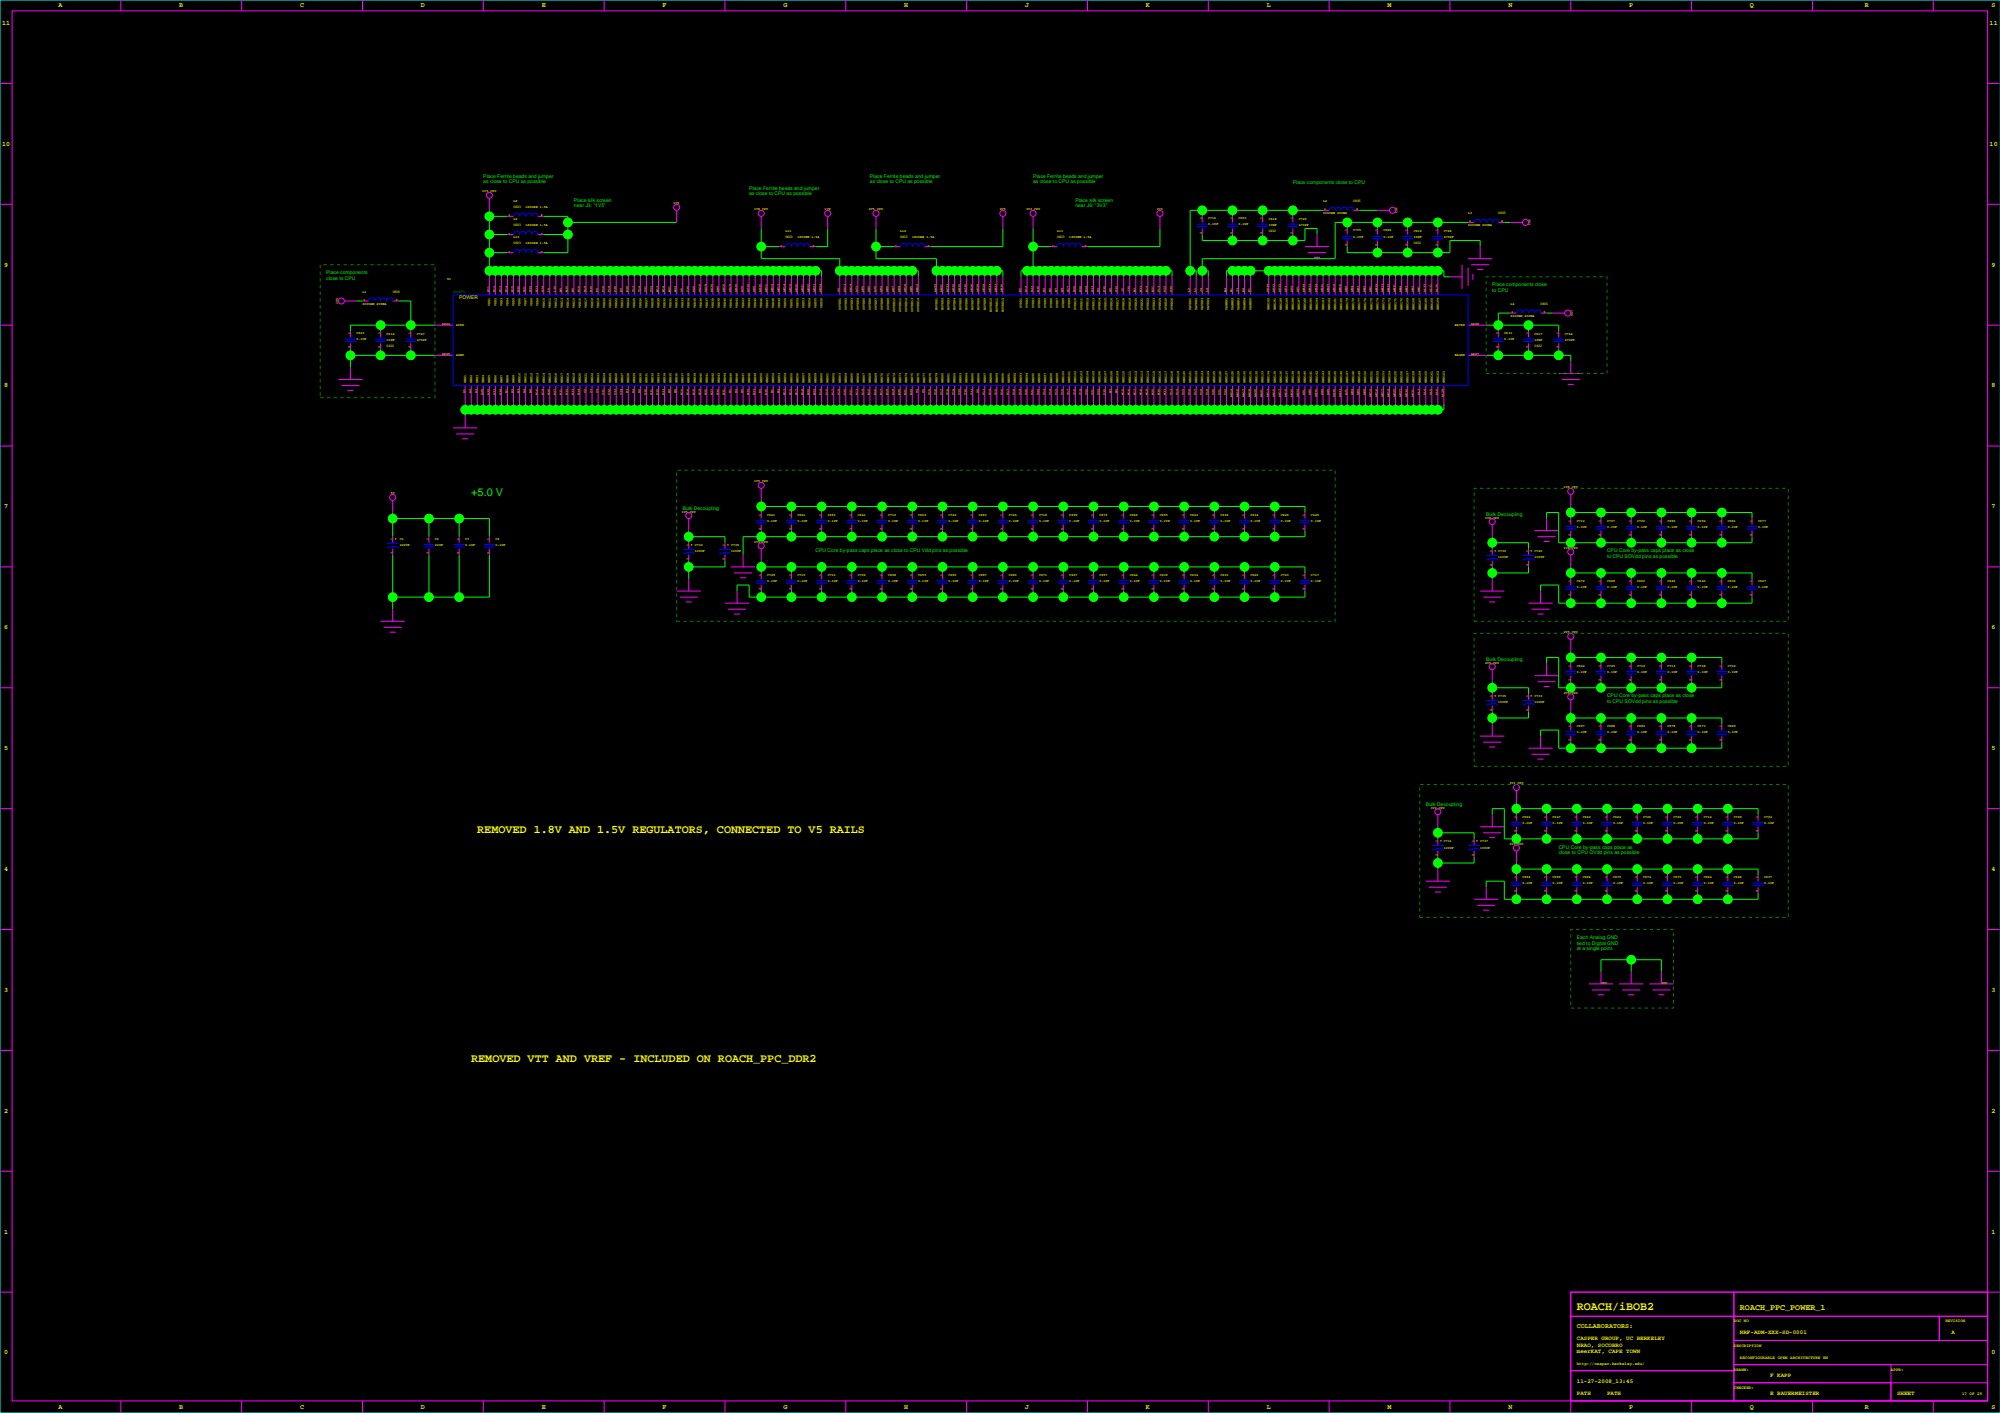
[picture p69: page 17]

Place Ferrite beads and jumper
as close to CPU as possible

CPU Core by-pass caps place as close to CPU Vdd pins as possible

CPU Core by-pass caps place as close
to CPU SOVdd pins as possible

REMOVED 1.8V AND 1.5V REGULATORS, CONNECTED TO V5 RAILS

CPU Core by-pass caps place as
close to CPU OVdd pins as possible

Each Analog GND
tied to Digital GND
at a single point.

REMOVED VTT AND VREF - INCLUDED ON ROACH_PPC_DDR2

# REMOVED 3V3 GENERATION

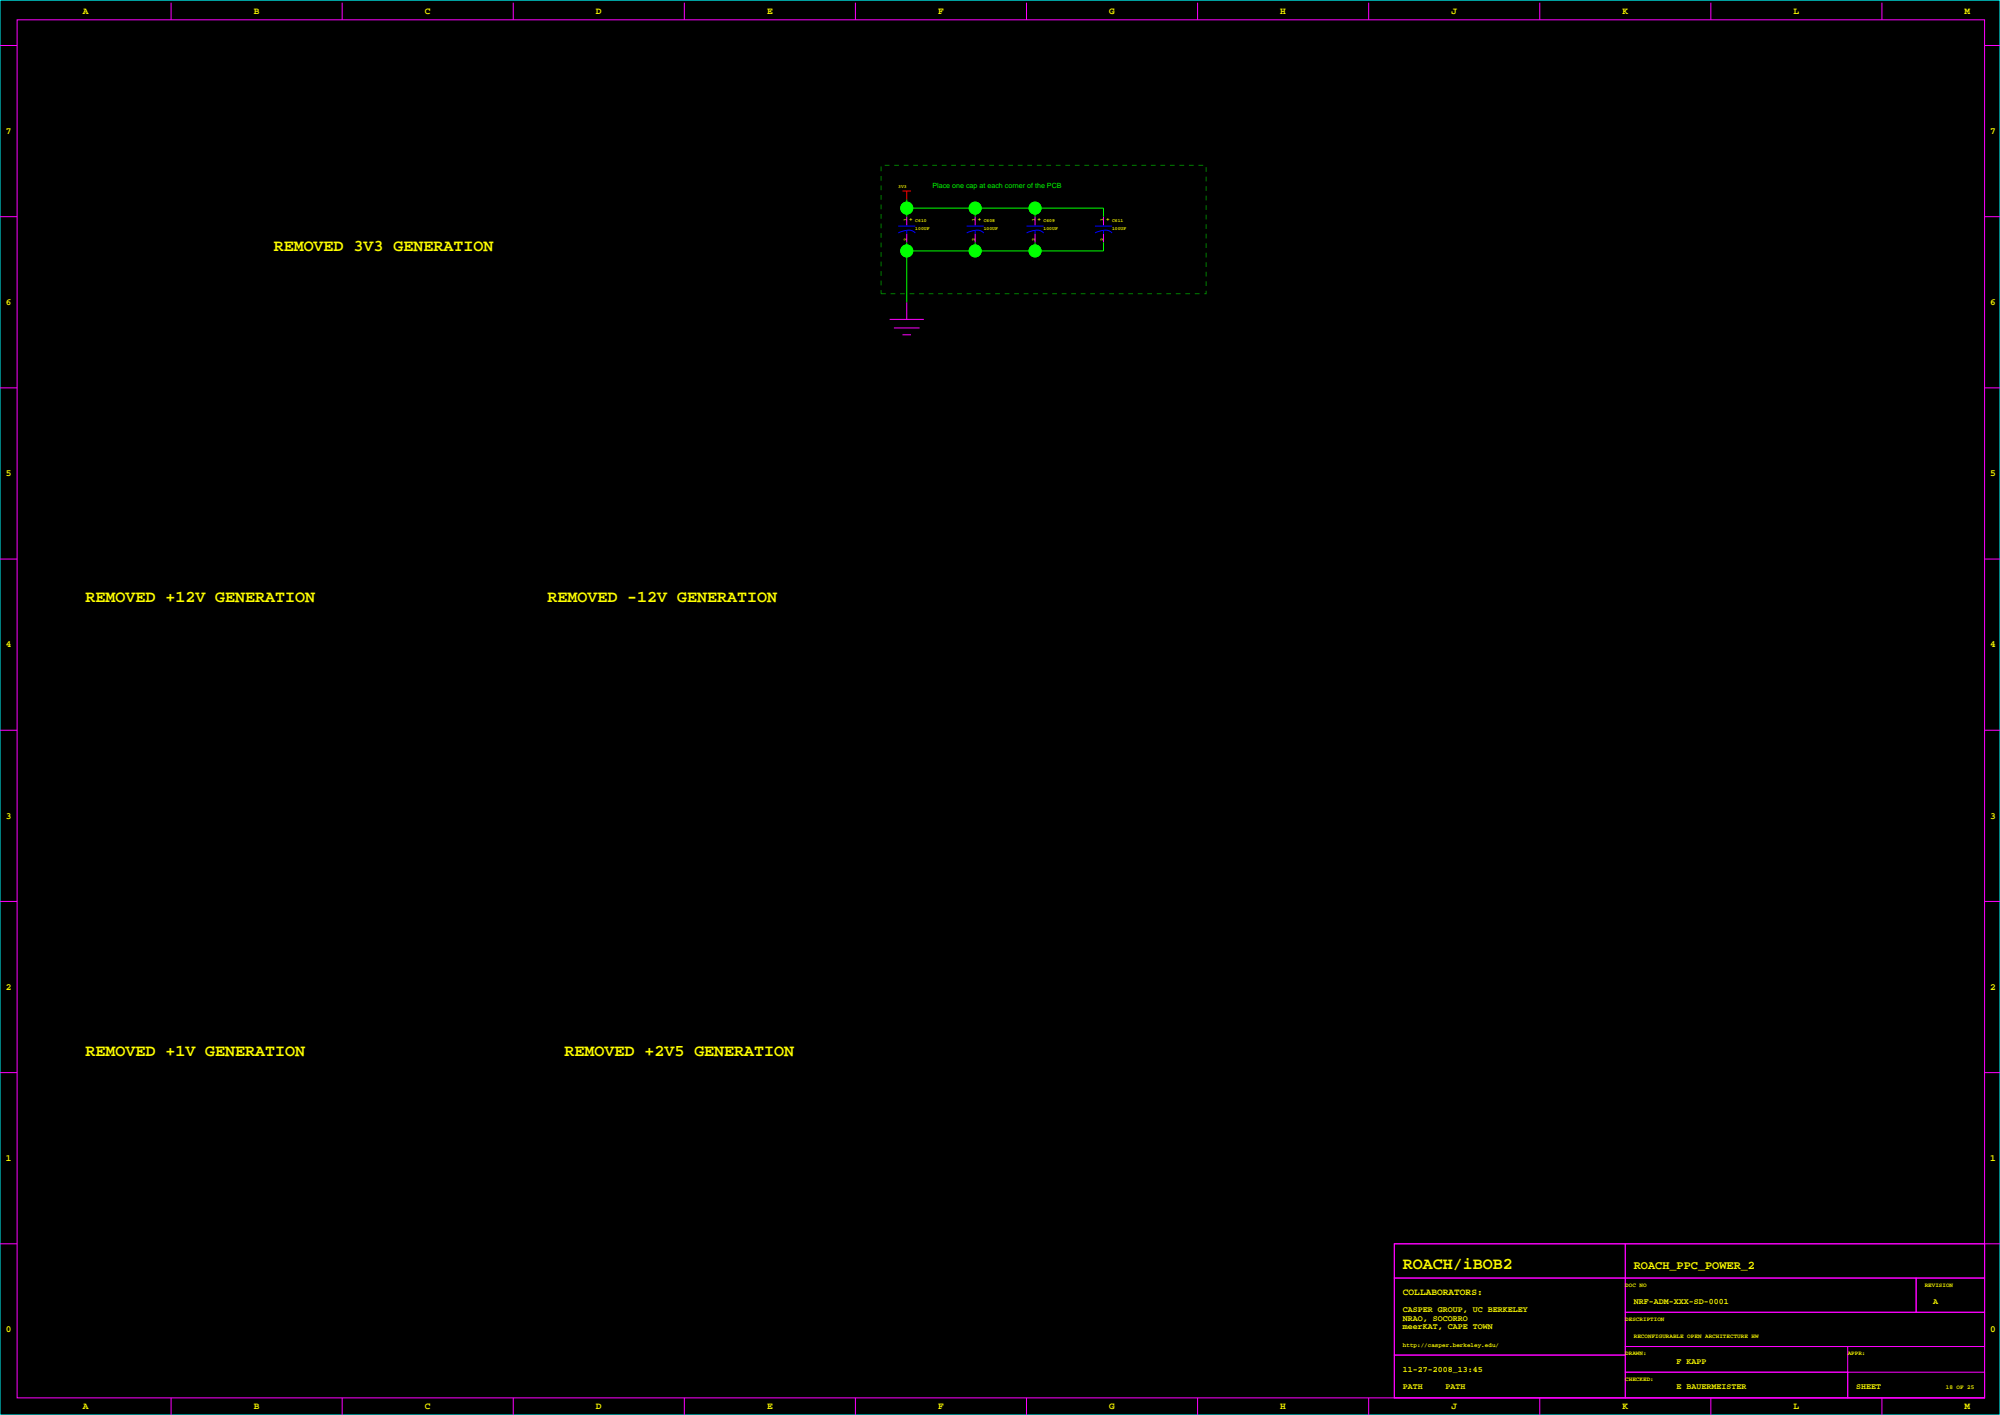
[picture p70: page 18]
ROACH_PPC_POWER_2; ROACH/iBOB2; COLLABORATORS:; DOC NO; REVISION; REMOVED -12V GENERATION; REMOVED +12V GENERATION; REMOVED +1V GENERATION; REMOVED +2V5 GENERATION

Place one cap at each corner of the PCB

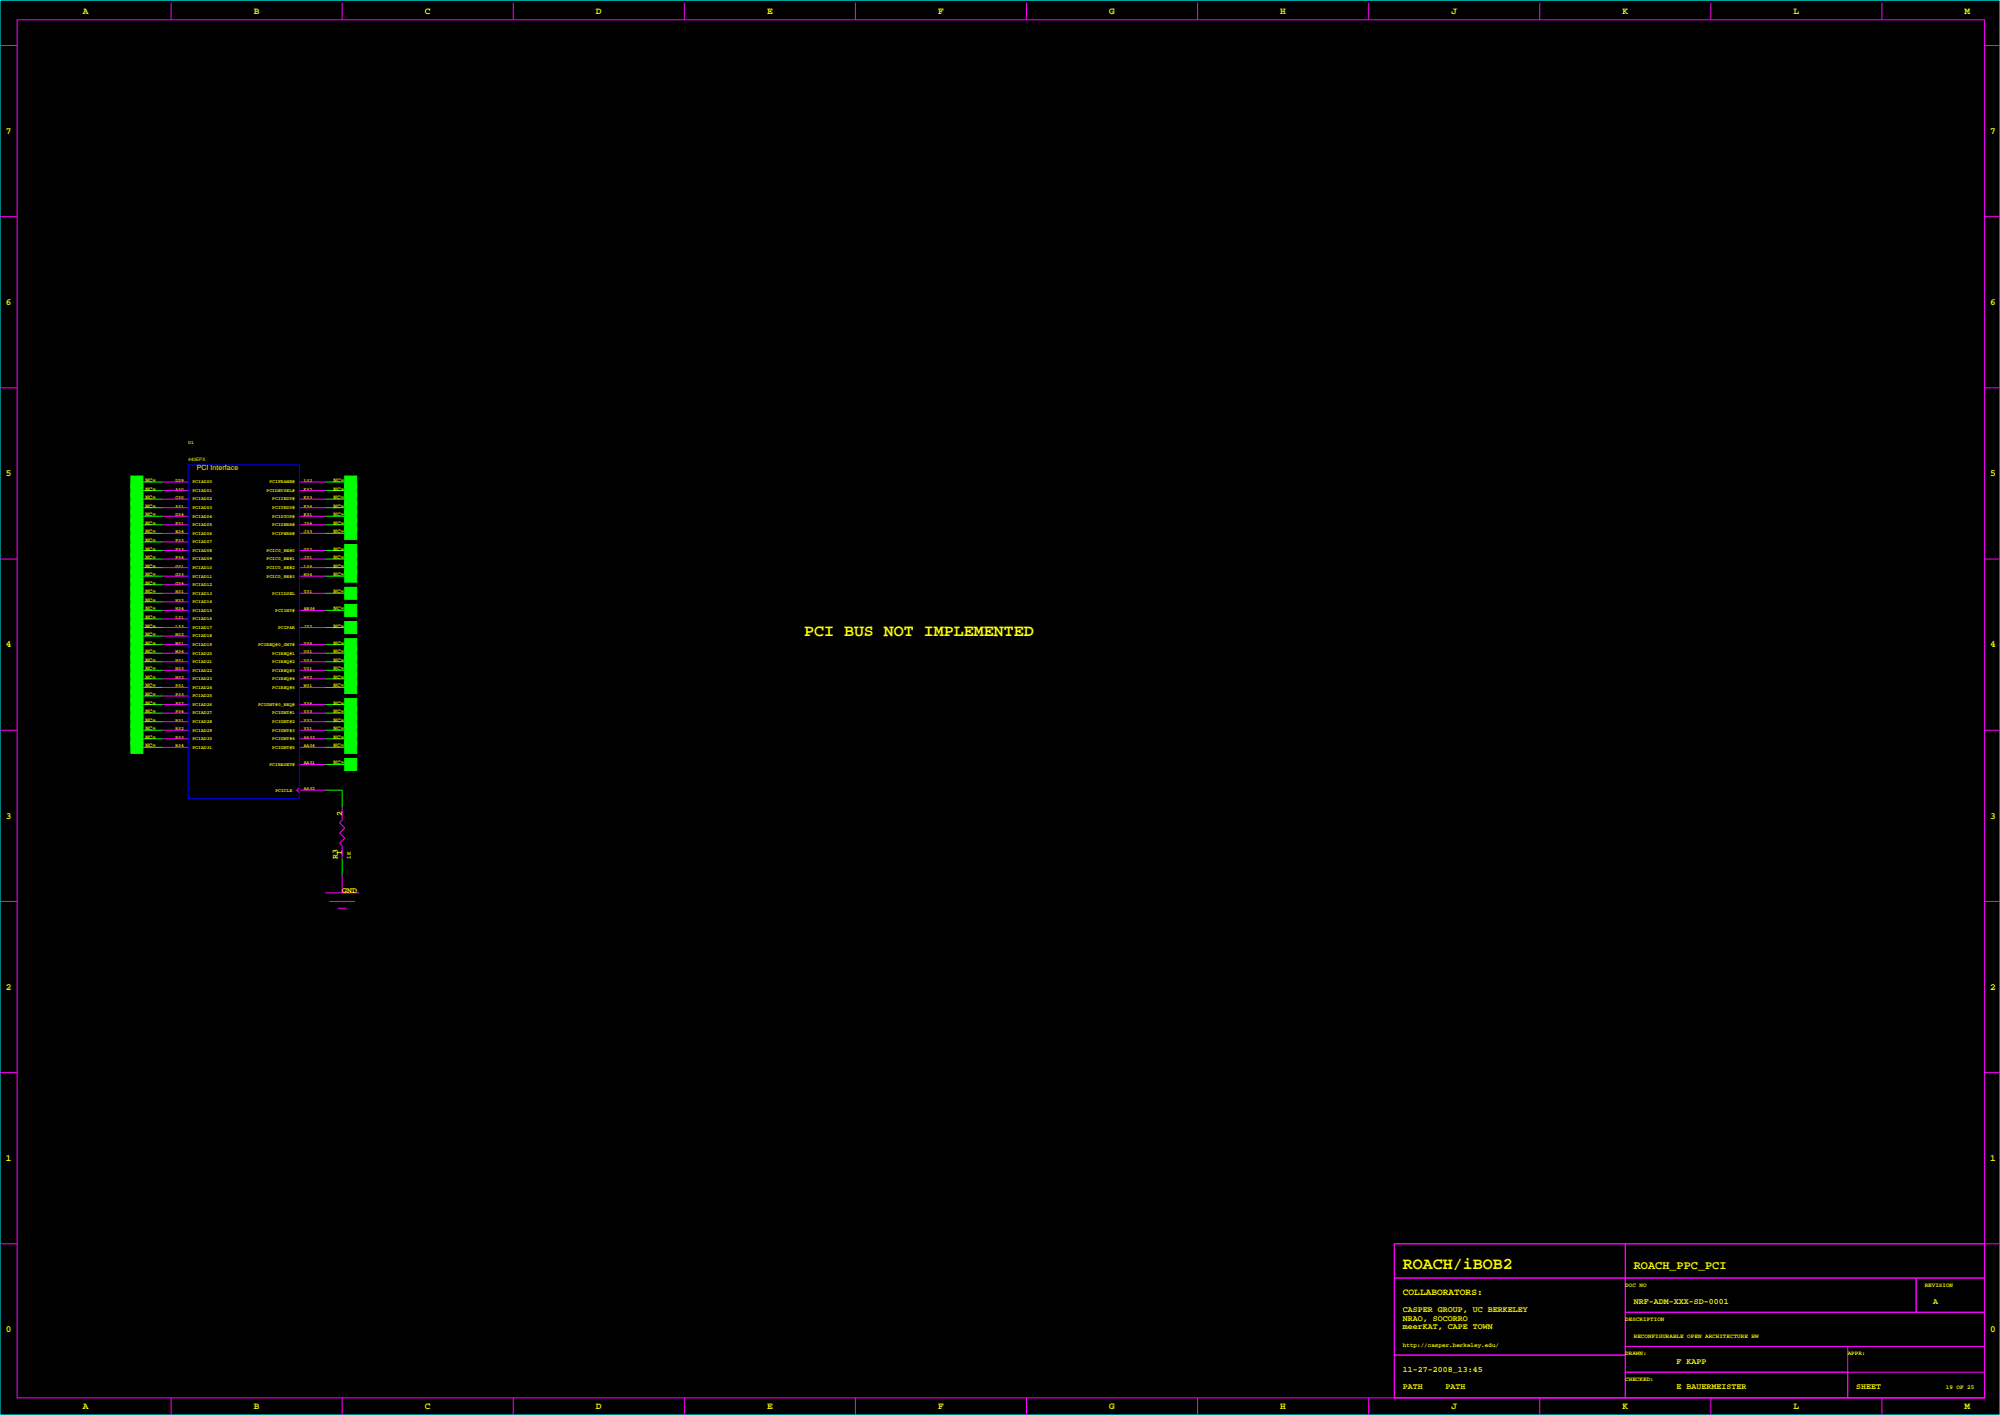
[picture p71: page 19]

PCI BUS NOT IMPLEMENTED

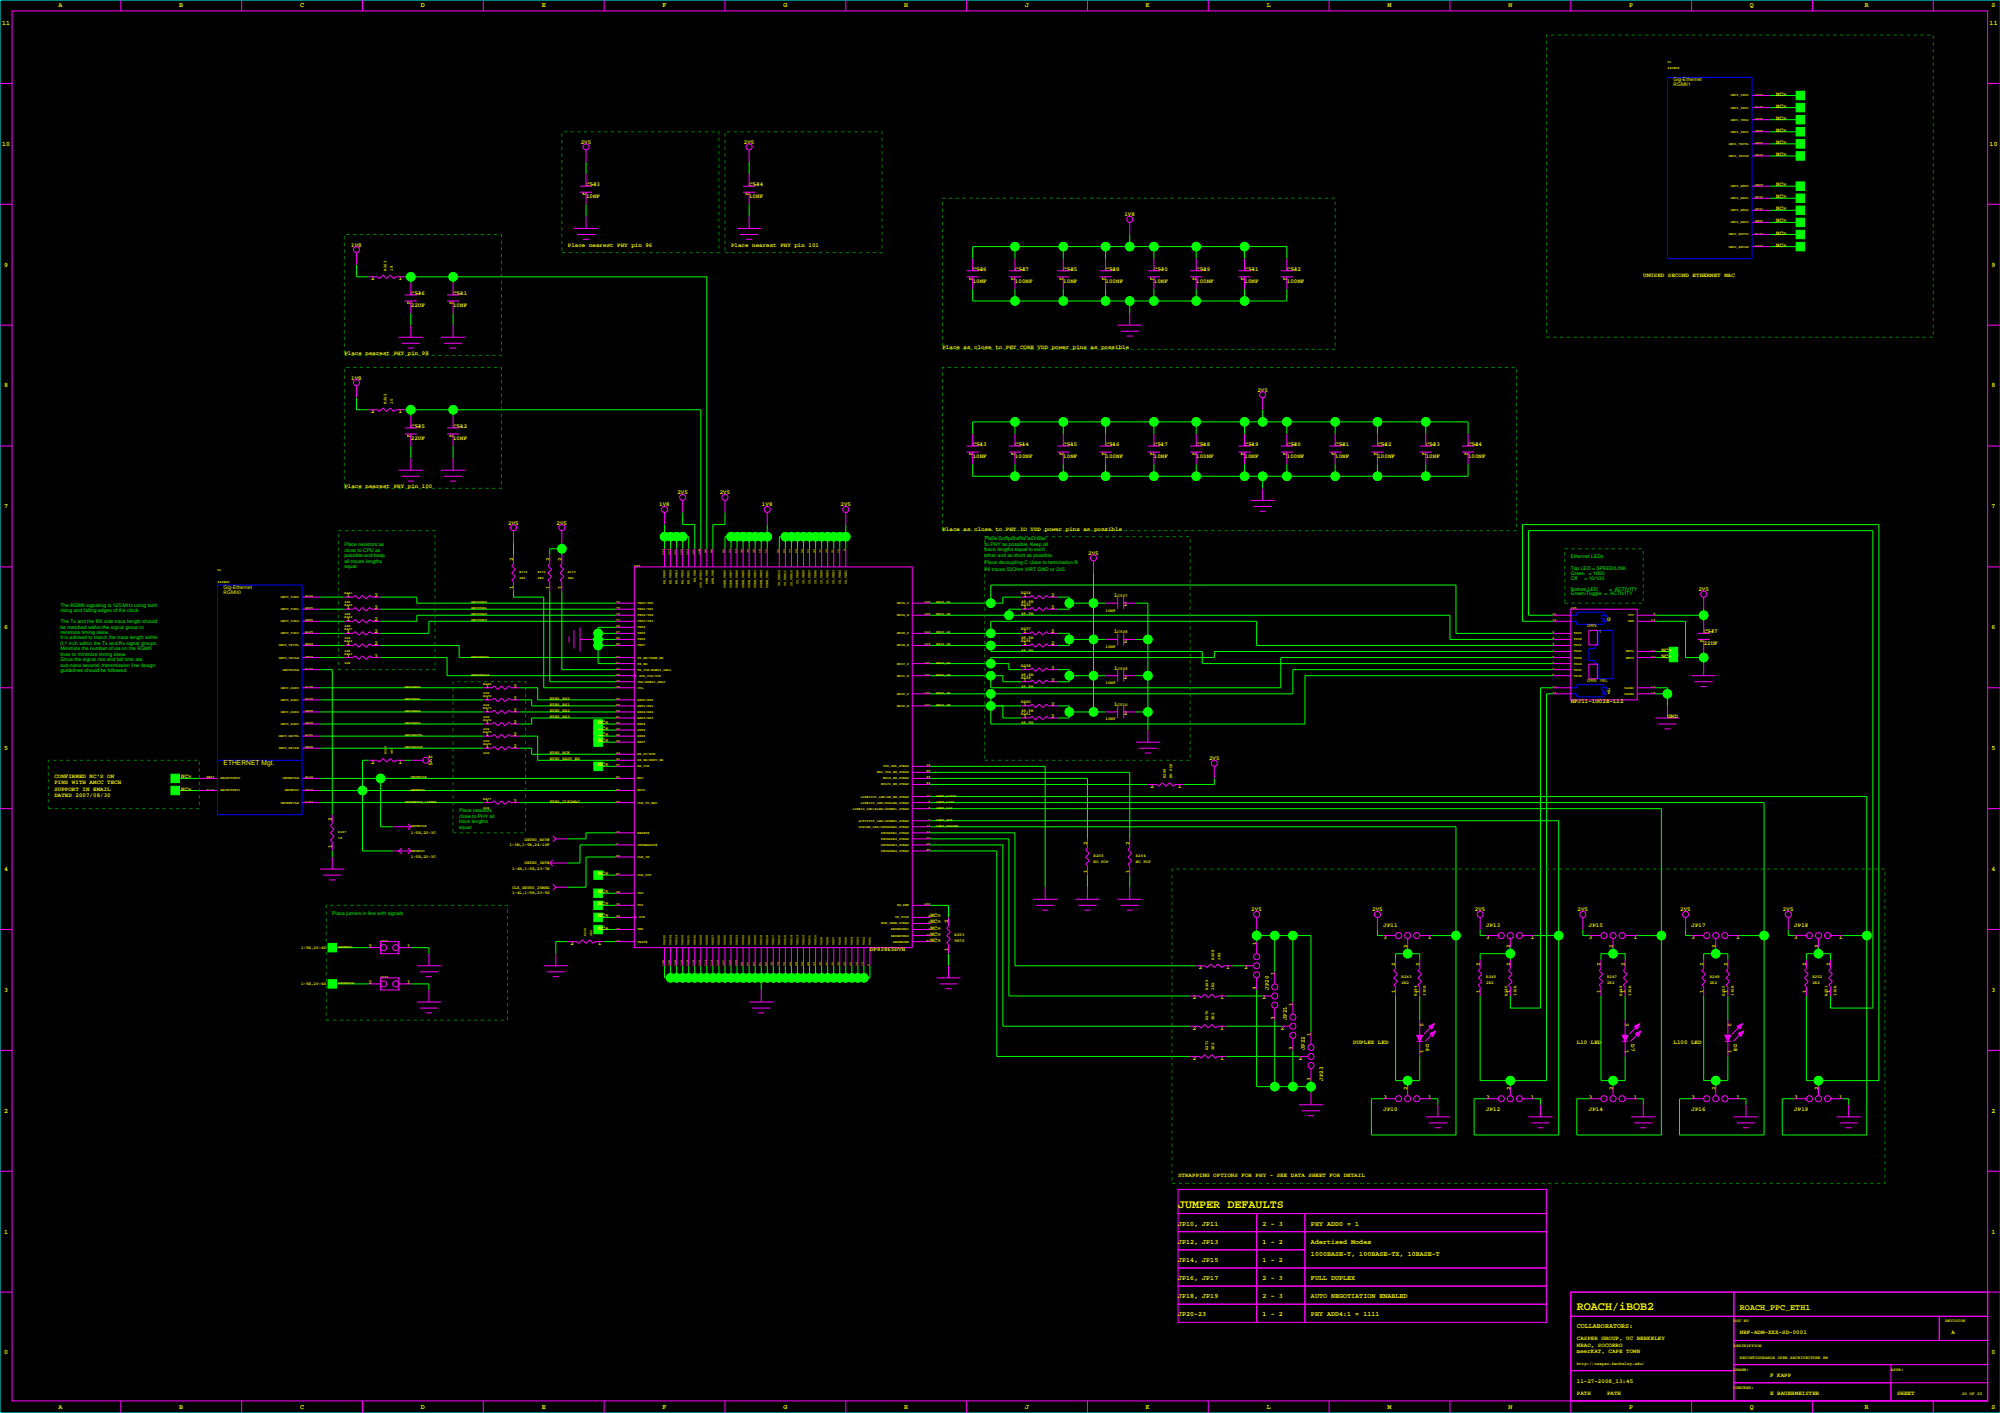
[picture p72: page 20]

UNUSED SECOND ETHERNET MAC

Place as close to PHY CORE VDD power pins as possible

Place nearest PHY pin 98

Place nearest PHY pin 100

Place as close to PHY IO VDD power pins as possible

Place components as close
to PHY as possible. Keep all
trace lengths equal to each

Place resistors as
close to CPU as

other and as short as possible.
Place decoupling C close to termination R
All traces 50Ohm WRT GND or 2V5

Top LED = SPEED/LINK
Green = 1000

The RGMII signaling is 125 MHz using both
rising and falling edges of the clock.
The Tx and the RX side trace length should
be matched within the signal group to
minimize timing skew.

It is advised to match the trace length within
0.1 inch within the Tx and Rx signal groups.
Minimize the number of via on the RGMII
lines to minimize timing skew.
Since the signal rise and fall time are
sub-nano second, transmission line design
guidelines should be followed.

CONFIRMED NC'S ON
PINS WITH AMCC TECH
SUPPORT IN EMAIL
DATED 2007/08/30

Place resistors
close to PHY all
trace lengths
equal

Place jumers in line with signals

STRAPPING OPTIONS FOR PHY - SEE DATA SHEET FOR DETAIL

NRF-ADM-XXX-SD-0001

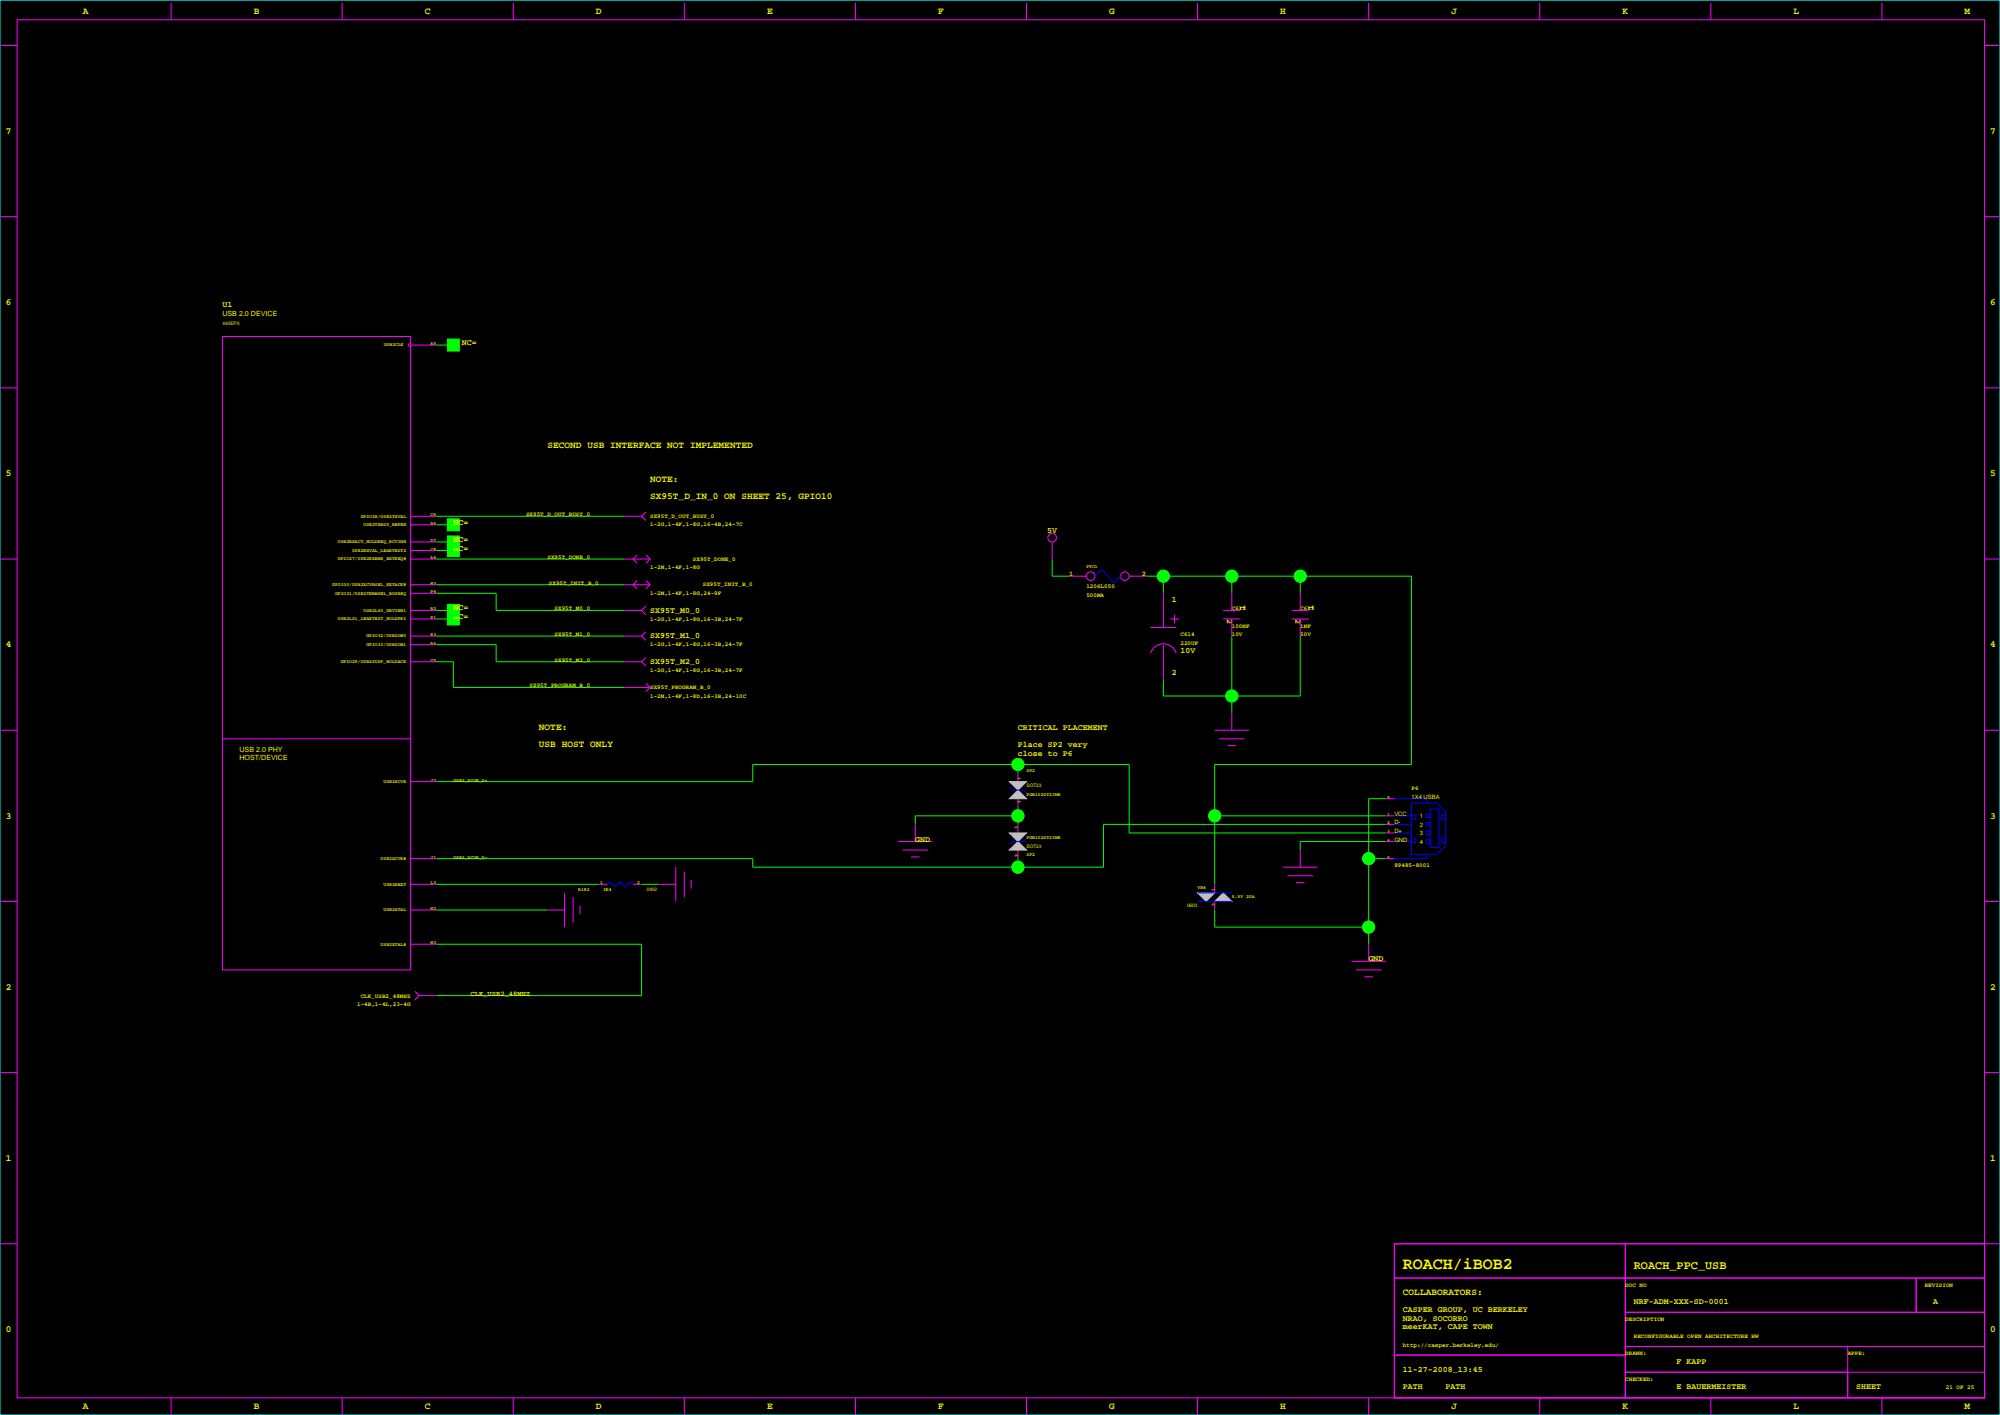
[picture p73: page 21]

SECOND USB INTERFACE NOT IMPLEMENTED

2 D-
3 D+
GND 4

# Z_ADDR

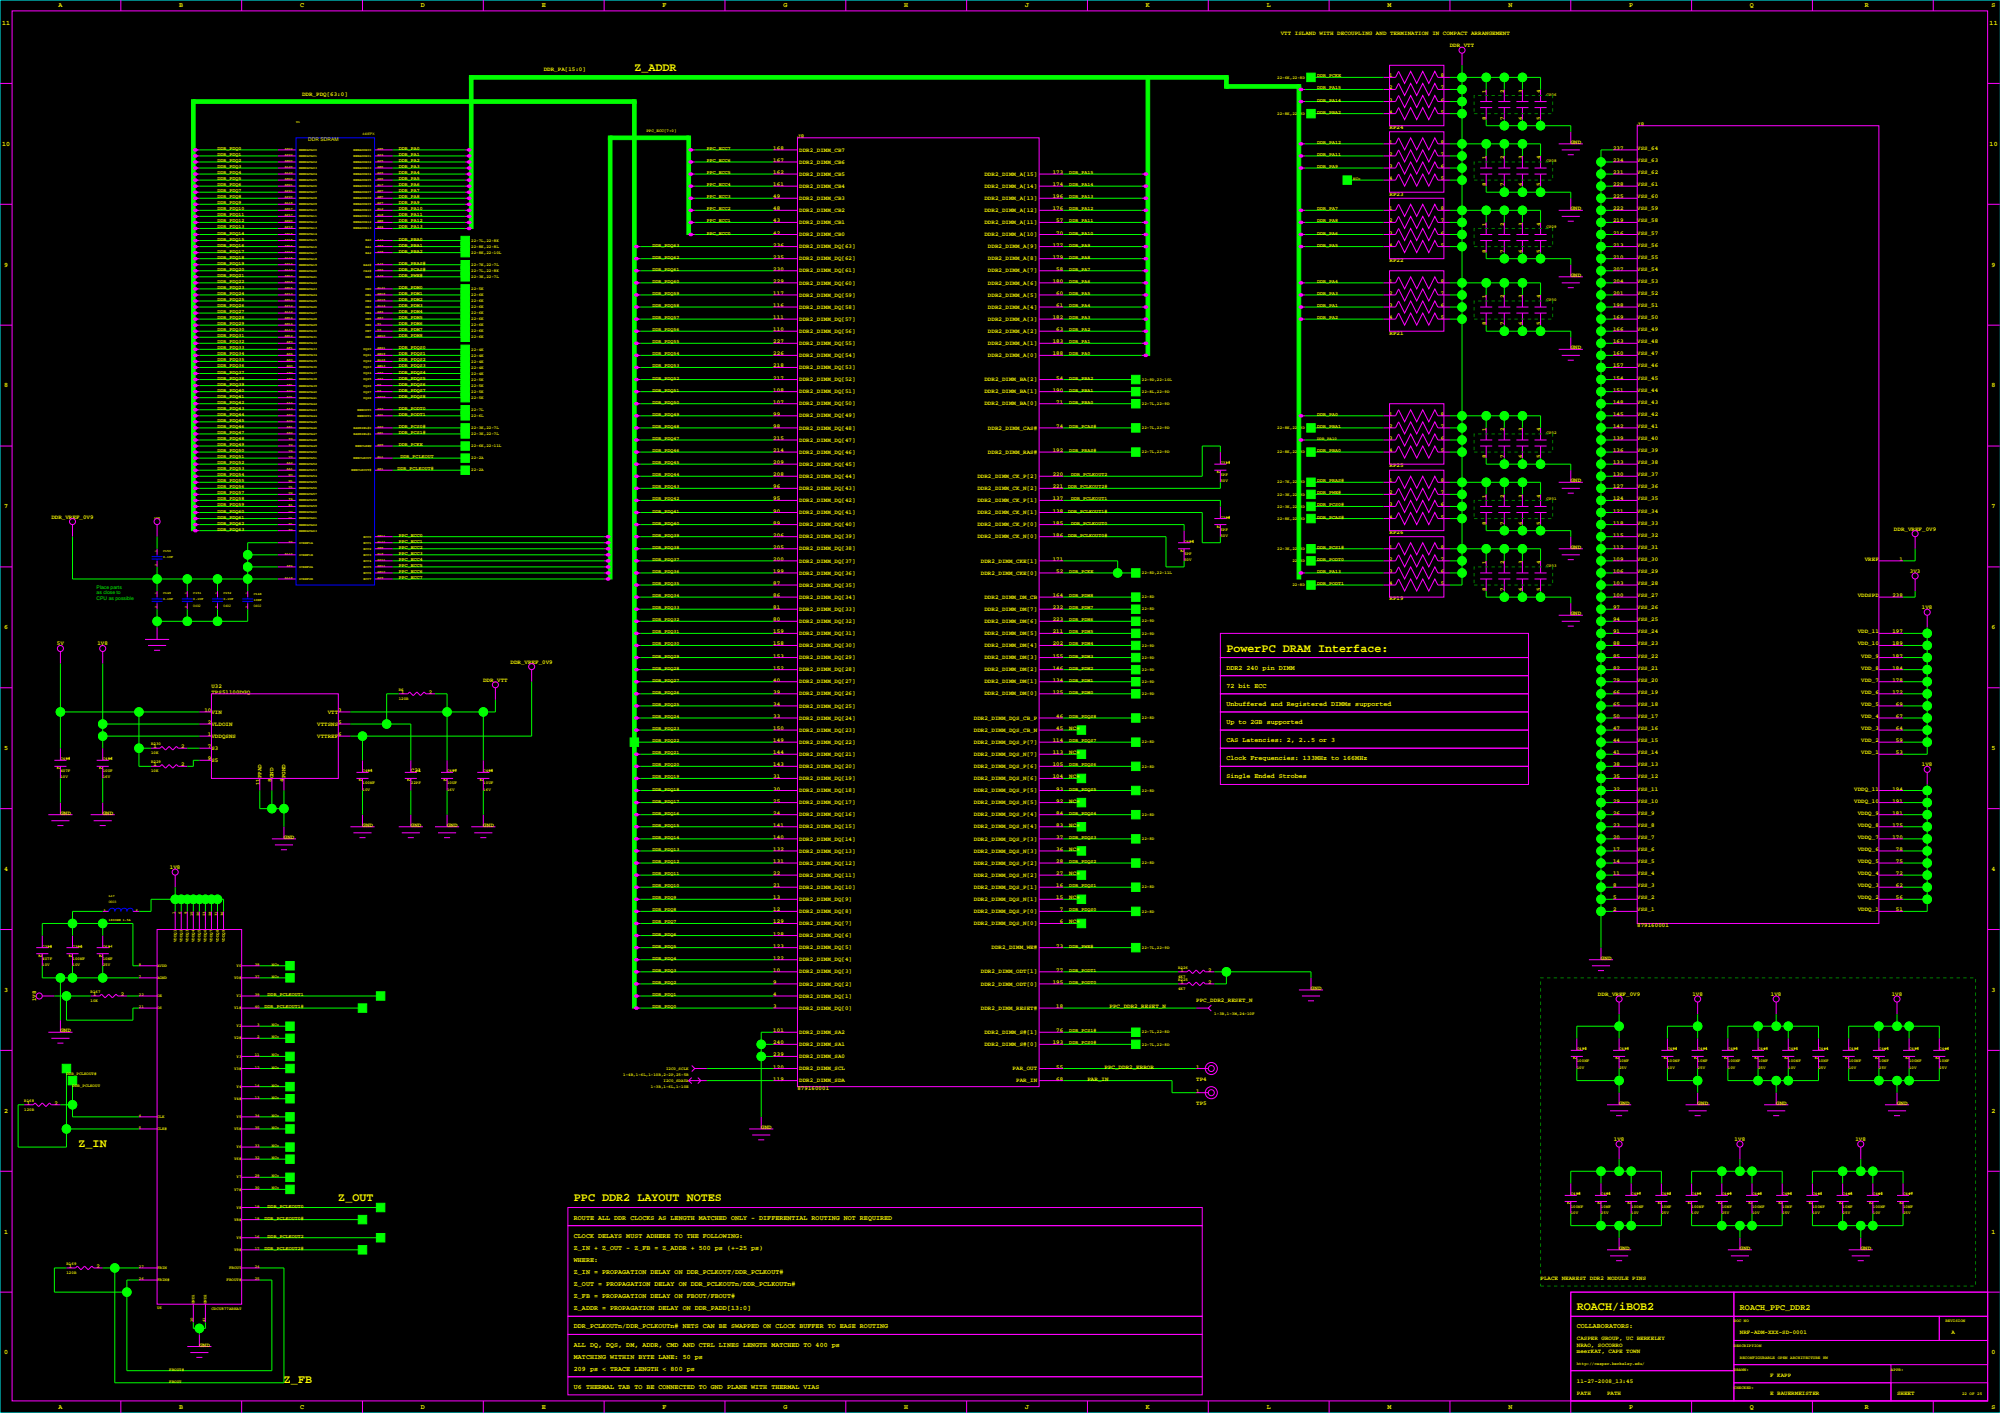
[picture p74: page 22]

VTT ISLAND WITH DECOUPLING AND TERMINATION IN COMPACT ARRANGEMENT

Unbuffered and Registered DIMMs supported

ROUTE ALL DDR CLOCKS AS LENGTH MATCHED ONLY - DIFFERENTIAL ROUTING NOT REQUIRED

CLOCK DELAYS MUST ADHERE TO THE FOLLOWING:
Z_IN + Z_OUT - Z_FB = Z_ADDR + 500 ps (+-25 ps)
WHERE:
Z_IN = PROPAGATION DELAY ON DDR_PCLKOUT/DDR_PCLKOUT#
Z_OUT = PROPAGATION DELAY ON DDR_PCLKOUTn/DDR_PCLKOUTn#
Z_FB = PROPAGATION DELAY ON FBOUT/FBOUT#
Z_ADDR = PROPAGATION DELAY ON DDR_PADD[13:0]

PLACE NEAREST DDR2 MODULE PINS

DDR_PCLKOUTn/DDR_PCLKOUTn# NETS CAN BE SWAPPED ON CLOCK BUFFER TO EASE ROUTING

ALL DQ, DQS, DM, ADDR, CMD AND CTRL LINES LENGTH MATCHED TO 400 ps
MATCHING WITHIN BYTE LANE: 50 ps
209 ps < TRACE LENGTH < 800 ps

U6 THERMAL TAB TO BE CONNECTED TO GND PLANE WITH THERMAL VIAS

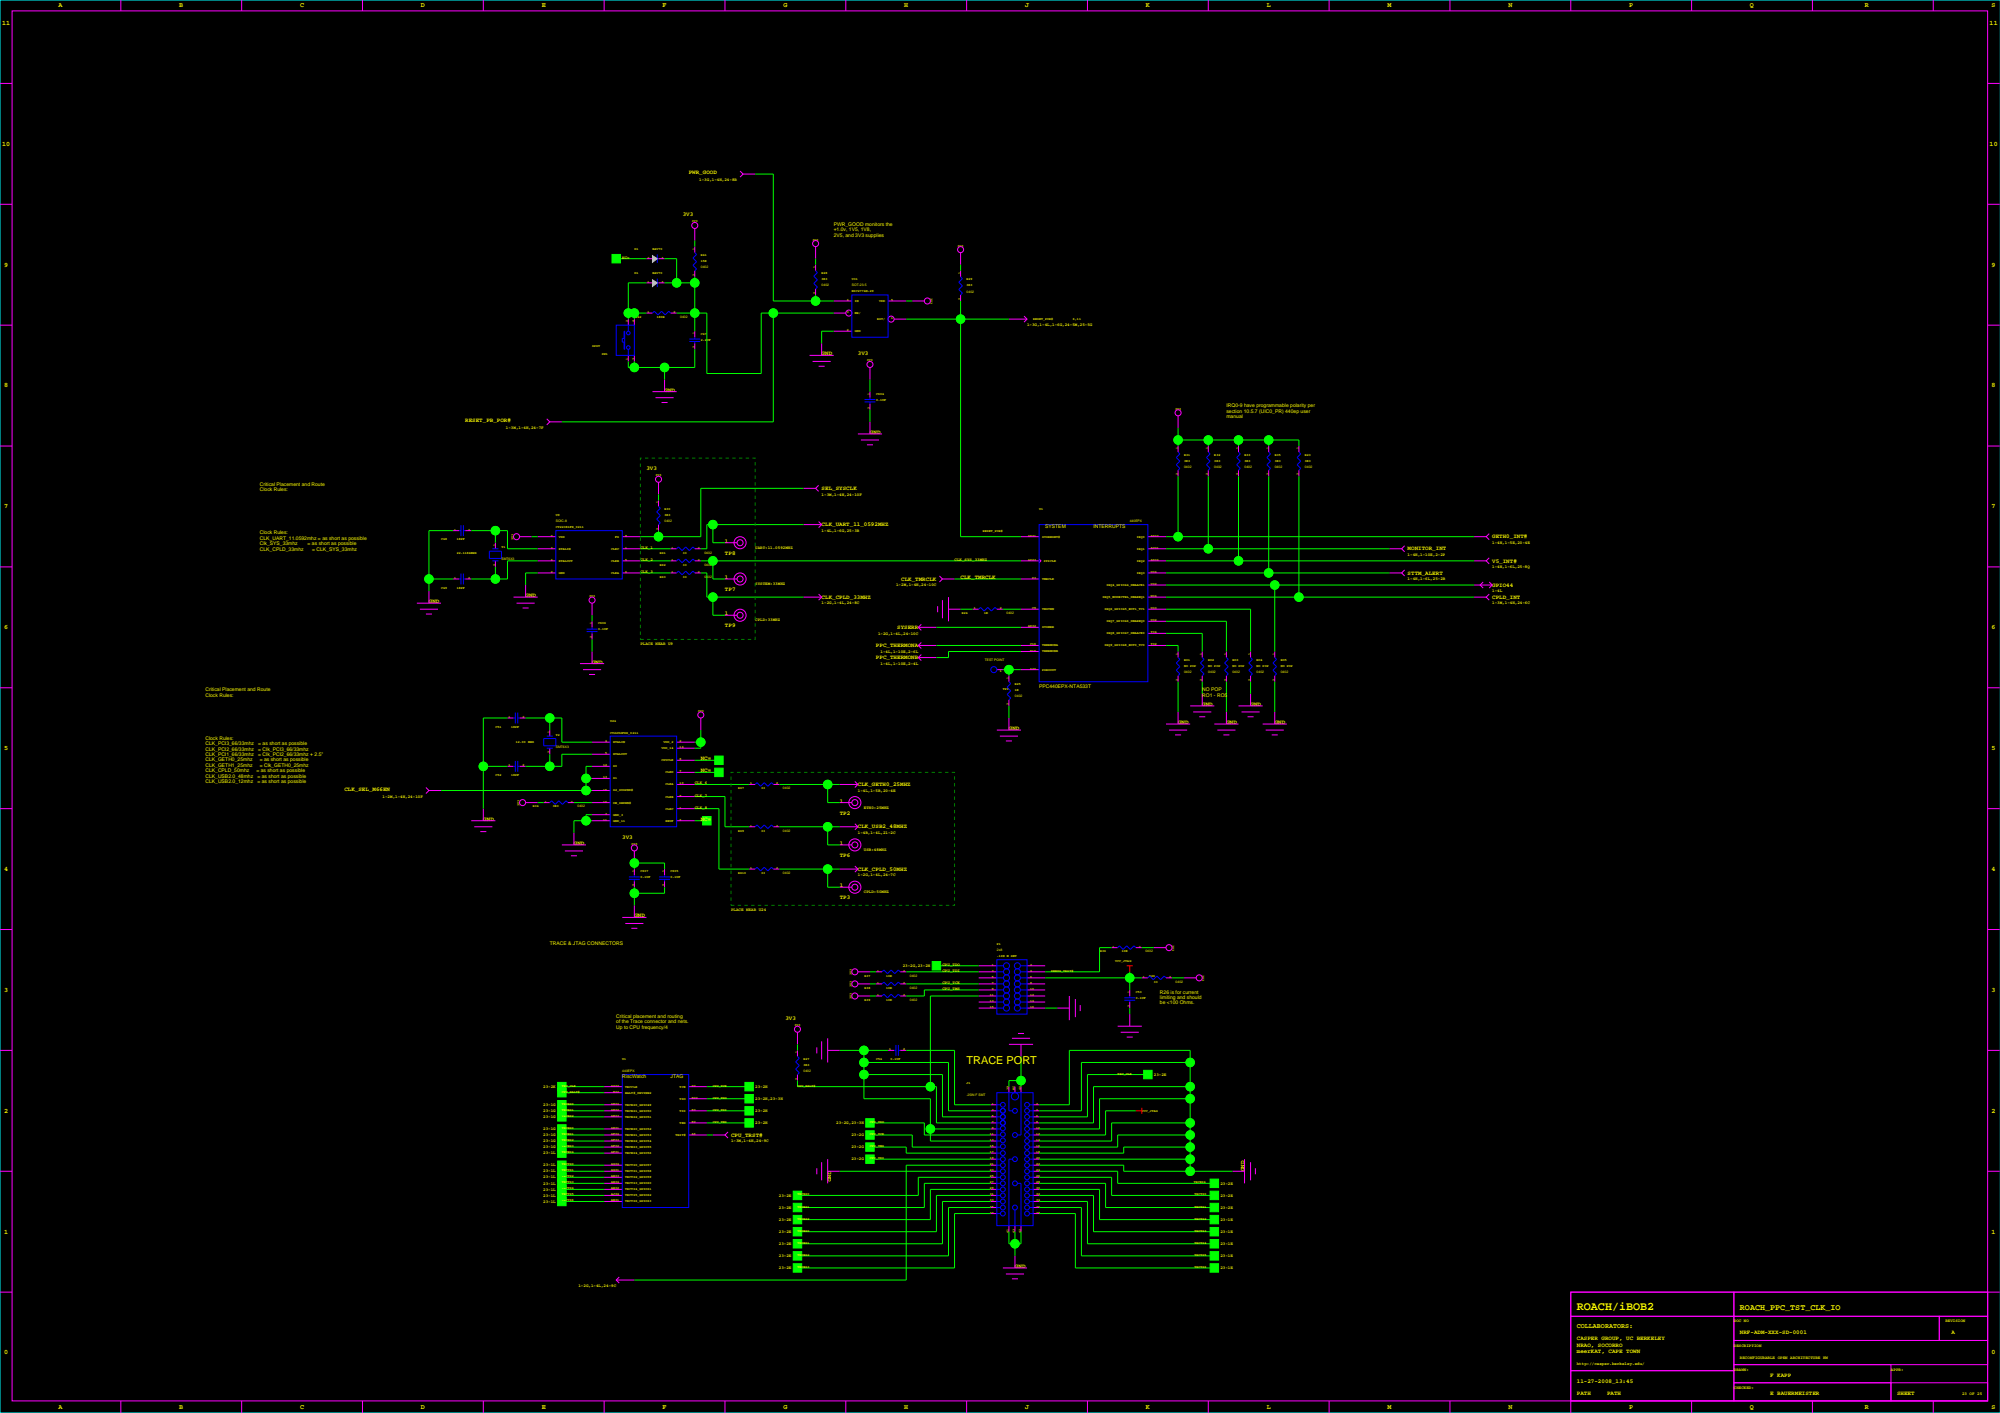
[picture p75: page 23]

IRQ0-9 have programmable polarity per
section 10.5.7 (UIC0_PR) 440ep user
manual

Critical Placement and Route
Clock Rules:

CLK_UART_11.0592mhz = as short as possible

CLK_PCI3_66/33mhz = as short as possible
CLK_PCI2_66/33mhz = Clk_PCI3_66/33mhz
CLK_PCI1_66/33mhz = Clk_PCI2_66/33mhz + 2.5"
CLK_GETH0_25mhz = as short as possible
CLK_GETH1_25mhz = Clk_GETH0_25mhz
CLK_CPLD_50mhz = as short as possible
CLK_USB2.0_48mhz = as short as possible
CLK_USB2.0_12mhz = as short as possible

Critical placement and routing
of the Trace connector and nets.
Up to CPU frequency/4

# SD/MMC/MMCPLUS CONNECTOR

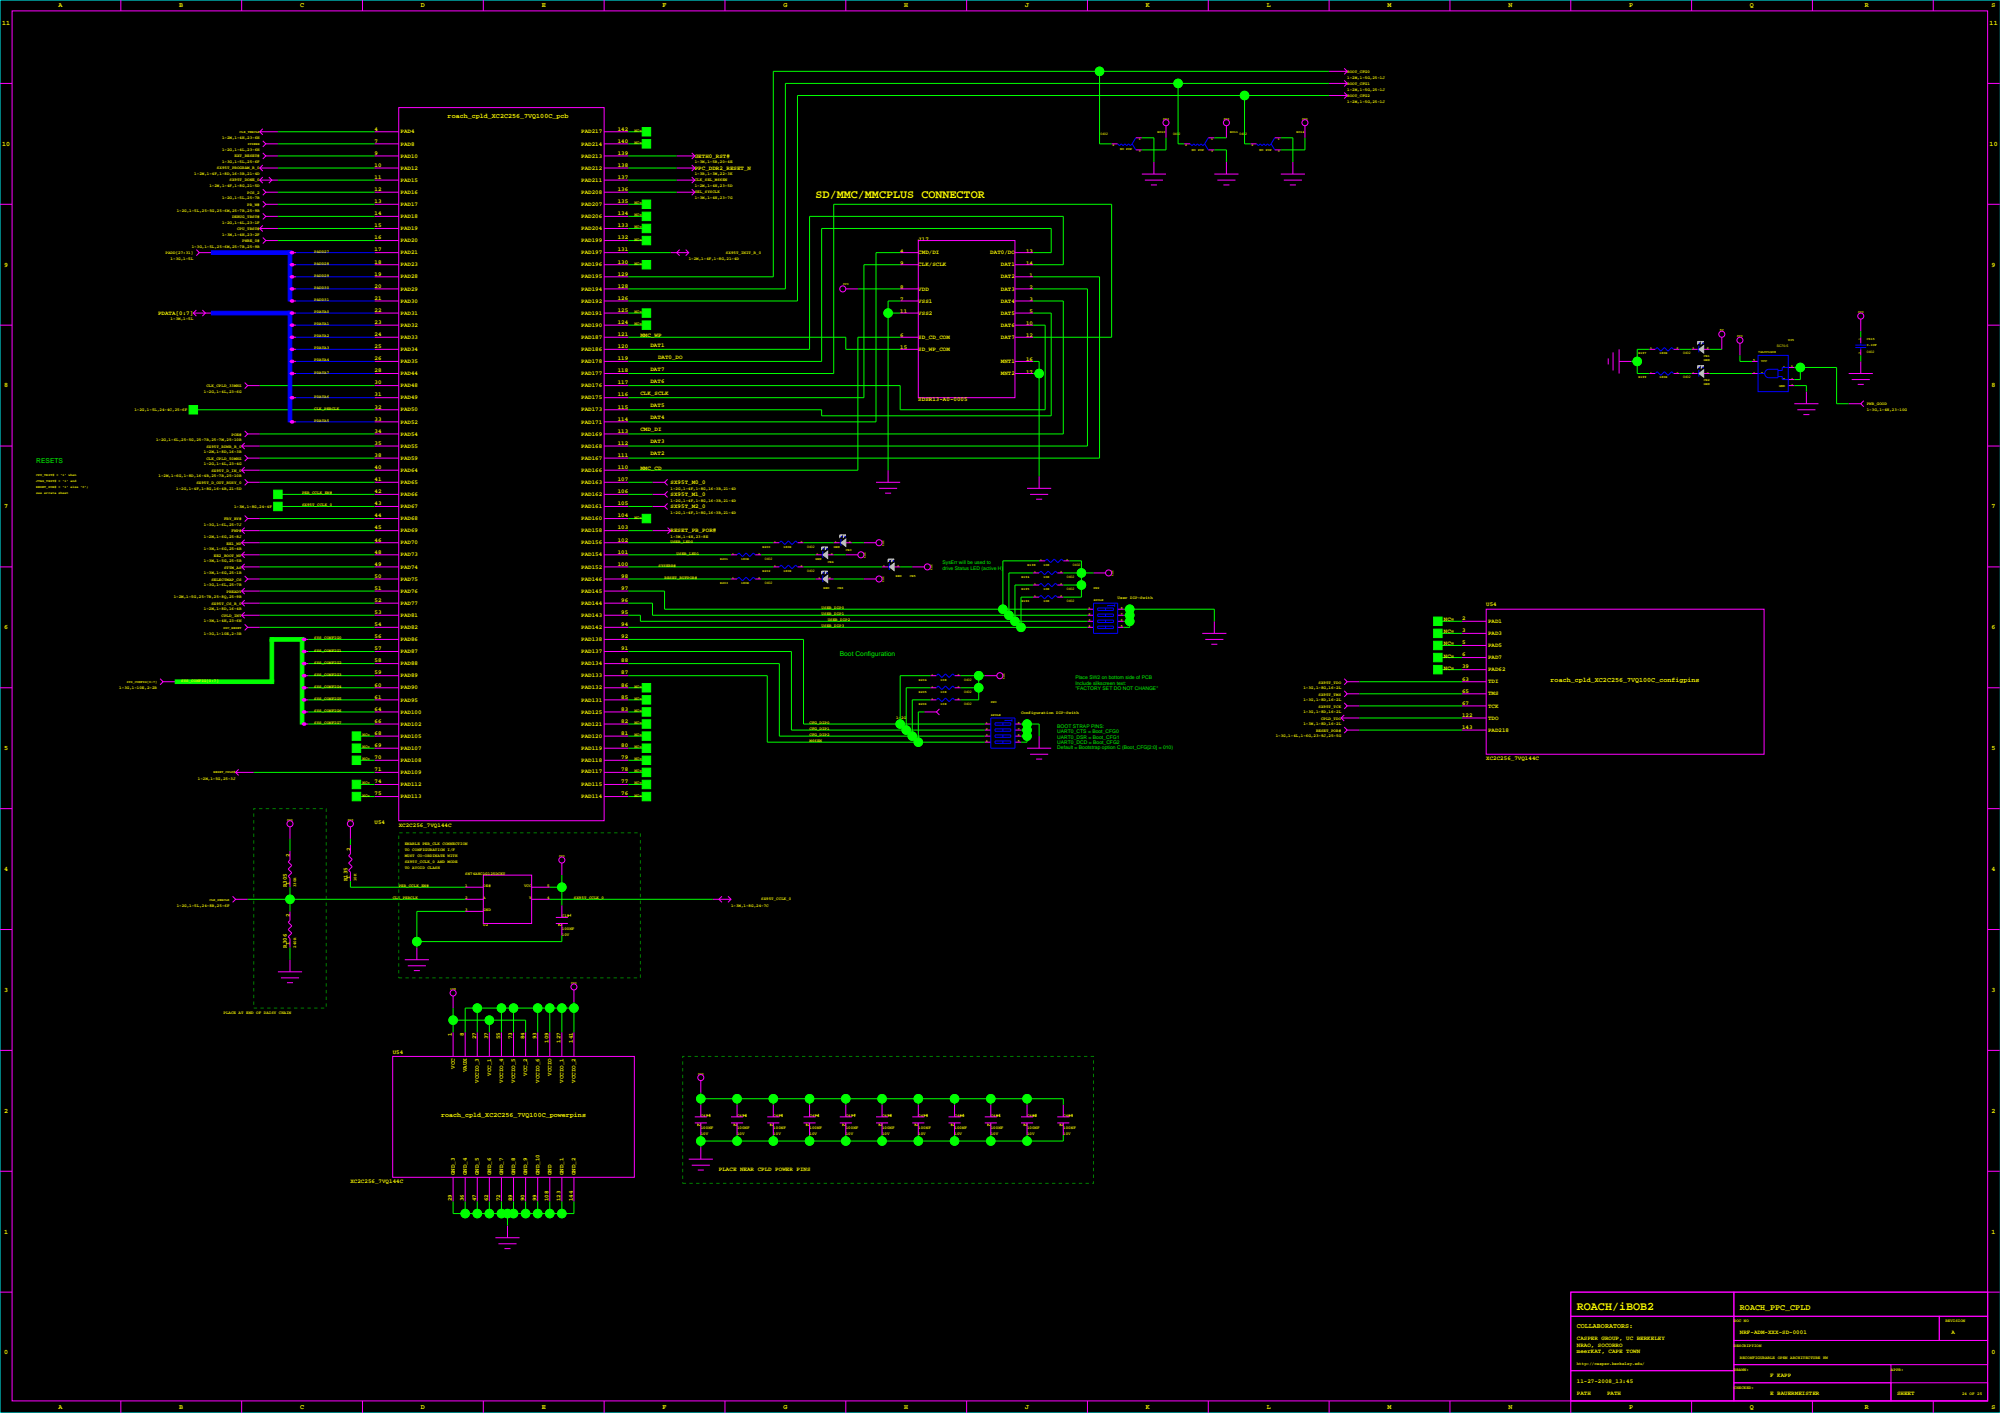
[picture p76: page 24]

SysErr will be used to
drive Status LED (active H)

Place SW2 on bottom side of PCB
Include silkscreen text:
"FACTORY SET DO NOT CHANGE"

ENABLE PER_CLK CONNECTION
TO CONFIGURATION I/F
MUST CO-ORDINATE WITH
SX95T_CCLK_0 AND MODE
TO AVOID CLASH

PLACE AT END OF DAISY CHAIN

PLACE NEAR CPLD POWER PINS

## CHIP SELECTS CONFIG

# PADD30 IS THE LSB FOR 16 BIT

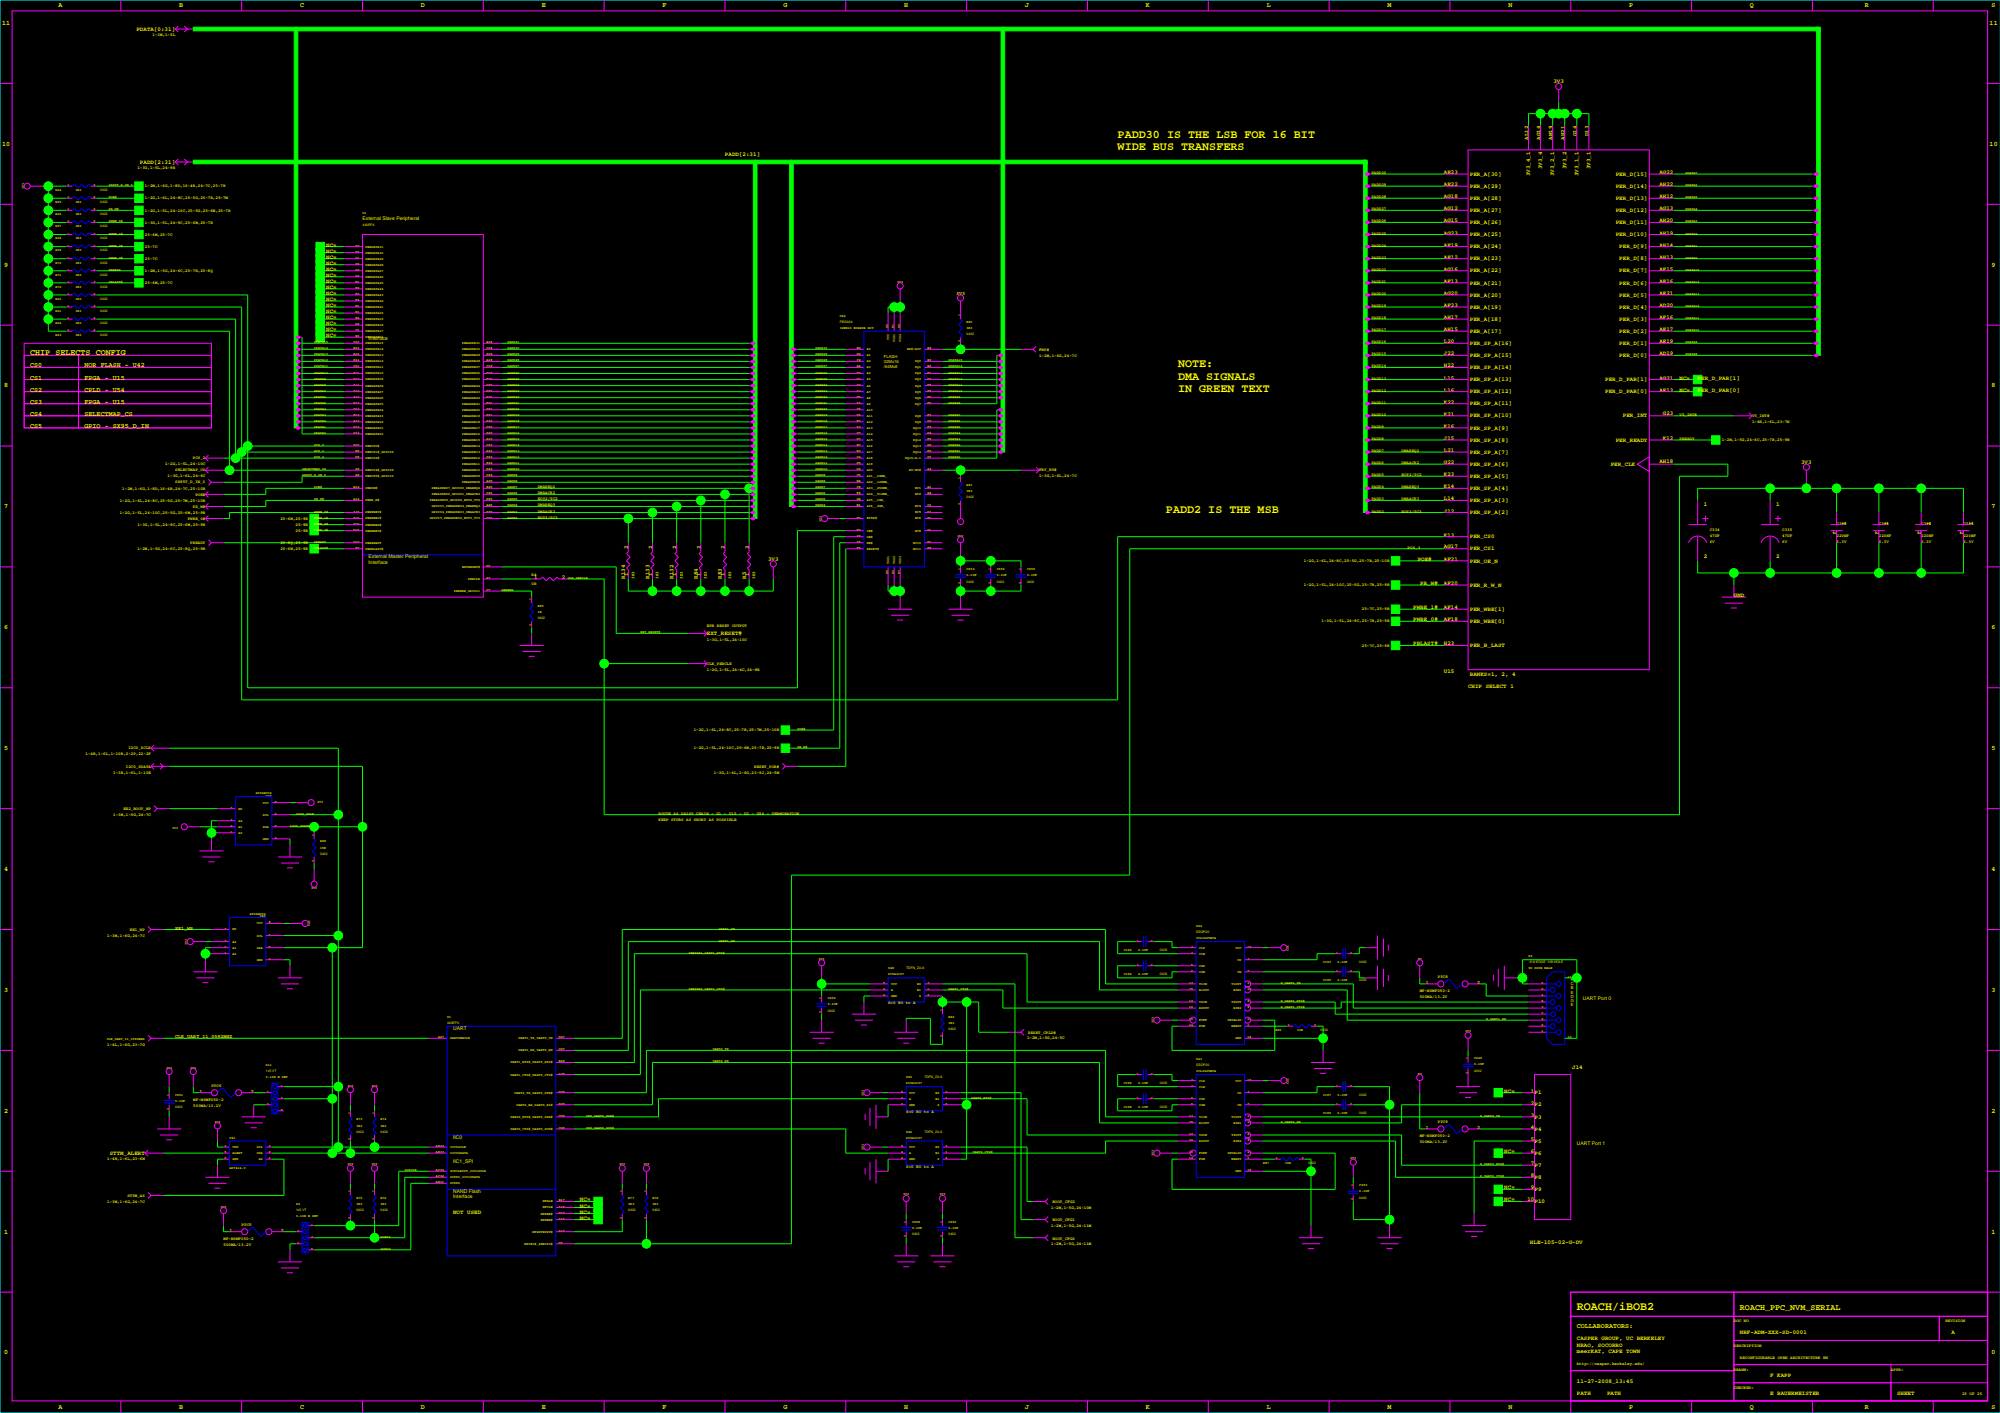
[picture p77: page 25]

ROUTE AS DAISY CHAIN - U1 - U15 - U2 - U54 - TERMINATION
KEEP STUBS AS SHORT AS POSSIBLE

UART1_RX

PERPAR1_UART1_RTS#
PERPAR0_UART1_CTS# | 3V3
