ska-sa/roach1_hardware/roach/pdfschem/roach_top100.pdf

# GIGABIT TRANSCEIVERS

# VIRTEX5 CLOCKS

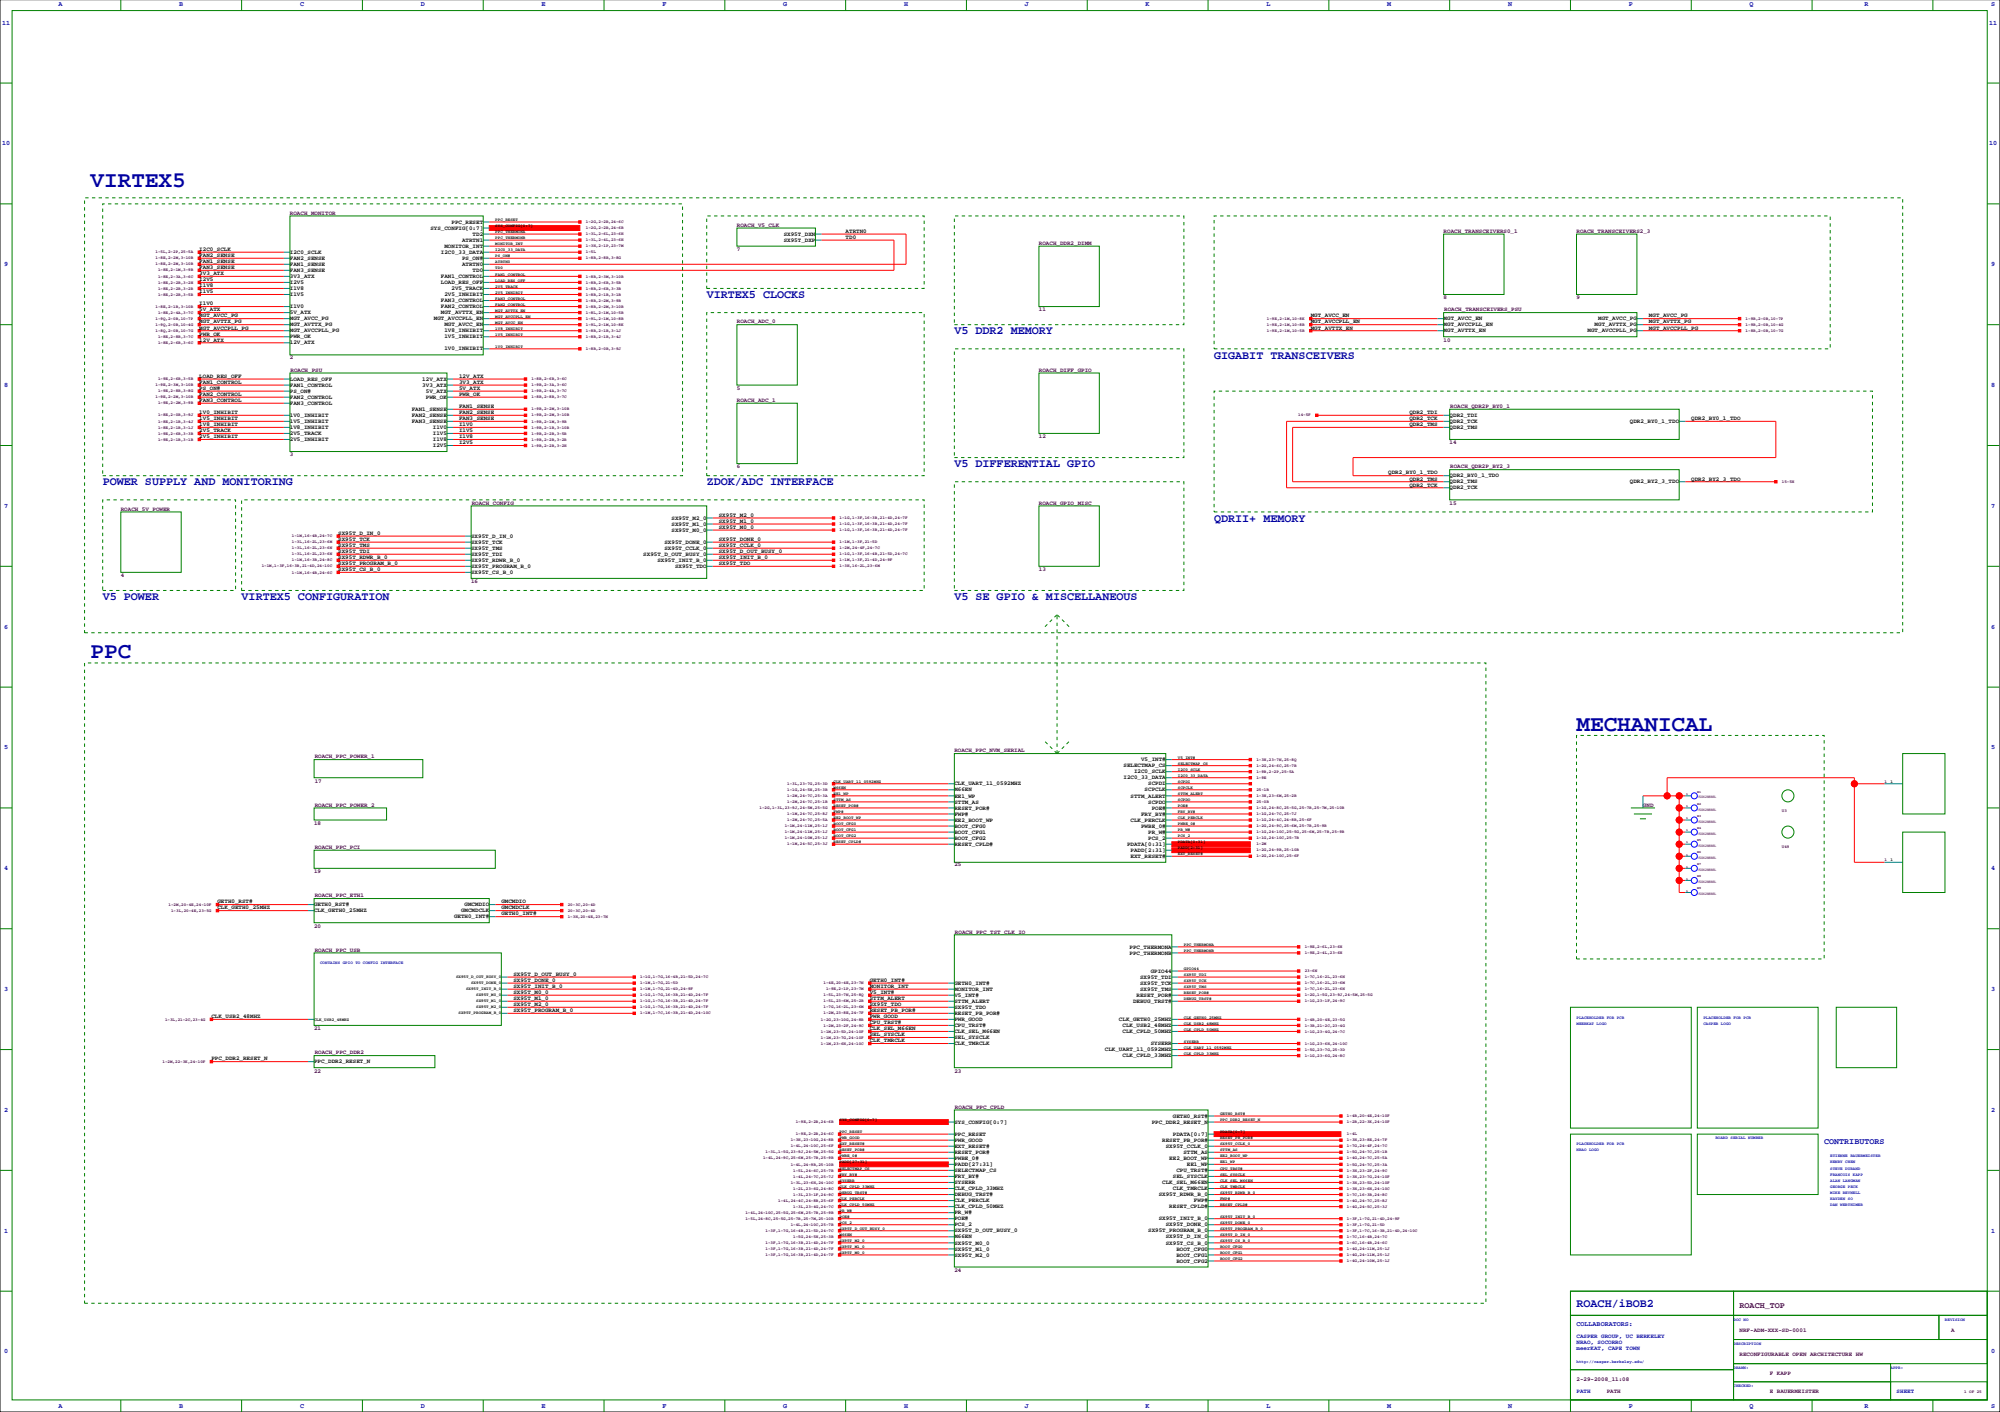
[picture p103: page 1]
150X288MIL; GND; PATH; ROACH/iBOB2; COLLABORATORS:; DRAWN:; APPR:; CHECKED:; SHEET; REVISION; ROACH_PPC_ETH1; CLK_GETH0_25MHZ; GETH0_INT#; GETH0_RST#; GMCMDCLK; GMCMDIO; ROACH_5V_POWER; ROACH_PPC_PCI; ROACH_V5_CLK; SX95T_DXP; SX95T_DXN; ROACH_TRANSCEIVERS2_3; ROACH_MONITOR; 12V_ATX; 1V0_INHIBIT; 1V5_INHIBIT; 1V8_INHIBIT; 2V5_INHIBIT; 2V5_TRACK; 3V3_ATX; 5V_ATX; ATRTN0; FAN1_CONTROL; FAN1_SENSE; FAN2_CONTROL; FAN2_SENSE; FAN3_CONTROL; FAN3_SENSE; I2C0_SCLK; I2C0_33_DATA; LOAD_RES_OFF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

V5 SE GPIO & MISCELLANEOUS

CONTAINS GPIO TO CONFIG INTERFACE

PLACEHOLDER FOR PCB
MEERKAT LOGO

CASPER LOGO

BOARD SERIAL NUMBER

NRAO LOGO

DOC NO
NRF-ADM-XXX-SD-0001

CASPER GROUP, UC BERKELEY
NRAO, SOCORRO
meerKAT, CAPE TOWN

DESCRIPTION
RECONFIGURABLE OPEN ARCHITECTURE HW

http://casper.berkeley.edu/

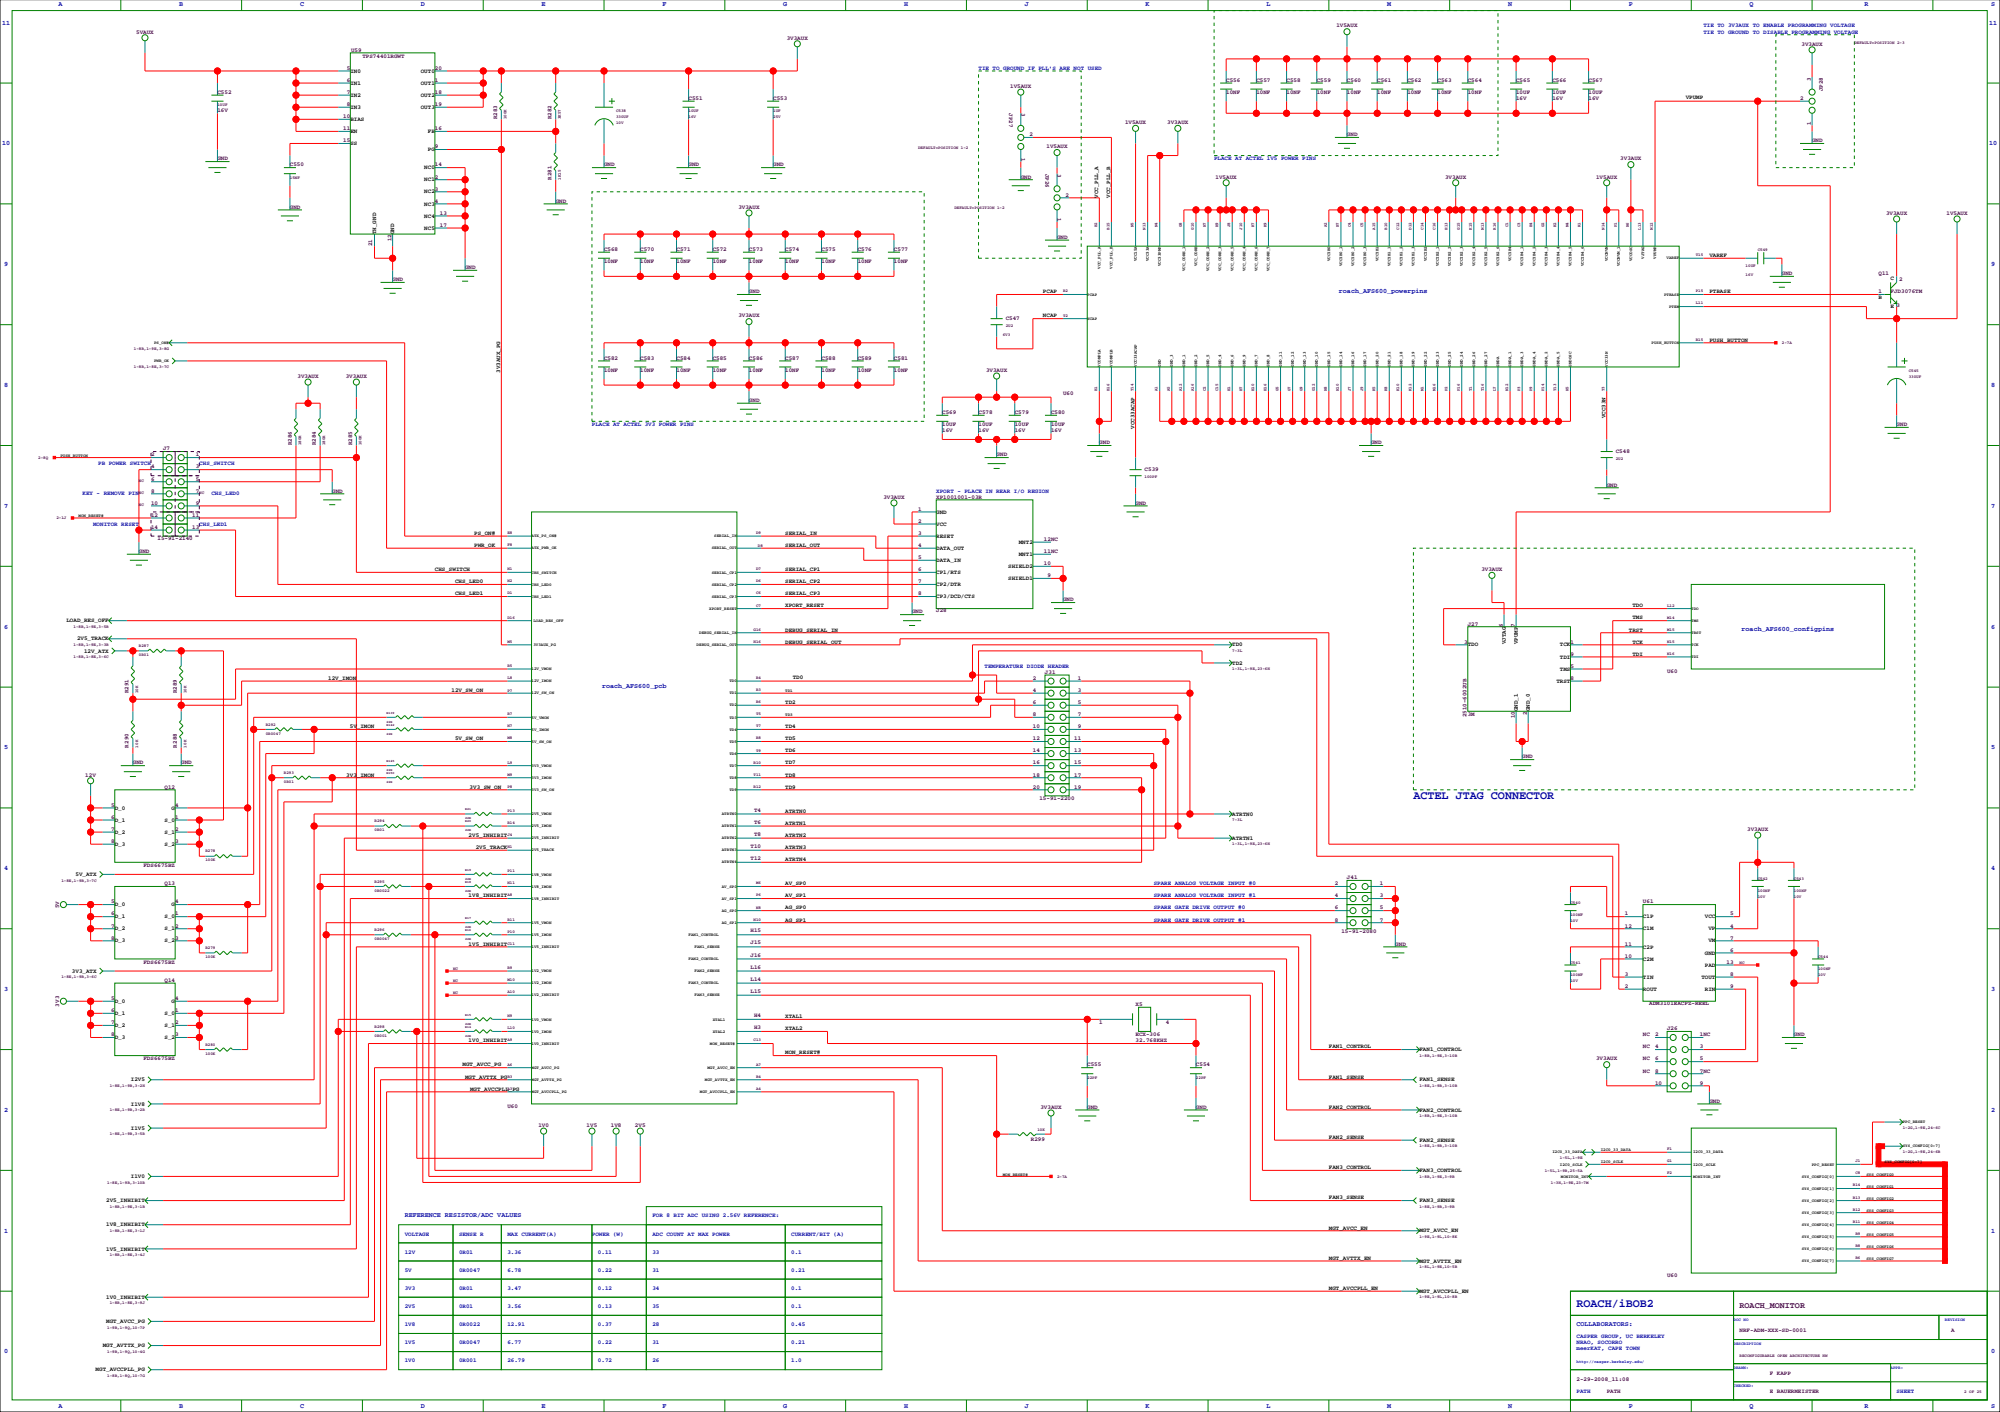
[picture p104: page 2]

TIE TO 3V3AUX TO ENABLE PROGRAMMING VOLTAGE
TIE TO GROUND TO DISABLE PROGRAMMING VOLTAGE

TIE TO GROUND IF PLL'S ARE NOT USED

PLACE AT ACTEL 1V5 POWER PINS

PLACE AT ACTEL 3V3 POWER PINS

XPORT - PLACE IN REAR I/O REGION

SPARE ANALOG VOLTAGE INPUT #0

SPARE ANALOG VOLTAGE INPUT #1

SPARE GATE DRIVE OUTPUT #0

SPARE GATE DRIVE OUTPUT #1

ADC COUNT AT MAX POWER

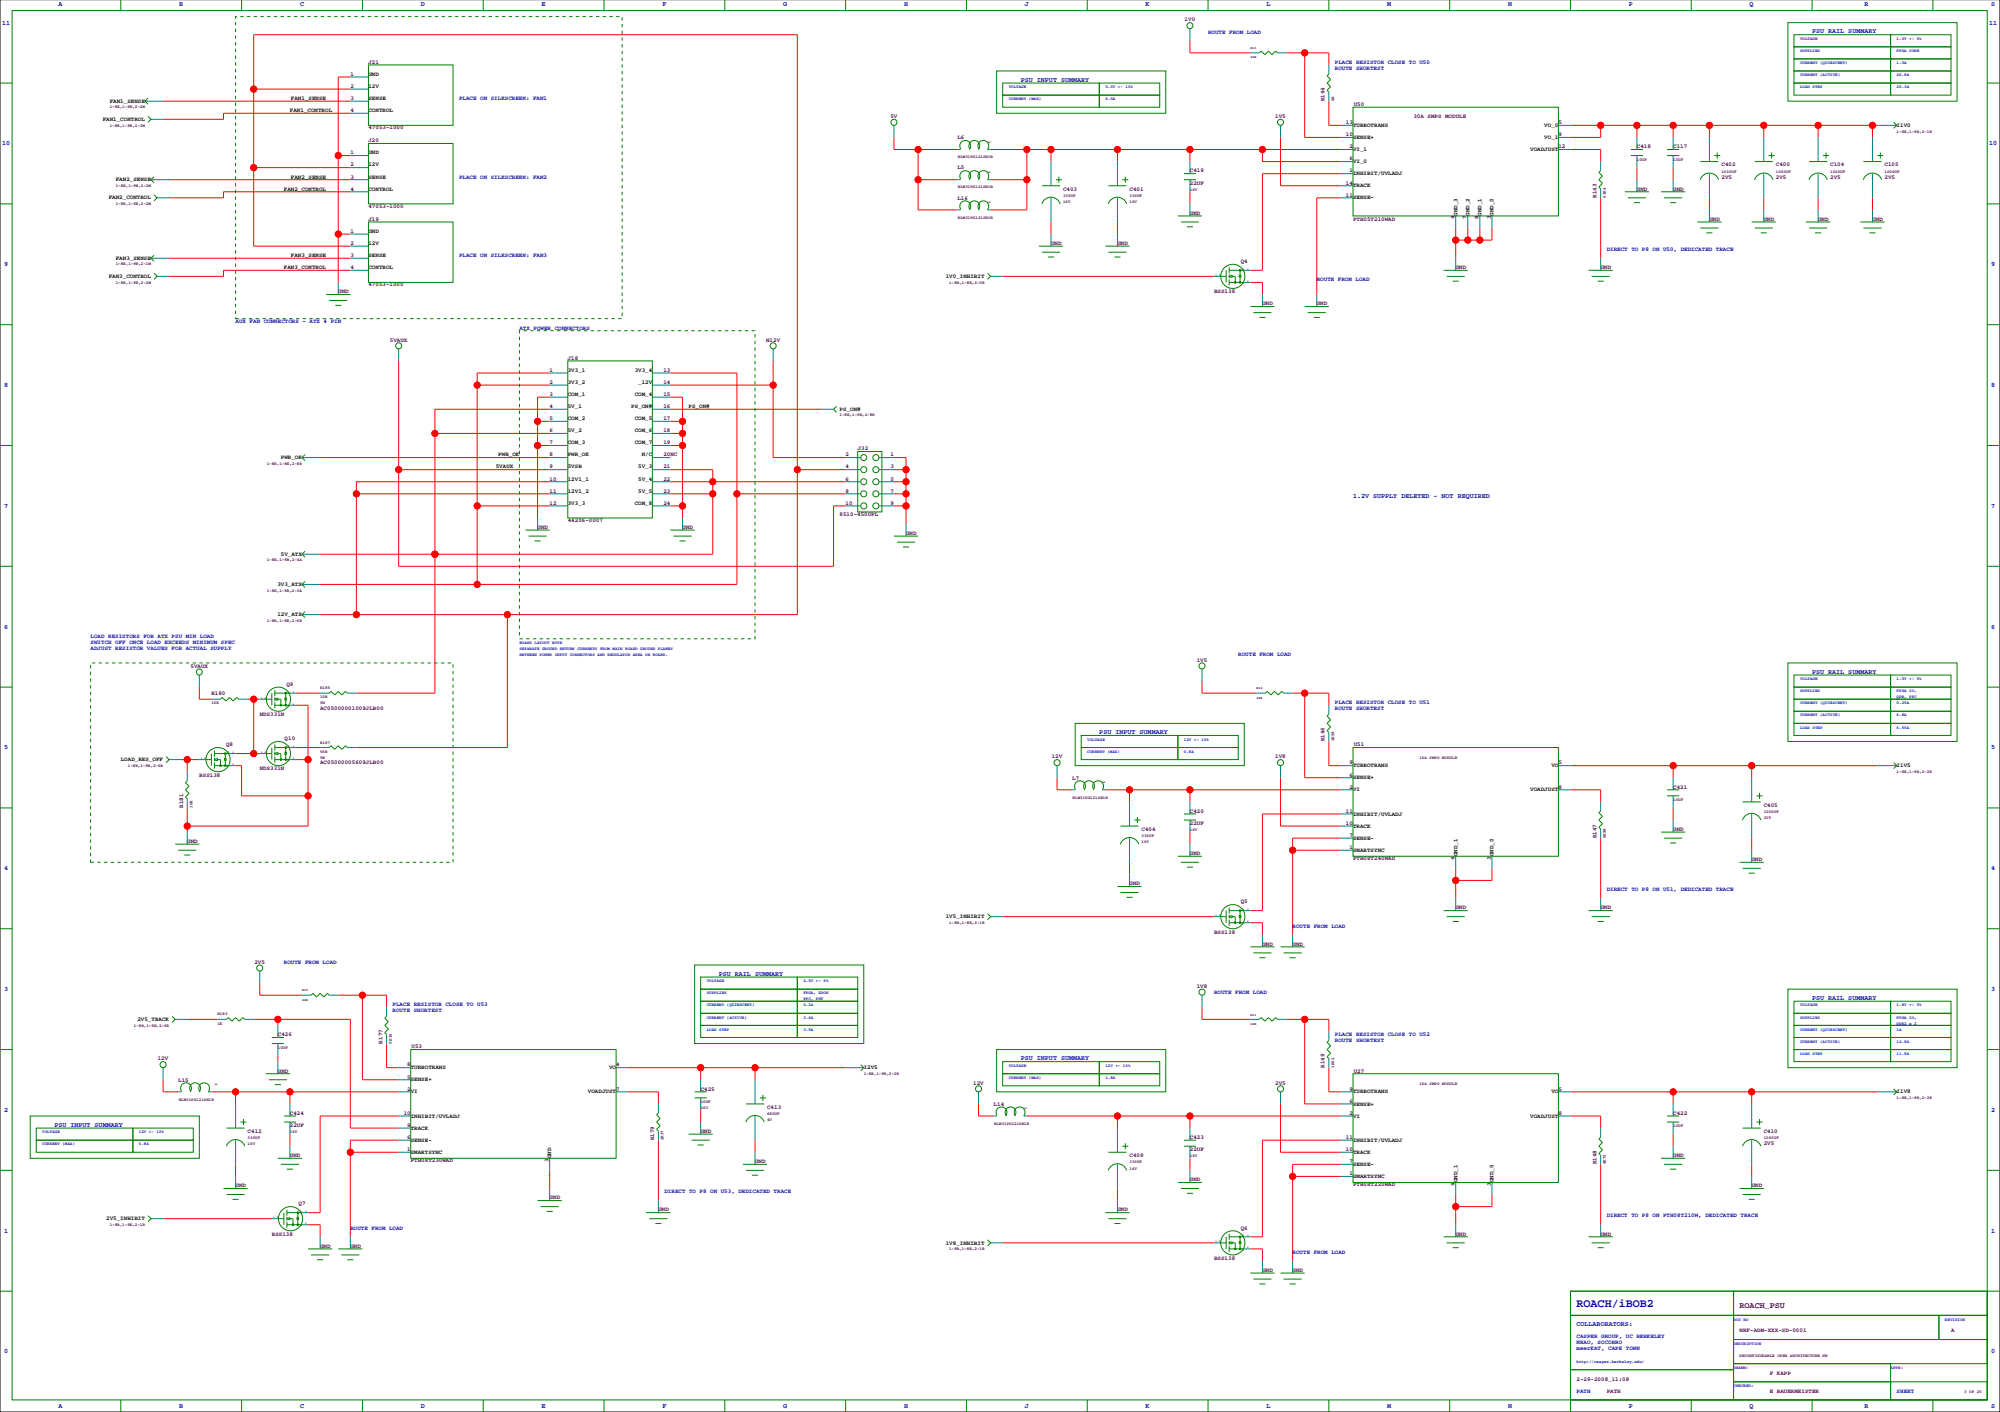
[picture p105: page 3]

PLACE RESISTOR CLOSE TO U50
ROUTE SHORTEST

DIRECT TO P8 ON U50, DEDICATED TRACE

AUX FAN CONNECTORS - ATX 4 PIN

1.2V SUPPLY DELETED - NOT REQUIRED

LOAD RESISTORS FOR ATX PSU MIN LOAD
SWITCH OFF ONCE LOAD EXCEEDS MINIMUM SPEC
ADJUST RESISTOR VALUES FOR ACTUAL SUPPLY

BOARD LAYOUT NOTE
SEPARATE GROUND RETURN CURRENTS FROM MAIN BOARD GROUND PLANES
BETWEEN POWER INPUT CONNECTORS AND REGULATOR AREA ON BOARD.

PLACE RESISTOR CLOSE TO U51

DIRECT TO P8 ON U51, DEDICATED TRACE

PLACE RESISTOR CLOSE TO U53

PLACE RESISTOR CLOSE TO U52

DIRECT TO P8 ON U53, DEDICATED TRACE

DIRECT TO P8 ON PTH08T210W, DEDICATED TRACE

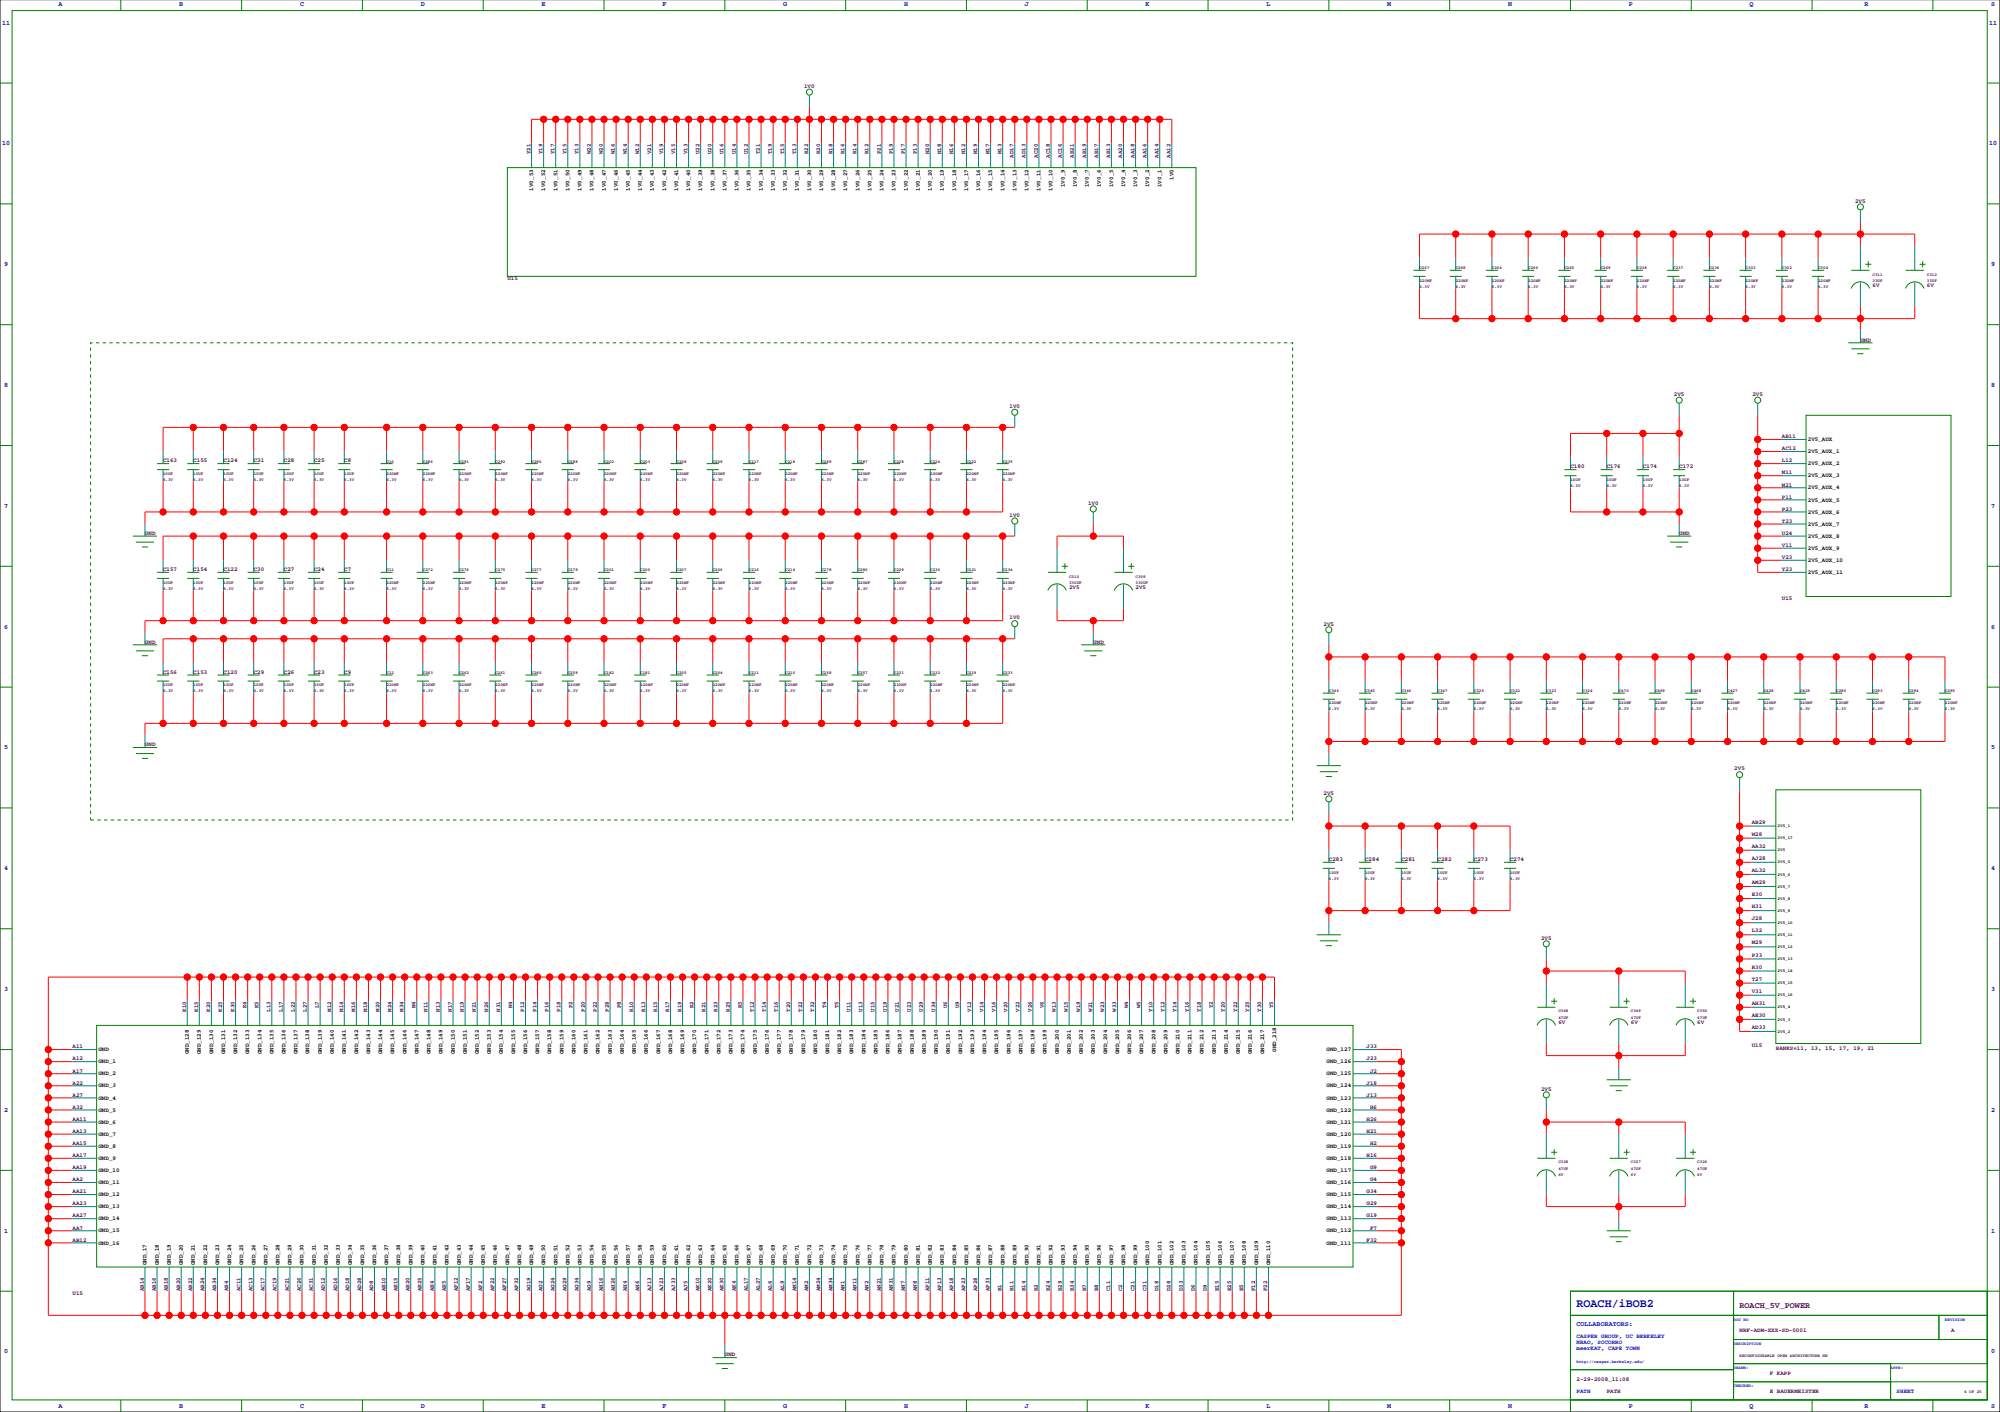
[picture p106: page 4]

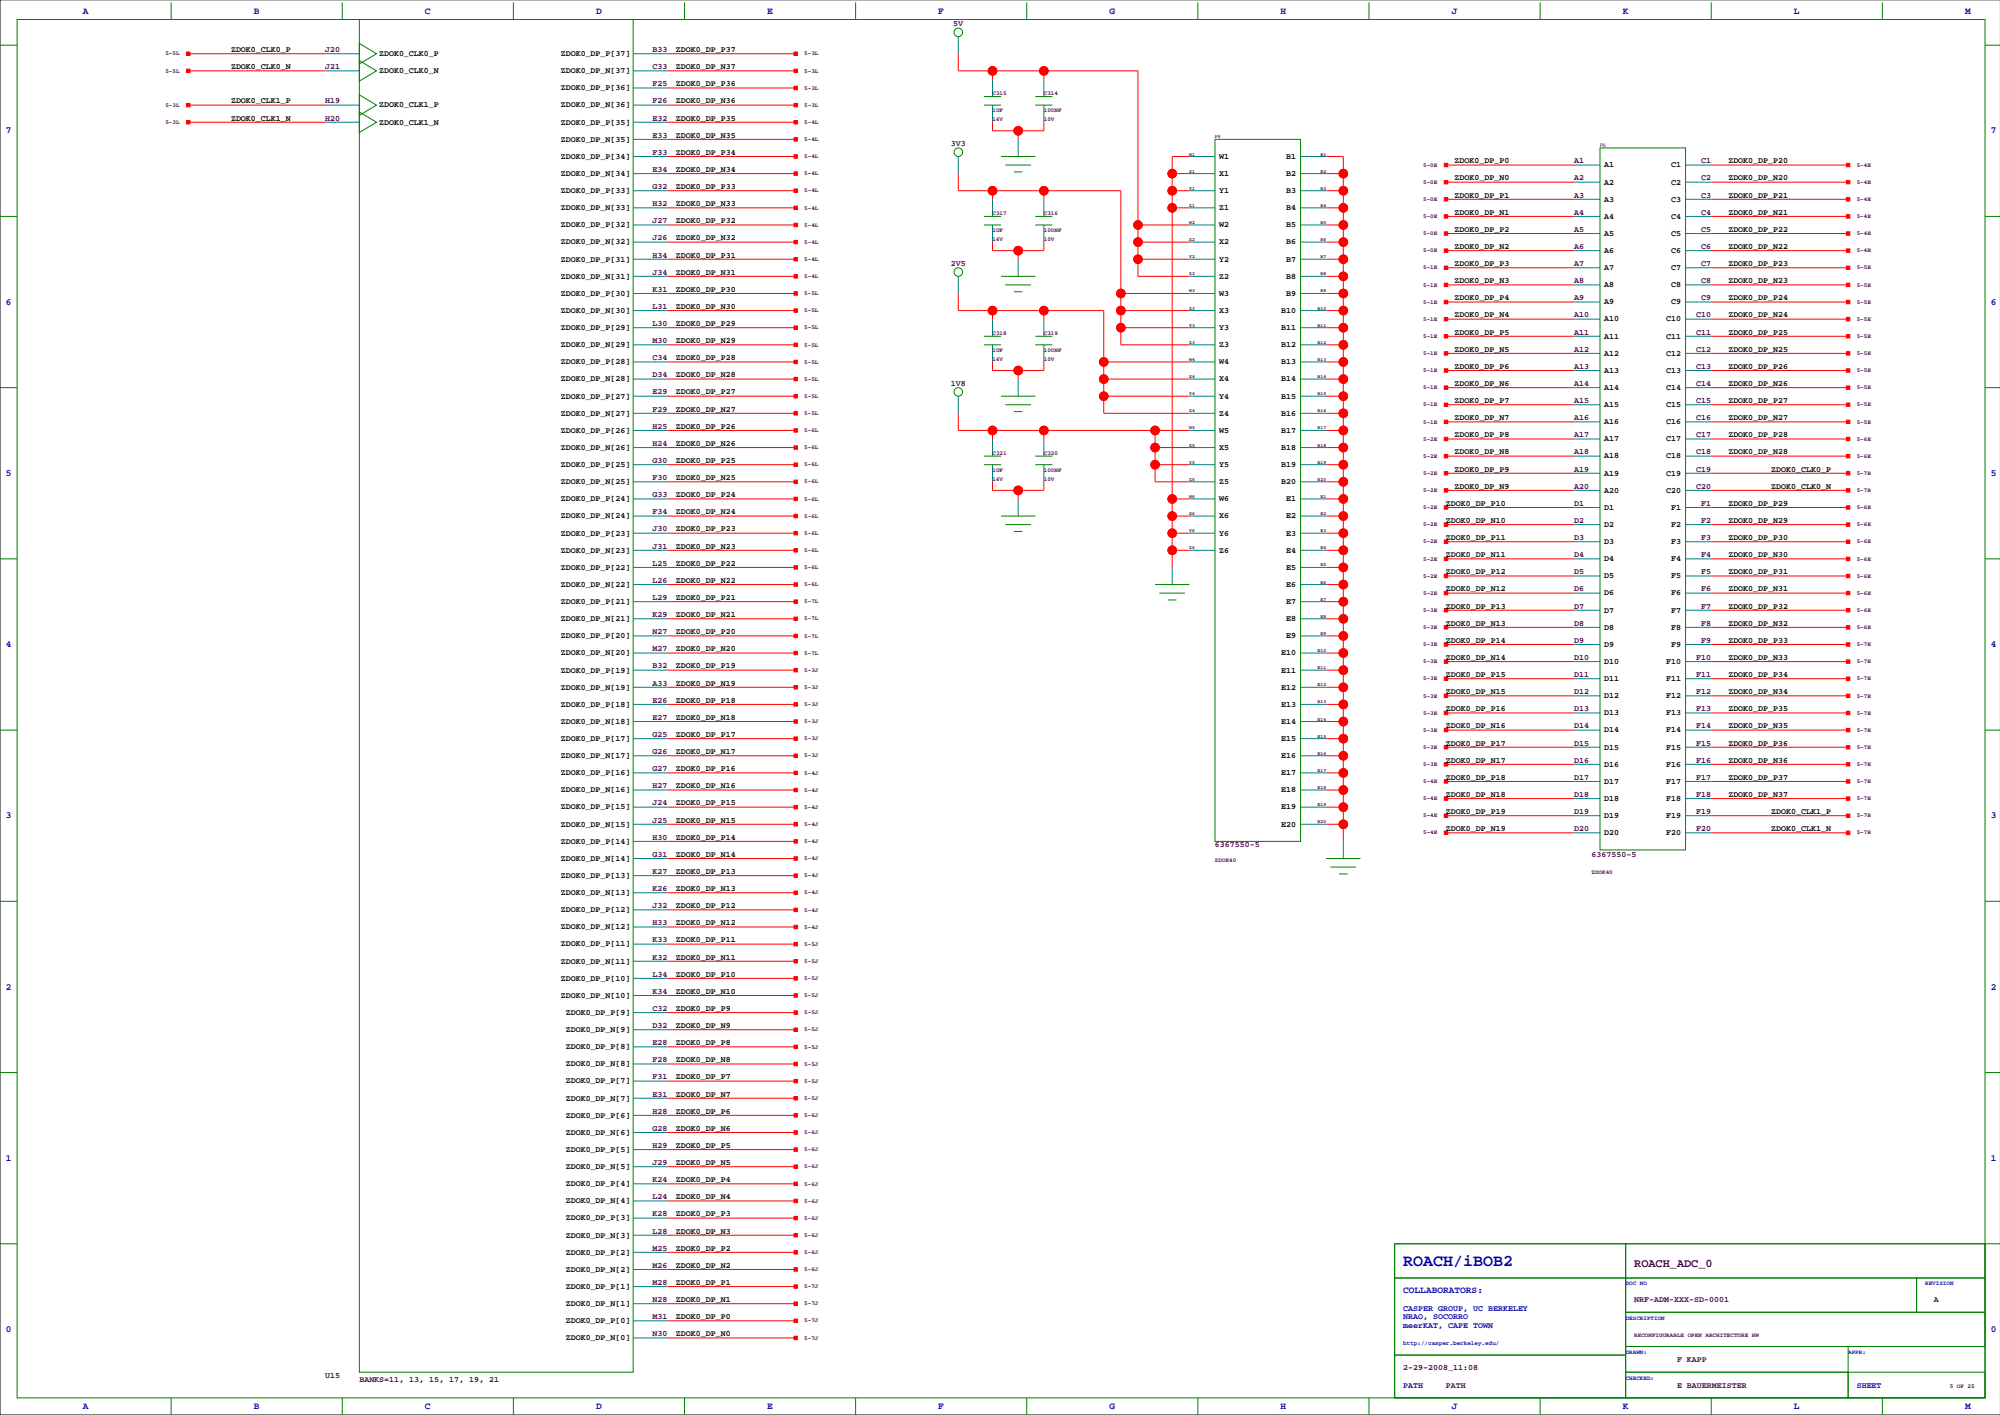
[picture p107: page 5]

DOC NO
NRF-ADM-XXX-SD-0001

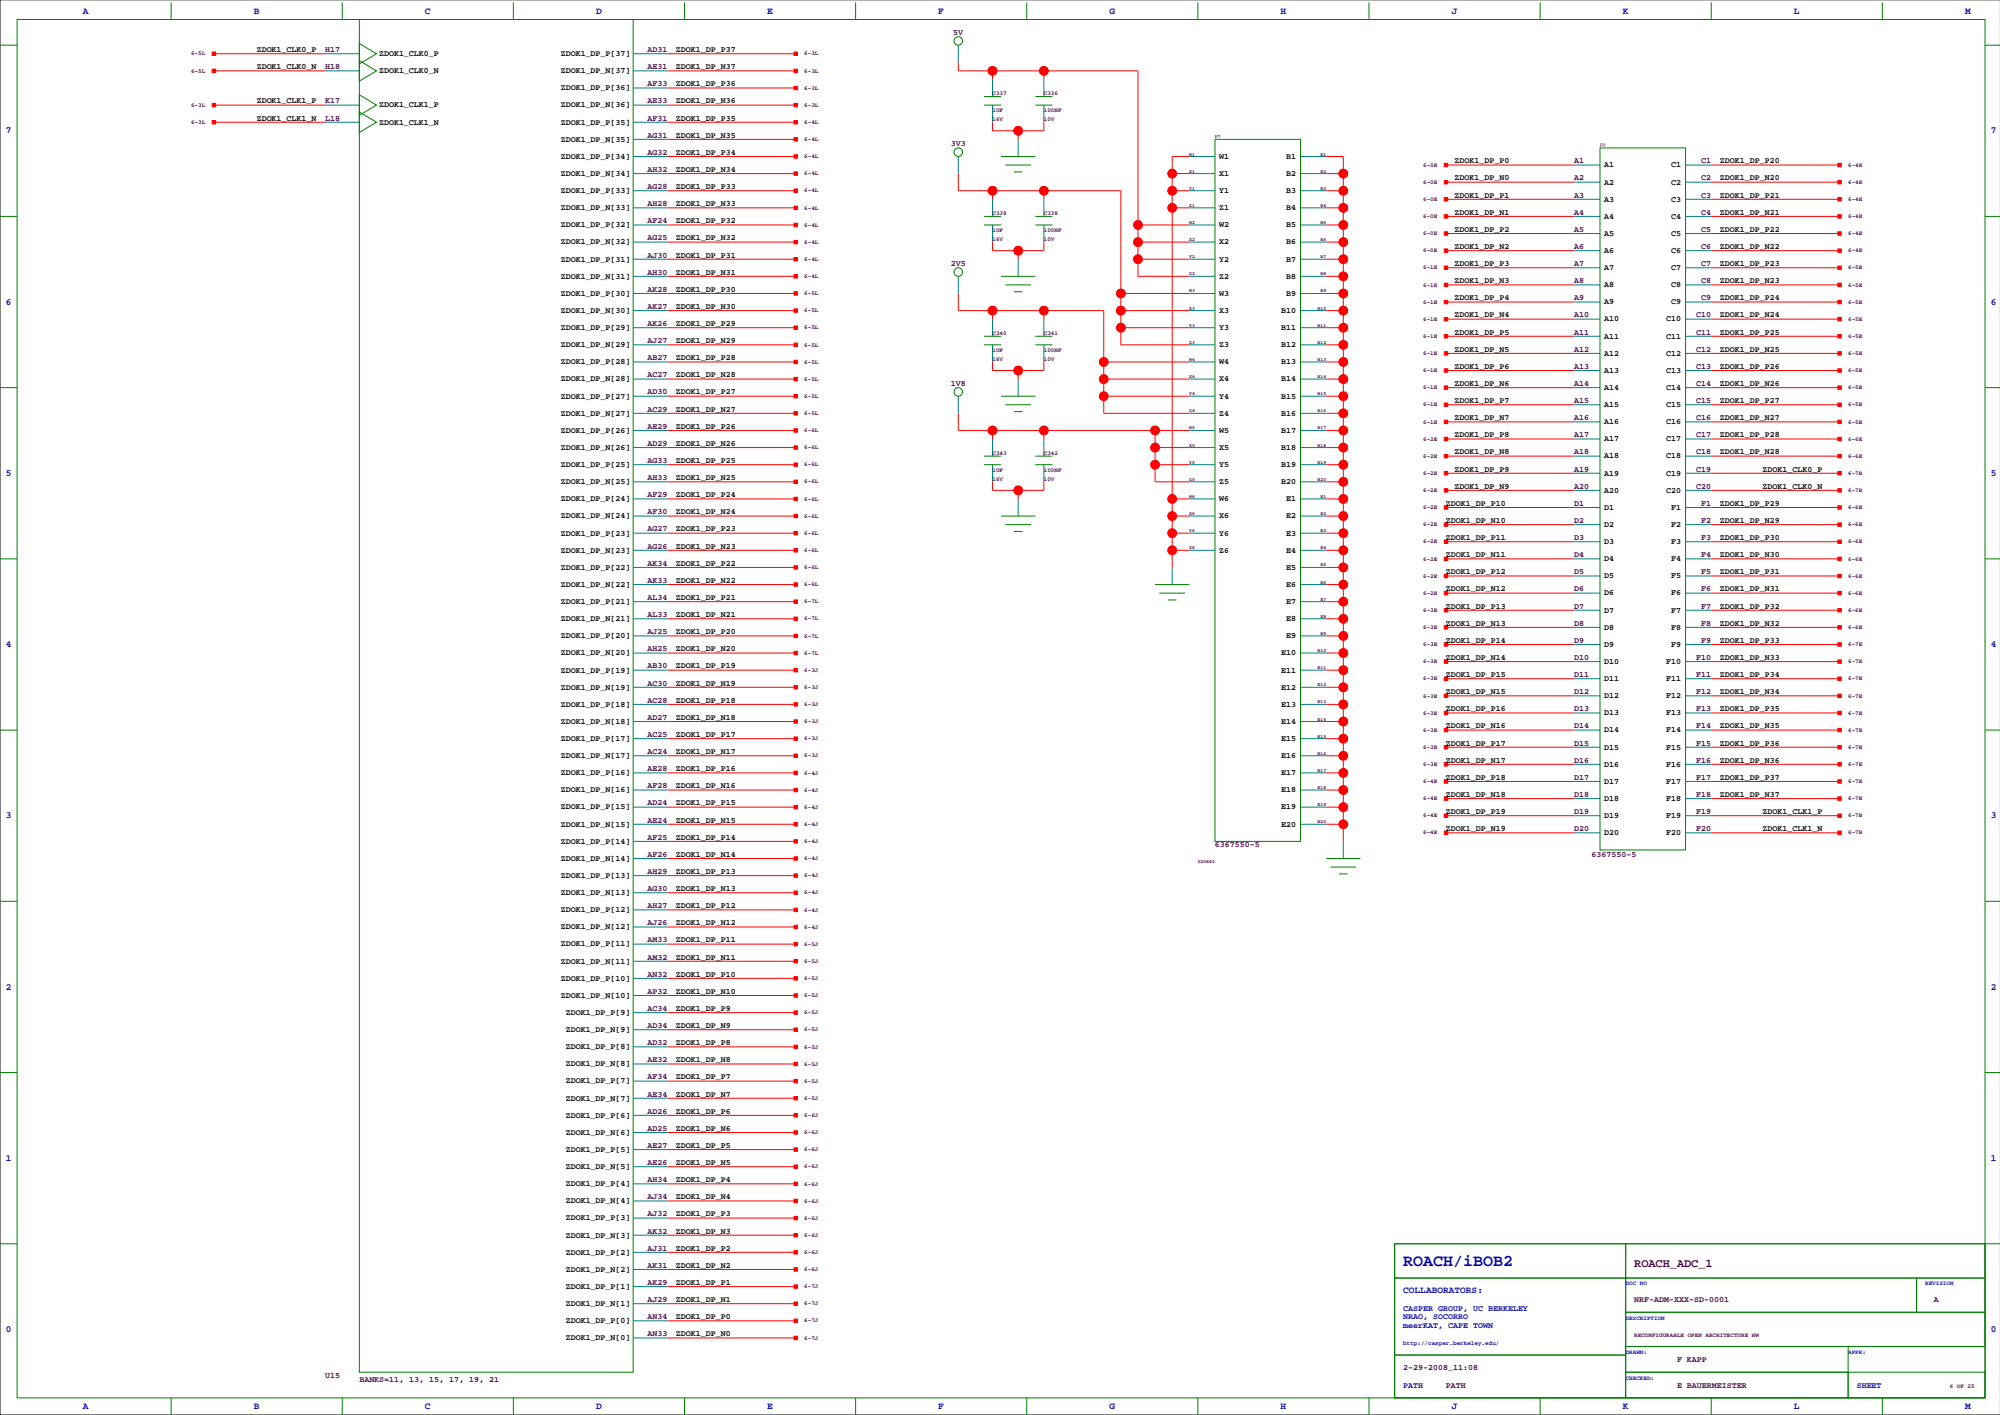
[picture p108: page 6]

DOC NO
NRF-ADM-XXX-SD-0001

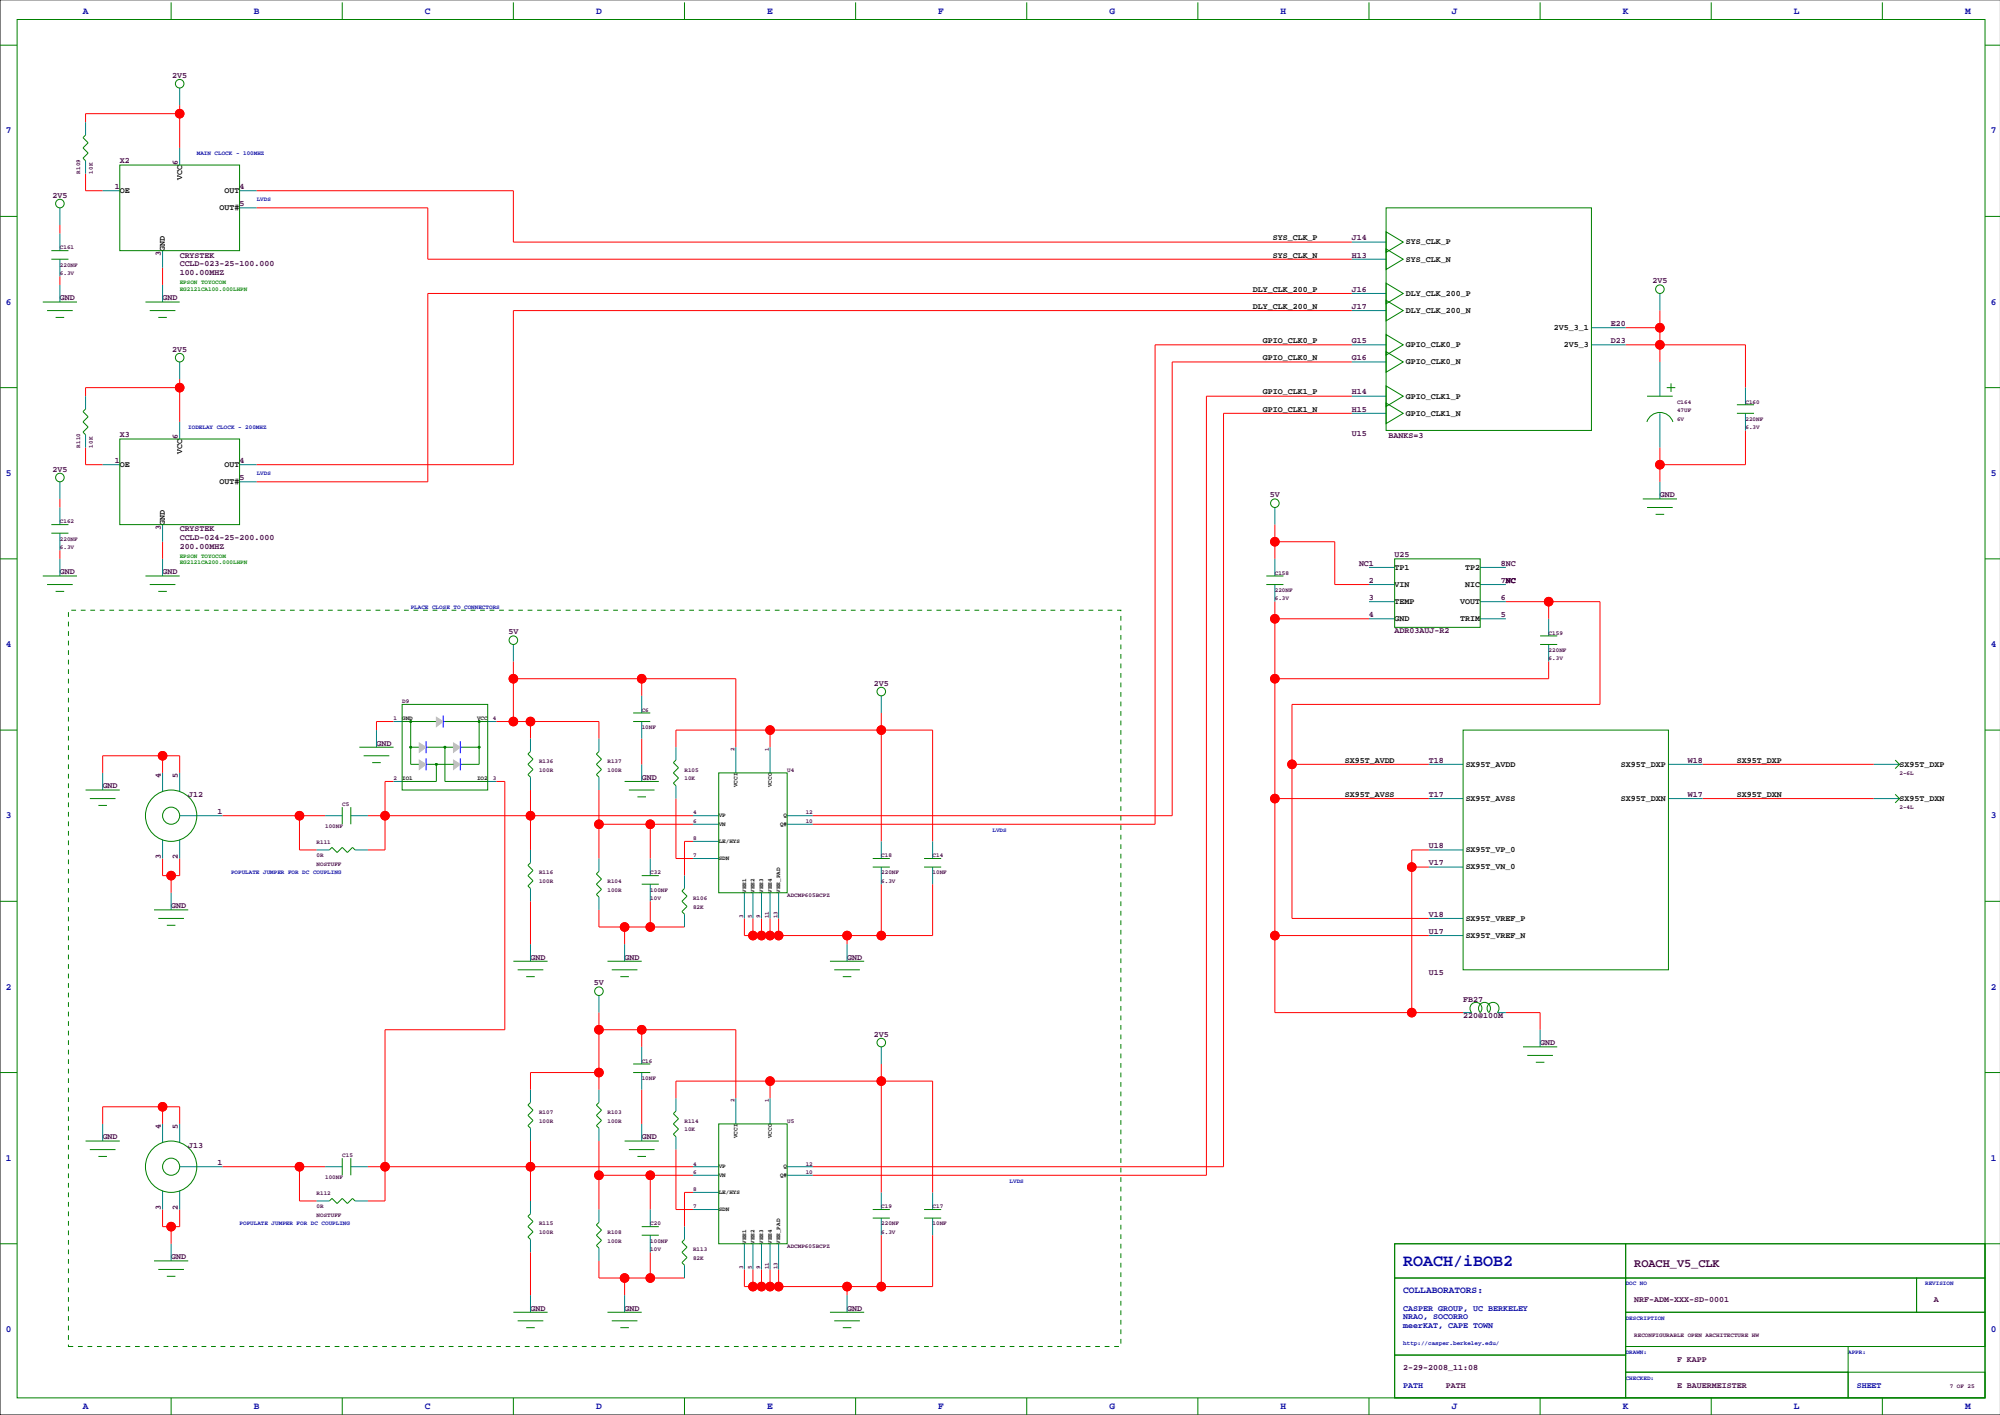
[picture p109: page 7]

PLACE CLOSE TO CONNECTORS

POPULATE JUMPER FOR DC COUPLING

# 3V3 R79 150R

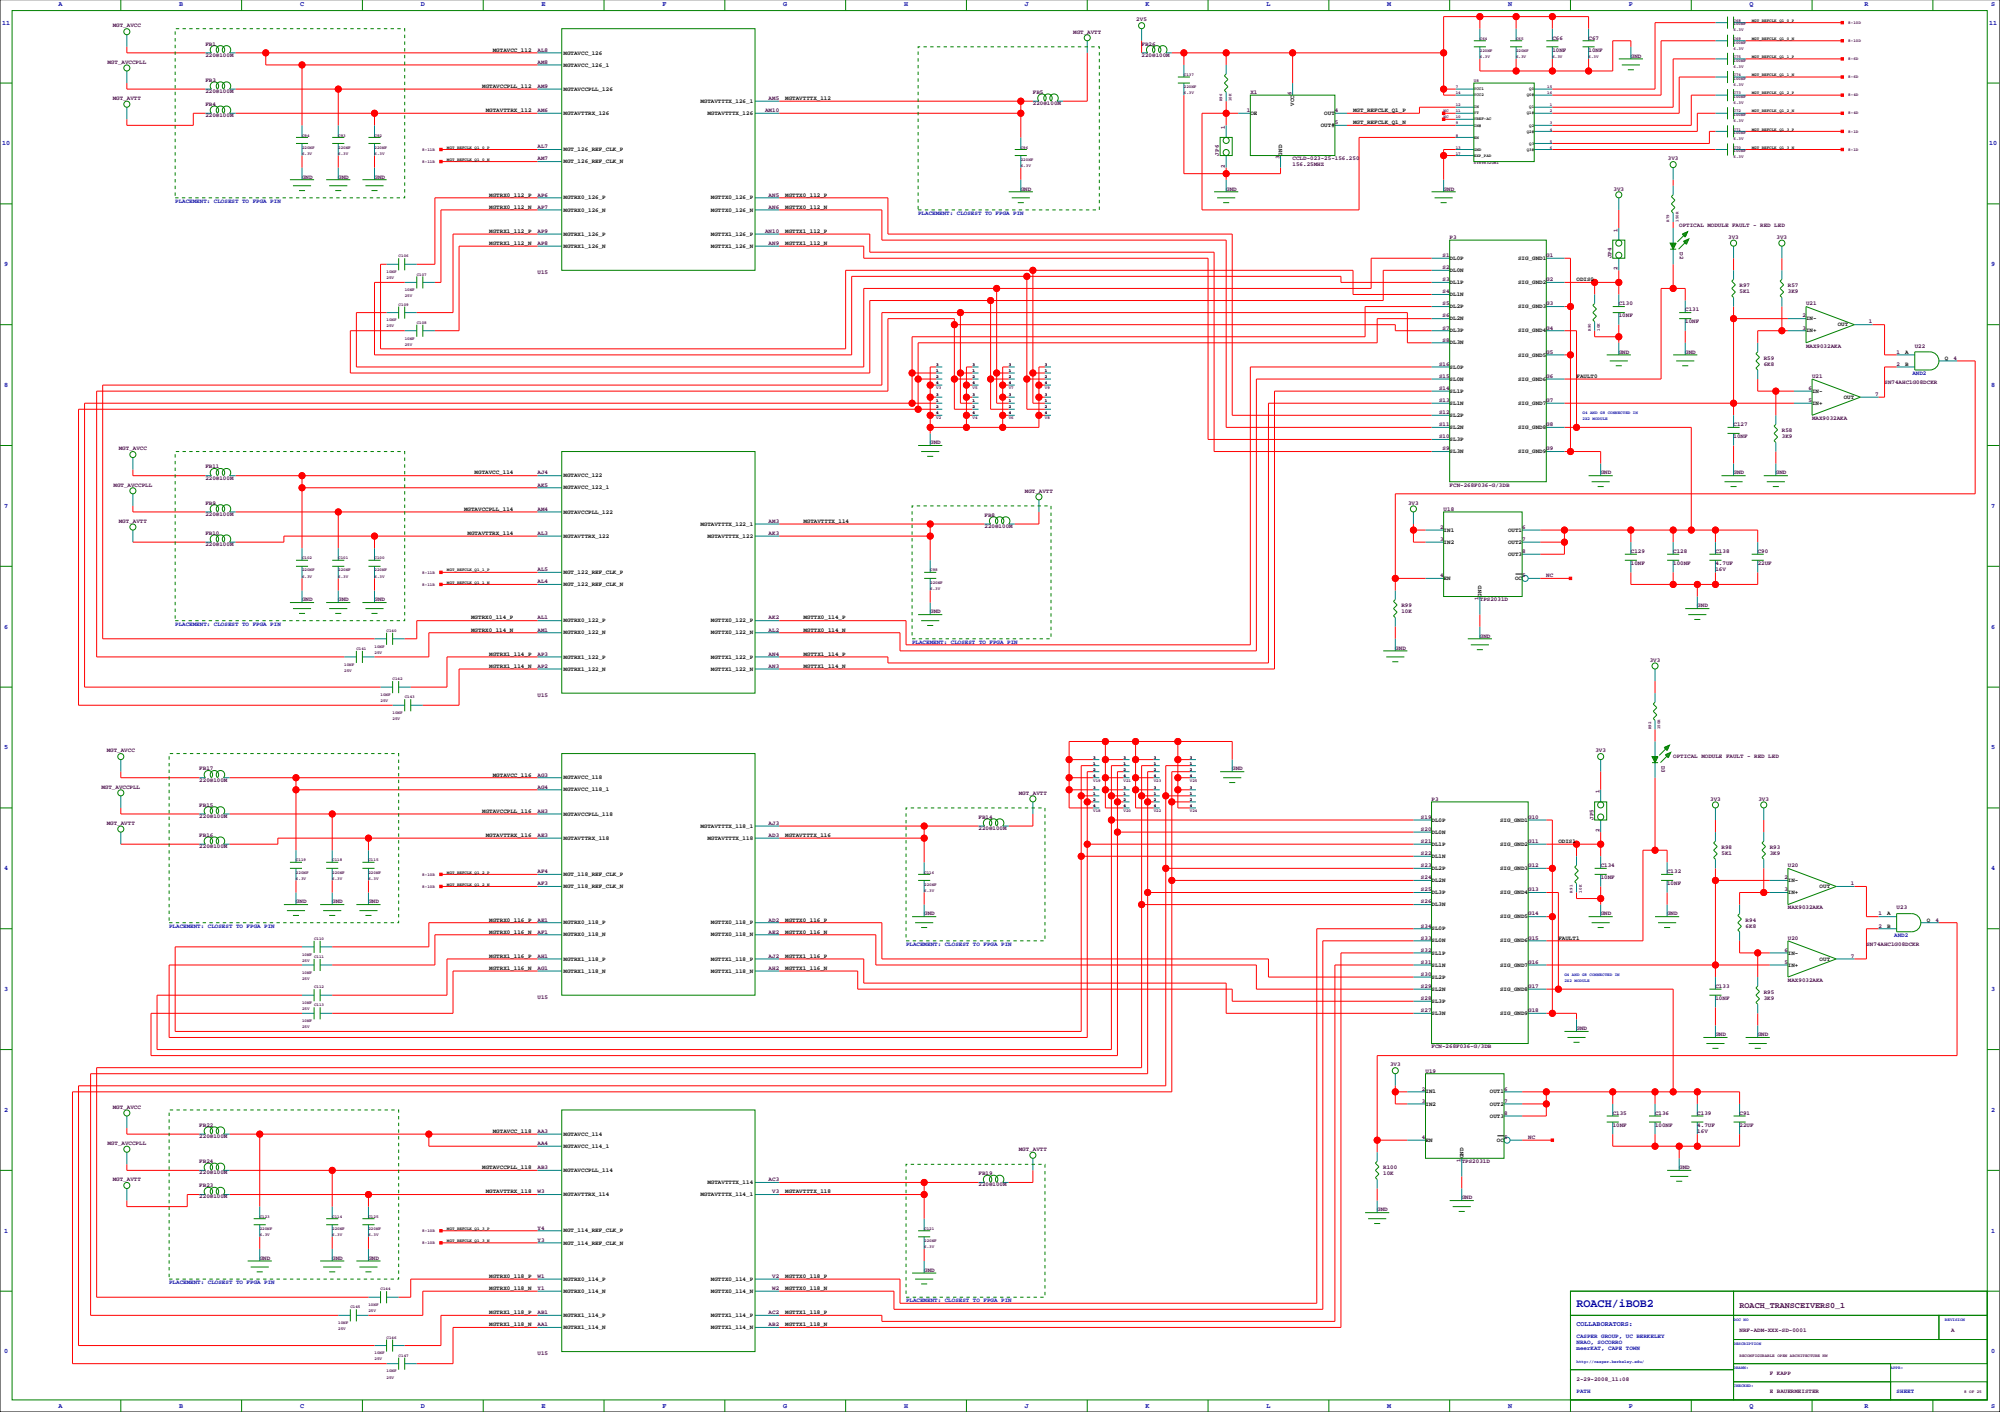
[picture p110: page 8]

PLACEMENT: CLOSEST TO FPGA PIN

D2 OPTICAL MODULE FAULT - RED LED

S12 G8 | G4 AND G8 CONNECTED IN 2X2 MODULE

OPTICAL MODULE FAULT - RED LED

# FAULT2R123

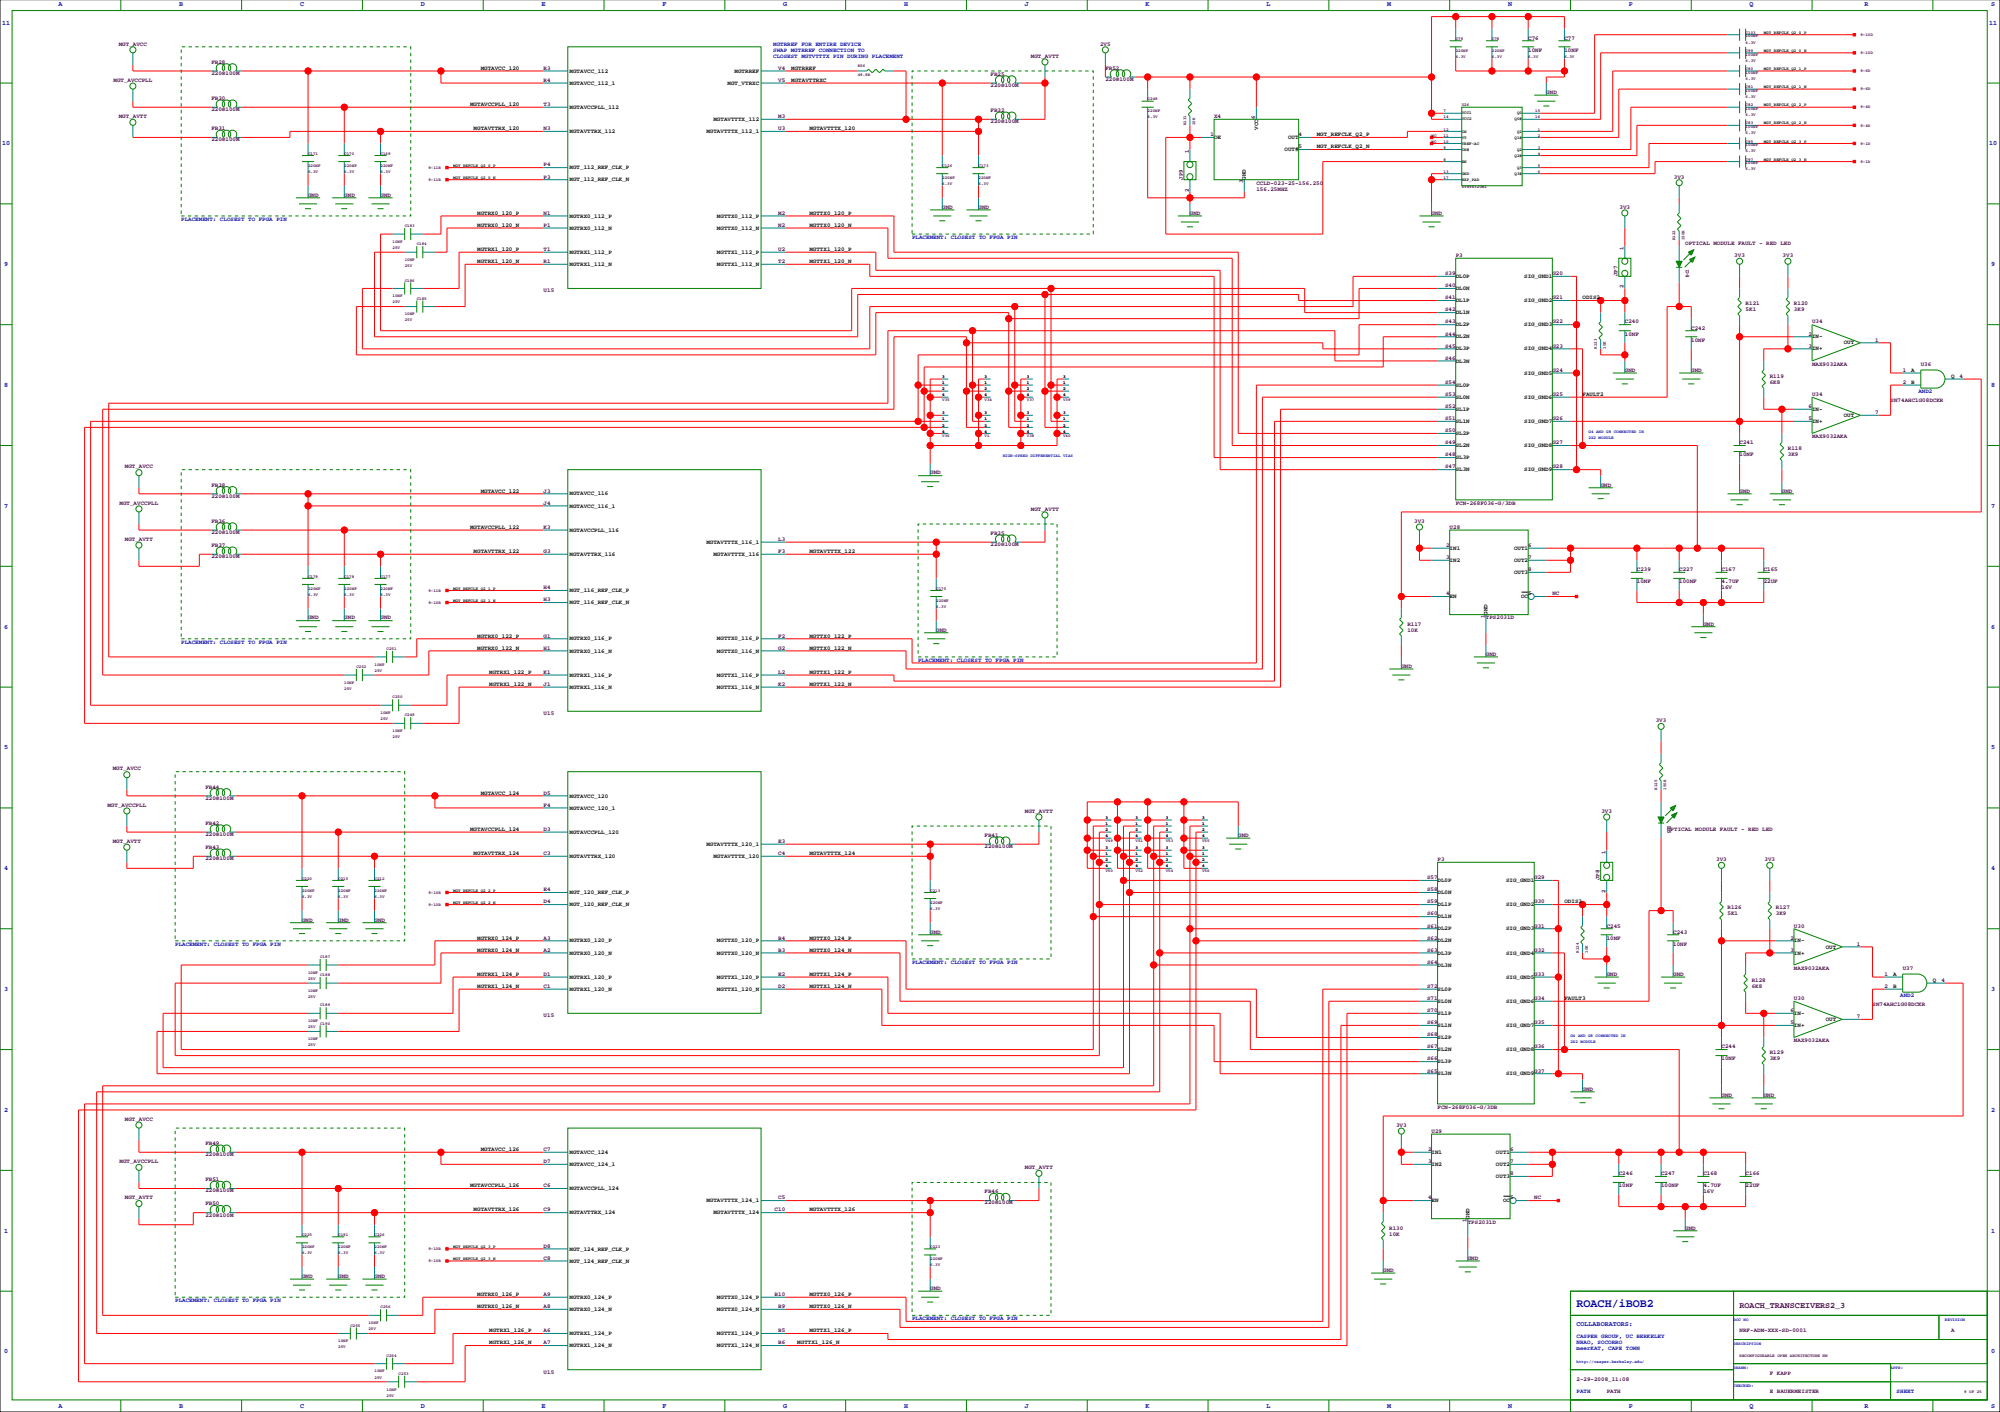
[picture p111: page 9]

MGTRREF FOR ENTIRE DEVICE
SWAP MGTRREF CONNECTION TO
CLOSEST MGTVTTTX PIN DURING PLACEMENT

PLACEMENT: CLOSEST TO FPGA PIN

S50 G27 | G4 AND G8 CONNECTED IN 2X2 MODULE

HIGH-SPEED DIFFERENTIAL VIAS

D5OPTICAL MODULE FAULT - RED LED

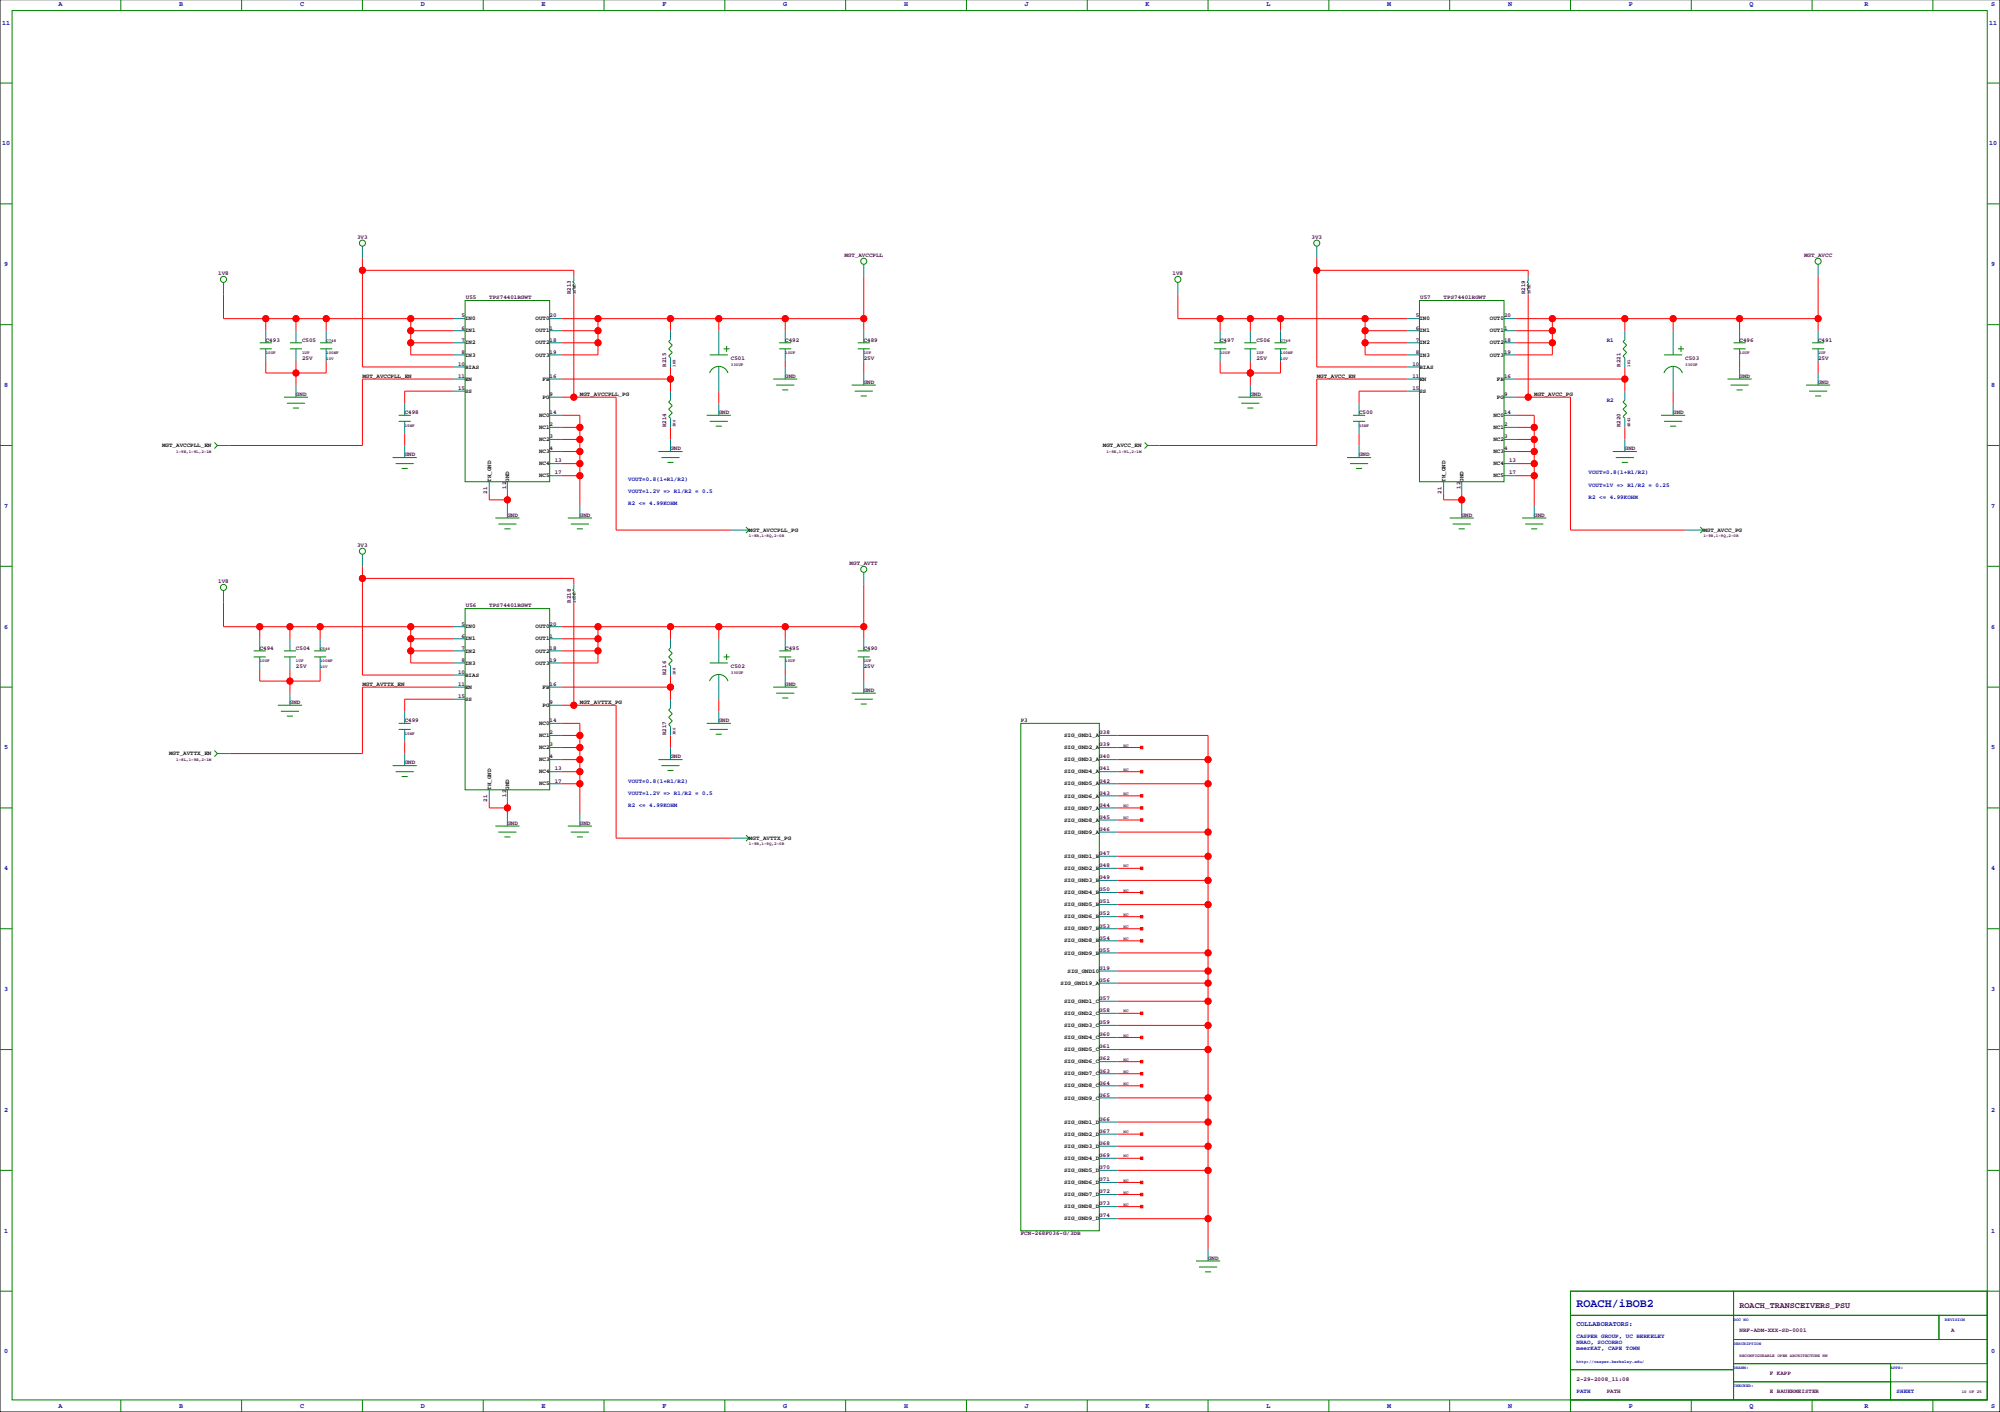
[picture p112: page 10]

C392 | C393
C394 | C395

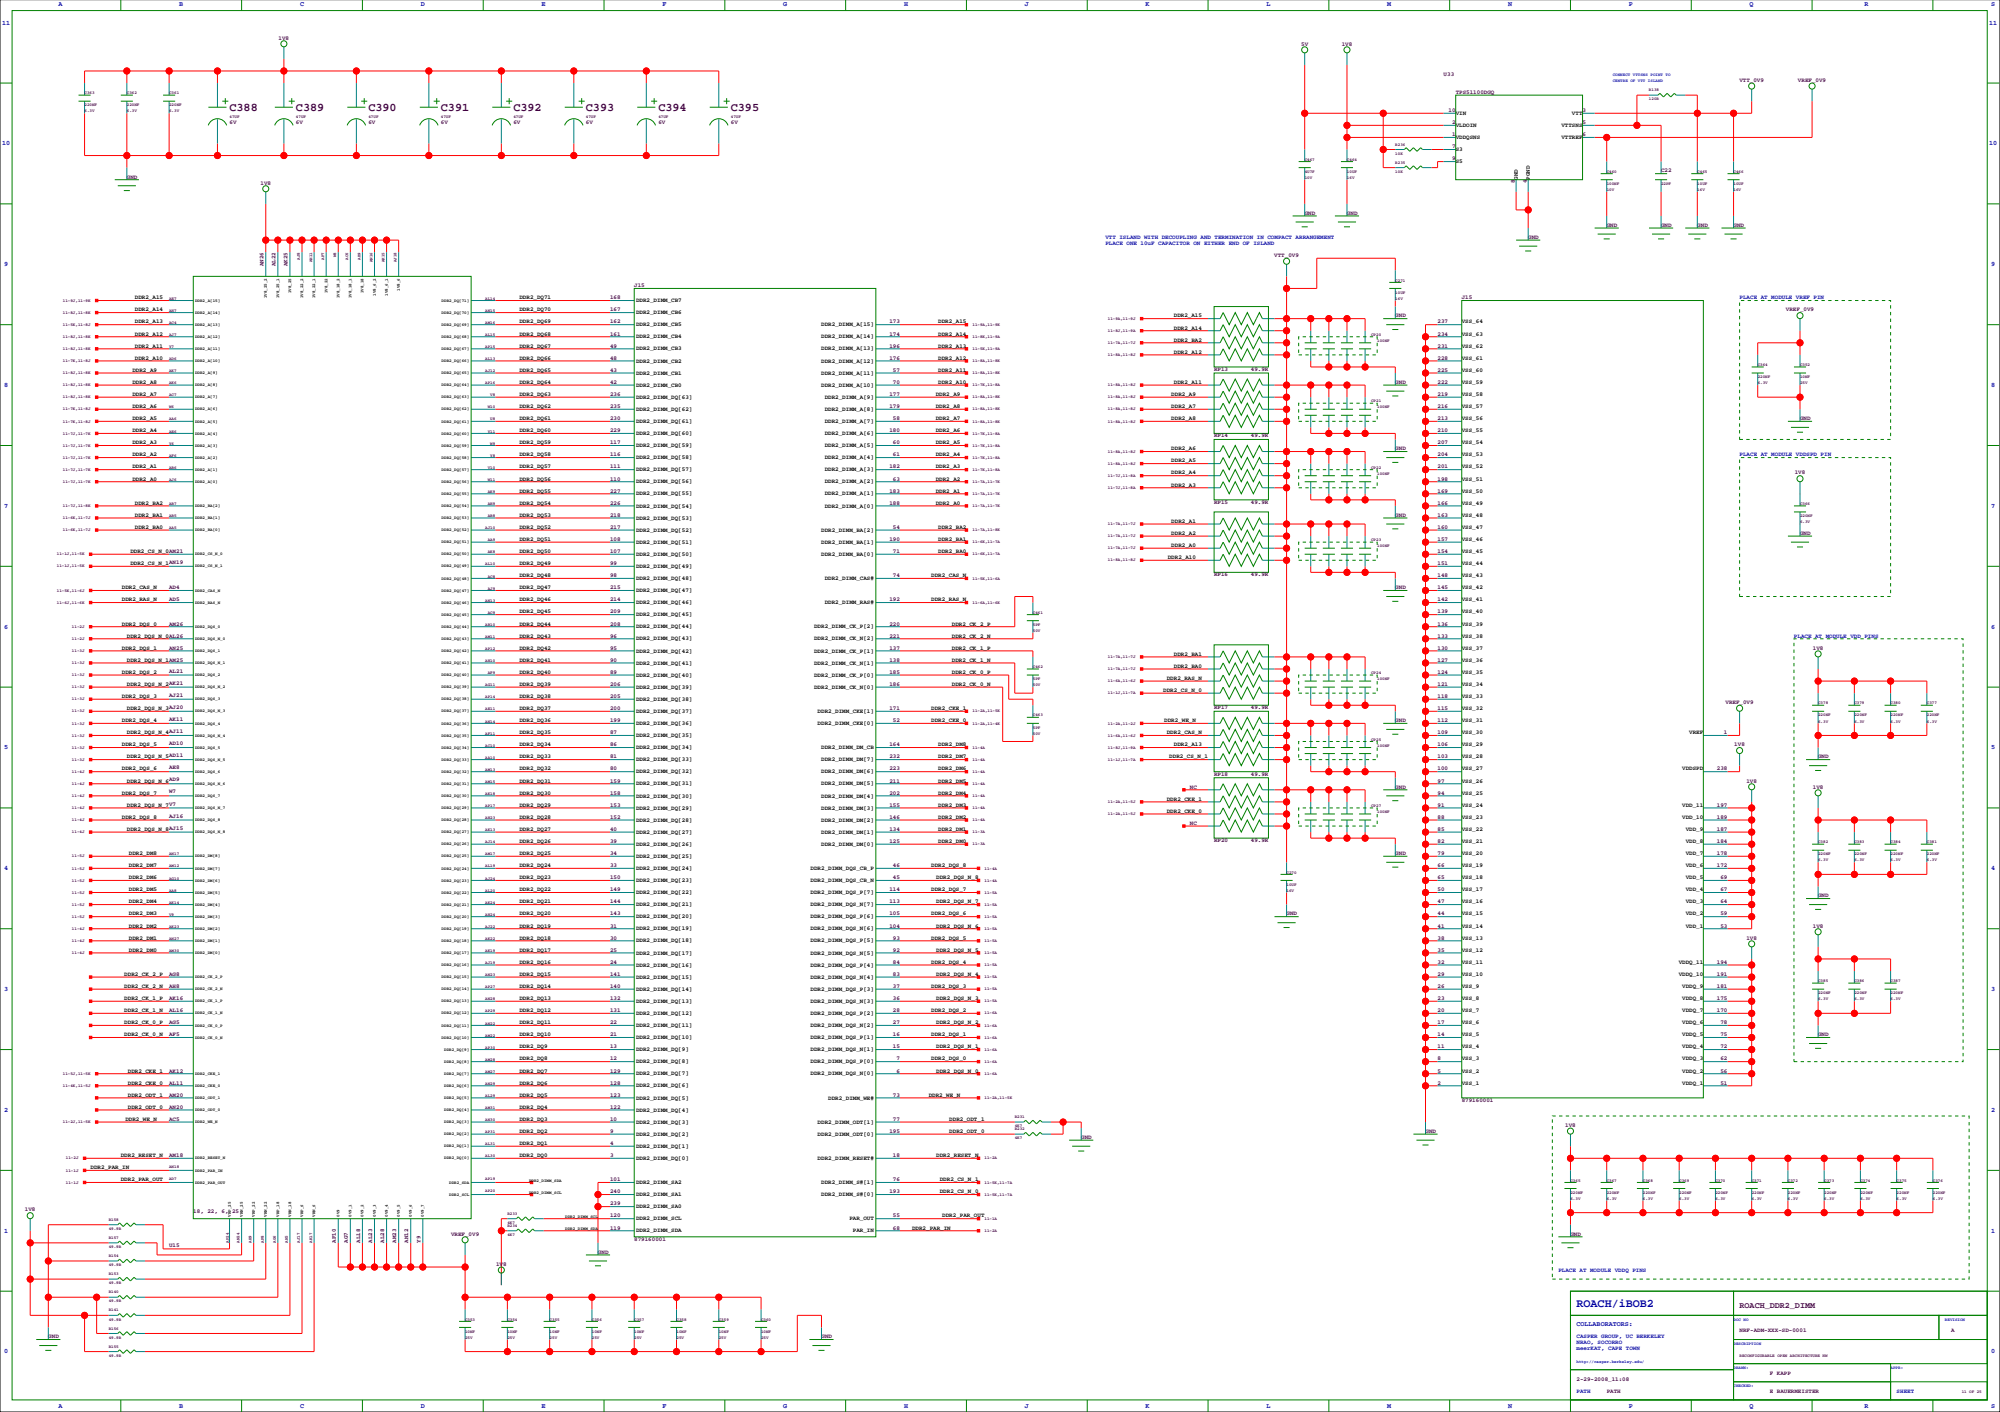
[picture p113: page 11]

CONNECT VTTSNS POINT TO
CENTRE OF VTT ISLAND

VTT ISLAND WITH DECOUPLING AND TERMINATION IN COMPACT ARRANGEMENT
PLACE ONE 10uF CAPACITOR ON EITHER END OF ISLAND

PLACE AT MODULE VREF PIN

PLACE AT MODULE VDDSPD PIN

PLACE AT MODULE VDD PINS

PLACE AT MODULE VDDQ PINS

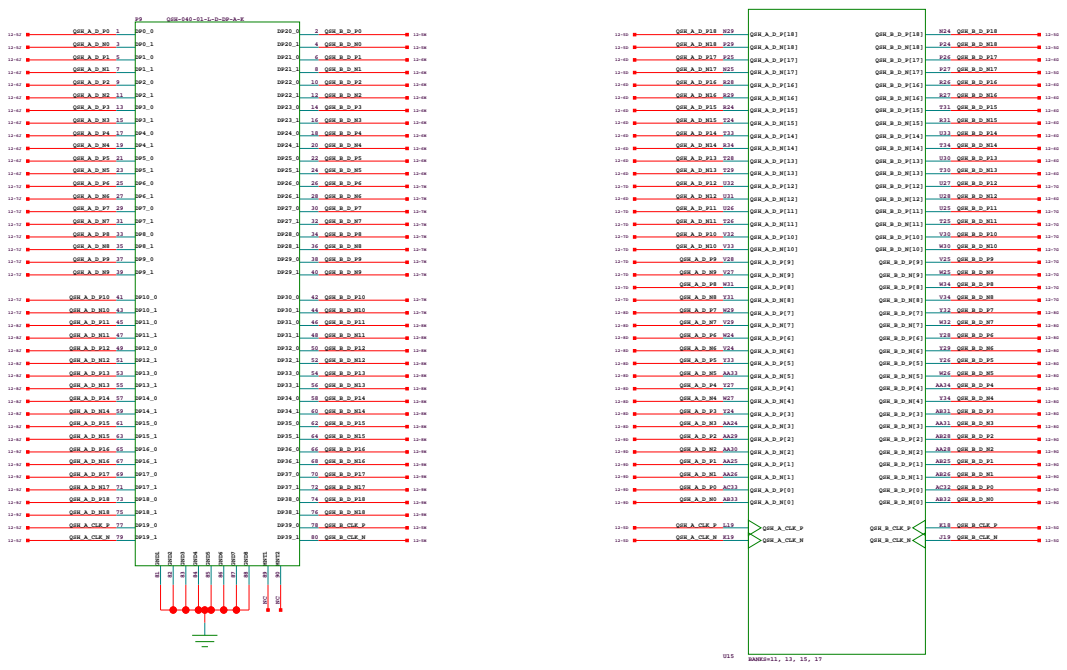
[picture p114: page 12]

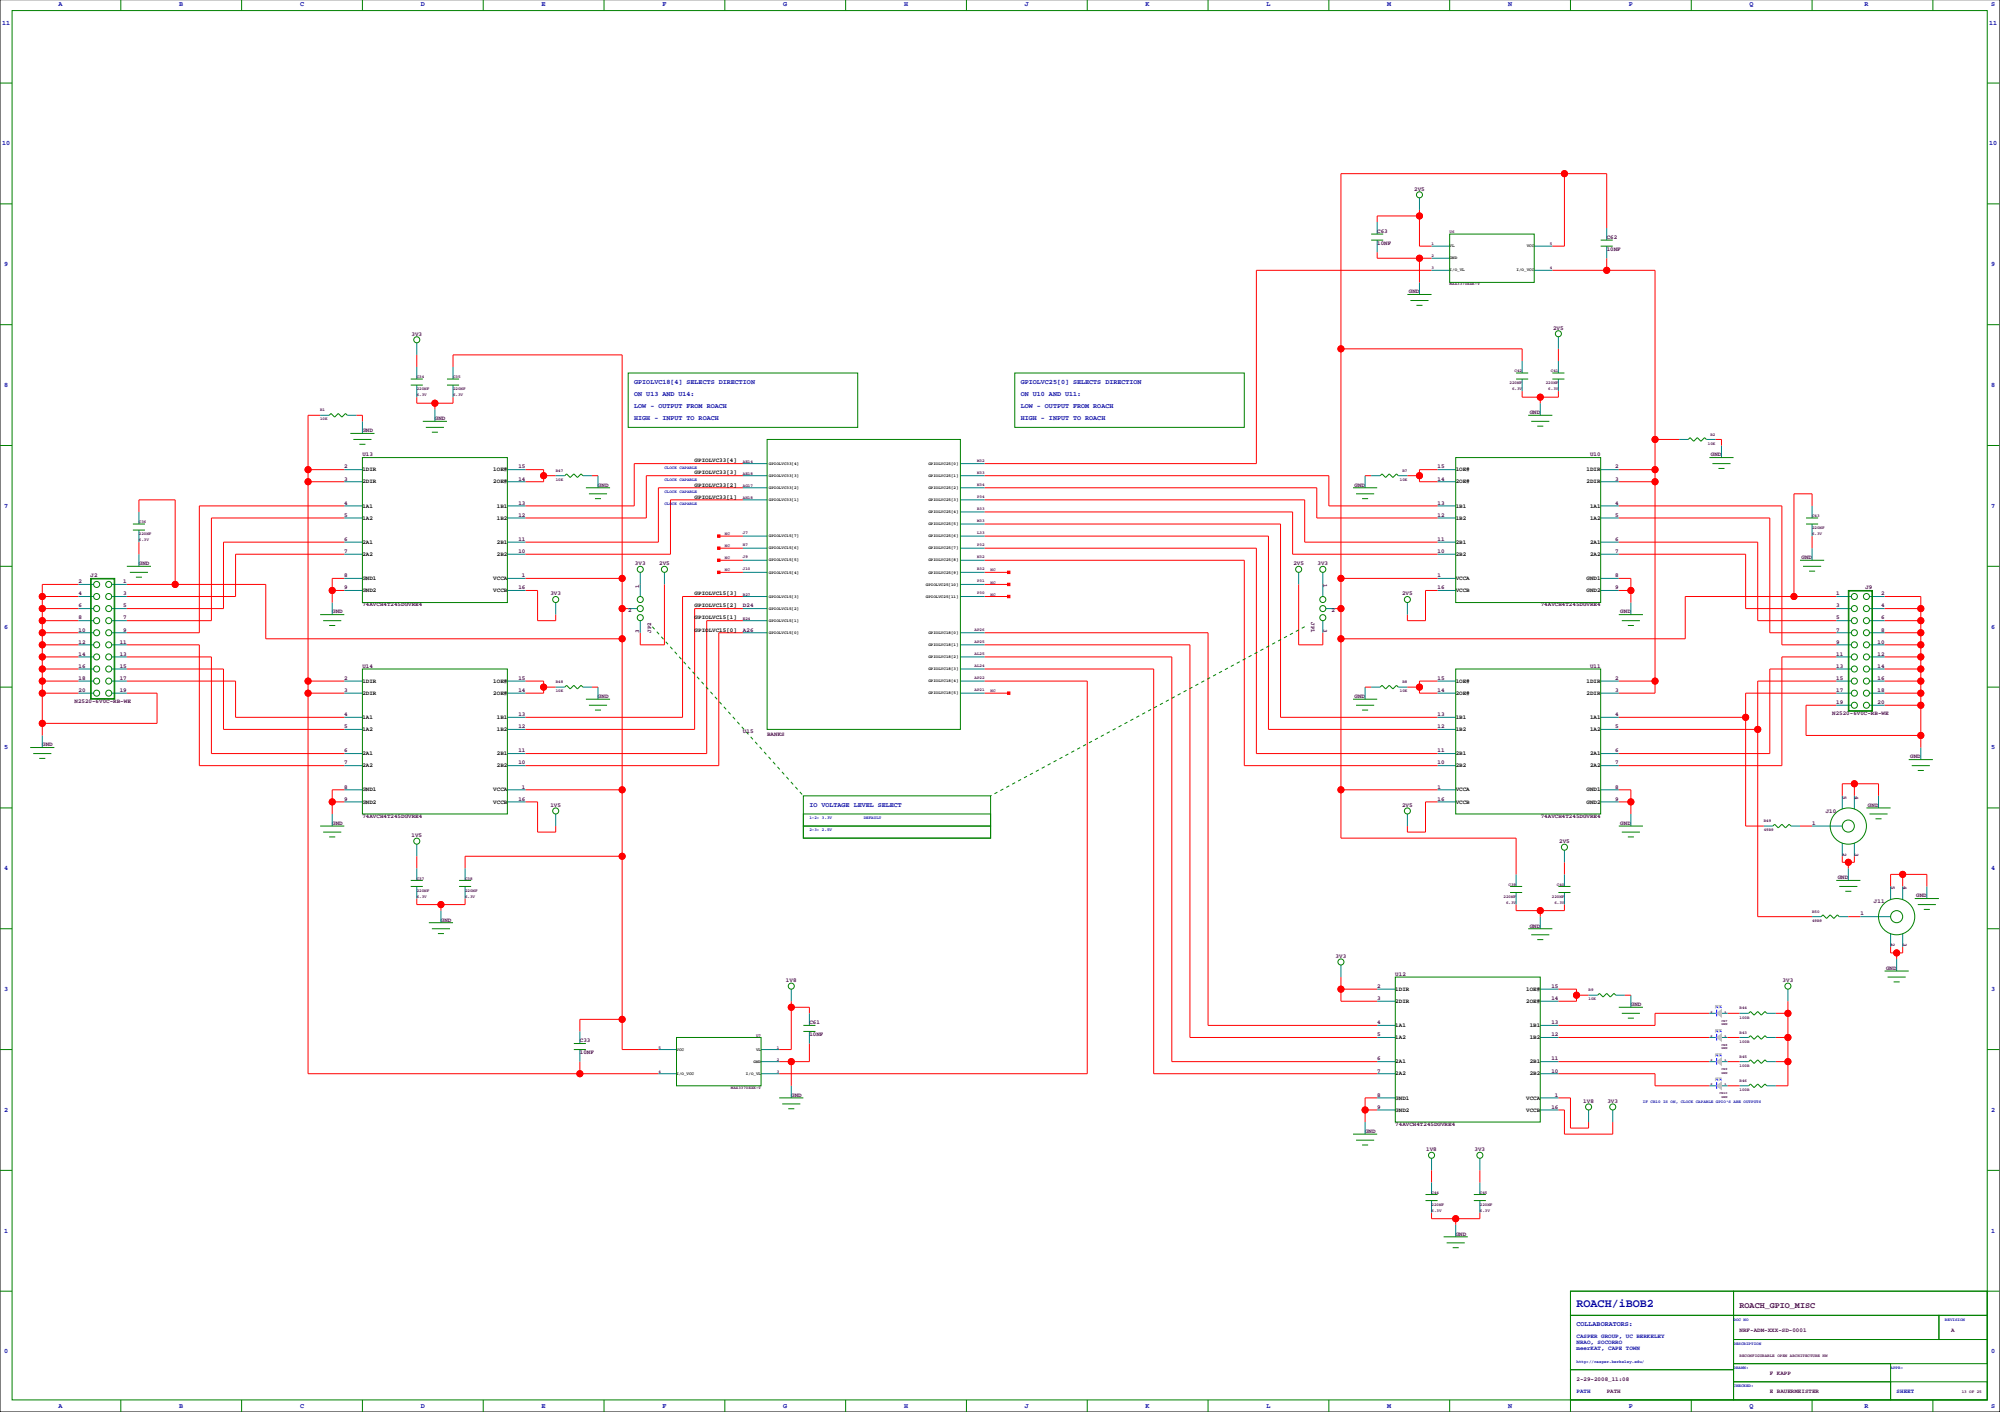
[picture p115: page 13]

GPIOLVC18[4] SELECTS DIRECTION
ON U13 AND U14:
LOW - OUTPUT FROM ROACH
HIGH - INPUT TO ROACH

GPIOLVC25[0] SELECTS DIRECTION
ON U10 AND U11:

IO VOLTAGE LEVEL SELECT

IF CR10 IS ON, CLOCK CAPABLE GPIO'S ARE OUTPUTS

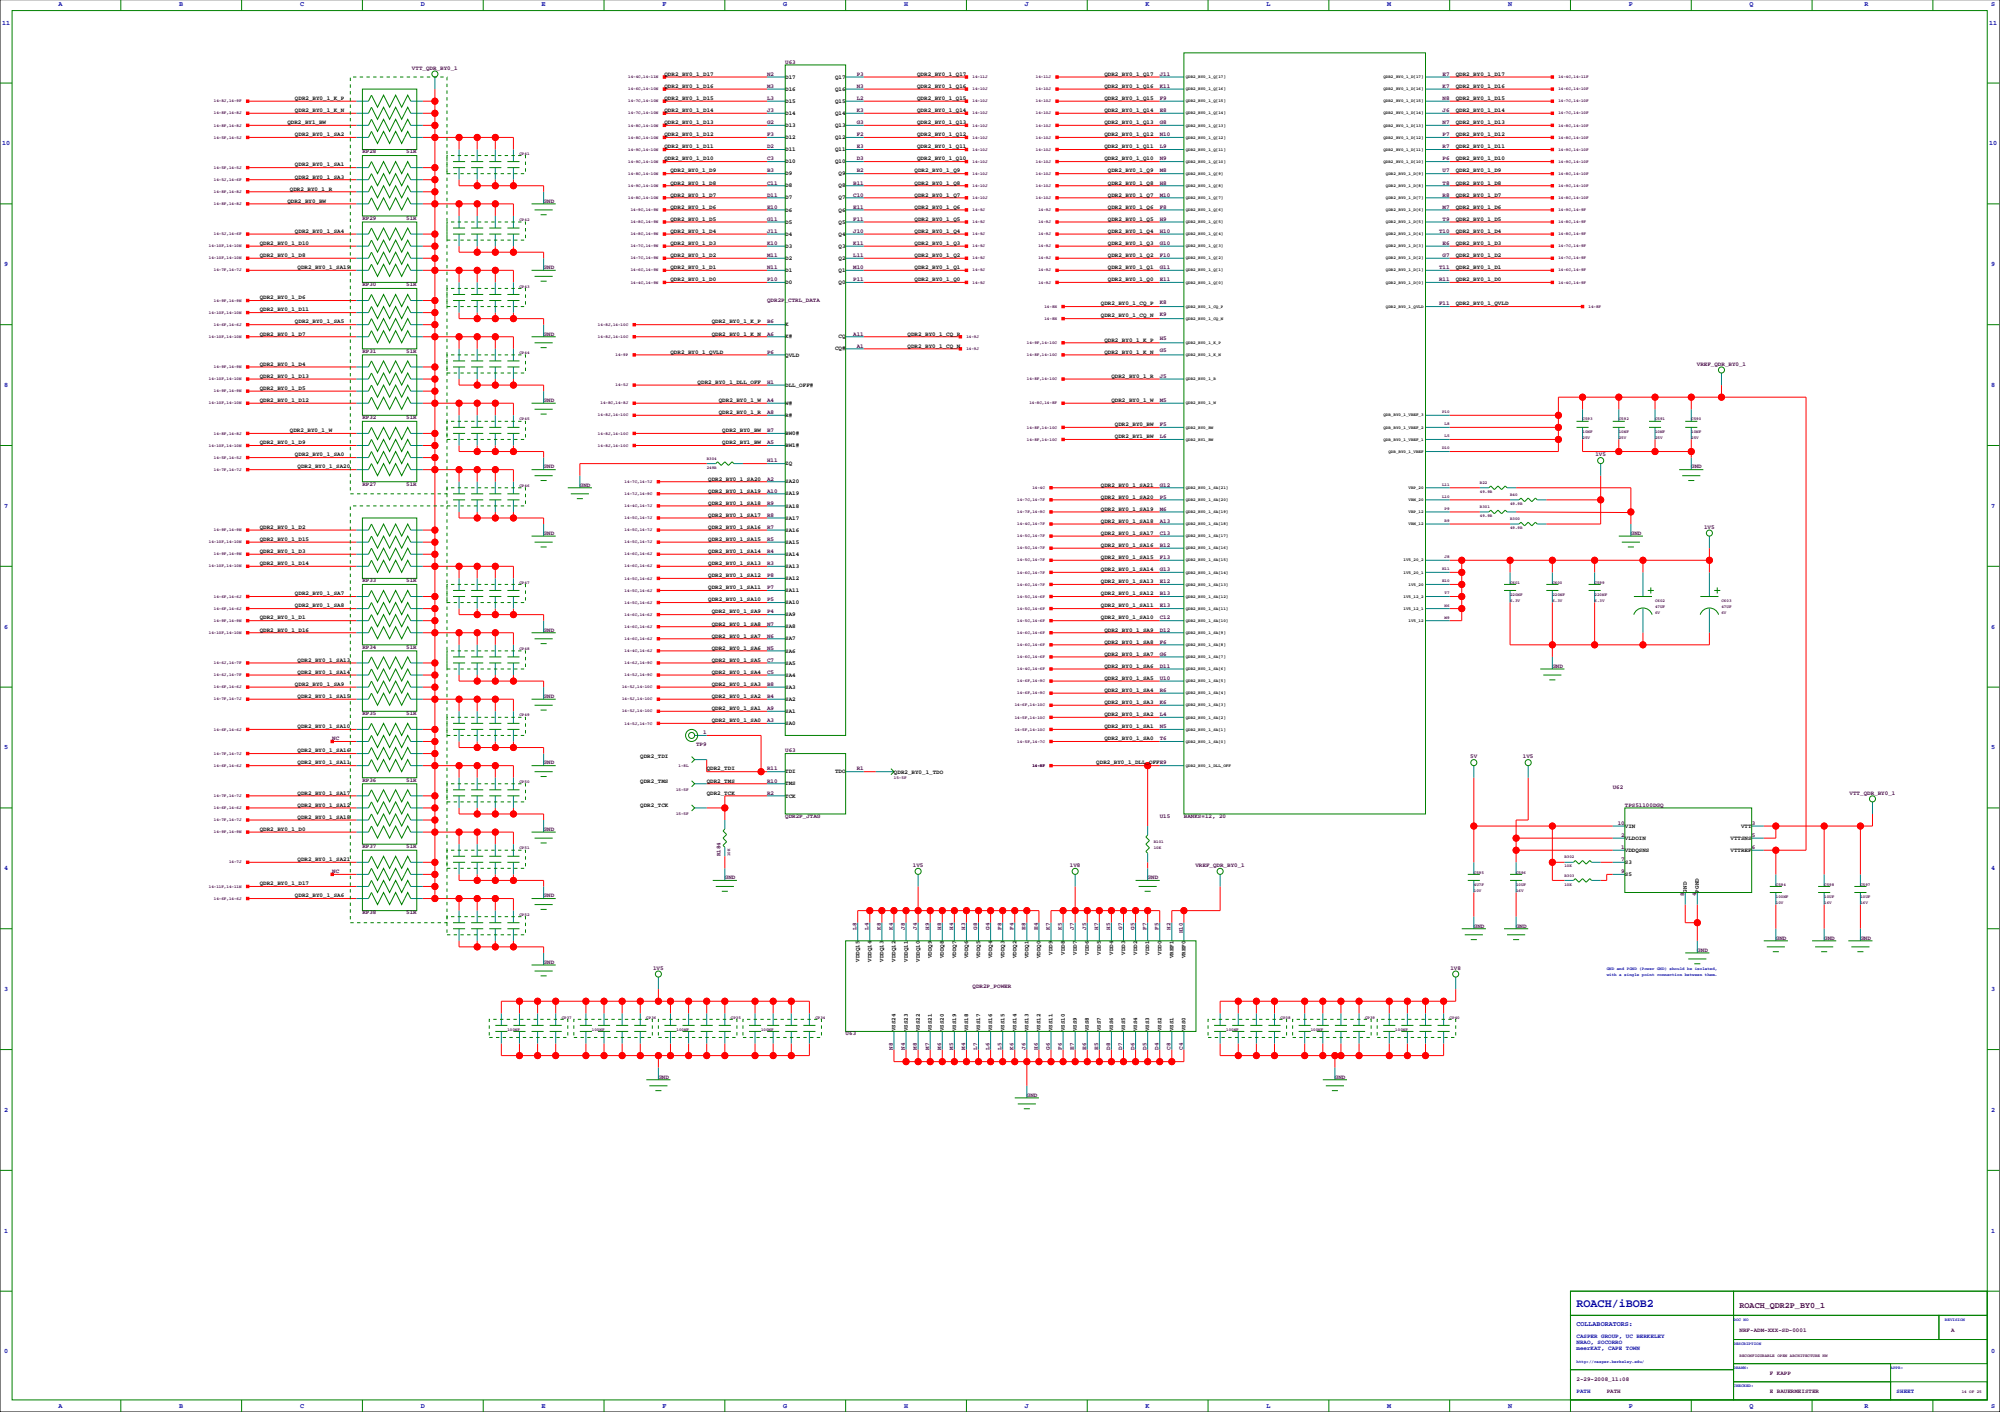
[picture p116: page 14]

GND and PGND (Power GND) should be isolated,
with a single point connection between them.

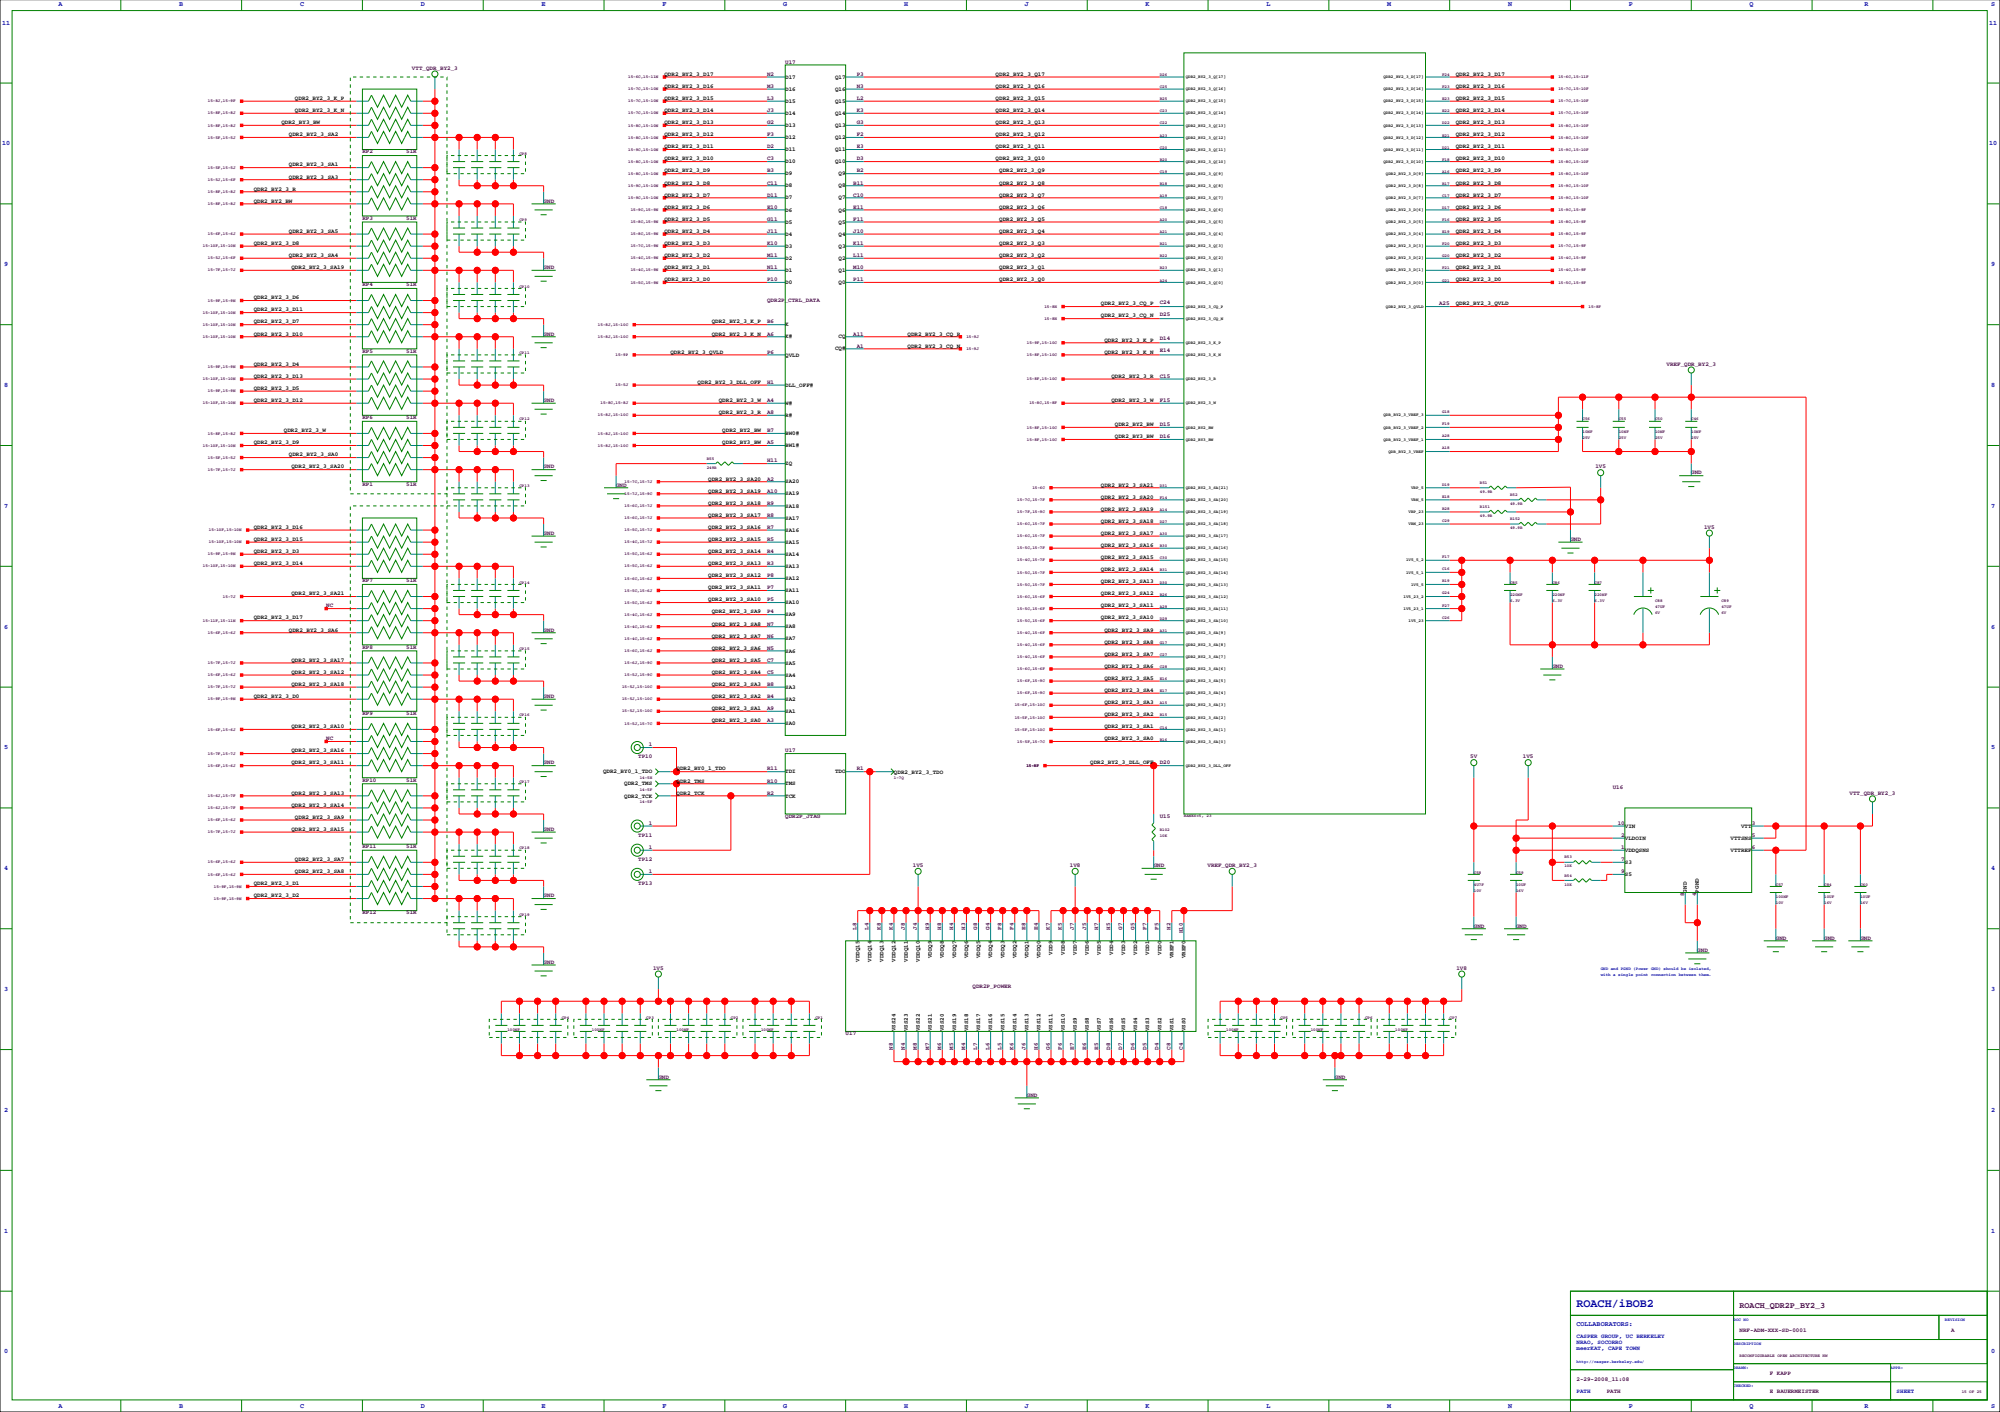
[picture p117: page 15]

GND and PGND (Power GND) should be isolated,
with a single point connection between them.

# TBD

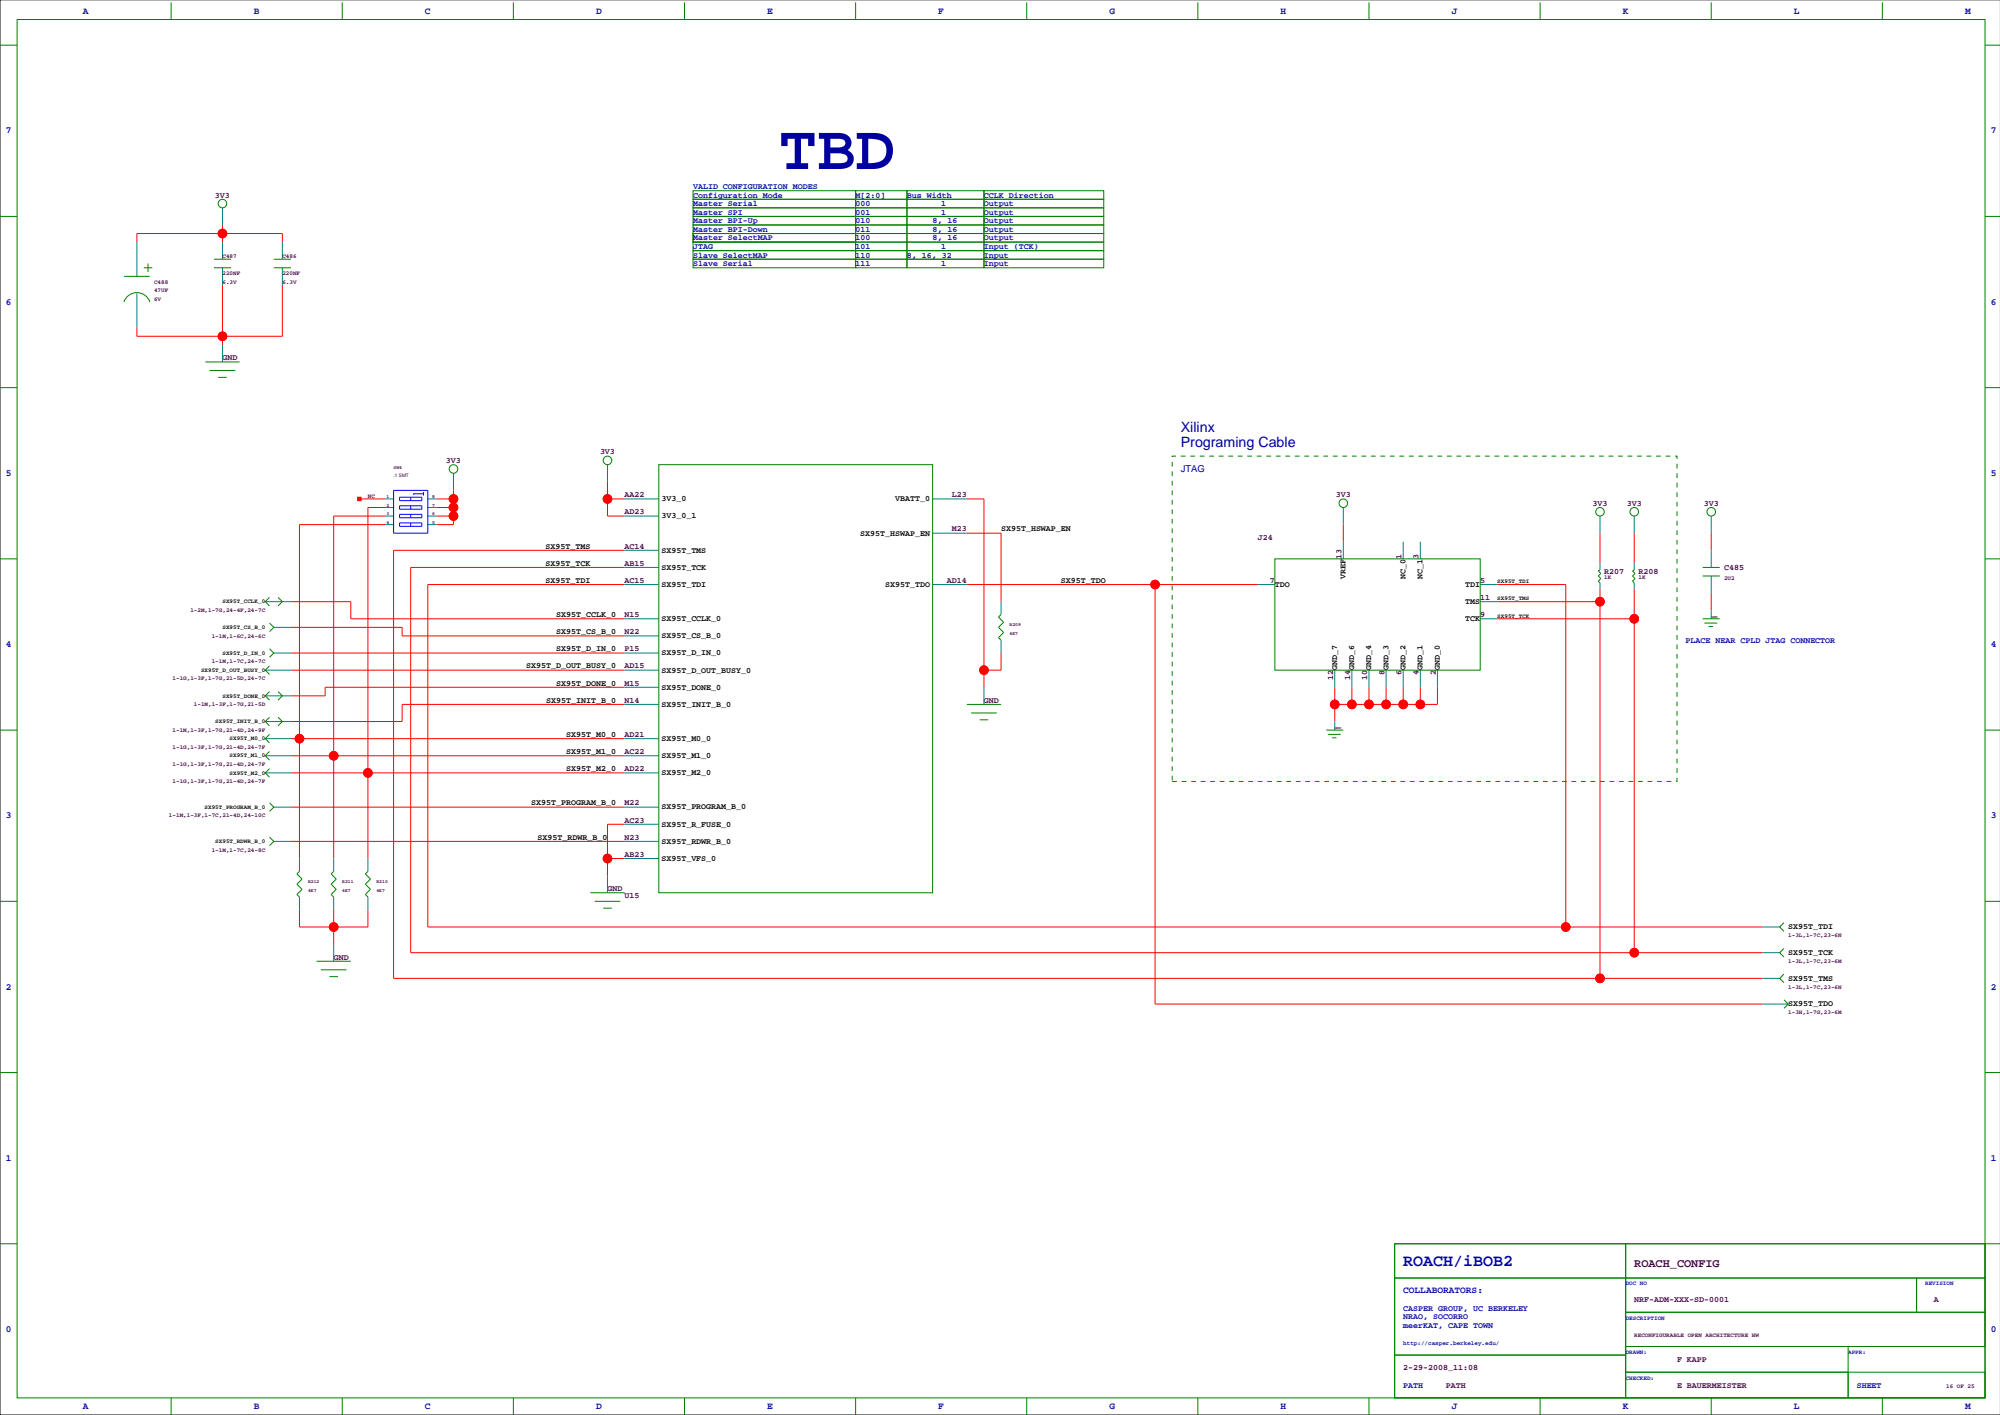
[picture p118: page 16]

PLACE NEAR CPLD JTAG CONNECTOR

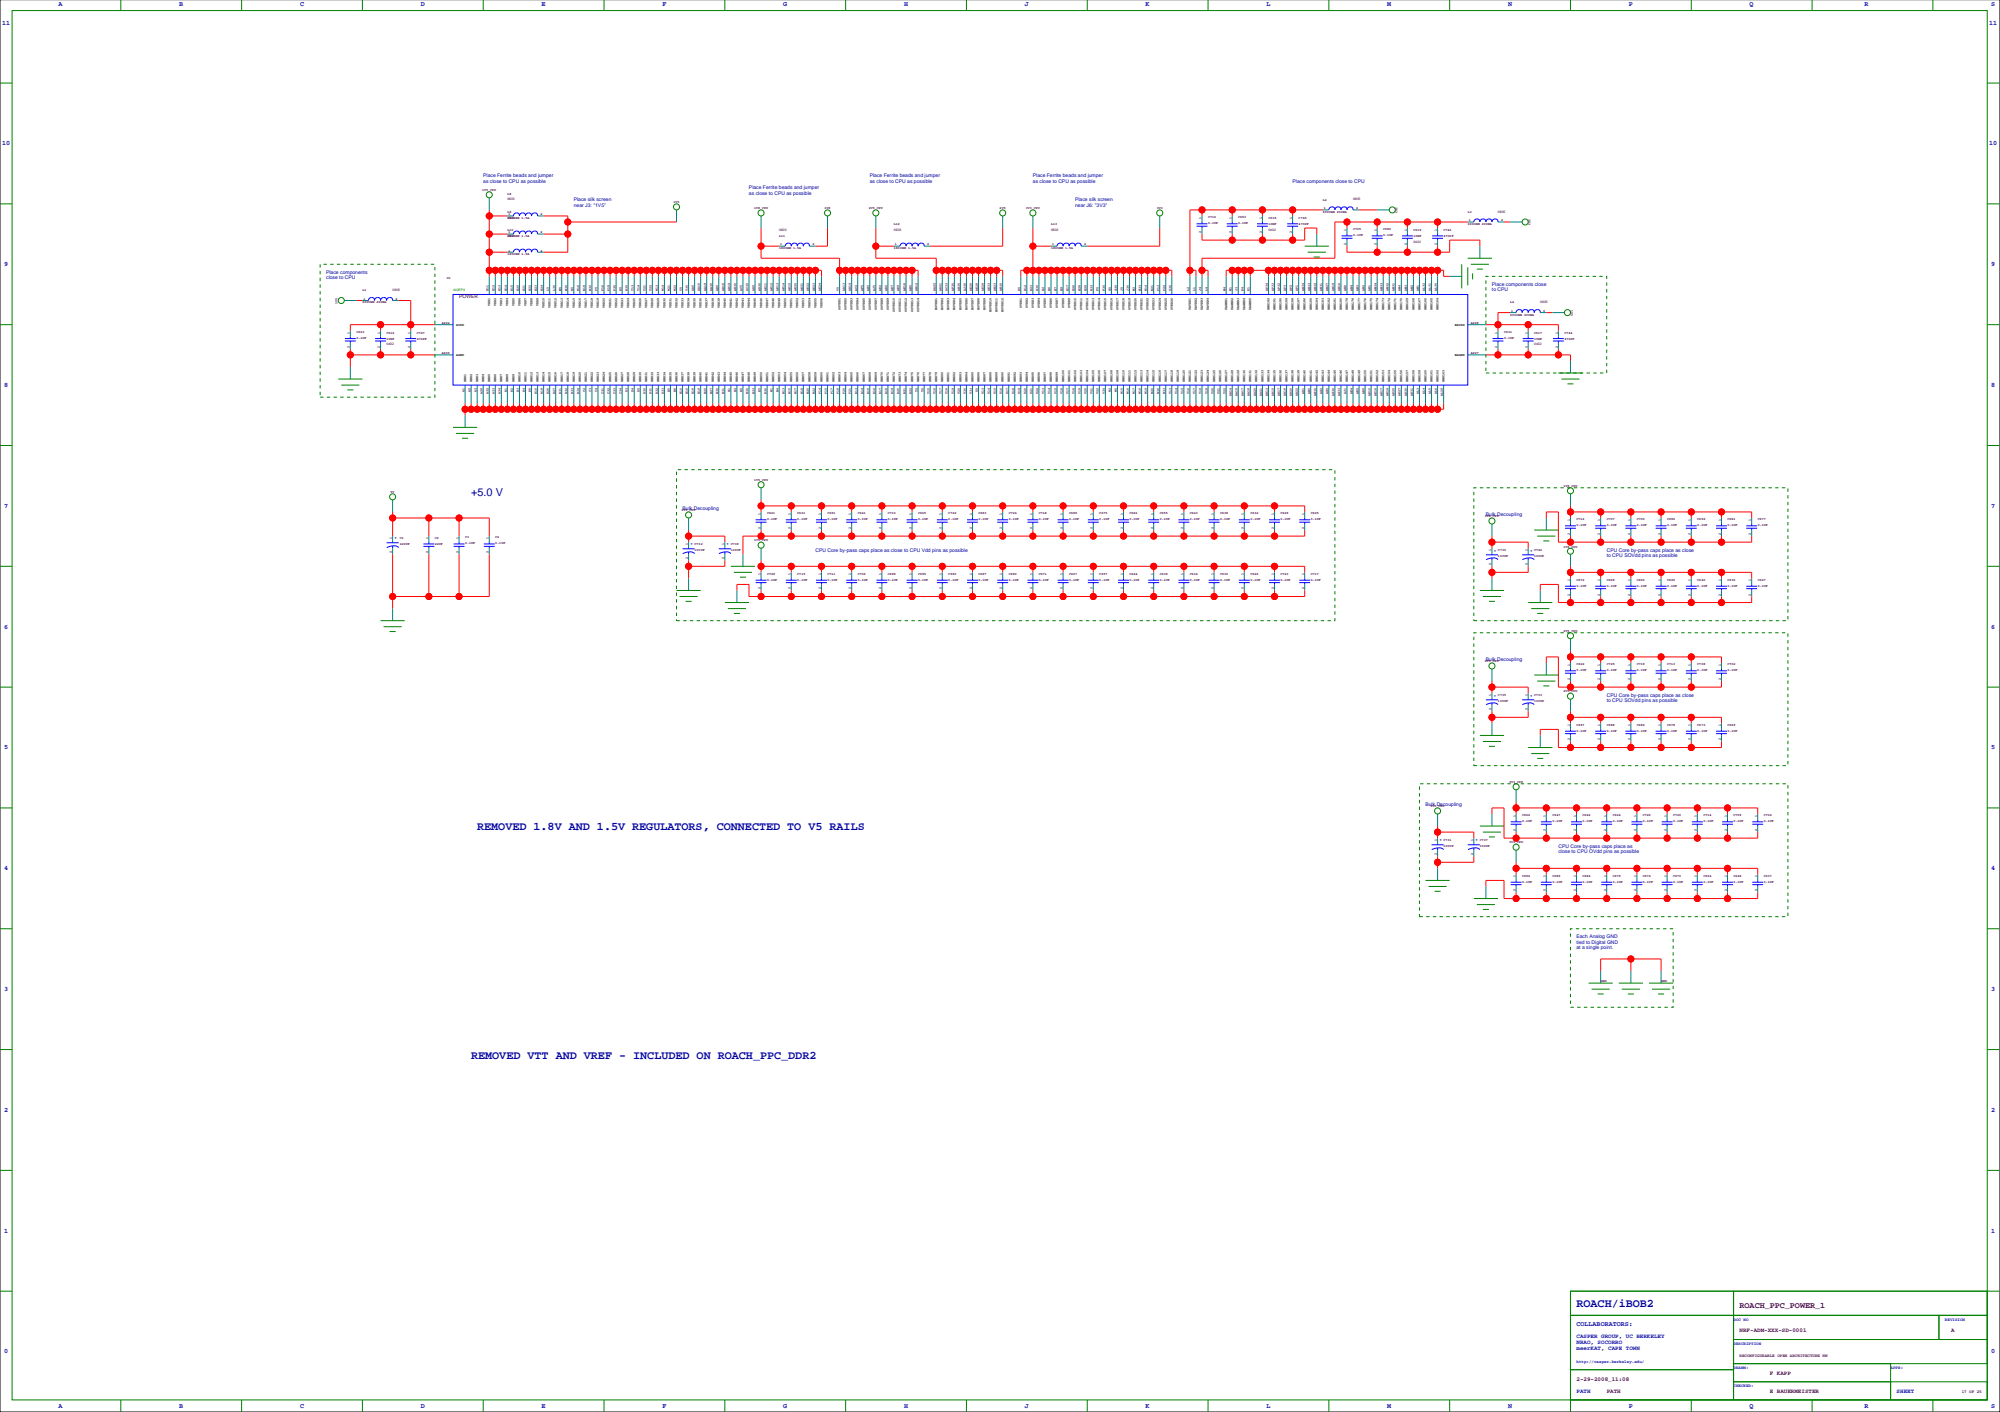
[picture p119: page 17]

Place Ferrite beads and jumper
as close to CPU as possible

CPU Core by-pass caps place as close to CPU Vdd pins as possible

CPU Core by-pass caps place as close
to CPU SOVdd pins as possible

REMOVED 1.8V AND 1.5V REGULATORS, CONNECTED TO V5 RAILS

CPU Core by-pass caps place as
close to CPU OVdd pins as possible

Each Analog GND
tied to Digital GND
at a single point.

REMOVED VTT AND VREF - INCLUDED ON ROACH_PPC_DDR2

# REMOVED 3V3 GENERATION

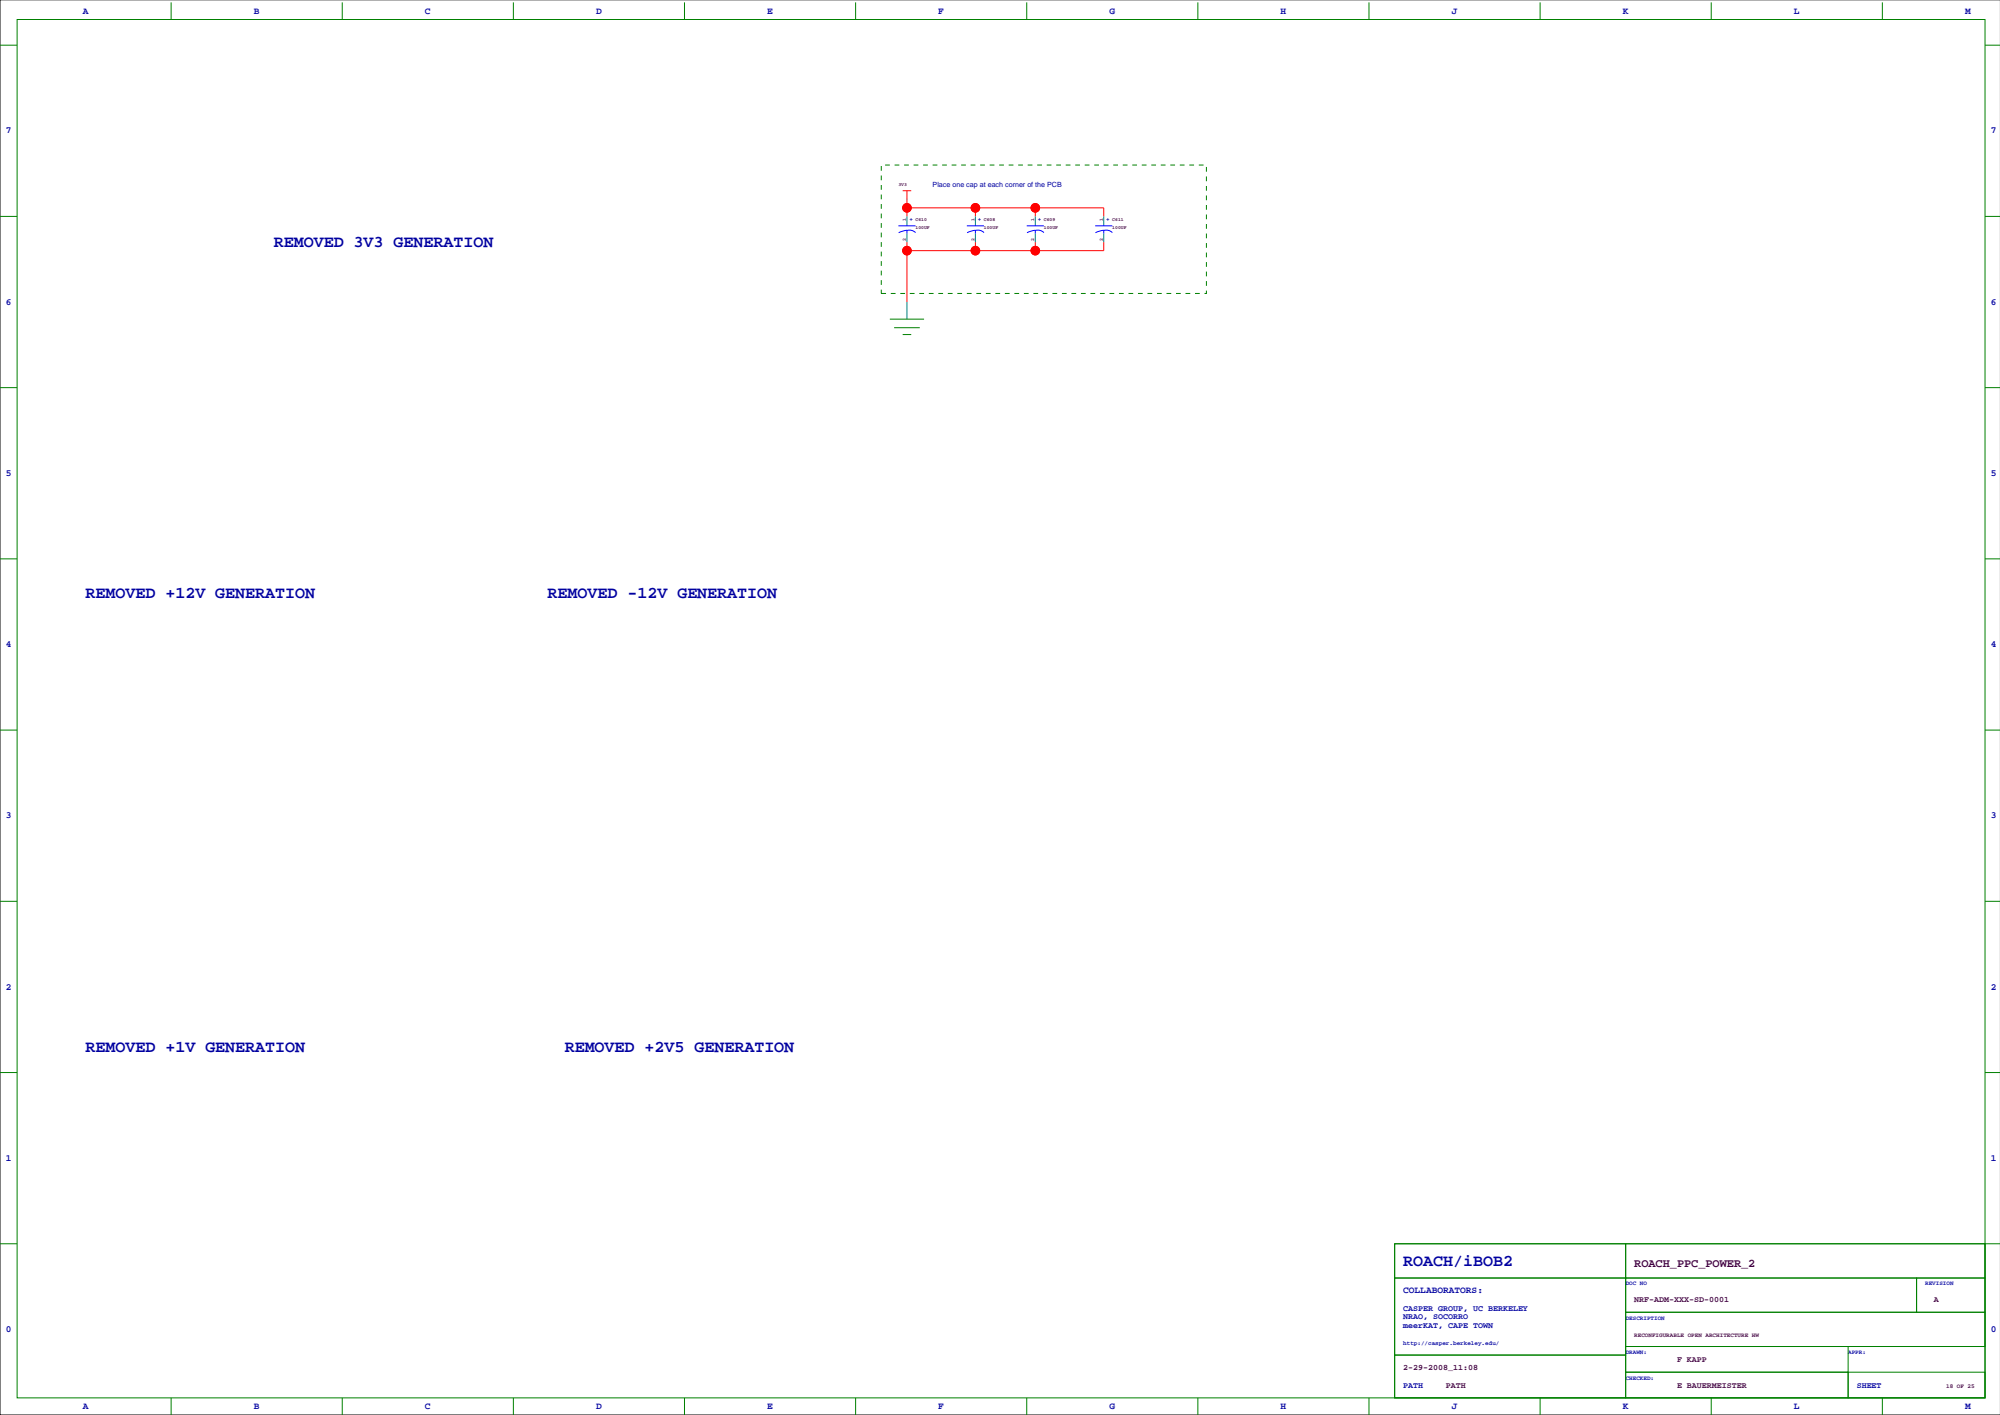
[picture p120: page 18]
ROACH/iBOB2; COLLABORATORS:; DOC NO; REVISION; REMOVED -12V GENERATION; REMOVED +12V GENERATION; REMOVED +1V GENERATION; REMOVED +2V5 GENERATION; ROACH_PPC_POWER_2

Place one cap at each corner of the PCB


PCI BUS NOT IMPLEMENTED

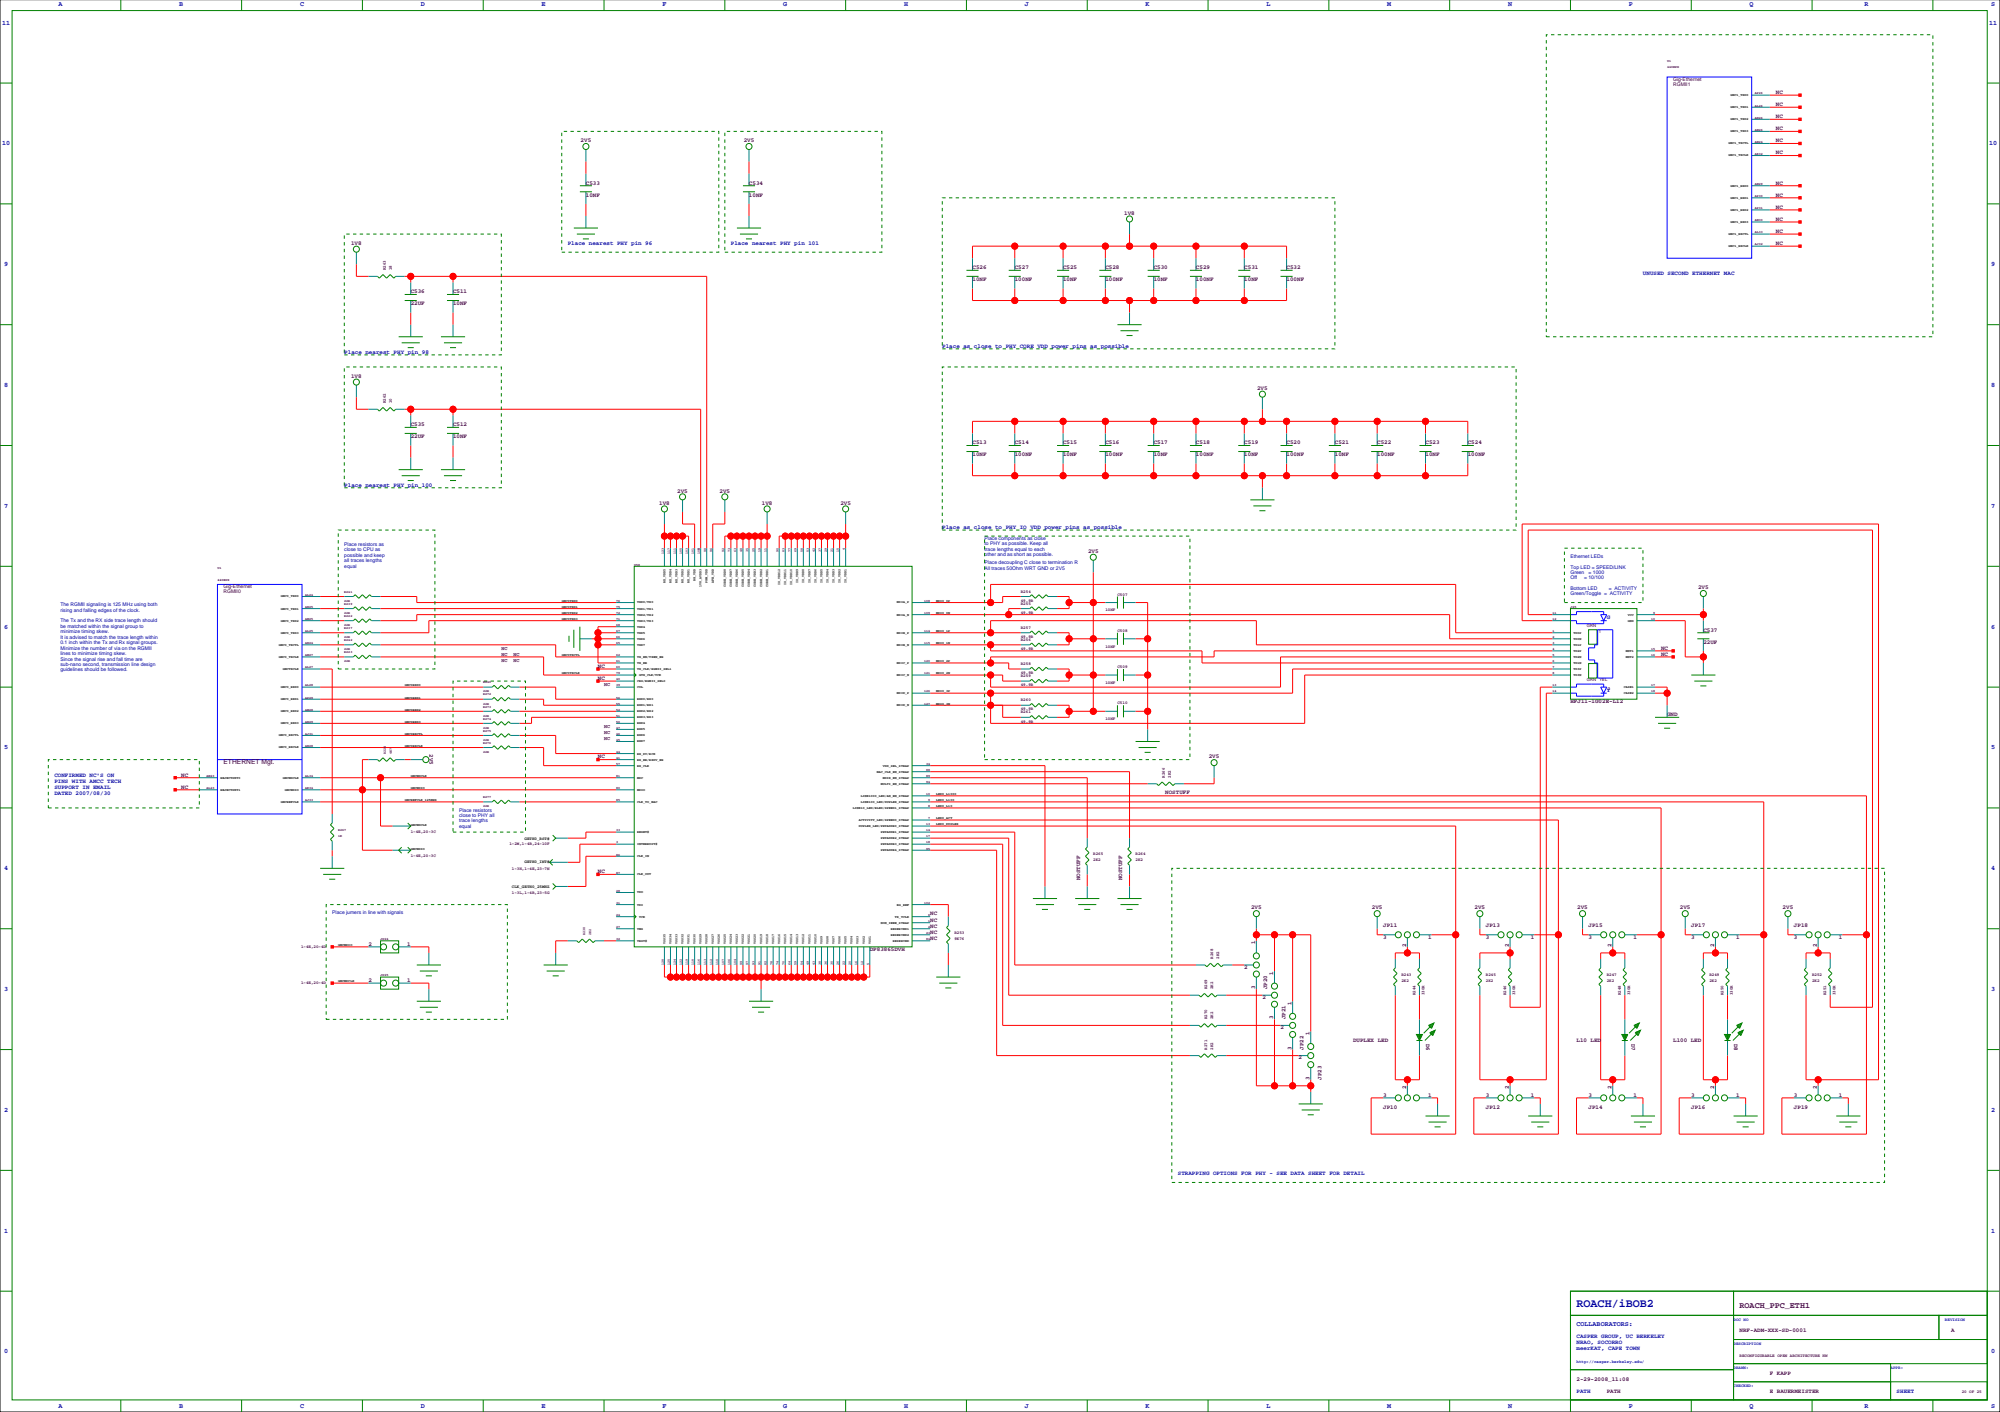
[picture p121: page 20]

UNUSED SECOND ETHERNET MAC

Place as close to PHY CORE VDD power pins as possible

Place nearest PHY pin 98

Place nearest PHY pin 100

Place as close to PHY IO VDD power pins as possible

Place components as close
to PHY as possible. Keep all
trace lengths equal to each

Place resistors as
close to CPU as

other and as short as possible.
Place decoupling C close to termination R
All traces 50Ohm WRT GND or 2V5

Top LED = SPEED/LINK
Green = 1000
Off = 10/100

The RGMII signaling is 125 MHz using both
rising and falling edges of the clock.
The Tx and the RX side trace length should
be matched within the signal group to
minimize timing skew.
It is advised to match the trace length within

0.1 inch within the Tx and Rx signal groups.
Minimize the number of via on the RGMII
lines to minimize timing skew.
Since the signal rise and fall time are
sub-nano second, transmission line design
guidelines should be followed.

CONFIRMED NC'S ON
PINS WITH AMCC TECH
SUPPORT IN EMAIL
DATED 2007/08/30

Place resistors
close to PHY all
trace lengths
equal

Place jumers in line with signals

STRAPPING OPTIONS FOR PHY - SEE DATA SHEET FOR DETAIL

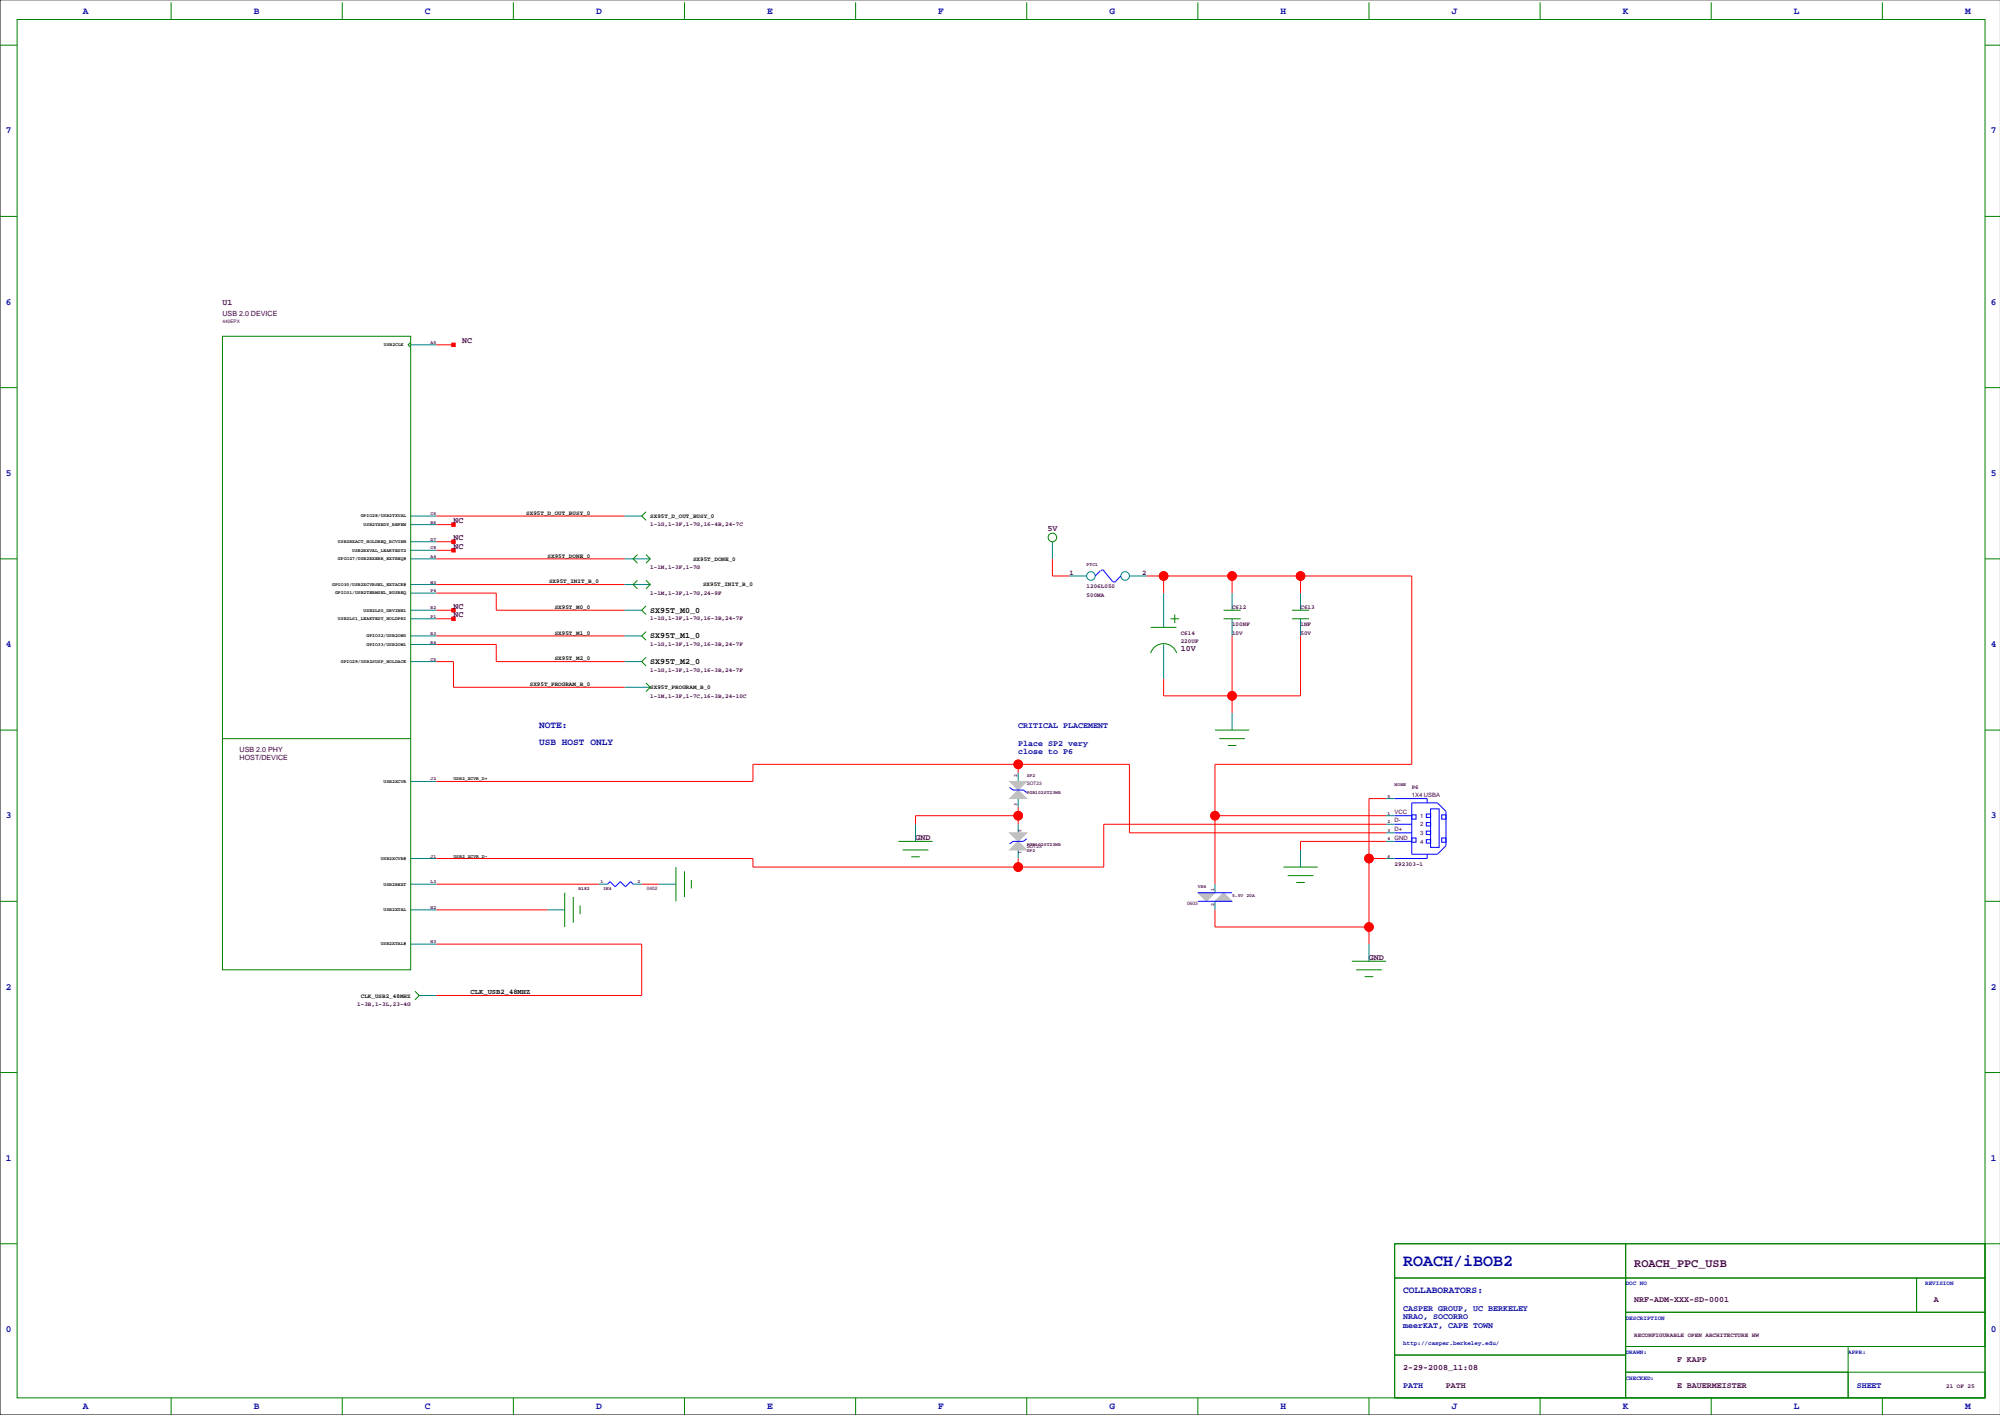
[picture p122: page 21]

D-2
D+ 3
GND 4

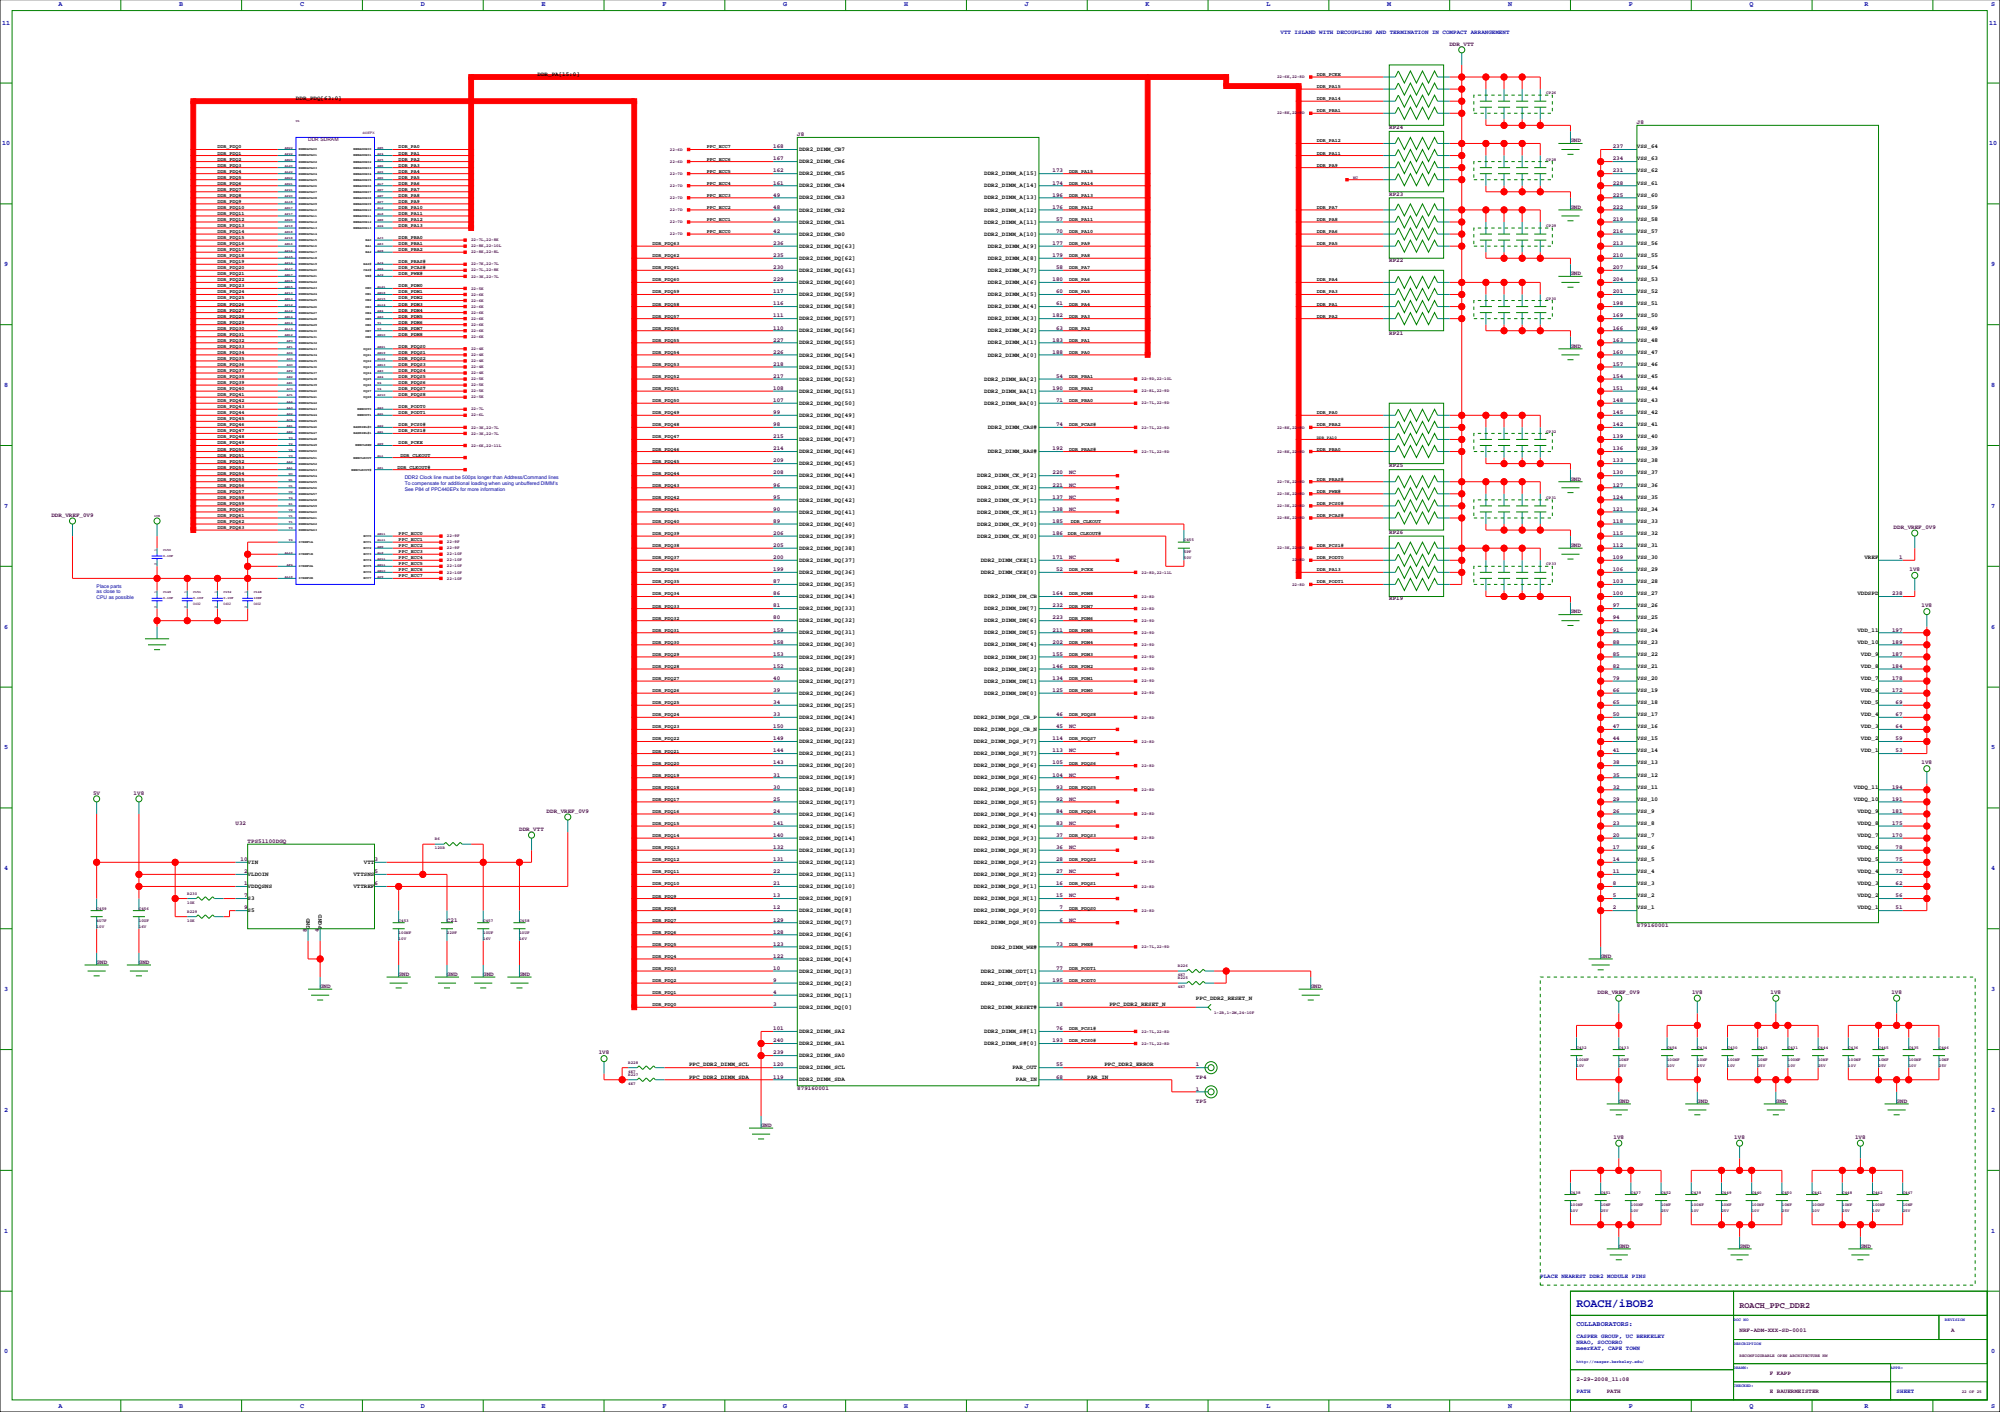
[picture p123: page 22]

VTT ISLAND WITH DECOUPLING AND TERMINATION IN COMPACT ARRANGEMENT

DDR_CLKOUT#
DDR2 Clock line must be 500ps longer than Address/Command lines
To compensate for additional loading when using unbuffered DIMM's
See P84 of PPC440EPx for more information

PLACE NEAREST DDR2 MODULE PINS

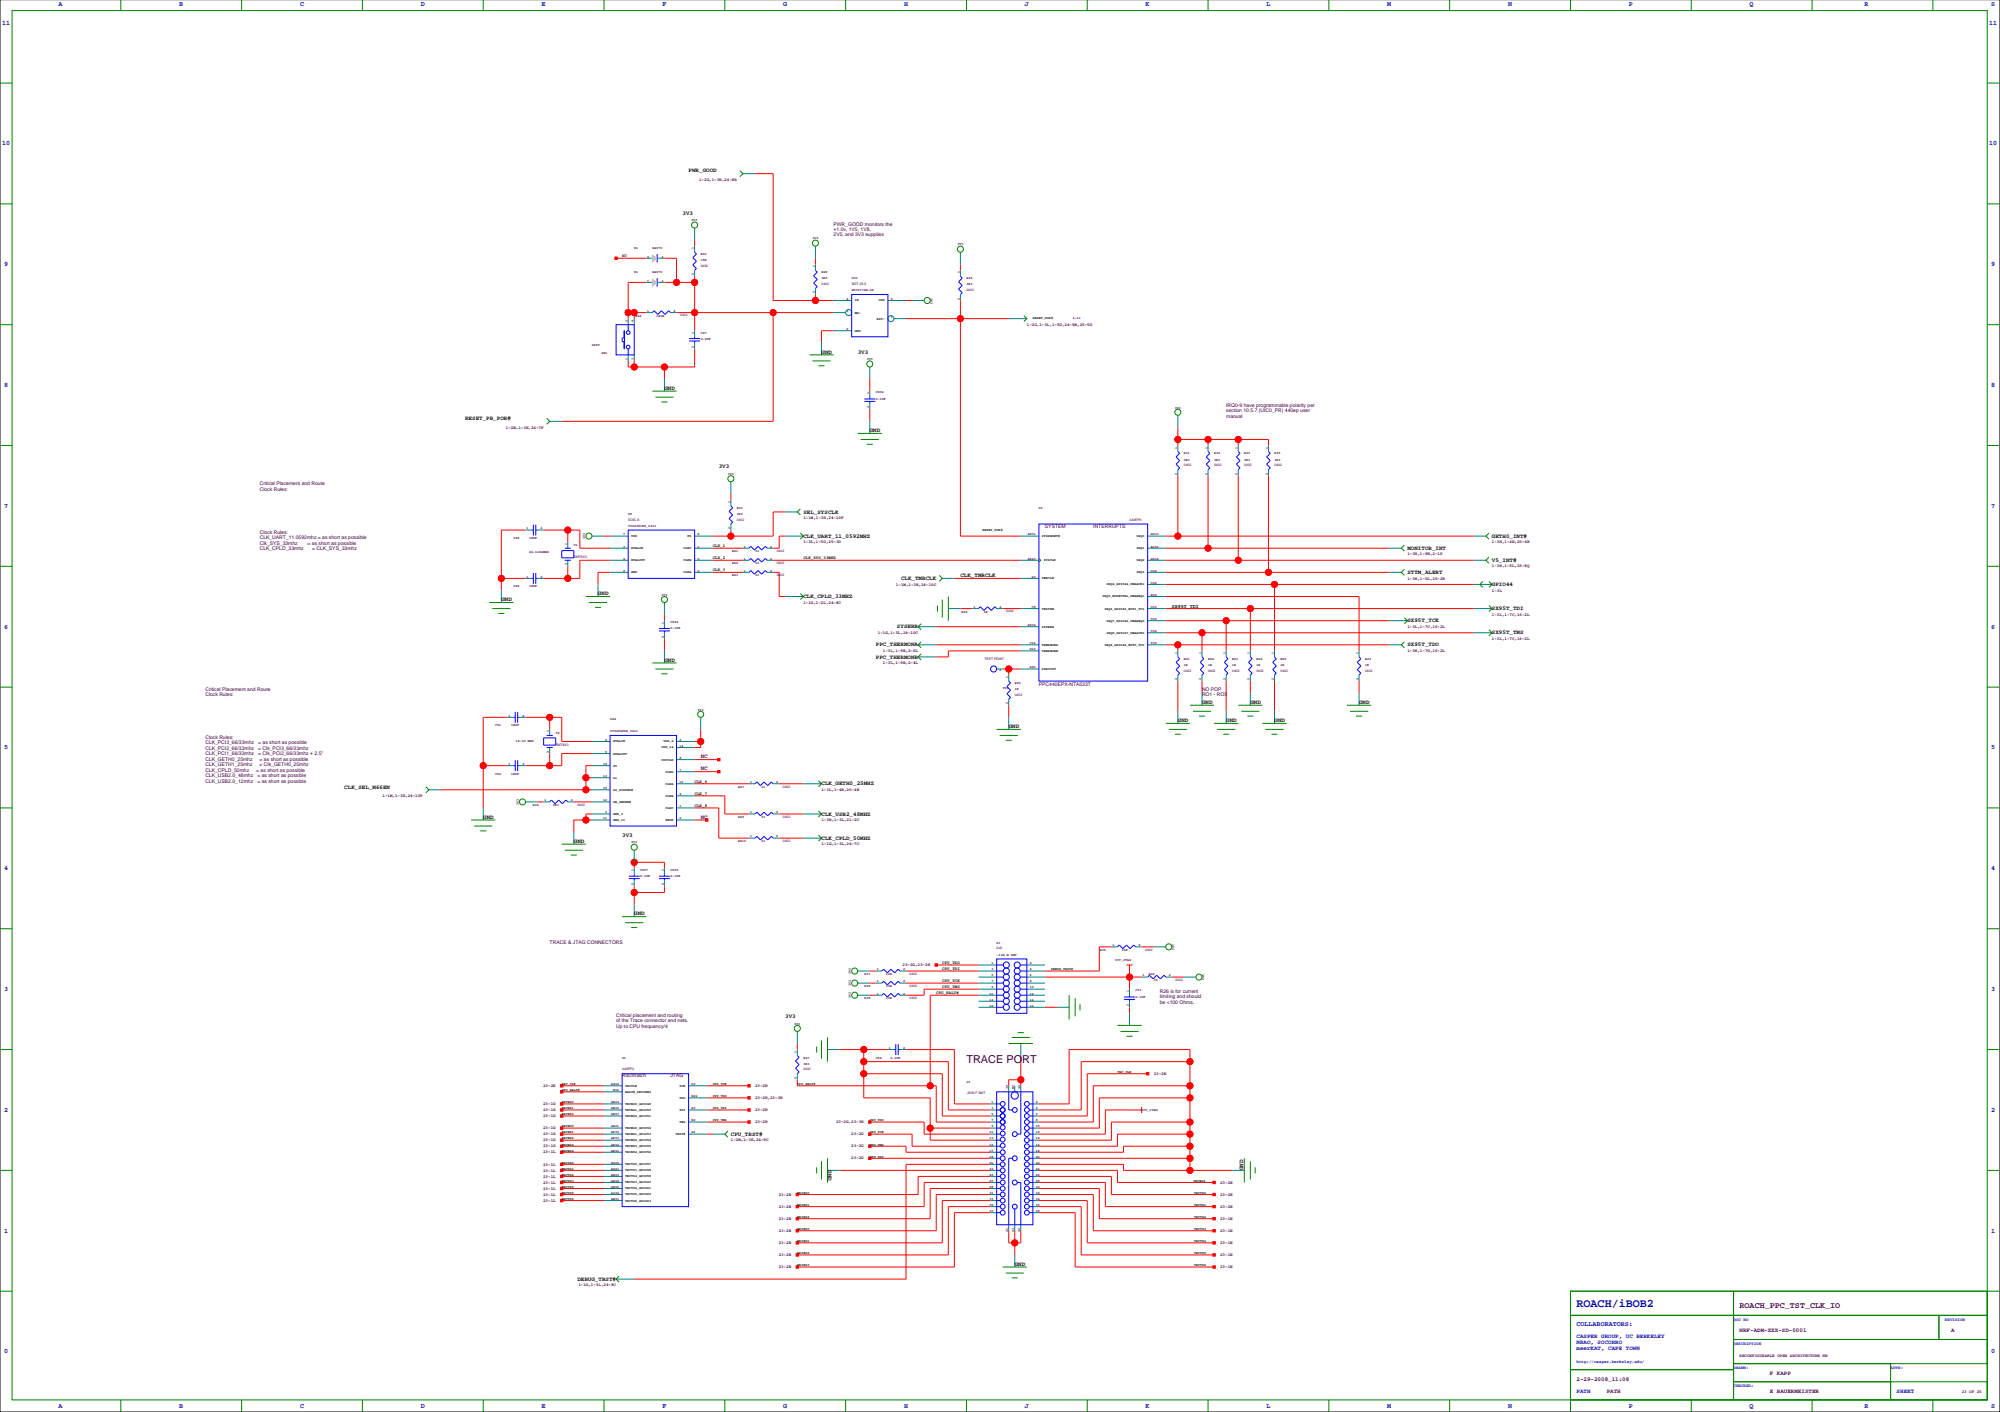
[picture p124: page 23]

IRQ0-9 have programmable polarity per
section 10.5.7 (UIC0_PR) 440ep user
manual

Critical Placement and Route
Clock Rules:

CLK_UART_11.0592mhz = as short as possible

CLK_PCI3_66/33mhz = as short as possible
CLK_PCI2_66/33mhz = Clk_PCI3_66/33mhz
CLK_PCI1_66/33mhz = Clk_PCI2_66/33mhz + 2.5"
CLK_GETH0_25mhz = as short as possible
CLK_GETH1_25mhz = Clk_GETH0_25mhz
CLK_CPLD_50mhz = as short as possible
CLK_USB2.0_48mhz = as short as possible
CLK_USB2.0_12mhz = as short as possible

Critical placement and routing
of the Trace connector and nets.
Up to CPU frequency/4

# SD/MMC/MMCPLUS CONNECTOR

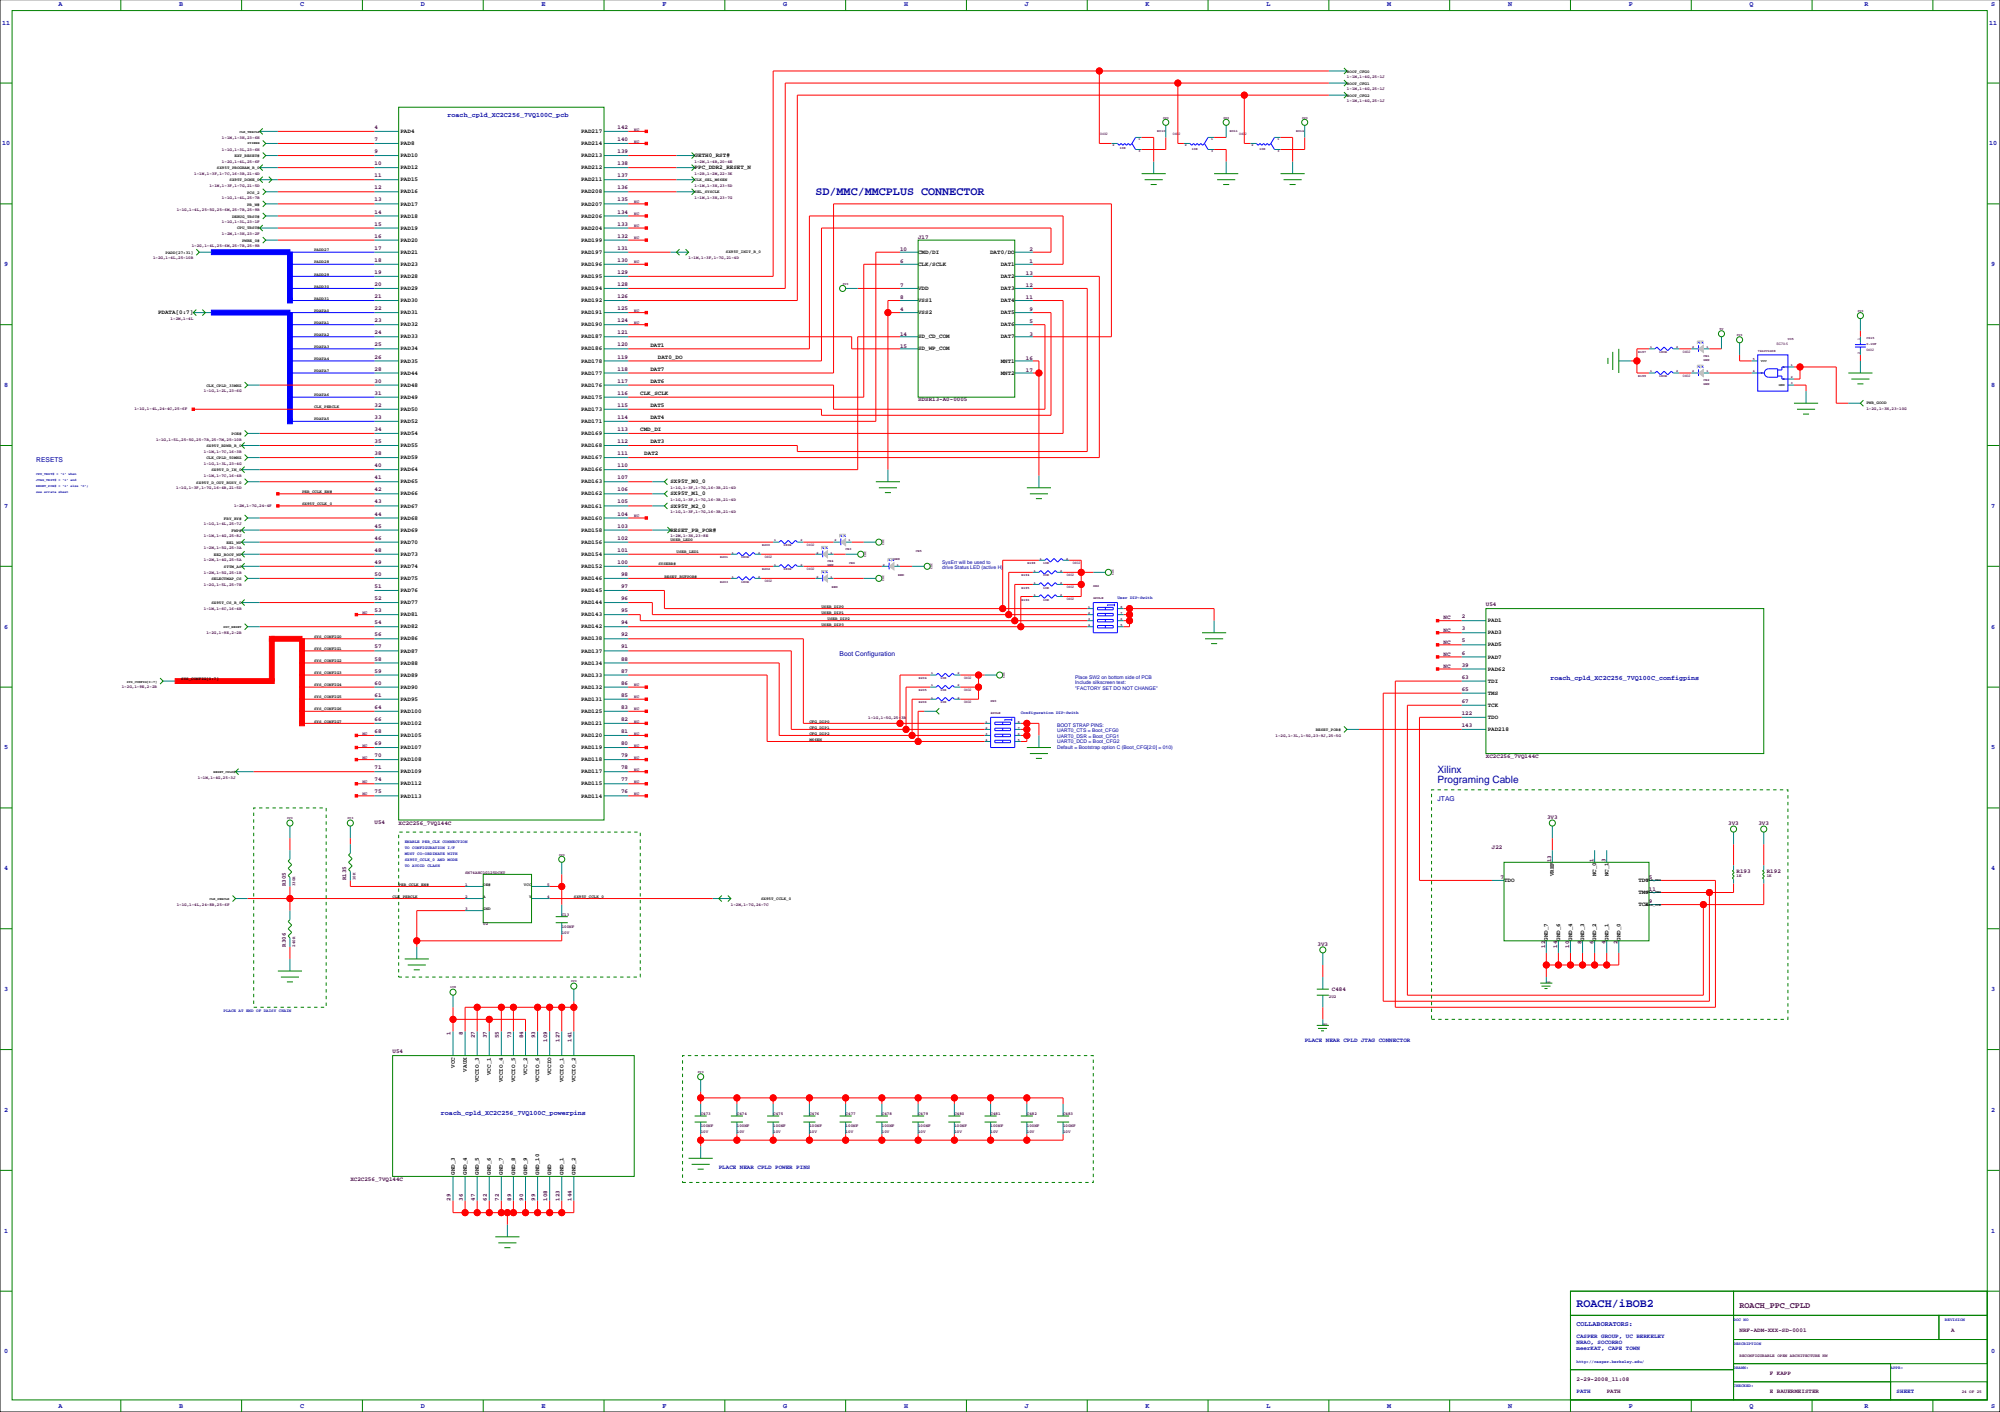
[picture p125: page 24]

SysErr will be used to
drive Status LED (active H)

Place SW2 on bottom side of PCB
Include silkscreen text:
"FACTORY SET DO NOT CHANGE"

ENABLE PER_CLK CONNECTION
TO CONFIGURATION I/F
MUST CO-ORDINATE WITH
SX95T_CCLK_0 AND MODE
TO AVOID CLASH

PLACE AT END OF DAISY CHAIN

PLACE NEAR CPLD JTAG CONNECTOR

PLACE NEAR CPLD POWER PINS

# PADD30 IS THE LSB FOR 16 BIT WIDE BUS TRANSFERS

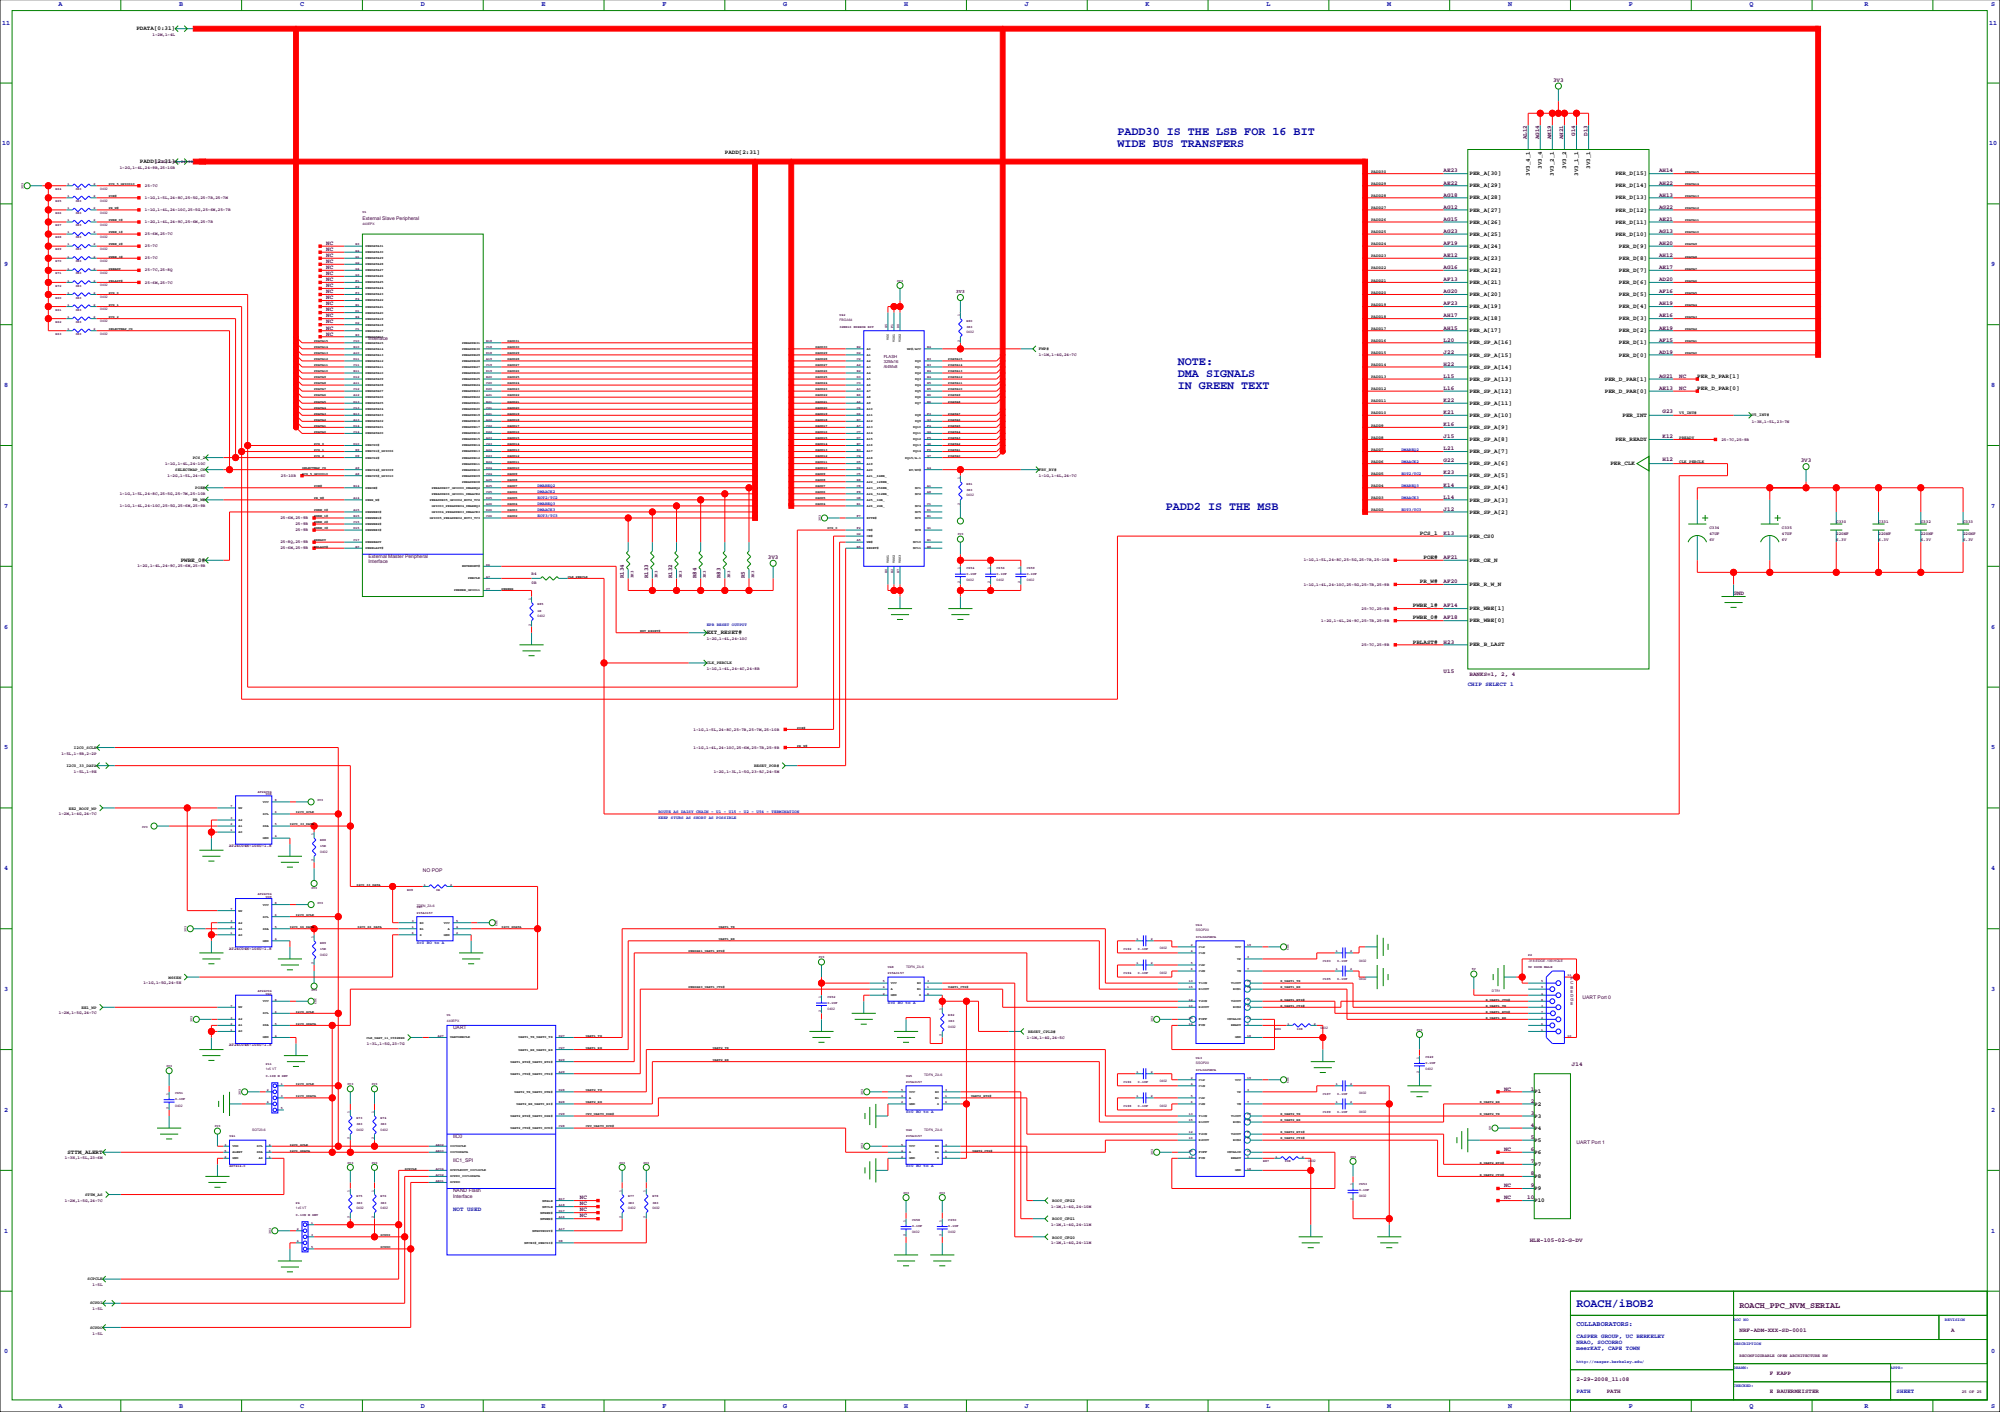
[picture p126: page 25]

ROUTE AS DAISY CHAIN - U1 - U15 - U2 - U54 - TERMINATION
KEEP STUBS AS SHORT AS POSSIBLE

UART2_RX
