ska-sa/roach1_hardware/SISim/roach_ddr2_dqs_single_fpga2dimm.sp

* Netlist for net Lsw00 - D:\ROACH\elec\SISim\roach_ddr2_dqs_single_fpga2dimm.sp


* Output from HyperLynx SPICE Writer
* Created by Francois on Date: Wednesday Nov. 28,2007   Time: 15:33:06
* Created with HyperLynx version: 7.7 build: 385
* Design file: roach_ddr2_dq_dual_fpga2dimm.ffs
* Special Settings: Coupled


.SUBCKT roach_ddr2_dqs_single_fpga2dimm Vinp Vinn 100 105 131 107 111 132 115 133 119 134 126 135 128 136

* Node  #  = <Reference Designator>.<pin name>
**********************************************
* Node 100 = J1.Port4 (at pin)
* Node 105 = U8.1 (at pin) (receiver)
X_mdl_105 105 d_receive_105 MODEL_U8_1_ip
* Node 131 = R8.1 (at pin)
* Node 107 = J1.Port3 (at pin)
* Node 111 = R7.2 (at pin)
* Node 132 = U7.1 (at pin) (receiver)
X_mdl_113 113 d_receive_113 MODEL_U7_1_ip
* Node 115 = J1.Port2 (at pin)
* Node 133 = U6.1 (at pin) (driver)
X_mdl_117 117 Vinn MODEL_U6_1_ip
* Node 119 = J1.Port1 (at pin)
* Node 134 = U5.1 (at pin) (driver)
X_mdl_121 121 Vinp MODEL_U5_1_ip
* Node 126 = U3.2 (at pin) (driver)
X_mdl_124 124 Vinn MODEL_U3_2_ip
* Node 135 = R1.2 (at pin)
* Node 128 = R1.1 (at pin)
* Node 136 = U3.1 (at pin) (driver)
X_mdl_129 129 Vinp MODEL_U3_1_ip

* Node   0 = Gnd (Common Return)

.connect 136 128 

.connect 135 126 

.connect 134 119 

.connect 133 115 

.connect 132 111 

.connect 131 105 


CV001       102    0 3.645e-013
R8_1        105    4 50
CV002       109    0 3.645e-013
TP012       111    0  113    0 Z0=1.171893e+002 TD=1.757840e-011
R7_2        111    4 50
TP013       115    0  117    0 Z0=3.579990e+001 TD=8.770975e-011
TP014       119    0  121    0 Z0=3.579990e+001 TD=8.770975e-011
TP015       126    0  124    0 Z0=3.579990e+001 TD=8.770975e-011
R1_2        126  128 50
TP018       128    0  129    0 Z0=3.579990e+001 TD=8.770975e-011

WCond_000  102 109 0 105 111 0 RLGCmodel=Cond_000 N=2 L=0.050000 fgd=1e9  MULTIDEBYE=1
WCond_001  107 100 0 109 102 0 RLGCmodel=Cond_001 N=2 L=0.005000 fgd=1e9  MULTIDEBYE=1
V4  4  0  0.90
V3  3  0  1.00
V2  2  0  1.80
V1  1  0  0.00

****  Transmission line models ***********************
*********************************
* RLGC model created by HyperLynx SPICE generator
*
.MODEL Cond_000 W MODELTYPE=RLGC N=2
* Lo  (H/m)
+ Lo =
+ 5.18283e-007  
+ 1.07974e-007  5.18283e-007  

* Co  (F/m)
+ Co =
+ 9.65006e-011  
+ -2.01039e-011  9.65006e-011  

* Loss turned off.  Only lossless components written.

*********************************

*********************************
* RLGC model created by HyperLynx SPICE generator
*
.MODEL Cond_001 W MODELTYPE=RLGC N=2
* Lo  (H/m)
+ Lo =
+ 5.50676e-007  
+ 2.16403e-007  5.50676e-007  

* Co  (F/m)
+ Co =
+ 6.99599e-011  
+ -2.34655e-011  6.99599e-011  

* Loss turned off.  Only lossless components written.

*********************************

****  End Transmission line models *******************

.ENDS

* IBIS model subcircuit definitions
**********************************************
*Define subcircuit for MODEL_U8_1_ip
.subckt MODEL_U8_1_ip a_signal d_receive 
VPullUpRef a_PURef 0 1.8
VPullDownRef a_PDRef 0 0

X_105 a_signal d_receive 0 a_PURef a_PDRef MODEL_U8_1

.ends MODEL_U8_1_ip

*Define subcircuit for MODEL_U8_1
.subckt MODEL_U8_1 a_signal d_receive a_gnd a_PURef a_PDRef 

C_comp a_signal a_gnd 2.811e-012

VGCRef a_GCRef 0 0
G_gnd_clamp a_signal a_GCRef table v(a_signal, a_GCRef) = 
+ (-23.4,-22.2654) (-1.8,-0.760219) (-1.795,-0.755241) 
+ (-1.79,-0.750299) (-1.785,-0.745359) (-1.78,-0.740421) 
+ (-1.775,-0.735484) (-1.77,-0.730549) (-1.765,-0.725617) 
+ (-1.755,-0.715754) (-1.735,-0.696055) (-1.73,-0.691139) 
+ (-1.695,-0.656751) (-1.69,-0.651848) (-1.63,-0.593191) 
+ (-1.625,-0.588303) (-1.62,-0.583444) (-1.615,-0.578597) 
+ (-1.55,-0.51558) (-1.545,-0.510732) (-1.54,-0.505913) 
+ (-1.53,-0.496355) (-1.525,-0.491576) (-1.45,-0.419894) 
+ (-1.445,-0.415115) (-1.44,-0.410336) (-1.435,-0.40558) 
+ (-1.415,-0.387037) (-1.41,-0.382402) (-1.32,-0.29896) 
+ (-1.315,-0.294325) (-1.3,-0.280418) (-1.295,-0.275794) 
+ (-1.27,-0.254226) (-1.265,-0.249912) (-1.175,-0.172264) 
+ (-1.17,-0.16795) (-1.16,-0.159323) (-1.155,-0.155515) 
+ (-1.14,-0.145365) (-1.135,-0.141982) (-1.04,-0.0776975) 
+ (-1.035,-0.0743141) (-1.01,-0.0573972) (-1.005,-0.0557414) 
+ (-0.98,-0.0484965) (-0.975,-0.0470476) (-0.94,-0.0369047) 
+ (-0.935,-0.0354557) (-0.895,-0.0238639) (-0.89,-0.0230547) 
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
+ 3.71971e-010, 3.78221e-010, 3.84471e-010, 3.90721e-010, 3.96971e-010, 4.03221e-010,
+ 4.09471e-010, 4.15721e-010, 4.21971e-010, 4.28221e-010, 4.34471e-010, 4.40721e-010,
+ 4.46971e-010, 4.53221e-010, 4.59471e-010, 4.65721e-010, 4.71971e-010, 4.78221e-010,
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
