ska-sa/roach1_hardware/SISim/PPC_DDR2/_1I289_PPC_ECC6.sp

* Netlist for net Lsw00 - C:\Work\Roach\elec\SISim\PPC_DDR2\_1I289_PPC_ECC6.sp


* Output from HyperLynx SPICE Writer
* Created by . on Date: Monday Mar. 3,2008   Time: 8:26:58
* Created with HyperLynx version: 7.7 build: 385
* Design file: $1I289_PPC_ECC6.ffs
* Special Settings: Coupled


.SUBCKT _1I289_PPC_ECC6 Vinp Vinn 101 106 108 104 105 114 120 303 126 304 132 305 138 306 144 307 150 308 156 309
+  162 310 168 311 174 312 180 313 186 314 192 315 198 316 204 317 210 318 216 319
+  222 320 228 321 234 322 240 323 246 324 252 325 258 326 264 327 270 328 276 329
+  282 330 288 331 294 332 296 301

* Node  #  = <Reference Designator>.<pin name>
**********************************************
* Node 101 = EBD-J8_C249.1 (at pin)
* Node 106 = EBD-J8_R102.2 (at pin)
* Node 108 = EBD-J8_R102.1 (at pin)
* Node 104 = EBD-J8_U15.J9 (at pin) (receiver)
X_mdl_109 109 d_receive_109 MODEL_EBD-J8_U15_J9_ip
* Node 105 = EBD-J8_U5.J1 (at pin) (receiver)
X_mdl_111 111 d_receive_111 MODEL_EBD-J8_U5_J1_ip
* Node 114 = J10.17 (at pin)
* Node 120 = J10.32 (at pin)
* Node 303 = R32.2 (at pin)
* Node 126 = J10.31 (at pin)
* Node 304 = R31.2 (at pin)
* Node 132 = J10.30 (at pin)
* Node 305 = R30.2 (at pin)
* Node 138 = J10.29 (at pin)
* Node 306 = R29.2 (at pin)
* Node 144 = J10.28 (at pin)
* Node 307 = R28.2 (at pin)
* Node 150 = J10.27 (at pin)
* Node 308 = R27.2 (at pin)
* Node 156 = J10.26 (at pin)
* Node 309 = R26.2 (at pin)
* Node 162 = J10.25 (at pin)
* Node 310 = R25.2 (at pin)
* Node 168 = J10.24 (at pin)
* Node 311 = R24.2 (at pin)
* Node 174 = J10.23 (at pin)
* Node 312 = R23.2 (at pin)
* Node 180 = J10.22 (at pin)
* Node 313 = R22.2 (at pin)
* Node 186 = J10.21 (at pin)
* Node 314 = R21.2 (at pin)
* Node 192 = J10.20 (at pin)
* Node 315 = R20.2 (at pin)
* Node 198 = J10.19 (at pin)
* Node 316 = R19.2 (at pin)
* Node 204 = J10.18 (at pin)
* Node 317 = R18.2 (at pin)
* Node 210 = J10.16 (at pin)
* Node 318 = R16.2 (at pin)
* Node 216 = J10.15 (at pin)
* Node 319 = R15.2 (at pin)
* Node 222 = J10.14 (at pin)
* Node 320 = R14.2 (at pin)
* Node 228 = J10.13 (at pin)
* Node 321 = R13.2 (at pin)
* Node 234 = J10.12 (at pin)
* Node 322 = R12.2 (at pin)
* Node 240 = J10.11 (at pin)
* Node 323 = R11.2 (at pin)
* Node 246 = J10.10 (at pin)
* Node 324 = R10.2 (at pin)
* Node 252 = J10.9 (at pin)
* Node 325 = R9.2 (at pin)
* Node 258 = J10.8 (at pin)
* Node 326 = R8.2 (at pin)
* Node 264 = J10.7 (at pin)
* Node 327 = R7.2 (at pin)
* Node 270 = J10.6 (at pin)
* Node 328 = R6.2 (at pin)
* Node 276 = J10.5 (at pin)
* Node 329 = R5.2 (at pin)
* Node 282 = J10.4 (at pin)
* Node 330 = R4.2 (at pin)
* Node 288 = J10.3 (at pin)
* Node 331 = R3.2 (at pin)
* Node 294 = J10.2 (at pin)
* Node 332 = R2.2 (at pin)
* Node 296 = U1.AM10 (at pin) (driver)
X_mdl_297 297 Vinp MODEL_U1_AM10_ip
* Node 301 = J10.1 (at pin)

* Node   0 = Gnd (Common Return)

.connect 303 120 

.connect 319 216 

.connect 318 210 

.connect 317 204 

.connect 316 198 

.connect 315 192 

.connect 314 186 

.connect 313 180 

.connect 312 174 

.connect 311 168 

.connect 310 162 

.connect 309 156 

.connect 308 150 

.connect 307 144 

.connect 306 138 

.connect 305 132 

.connect 304 126 

.connect 332 294 

.connect 331 288 

.connect 330 282 

.connect 329 276 

.connect 328 270 

.connect 327 264 

.connect 326 258 

.connect 325 252 

.connect 324 246 

.connect 323 240 

.connect 322 234 

.connect 321 228 

.connect 320 222 


T001        101    0  106    0 Z0=5.983340e+001 TD=1.348640e-010
T002        101    0  104    0 Z0=5.000000e+001 TD=2.000000e-011
T003        101    0  105    0 Z0=5.000000e+001 TD=2.000000e-011
CP101       101    0 6.815e-014
REBD-J8_R102_2  106  108 22
TP102       104    0  109    0 Z0=1.092906e+002 TD=1.967232e-011
TP103       105    0  111    0 Z0=1.130906e+002 TD=2.148721e-011
T004        108    0  114    0 Z0=5.983340e+001 TD=2.252790e-011
R32_2       120    0 50
R31_2       126    0 50
R30_2       132    0 50
R29_2       138    0 50
R28_2       144    0 50
R27_2       150    0 50
R26_2       156    0 50
R25_2       162    0 50
R24_2       168    0 50
R23_2       174    0 50
R22_2       180    0 50
R21_2       186    0 50
R20_2       192    0 50
R19_2       198    0 50
R18_2       204    0 50
R16_2       210    0 50
R15_2       216    0 50
R14_2       222    0 50
R13_2       228    0 50
R12_2       234    0 50
R11_2       240    0 50
R10_2       246    0 50
R9_2        252    0 50
R8_2        258    0 50
R7_2        264    0 50
R6_2        270    0 50
R5_2        276    0 50
R4_2        282    0 50
R3_2        288    0 50
R2_2        294    0 50
TP195       296    0  297    0 Z0=1.013434e+002 TD=1.064105e-010
T005        296    0  299    0 Z0=4.333806e+001 TD=1.150930e-011
CV001       296    0 2.185e-014
W006       N=1  301    0  299    0 RLGCmodel=Model_W006 L=0.0972069 fgd=1e9  MULTIDEBYE=1
CV002       299    0 4.790e-013

V3  3  0  1.00
V2  2  0  1.80
V1  1  0  0.00

****  Transmission line models ***********************

*********************************
* Single uncoupled transmission line

.MODEL Model_W006 W MODELTYPE=RLGC N=1
* Lo  (H/m)
+ Lo =
+ 3.39994e-007

* Co  (F/m)
+ Co =
+ 1.30903e-010

* Ro (Ohm/m)
+ Ro =
+ 10.0819

* Go (S/m)
+ Go =
+ 0

* Rs (Ohm/m-sqrt(Hz))
+ Rs =
+ 0.00188059

* Gd (S/m-Hz)
+ Gd =
+ 1.64497e-011

****  End Transmission line models *******************

.ENDS

* IBIS model subcircuit definitions
**********************************************
*Define subcircuit for MODEL_EBD-J8_U15_J9_ip
.subckt MODEL_EBD-J8_U15_J9_ip a_signal d_receive 
VPullUpRef a_PURef 0 1.8
VPullDownRef a_PDRef 0 0

X_104 a_signal d_receive 0 a_PURef a_PDRef MODEL_EBD-J8_U15_J9

.ends MODEL_EBD-J8_U15_J9_ip

*Define subcircuit for MODEL_EBD-J8_U15_J9
.subckt MODEL_EBD-J8_U15_J9 a_signal d_receive a_gnd a_PURef a_PDRef 

C_comp a_signal a_gnd 2.811e-012

VGCRef a_GCRef 0 0
G_gnd_clamp a_signal a_GCRef table v(a_signal, a_GCRef) = 
+ (-23.4,-22.2654) (-1.8,-0.760219) (-1.795,-0.755241) 
+ (-1.79,-0.750299) (-1.785,-0.745359) (-1.78,-0.740421) 
+ (-1.775,-0.735484) (-1.77,-0.730549) (-1.765,-0.725617) 
+ (-1.755,-0.715754) (-1.735,-0.696055) (-1.73,-0.691139) 
+ (-1.695,-0.656751) (-1.69,-0.651848) (-1.63,-0.593191) 
+ (-1.625,-0.588303) (-1.62,-0.583444) (-1.615,-0.578597) 
+ (-1.55,-0.51558) (-1.545,-0.510732) (-1.54,-0.505913) 
+ (-1.53,-0.496355) (-1.525,-0.491576) (-1.45,-0.419894) 
+ (-1.445,-0.415115) (-1.44,-0.410336) (-1.435,-0.40558) 
+ (-1.415,-0.387037) (-1.41,-0.382402) (-1.32,-0.29896) 
+ (-1.315,-0.294325) (-1.3,-0.280418) (-1.295,-0.275794) 
+ (-1.27,-0.254226) (-1.265,-0.249912) (-1.175,-0.172264) 
+ (-1.17,-0.16795) (-1.16,-0.159323) (-1.155,-0.155515) 
+ (-1.14,-0.145365) (-1.135,-0.141982) (-1.04,-0.0776975) 
+ (-1.035,-0.0743141) (-1.01,-0.0573972) (-1.005,-0.0557414) 
+ (-0.98,-0.0484965) (-0.975,-0.0470476) (-0.94,-0.0369047) 
+ (-0.935,-0.0354557) (-0.895,-0.0238639) (-0.89,-0.0230547) 
+ (-0.875,-0.0215177) (-0.87,-0.0210053) (-0.825,-0.0163943) 
+ (-0.82,-0.0158819) (-0.795,-0.0133202) (-0.79,-0.0128917) 
+ (-0.78,-0.0122114) (-0.775,-0.0118712) (-0.745,-0.00983015) 
+ (-0.74,-0.00948997) (-0.7,-0.00676859) (-0.695,-0.0065163) 
+ (-0.69,-0.00628185) (-0.685,-0.0060474) (-0.65,-0.00440625) 
+ (-0.645,-0.00417181) (-0.615,-0.00276511) (-0.61,-0.00255864) 
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
+ (-0.02,-1.857e-009) (0,-1.595e-009) (7.2,9.2725e-008) 

Y_control ibis_control(icx_behavioral)
+ PORT: d_control
+       d_pullup_control
+       d_pulldown_control

.model ibis_control(icx_behavioral) MACRO LANG=VHDLAMS LIB=icxbase
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
