ska-sa/roach1_hardware/(list of files, drawings)

Other design files:
BaseProjects/IBOB1.5/IBOB_1_5.DSN
BaseProjects/IBOB1.5/Roach_1.0.pcb
roach/layout/ibob2.pcb
roach/layout/ibob2m.pcb
