ska-sa/roach1_hardware/(commit log)

2007-05-30 Transferred Roach, iBOB1.5 and Sequoia designs to ROACH svn
    [DES0211_11_SCH.csv, DES0211_11_SCH.ods, IBOB_1_5.DSN, PartsForLibrary.ods, Roach_1.0.pcb, Virtex5_XPE_9_1.xls, pads2007_oats.cfg]
2007-05-30 Pulled Sequoia schematics into Roach.
2007-05-30 Power estimate in progress
    [Virtex5_XPE_9_1.xls]
2007-06-06 Added Sequoia BOM
2007-06-06 Power Estimator Update
    [Virtex5_XPE_9_1.xls]
2007-06-06 Power estimator progress
    [Virtex5_XPE_9_1.xls]
2007-06-06 Roach schematic progress. Added power supervisor sheets from xcc project.
2007-06-07 Power estimate update.
    [Virtex5_XPE_9_1.xls]
2007-06-13 Added Samsung/ds_k7r64xx84m_rev13.pdf - used on ML561 board.
2007-06-28 Split QDR2 design into completely separate interfaces. Added Actel IO Design from XCC - not edited. Modified ADC interface to be generic, created second ADC in IO Designer.
2007-06-28 Updated ADC interface - removed old adc. Added GPIO.
2007-07-05 Updates to IO Design and Schematic
2007-07-05 Added bank sketches and summary.
    [Bank Summary.ods]
2007-07-09 QDR2+ first interface pins allocated according to MIG guidelines. Added Samtec Datasheets. Added Bank layout sketch.
    [Bank Summary.ods]
2007-07-11 Nightly check-in Added QDR2 UCF's, bank_shifter.ods spreadsheet.
    [bank_shifter.ods]
2007-07-12 QDRII+ pin allocation for both interfaces in roach.ucf. Corrected VRN/VRP pin allocation on banks 23 and 15 to allow DCI cascade.
    [bank_shifter.ods]
2007-07-27 Started to clean up schematics. SKA symbols copied into project directory.
2007-08-14 Created layout/library and added pcblib.**07. Added Samtec/QSH-040-01-X-D-DP-A.ZIP - downloaded Samtec footprint for QSH connector.
2007-08-24 Added "TBD" notes to transceiver schematic.
2007-08-28 PDF schematics generated for initial checking.
2007-08-29 modified pcblib.pd07 modified pcblib.pt07 added 0805.d added 1210.d added CAPC1005X55N.d added CAPC2012X125N.d added CAPC2012X130L.d added CAPC2012X135N.d added CAPC3225X270N.d added INDC1608X95N.d a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
2007-08-30 modified pcblib.pd07
2007-08-30 modified elec/roach/layout/library/pcblib.pd07 modified elec/roach/layout/library/pcblib.pt07 added datasheets/Agilent added datasheets/Agilent/0pg2r1jqx87hh6h16tlgq6cqi7py.pdf added datasheets/Maxim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
2007-08-30 modified elec/roach/layout/library/pcblib.pd07 modified elec/roach/layout/library/pcblib.pt07 modified elec/roach/wir/roach_adc_0.1 modified elec/roach/wir/roach_adc_1.1 modified elec/roach/wir/roach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
2007-09-03 Added some missing files
    [roach_pcb.cfg]
2007-09-06 modified elec/roach/pcb.err modified elec/roach/roach.dproj modified elec/roach/roach.roach_top_PADS2007.roach_top.db modified elec/roach/roach_top.asc modified elec/roach/roach_top.p modified elec/r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
2007-09-06 modified elec/roach/layout/library/pcblib.pd07
2007-09-10 modified layout/library/pcblib.pd07 modified viewdraw.ini modified wir/roach_power_sup.1 modified wir/roach_ppc_cpld.1 modified wir/roach_top.1
2007-09-10 modified elec/roach/layout/library/pcblib.pd07 modified elec/roach/sch/roach_ddr2_dimm.1
2007-09-10 modified elec/roach/layout/library/pcblib.pd07 added datasheets/TI added datasheets/TI/tps74401.pdf
2007-09-11 modified elec/roach/layout/library/pcblib.pd07 added datasheets/Linear added datasheets/Linear/downloadDocument.pdf added datasheets/TI/tps51100.pdf added datasheets/Vishay/72600.pdf
2007-09-11 modified library/pcblib.pd07
2007-09-12 modified elec/roach/layout/library/pcblib.pd07 modified elec/roach/layout/library/pcblib.pt07 modified elec/roach/pcb.err modified elec/roach/roach.dproj modified elec/roach/roach.roach_top_PADS2007.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
2007-09-12 modified elec/roach/layout/library/pcblib.pd07 modified elec/roach/viewdraw.ini added datasheets/TI/ptn04050c.pdf added datasheets/Tyco/AXH016A0X3.pdf
2007-09-13 modified elec/roach/layout/library/pcblib.pd07 modified elec/roach/sch/bac/roach_top.1 modified elec/roach/sch/roach_5v_power.1 modified elec/roach/sch/roach_top.1 modified elec/roach/sch/roach_top.O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
2007-09-17 modified elec/roach/layout/library/pcblib.pd07 added datasheets/FAIRCHILD added datasheets/FAIRCHILD/NC%2FNC7SB3157.pdf added datasheets/Microchip added datasheets/Microchip/21936b.pdf added datashee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
2007-09-17 modified elec/roach/eco.err modified elec/roach/ECOGEN.ERR modified elec/roach/layout/library/pcblib.pd07 modified elec/roach/pcb.err modified elec/roach/roach.dproj modified elec/roach/roach.roach_t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
2007-09-18 modified dvf/5VSX95T.dvf added dvf/HOLE150X288.dvf modified dvf/IC_AND_SC70_SINGLE_74LVC1G08.dvf modified dvf/IC_CLKGEN_SOIC8_0211P21.dvf modified dvf/IC_RS232_SSOP20_3225_E3-5V.dvf modified dvf/IC_T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
2007-09-19 added ibob2.pcb
    [ibob2.pcb]
2007-09-24 modified ibob2.pcb modified library/pcblib.pd07
    [ibob2.pcb]
2007-09-24 modified ibob2.pcb
    [ibob2.pcb]
2007-09-27 modified elec/roach/layout/ibob2.pcb modified elec/roach/layout/library/pcblib.pd07
    [ibob2.pcb]
2007-09-27 modified elec/roach/layout/ibob2.pcb modified elec/roach/sch/bac/roach_ppc_pci.1 modified elec/roach/sch/bac/roach_ppc_power_2.1 modified elec/roach/sch/bac/roach_ppc_usb.1 modified elec/roach/sch/ba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
    [ibob2.pcb]
2007-10-01 Basic Schematics Complete - Clean-up and checking
2007-10-01 modified elec/roach/eco.err modified elec/roach/ECOGEN.ERR modified elec/roach/layout/ibob2.pcb modified elec/roach/layout/library/pcblib.pd07 modified elec/roach/layout/library/pcblib.pt07 modified 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
    [ibob2.pcb]
2007-10-02 Top sheet hierarchical page no's incorrect
    [roach_pcb.cfg]
2007-10-02 modified elec/roach/eco.err modified elec/roach/ECOGEN.ERR modified elec/roach/layout/ibob2.pcb modified elec/roach/layout/library/pcblib.pd07 modified elec/roach/pcb.err modified elec/roach/roach.ro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
    [ibob2.pcb]
2007-10-02 -Conservative worst-case power estimate.
    [Virtex5_XPE_9_2.xls]
2007-10-02 modified elec/roach/eco.err modified elec/roach/ECOGEN.ERR modified elec/roach/layout/ibob2.pcb modified elec/roach/roach.roach_top_PADS2007.roach_top.db modified elec/roach/roach_top.asc modified el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
    [ibob2.pcb]
2007-10-02 modified elec/roach/layout/ibob2.pcb modified elec/roach/viewdraw.ini
    [ibob2.pcb]
2007-10-04 modified elec/roach/eco.err modified elec/roach/ECOGEN.ERR modified elec/roach/layout/ibob2.pcb modified elec/roach/layout/library/pcblib.pd07 modified elec/roach/pcb.err modified elec/roach/roach.ro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
    [ibob2.pcb]
2007-10-04 modified elec/roach/layout/ibob2.pcb modified elec/roach/sch/bac/roach_top.1 modified elec/roach/sch/roach_top.1 modified elec/roach/wir/roach_ppc_tst_clk_io.1 modified elec/roach/wir/roach_top.1 add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
    [ibob2.pcb]
2007-10-08 modified elec/roach/layout/ibob2.pcb
    [ibob2.pcb]
2007-10-09 modified ibob2.pcb modified ibob2m.pcb
    [ibob2.pcb, ibob2m.pcb]
2007-10-18 modified elec/roach/eco.err modified elec/roach/ECOGEN.ERR modified elec/roach/layout/ibob2.pcb modified elec/roach/layout/library/pcblib.pd07 modified elec/roach/pcb.err modified elec/roach/roach.ro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
2007-10-22 modified elec/roach/eco.err modified elec/roach/ECOGEN.ERR modified elec/roach/layout/ibob2.pcb modified elec/roach/pcb.err modified elec/roach/roach.roach_top_PADS2007.roach_top.db modified elec/roa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
2007-10-25 modified elec/roach/eco.err modified elec/roach/ECOGEN.ERR modified elec/roach/layout/ibob2.pcb modified elec/roach/layout/library/pcblib.pd07 modified elec/roach/pcb.err modified elec/roach/roach.ro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
2007-10-30 modified elec/roach/sch/bac/roach_gpio_misc.1 modified elec/roach/sch/bac/roach_transceivers0_1.1 modified elec/roach/sch/bac/roach_transceivers2_3.1 modified elec/roach/sch/roach_gpio_misc.1 modifie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
2007-10-30 modified elec/roach/eco.err modified elec/roach/ECOGEN.ERR modified elec/roach/layout/ibob2.pcb modified elec/roach/pcb.err modified elec/roach/roach.roach_top_PADS2007.roach_top.db modified elec/roa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
2007-10-31 Replaced chassis_gnd with gnd
2007-11-01 Added Schematics (roach/sch/roach_transceivers0_1.1 and roach/sch/roach_transceivers2_3.1) from Mike, following server problem
2007-11-01 modified elec/roach/eco.err modified elec/roach/ECOGEN.ERR modified elec/roach/layout/ibob2.pcb modified elec/roach/pcb.err modified elec/roach/roach.roach_top_PADS2007.roach_top.db modified elec/roa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
2007-11-02 Changed Sense Resistors to correct rating, value, footprint. Added table with current sensing information.
    [roach_board_power_estimate.ods]
2007-11-06 modified elec/roach/eco.err modified elec/roach/ECOGEN.ERR modified elec/roach/layout/ibob2.pcb modified elec/roach/layout/library/pcblib.pd07 modified elec/roach/layout/library/pcblib.pt07 modified 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
2007-11-08 modified elec/roach/eco.err modified elec/roach/ECOGEN.ERR modified elec/roach/layout/ibob2.pcb modified elec/roach/roach.roach_top_PADS2007.roach_top.db modified elec/roach/roach_top.asc modified el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
2007-11-09 modified elec/roach/eco.err modified elec/roach/ECOGEN.ERR modified elec/roach/layout/ibob2.pcb modified elec/roach/roach.roach_top_PADS2007.roach_top.db modified elec/roach/roach_top.asc modified el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
2007-11-14 A few layout changes. DxDesigner can't keep its hands off the schematic files. Nothing in them was changed except a date field. modified elec/roach/eco.err modified elec/roach/ECOGEN.ERR modified ele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
2007-11-15 Removed 500ps loops in PPC DDR2. Removed parallel resistor pull-ups on CPU_HALT# line. Removed 0R resistors on J1.
2007-11-16 modified elec/roach/eco.err modified elec/roach/ECOGEN.ERR modified elec/roach/layout/ibob2.pcb modified elec/roach/pcb.err modified elec/roach/roach.roach_top_PADS2007.roach_top.db modified elec/roa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
2007-11-27 modified elec/roach/eco.err modified elec/roach/ECOGEN.ERR modified elec/roach/layout/ibob2.pcb modified elec/roach/roach.roach_top_PADS2007.roach_top.db modified elec/roach/roach_top.eco modified el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
2007-11-28 modified elec/roach/eco.err modified elec/roach/ECOGEN.ERR modified elec/roach/layout/ibob2.pcb modified elec/roach/layout/library/pcblib.pd07 modified elec/roach/roach.roach_top_PADS2007.roach_top.d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
    [ibob2.pcb]
2007-11-29 Added hyperlynx boardsim ibob2.hyp, some more simulation models.
2007-12-10 modified elec/roach/dvf/5VSX95T.dvf modified elec/roach/dvf/C.dvf modified elec/roach/dvf/CAP0805_135.dvf modified elec/roach/dvf/CAP_POL.dvf modified elec/roach/dvf/CHIPCAP0402X0_5.dvf modified elec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
    [ibob2.pcb]
2007-12-11 DDR2 symbol and schematic updated Database broken - to be fixed with other symbol updates
2007-12-13 Layout bank updates complete in schematic
2007-12-13 Bank swap complete to PCB
    [ibob2.pcb]
2007-12-13 modified elec/roach/layout/ibob2.pcb modified elec/roach/sch/bac/roach_top.1 modified elec/roach/sch/roach_top.1 modified elec/roach/wir/roach_adc_0.1 modified elec/roach/wir/roach_adc_1.1 modified e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
2007-12-17 Got to re-enter design rules after pads lost them.modified elec/roach/eco.err modified elec/roach/ECOGEN.ERR modified elec/roach/layout/ibob2.pcb modified elec/roach/pcb.err modified elec/roach/roach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
2007-12-21 modified elec/roach/layout/ibob2.eco modified elec/roach/layout/ibob2.pcb
2007-12-27 trying to escape fpga. modified elec/roach/layout/ibob2.pcb
2007-12-31 The wires have escaped the FPGA! modified elec/roach/layout/ibob2.pcb modified elec/roach/layout/library/pcblib.pd07 modified elec/roach/layout/library/pcblib.pt07
2008-01-09 I want to take Pads and feed it into a really really hot oven. modified elec/roach/layout/ibob2.pcb
2008-01-18 modified elec/roach/layout/ibob2.pcb modified elec/roach/layout/library/pcblib.pd07 modified elec/roach/layout/library/pcblib.pt07
2008-01-18 New autorouteing licenses.modified elec/roach/eco.err modified elec/roach/ECOGEN.ERR modified elec/roach/layout/ibob2.pcb modified elec/roach/roach.roach_top_PADS2007.roach_top.db modified elec/roach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
2008-01-19 modified elec/roach/layout/ibob2.pcb modified elec/roach/layout/ibob2_work.pcb added elec/roach/layout/ibob2_work1.pcb
2008-01-20 modified elec/roach/layout/ibob2.pcb modified elec/roach/layout/ibob2_work1.pcb added elec/roach/layout/ibob2_work2.pcb added elec/roach/layout/ibob2_work3.pcb
2008-01-21 ibob2_ar.pcb full routing attempt. Finished with unroutes.
2008-01-22 modified sch/bac/roach_top.1 modified sch/roach_top.1 added sym/heatsinkhole.1
2008-01-23 modified elec/roach/eco.err modified elec/roach/ECOGEN.ERR modified elec/roach/layout/ibob2.pcb modified elec/roach/layout/ibob2_ar.pcb modified elec/roach/pcb.err modified elec/roach/roach.dproj mod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
2008-01-23 modified eco.err modified ECOGEN.ERR modified layout/ibob2.pcb modified pcb.err modified roach.dproj modified roach.roach_top_PADS2007.roach_top.db modified roach_top.asc modified roach_top.eco modif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
2008-01-25 finished without crashing. modified ibob2_work.pcb
2008-01-25 modified elec/roach/eco.err modified elec/roach/ECOGEN.ERR modified elec/roach/layout/ibob2.eco modified elec/roach/layout/ibob2.pcb modified elec/roach/layout/ibob2_work1.pcb modified elec/roach/pad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
2008-01-26 100% routed! Many differential nets are still not consistent with constraints. modified elec/roach/eco.err modified elec/roach/ECOGEN.ERR modified elec/roach/layout/ibob2.pcb modified elec/roach/layo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
2008-01-29 Some attribute clean up and pin swaps. modified eco.err modified ECOGEN.ERR modified layout/ibob2.pcb modified layout/library/pcblib.pd07 modified layout/library/pcblib.pt07 modified pads2007.cns mod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
2008-01-30 modified elec/roach/eco.err modified elec/roach/ECOGEN.ERR modified elec/roach/layout/ibob2.pcb modified elec/roach/pads2007.cns modified elec/roach/roach.roach_top_PADS2007.roach_top.db modified ele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
2008-01-31 Fully routed with all the squiggles. modified elec/roach/eco.err modified elec/roach/ECOGEN.ERR modified elec/roach/layout/ibob2.pcb modified elec/roach/layout/ibob2_work1.pcb modified elec/roach/roa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
2008-01-31 modified ibob2_work2.pcb
2008-01-31 modified ibob2.pcb modified ibob2_work2.pcb
2008-02-02 modified ibob2_work4.pcb
2008-02-05 Added Meerkat Logo symbol and decal to ibob2_work4.pcb. Translated ibob2_work4.pcb to ibob2_work4.hyp.
2008-02-05 modified elec/roach/eco.err modified elec/roach/ECOGEN.ERR modified elec/roach/layout/ibob2.pcb modified elec/roach/layout/ibob2_work1.pcb modified elec/roach/pcb.err modified elec/roach/roach.roach_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
2008-02-07 modified elec/roach/eco.err modified elec/roach/ECOGEN.ERR modified elec/roach/layout/ibob2.pcb modified elec/roach/layout/ibob2_work2.pcb modified elec/roach/pcb.err modified elec/roach/roach.roach_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
2008-02-11 modified elec/roach/layout/CAM/art001.pho modified elec/roach/layout/CAM/art001.rep modified elec/roach/layout/CAM/art007.pho modified elec/roach/layout/CAM/art009.pho modified elec/roach/layout/CAM/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
    [drl001.drl]
2008-02-12 modified elec/roach/eco.err modified elec/roach/ECOGEN.ERR modified elec/roach/layout/CAM/art001.pho modified elec/roach/layout/CAM/art001.rep modified elec/roach/layout/CAM/sm001021.pho modified ele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
2008-02-13 version sent for quotes. modified elec/roach/eco.err modified elec/roach/ECOGEN.ERR modified elec/roach/layout/CAM/art001.pho modified elec/roach/layout/CAM/art001.rep modified elec/roach/layout/CAM/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
    [drl001.drl]
2008-02-14 modified elec/roach/eco.err modified elec/roach/ECOGEN.ERR modified elec/roach/layout/ibob2.pcb modified elec/roach/layout/ibob2_work3.pcb modified elec/roach/layout/ibob2m.pcb modified elec/roach/pa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
2008-02-14 NEW STACKUP. modified elec/roach/layout/CAM/art001.pho modified elec/roach/layout/CAM/art001.rep modified elec/roach/layout/CAM/art002.pho modified elec/roach/layout/CAM/art002.rep modified elec/roac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
    [drl001.drl]
2008-02-16 modified ibob2m.pcb
2008-02-18 Changed MMC/SD connector to proconn_sdsr13.1
2008-02-18 modified elec/roach/eco.err modified elec/roach/ECOGEN.ERR modified elec/roach/layout/CAM/art001.pho modified elec/roach/layout/CAM/art001.rep modified elec/roach/layout/CAM/art002.pho modified elec/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
    [drl001.drl]
2008-02-20 FPGA DDR simulations added
    [$1I6DDR2_A0_FBDIMM.csv, $1I6DDR2_A0_UDIMM.csv, $1I6DDR2_CKE_0.csv, $1I6DDR2_CKE_1.csv, $1I6DDR2_CK_0.csv, $1I6DDR2_CK_1.csv, $1I6DDR2_CK_2.csv, $1I6DDR2_DQ0_DDR2FPGA.csv]
2008-02-20 FPGA DDR Simms done for now
    [$1I6DDR2_A0_UDIMM133.csv, $1I6DDR2_A15_FBDIMM.csv, $1I6DDR2_A7_FBDIMM.csv, $1I6DDR2_BA2_FBDIMM.csv, $1I6DDR2_CAS_N_FBDIMM.csv, $1I6DDR2_CK_0_FBDIMM.csv, $1I6DDR2_CS_N_0_FBDIMM.csv, $1I6DDR2_DM5_FBDIMM_DDR2FPGA.csv]
2008-02-20 modified elec/roach/layout/CAM/art001.pho modified elec/roach/layout/CAM/art001.rep modified elec/roach/layout/CAM/art002.pho modified elec/roach/layout/CAM/art002.rep modified elec/roach/layout/CAM/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
    [drl001.drl]
2008-02-20 Added All layer plot to ibob2_work3.pcb
2008-02-21 Corrected ATX power supply connector
2008-02-21 board physical problems fixed. modified elec/roach/eco.err modified elec/roach/ECOGEN.ERR modified elec/roach/layout/CAM/art001.pho modified elec/roach/layout/CAM/art001.rep modified elec/roach/layou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
    [drl001.drl]
2008-02-25 modified elec/roach/layout/ibob2_work3.pcb
2008-02-27 modified ibob2_work1.pcb
2008-02-28 Added GC Preview file for Gerber Checking
2008-02-28 Gerber check updated
2008-02-28 modified elec/roach/layout/CAM/art006.pho modified elec/roach/layout/CAM/art006.rep modified elec/roach/layout/CAM/art015.pho modified elec/roach/layout/CAM/art015.rep modified elec/roach/layout/ibob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
2008-03-03 modified elec/roach/eco.err modified elec/roach/ECOGEN.ERR modified elec/roach/layout/CAM/art001.pho modified elec/roach/layout/CAM/art001.rep deleted elec/roach/layout/CAM/art002.pho deleted elec/ro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
    [drl001.drl]
2008-03-05 Updated board_power_estimate.ods to add loading figures for ATX supply
    [roach_board_power_estimate.ods]
2008-03-05 Changed Cape Town to two words on silkscreen
2008-03-05 modified elec/roach/eco.err modified elec/roach/ECOGEN.ERR modified elec/roach/layout/CAM/art001.pho modified elec/roach/layout/CAM/art001.rep modified elec/roach/layout/CAM/art003.pho modified elec/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
    [drl001.drl]
2008-03-11 Added drill drawing
2008-03-11 Added new drill file with dimensions to zip
2008-03-11 Added drill/fab drawing to README filmset list.
2008-03-13 Geometry attributes added
    [roach_top.csv, roach_top.ods]
2008-03-14 All geometry attributes added, converted to mm Pre-PCB update
2008-03-17 Updated PCB config file to pass manufacturer and p/d_num attributes for report generation.
    [roach_pcb.cfg]
2008-03-18 Added SOIC127P600X173-16N to footprint library.
2008-03-18 modified elec/roach/layout/CAM/art001.pho modified elec/roach/layout/CAM/art001.rep modified elec/roach/layout/CAM/art003.pho modified elec/roach/layout/CAM/art003.rep modified elec/roach/layout/CAM/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
    [drl001.drl]
2008-03-19 Changed U24 to SOIC
    [drl001.drl]
2008-03-19 Updated with latest gerbers.
2008-03-20 Layout, schematic and symbol directory clean-up
    [default.pcb, ibob2-Si.CSV, ibob2-Si.SDF, ibob2-Si.XLS]
2008-03-20 Updated part number - clearance errors present on PCB
2008-05-08 Roach 1.01 PCB created, editing on footprints in progress
2008-05-13 cleaned up some routing. modified roach101.pcb
2008-05-13 modified roach101.pcb CLEANUP AROUND U31
2008-05-14 sorted out a couple problems with illegal characters in component fields, heatsink holes and led footprint. cleaned up routes on leds and mirrored connectors.
2008-05-17 Moved J15 & related components 7mm north. Updated version/date text. modified elec/roach/layout/roach101.pcb
2008-05-18 Finished last few routes. modified roach101.pcb
2008-05-23 added ibob-roach iadc mapping
    [ibob_roach_iadc_mapping.csv]
2008-05-25 modified roach101.pcb
2008-05-26 Data sheets, wire files
2008-05-27 Work on PCB DRC
2008-05-27 modified roach101.pcb more fun with DRC.
2008-05-28 Added board fiducial. Remembered to add symbol to repository.
2008-05-29 Fixed last clearance error prior to schematic edits
2008-05-29 Added notes re changed pin functions on FPGA
2008-05-30 Removed Mode jumper switch
2008-06-03 Updated Schematics Symbols from IO Designer. Checked PCB update - appears OK, but not saved.
2008-06-04 Added review directory
    [ROACH+V1.0.ods]
2008-06-04 Updated cross references and re-generated PDF schematics
2008-06-05 Corrected LED orientation on CR5,6. Updated PCB.
2008-06-05 Should have good gerbers.
    [drl001.drl]
2008-06-10 Fixed PPC DDR BA pin order
2008-06-10 Updated PDF Schematic
2008-06-10 generated gerbers.
    [drl001.drl]
2008-06-10 Updated footprint, regenerated gerbers agian.
2008-06-11 Another gerber regen. There's no such thing as a trivial change. Layout will always find something to change unexpectedly.
2008-06-18 Added PQFN50P602X602X100-41N footprint for CDCU877
2008-06-19 PPC DDR clock buffer added to layout.
    [drl001.drl]
2008-06-20 Updated Xref, PDF schematic.
2008-06-21 Clock buffer traces with timing allowances.
    [drl001.drl]
2008-07-01 Henry notes incorporated, excluding cx4 coupling capacitors - Mantis #0000115. Gerbers updated.
    [drl001.drl]
2008-07-03 Ethernet changes + rule additions for length matching MAC-PHY interface
    [drl001.drl]
2008-07-03 Added some notes on top silkscreen
2008-07-04 Changed PHY to default to 3COM mode, updated PCB and Gerbers
    [drl001.drl]
2008-07-07 Fixed length matching, differential routing - roach101.pcb deleted and re-added to correct problem in svn.
2008-07-07 Gerbers and PDF schematics re-generated, ZIP file updated.
    [drl001.drl]
2008-07-07 Wir files and some data sheets
2008-07-08 Schematics, PDF's PCB All checks done. Gerbers due.
2008-07-08 Roach 101 Gerbers Generated - Release Candidate.
    [drl001.drl]
2008-07-09 Cosmetic updates & vias covered. Gerbers not updated pending conference call.
2008-07-09 Issues 123 and 124 resolved - pre-gerber update
2008-07-09 ROACH 1.0.1
    [drl001.drl]
2008-07-10 Updated Partslist
    [roach101-partslist-2008-07-10.xls, roach_top.csv]
2008-07-17 Updated and added X-Y (pick and place) files. Schematics and PCB touched, but only documentation changes.
    [ROACH101_ManFile.csv, ROACH101_ManFile.xls]
2008-09-02 Updated parts list for build 01 (2)
    [roach101-partslist-build2.xls]
2008-09-02 Renamed parts list to 01 (same as build number)
    [roach101-partslist-build01.xls]
2008-09-15 added iadc_pinout.pdf
    [ibob_roach_iadc_mapping.csv]
2008-09-16 Created roach102.pcb
2008-10-06 Added ATX keepouts for holes B and S - Mantis issue #150 Added library part for U58 - Partial Mantis issue 148
2008-10-09 Updated Fan protection - addresses Mantis issue #144
2008-10-10 Addresses Mantis issues #152, #153, #154, #155, #156. Components updated, but not all PCB corrections completed.
2008-11-06 Updated USB connector part #
2008-11-10 routing wip
    [roach_top.csv]
2008-11-11 ROACH 1.0.2 for checking
    [drl001.drl]
2008-11-18 Updates done - cam files generated, ipc netlist due
    [drl001.drl]
2008-11-24 ROACH 1.0.2 Dave and Henry comments and checks incorporated.
    Passes all DRC's.
    Check on P6 thermal connections due.
    [drl001.drl]
2008-11-24 - Changed solder mask spec to black.
2008-11-25 Release Candidate
    [drl001.drl]
2008-11-28 Released ROACH 1.0.2
    [roach102-partslist-2008-11-27.xls, roach_top.csv]
2009-01-01 Corrected two dangling traces in layout, adjusted remaining trace lengths.
    [drl001.drl]
2009-02-05 Database update only
    [roach_top.csv]
2009-02-05 Added missing files
    [roach102-partslist-2008-11-10.xls, roach102-partslist-2009-02-04.xls]
2009-08-28 ROACH 1.0.3 for checking
    [drl001.drl]
2009-08-31 Roach 1.0.3 Release for review
    [roach103-partslist-2009-08-31.xls, roach_top.csv, roach_top.ods]
2009-12-21 Zip file updated with new silkscreen and readme
